geek95dg/Alfa156-headunit/mockups/renders/init_heritage.png

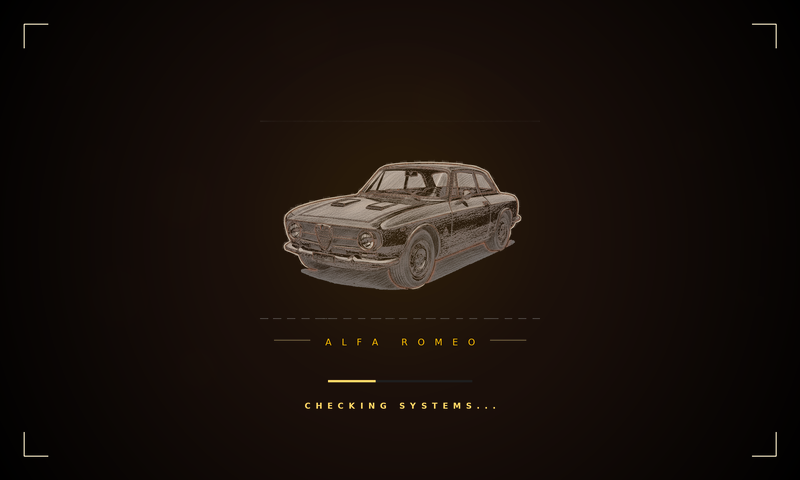
mockups/renders/init_heritage.png
