geek95dg/Alfa156-headunit/mockups/screen.png

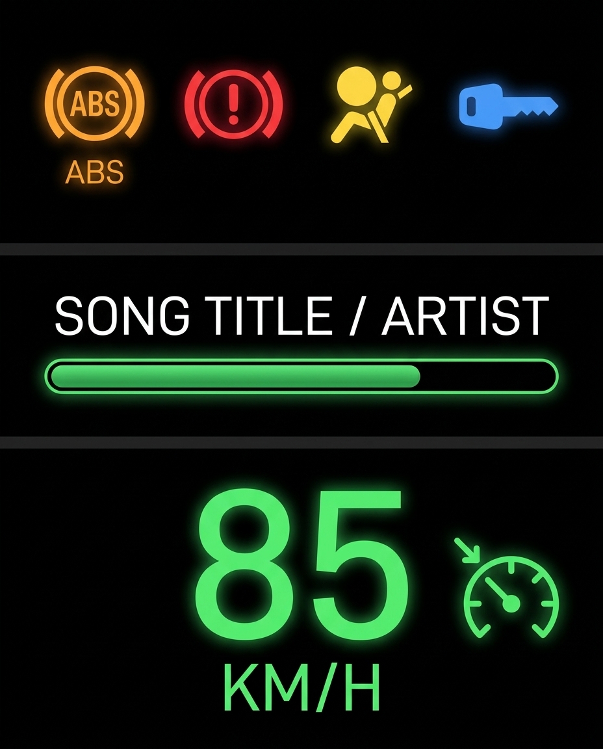
mockups/screen.png
