geek95dg/Alfa156-headunit/docs/WDROZENIE_M910Q.md

# Wdrożenie BCM v8.5 na Lenovo ThinkCentre M910q

Skonsolidowana instrukcja wdrożeniowa head unitu do Alfa Romeo 156 1.9 JTD 8V
na **platformie produkcyjnej x86 — Lenovo ThinkCentre M910q Tiny**.

Dokument opisuje **faktyczny stan repozytorium** — każda komenda, ścieżka
i nazwa pliku odnosi się do tego, co jest w drzewie. Miejsca, w których
dokumentacja źródłowa jest niespójna albo kod odbiega od opisu, są
oznaczone jako ⚠.

**Zasilanie buforowane** (bufor CSB HR1221W, ładowanie, blokada przeładowania,
step-up 19 V) ma osobny dokument: **[`ZASILANIE_BUFOROWANE.md`](ZASILANIE_BUFOROWANE.md)**.

---

## Spis treści

1. [Zakres i warunki wstępne](#1-zakres-i-warunki-wstępne)
2. [Sprzęt](#2-sprzęt)
3. [Zasilanie — streszczenie](#3-zasilanie--streszczenie)
4. [BIOS](#4-bios)
5. [System operacyjny](#5-system-operacyjny)
6. [Instalacja BCM](#6-instalacja-bcm)
7. [Usługi systemd](#7-usługi-systemd)
8. [Boot, splash, kiosk](#8-boot-splash-kiosk)
9. [Suspend i wybudzanie](#9-suspend-i-wybudzanie)
10. [Wyświetlacze i dotyk](#10-wyświetlacze-i-dotyk)
11. [Arduino — trzy płytki](#11-arduino--trzy-płytki)
12. [K-Line / OBD](#12-k-line--obd)
13. [WiFi i Android Auto](#13-wifi-i-android-auto)
14. [Audio](#14-audio)
15. [Konfiguracja modułów](#15-konfiguracja-modułów)
16. [Odbiór techniczny](#16-odbiór-techniczny)
17. [Diagnostyka](#17-diagnostyka)
18. [Reset i ponowna instalacja](#18-reset-i-ponowna-instalacja)
19. [Znane rozbieżności](#19-znane-rozbieżności)
20. [Wyświetlacz pomocniczy 1,8" na ESP32](#20-wyświetlacz-pomocniczy-18-na-esp32)

---

## 1. Zakres i warunki wstępne

### Co ten dokument obejmuje

Pełną ścieżkę od pustego M910q do działającego head unitu w aucie:
sprzęt → zasilanie → BIOS → OS → BCM → usługi → kiosk → peryferia → odbiór.

### Czego nie obejmuje

| Temat | Gdzie szukać |
|---|---|
| Symulacja na laptopie (bez sprzętu) | [`URUCHOMIENIE.md`](URUCHOMIENIE.md) § 1 |
| **Wariant testowo-rozwojowy** (AA + dźwięk + SWC, reszta wyłączona) | [`WDROZENIE_TESTOWE.md`](WDROZENIE_TESTOWE.md) |
| Szczegóły zasilania buforowanego | [`ZASILANIE_BUFOROWANE.md`](ZASILANIE_BUFOROWANE.md) |
| Tabele połączeń, przekroje, kolejność montażu | [`SCHEMATY_POLACZEN.md`](SCHEMATY_POLACZEN.md) |
| Rozmieszczenie podzespołów w aucie | [`../schematics/vehicle_layout_m910q.svg`](../schematics/vehicle_layout_m910q.svg) |
| Pierwsze wgranie firmware na Arduino (od zera) | [`ARDUINO_OD_ZERA.md`](ARDUINO_OD_ZERA.md) |
| Okablowanie Arduino pin-po-pinie | [`ARDUINO_SETUP_GUIDE.md`](ARDUINO_SETUP_GUIDE.md) |
| Podsłuch K-Line, poznawanie PID-ów | [`KLINE_SNIFFING.md`](KLINE_SNIFFING.md) |
| Wersja ilustrowana (12 rozdziałów HTML) | [`x86-production/index.html`](x86-production/index.html) |
| Referencja krok-po-kroku (EN) | [`X86_PLATFORM_SETUP.md`](X86_PLATFORM_SETUP.md) |
| Platformy Orange Pi / VM | [`../Archive/README.md`](../Archive/README.md) |

### Warunki wstępne

- M910q sprawny, z dyskiem NVMe i pamięcią
- Pendrive ≥ 2 GB na obraz instalacyjny Debiana
- Klawiatura i monitor na czas instalacji (potem niepotrzebne)
- Dostęp do sieci (pobieranie pakietów)
- Podstawowe narzędzia elektryczne: multimetr, zaciskarka, lutownica

### Kolejność prac

Zalecana kolejność to **najpierw komplet software'u na biurku**, dopiero
potem zabudowa w aucie. Diagnostyka układu, który leży na stole, jest
nieporównanie łatwiejsza niż tego samego układu wciśniętego za deskę
rozdzielczą.

```
1. Sprzęt + BIOS + OS + BCM na biurku              (§2, §4–§7)
2. Wyświetlacze, dotyk, kiosk, splash              (§8, §10)
3. Arduino + K-Line + audio na stole               (§11, §12, §14)
4. Testy zasilania buforowanego na stole           (ZASILANIE_BUFOROWANE.md §11)
5. Zabudowa w aucie                                (ZASILANIE_BUFOROWANE.md §11 etap 3+)
6. Odbiór techniczny                               (§16)
```

---

## 2. Sprzęt

### 2.1 Lenovo ThinkCentre M910q Tiny

| Element | Specyfikacja |
|---|---|
| CPU | Intel i5-6400T (4C/4T, 2,2–2,8 GHz, Skylake) |
| GPU | Intel HD 530 — sprzętowe dekodowanie VAAPI |
| RAM | 8 GB DDR4 2400 |
| Dysk | 256 GB NVMe SSD |
| WiFi/BT | **MediaTek MT7921** (M.2 Key E) — wymiana za fabryczny Intel 8265 |
| Wyjścia obrazu | **2× DisplayPort** |
| USB | 6× USB 3.0 + 1× USB-C |
| Zasilanie | 65 W, 20 V, gniazdo firmowe Lenovo |
| Obudowa | 1 litr — mieści się za deską rozdzielczą |

**Wymiana karty WiFi jest obowiązkowa.** Fabryczny Intel 8265 nie daje
stabilnego P2P-GO na 5 GHz i cierpi na resety tx-timeout przy Bluetooth.
MT7921 (PCIe `[14c3:7961]` + BT po USB `[0489:e0cd]`) obsługuje P2P-GO na
kanale 149, 80 MHz VHT, 30 dBm oraz A2DP i HFP bez problemów. Wymaga pakietu
`firmware-mediatek` z sekcji non-free-firmware.

**Orientacja montażu:** poziomo, logo do góry. Pionowo działa, ale nieco
gorzej chłodzi. M910q ma otwory VESA 100 na spodzie — najprościej zrobić
wspornik. Wszystkie kable spinaj opaskami, bo na dziurach będzie grzechotać.

### 2.2 Lista sprzętu — etap 1 (rdzeń)

| # | Element | Model / spec | Szt. | Cena (PLN) |
|---|---|---|---|---|
| 1 | Mini-PC | Lenovo M910q Tiny (i5-6400T, 8 GB, 256 GB) — używany | 1 | 200–400 |
| 2 | Karta WiFi + BT | Fenvi FU-AX1800 (MT7921, WiFi 6 + BT 5.2) | 1 | 120–180 |
| 3 | Przetwornica step-up | **XL6019** 12 V → 19,5 V — posiadana, ok. 45 W, patrz `ZASILANIE_BUFOROWANE.md` §3 | 1 | 15–30 |
| 4 | Wyświetlacz główny | **10,1" IPS 1280×800** + dotyk USB | 1 | 300–500 |
| 5 | Wyświetlacz drugi *(opcjonalny)* | **6,86" widescreen 1280×480**, bez dotyku | 0–1 | 150–300 |
| 6 | Przejściówki DP → HDMI | pasywne, kablowe | 2 | 20–30 |
| 7 | DAC USB | ES9038Q2M, wyjście RCA | 1 | 45–75 |
| 8 | Wzmacniacz | **gotowy 4-kanałowy samochodowy**, wejścia RCA, klasa D, 4 × 50–75 W RMS | 1 | 250–600 |
| 9 | Kabel zasilający wzmacniacza | 6 mm² + oprawka bezpiecznika przy klemie | kpl. | 40–80 |
| 10 | Interfejs K-Line | CP2102 (USB-UART) + L9637D + rezystor 510 Ω | 1 | 25–40 |
| 11 | Hub USB | 7-portowy USB 3.0 **z własnym zasilaniem** | 1 | 40–60 |
| 12 | Kable | 2× DP-HDMI, USB-A, zasilanie, RCA | — | 50–80 |

Etapy 2–4 (kamery, czujniki, wejścia, subwoofer, czujnik deszczu) są
w [`x86-production/01-bom.html`](x86-production/01-bom.html).

**Zasilanie buforowane ma osobną listę zakupową** —
[`ZASILANIE_BUFOROWANE.md`](ZASILANIE_BUFOROWANE.md) §10.

### 2.3 Rozmieszczenie USB

Dwa urządzenia idą **bezpośrednio w port M910q**, reszta przez hub:

```
Porty USB M910q
  ├── Hub USB (zasilany, 7 portów)
  │     ├── Arduino Pro Micro   (wejścia: SWC, przyciski, enkoder)
  │     ├── Arduino Nano #1     (wyjścia: przekaźniki, PWM podświetlenia)
  │     ├── Arduino Nano #2     (sensor hub: drzwi, zapłon, deszcz, DS18B20)
  │     ├── CP2102              (K-Line / OBD)
  │     ├── GPS NEO-M8N
  │     ├── Modem LTE Huawei E3372
  │     └── Mikrofon USB
  ├── DAC USB (ES9038Q2M)       ← bezpośrednio, nie przez hub
  └── Graber AHD 4-kanałowy     ← bezpośrednio, nie przez hub
```

**Dlaczego bezpośrednio:** DAC to urządzenie USB Audio Class 2 — hub dokłada
opóźnienie i rywalizację o pasmo. Graber przesyła cztery strumienie 720p
jednocześnie; na hubie zaczyna gubić klatki.

---

## 3. Zasilanie — streszczenie

Pełny opis: **[`ZASILANIE_BUFOROWANE.md`](ZASILANIE_BUFOROWANE.md)**.
Tutaj tylko to, co trzeba wiedzieć, żeby zrozumieć resztę wdrożenia.

Tor zasilania

**Wszystko wisi na jednej szynie buforowanej.** Zapłon nie odcina żadnego
odbiornika — jest sygnałem, który Arduino zamienia na impuls na styki
**przycisku zasilania M910q**:

| Stan | Pobór z banku | Postój (7 pakietów, 35,7 Ah) |
|---|---|---|
| Praca | 10–55 W (3,5 A z banku) | ~5,1 h przy zgaszonym silniku |
| **S3** (kluczyk OFF) | 200–460 mA | ~1,6–3,7 dnia |
| **Wyłączony** (impuls 5 s po 2 h) | 50–150 mA | ~5,0–14,9 dnia |

Jedyny przekaźnik w torze mocy siedzi w **ładowaniu**, nie w odbiornikach.
Uzasadnienie i porównanie z porzuconym modelem „domena B":
[`ZASILANIE_BUFOROWANE.md`](ZASILANIE_BUFOROWANE.md) §2.2.

Między akumulatorem auta a head unitem stoi **bank 7 × CSB HR1221W F2**
(12 V / 5,1 Ah AGM, łączone równolegle — razem **35,7 Ah** przy niezmienionym
napięciu 12 V, masa 12,6 kg), ładowany przez ładowarkę CC-CV z profilem
**AGM** (14,40 V absorpcji / 13,65 V float, **nastawa CC 8,0 A** przy suficie
katalogowym 14,7 A — ogranicza tor ładowania, nie akumulator),
chroniony rozłącznikiem nadnapięciowym (15,3 V) i modułem **XH-M609** jako
LVD (11,0 / 12,60 V). M910q zasila **przetwornica step-up XL6019**
(12 → 19,5 V) za przekaźnikiem zapłonu.

**Konsekwencje dla software'u:**

- BCM **nie startuje z bootu** — startuje go `bcm-ignition-watcher`
  w reakcji na sygnał zapłonu z Arduino (§7),
- BIOS musi mieć **After Power Loss = Power On** (§4), inaczej maszyna nie
  wstanie po zaniku zasilania,
- przycisk zasilania jest przechwycony przez `acpid` i wykonuje czysty
  suspend do S3 (§9), a nie shutdown,
- ⚠ **XL6019 daje ok. 45 W, nie 65 W** (limit prądu klucza 5 A), więc na
  M910q trzeba ustawić limit poboru pakietu CPU — patrz
  [`ZASILANIE_BUFOROWANE.md`](ZASILANIE_BUFOROWANE.md) §3.5a. Bez tego pełne
  obciążenie czterech wątków wyjdzie poza możliwości przetwornicy.

---

## 4. BIOS

Wejście: **F1** przy starcie.

| Ustawienie | Ścieżka | Wartość | Po co |
|---|---|---|---|
| **After Power Loss** | Power | **Power On** | maszyna wstaje sama po zaniku zasilania (zapad przy rozruchu, powrót po LVD) |
| **Fast Boot** | Startup | Enabled | skraca POST |
| **Secure Boot** | Security | Disabled | wymagane przez kernel i sterowniki |
| **USB Legacy** | USB Setup | Disabled | skraca POST |
| **Wake on USB** | Power | Enabled *(opcjonalne)* | wygodne, ale niekonieczne — wybudza impuls Arduina na przycisk zasilania |

> ⚠ **After Power Loss = Power On to ustawienie krytyczne.** Przy „Last
> State" albo „Power Off" M910q nie wstanie po chwilowym zaniku napięcia
> na przetwornicy — a to zdarzy się przy pierwszym mocniejszym zapadzie.

Sprawdź też, czy BIOS ma włączone **S3 (nie Modern Standby / S0ix)** —
weryfikacja w §9.

---

## 5. System operacyjny

### 5.1 Instalacja Debiana 13 (Trixie)

Obraz **netinst amd64**, wgrany na pendrive.

Podczas instalacji:

- instalacja **minimalna** — tylko `SSH server` i `standard system utilities`,
- **bez** środowiska graficznego (X i kiosk instalujemy sami),
- włączone repozytorium **non-free-firmware** (potrzebne dla MT7921).

### 5.2 Po instalacji

```bash
# sudo dla użytkownika
su -
apt install -y sudo
usermod -aG sudo abner
exit
# wyloguj się i zaloguj ponownie

# non-free-firmware (Trixie może mieć już włączone)
sudo sed -i 's/main$/main non-free-firmware/' /etc/apt/sources.list
sudo apt update
```

### 5.3 Pakiety systemowe

```bash
sudo apt update && sudo apt upgrade -y

# rdzeń
sudo apt install -y \
    python3 python3-venv python3-full python3-dev python3-serial \
    git curl wget

# X + kiosk (w Debianie 13 pakiet nazywa się "chromium")
sudo apt install -y \
    xserver-xorg xinit x11-xserver-utils \
    unclutter chromium

# GPU Intel — sprzętowe dekodowanie wideo
sudo apt install -y intel-media-va-driver vainfo libva-drm2

# audio
sudo apt install -y pipewire pipewire-pulse wireplumber alsa-utils mpv

# WiFi + Bluetooth MediaTek MT7921
sudo apt install -y \
    firmware-mediatek bluez bluez-tools network-manager hostapd dnsmasq

# wideo / kamery
sudo apt install -y ffmpeg v4l-utils

# zarządzanie zasilaniem
sudo apt install -y acpid

# zram zamiast swapa na NVMe
sudo apt install -y zram-tools
echo -e 'ALGO=lz4\nPERCENT=50' | sudo tee /etc/default/zramswap
sudo systemctl enable zramswap

sudo reboot
```

Po restarcie weryfikacja sprzętowego dekodowania:

```bash
vainfo    # musi wypisać wpisy VAProfileH264
```

---

## 6. Instalacja BCM

### 6.1 Klon i środowisko

```bash
cd /opt
sudo git clone https://github.com/geek95dg/Alfa156-headunit.git bcm
sudo chown -R $USER:$USER /opt/bcm
cd /opt/bcm

# Debian 13 egzekwuje PEP 668 — venv jest obowiązkowy
python3 -m venv .venv
source .venv/bin/activate
pip install -r requirements.txt
pip install -r requirements-x86.txt
```

### 6.2 Uprawnienia

```bash
sudo usermod -aG dialout $USER    # porty szeregowe Arduino
# wyloguj się i zaloguj ponownie
```

### 6.3 Rozdzielczość wyświetlacza

W `config/bcm_config.yaml`:

```yaml
display:
  dashboard:
    width: 1024       # 7"; dla 10" → 1280
    height: 600       # 7"; dla 10" → 800
```

### 6.4 Test ręczny

```bash
source /opt/bcm/.venv/bin/activate
cd /opt/bcm
python3 main.py --platform x86 --config config/bcm_config.yaml --frontend
```

Otwórz `http://localhost:5002` — musi pojawić się dashboard. To jest brama:
jeśli tu nie działa, nie ma sensu iść dalej.

### 6.5 Skrót — skrypt all-in-one

Zamiast §7–§13 można uruchomić skrypt, który robi to wszystko naraz:

```bash
cd /opt/bcm
sudo bash config/scripts/setup-x86.sh
```

Skrypt jest **idempotentny** — można go puszczać wielokrotnie.

> ⚠ **Najpierw zedytuj sekcję USER CONFIG na górze skryptu**
> (`config/scripts/setup-x86.sh`, linie 15–45). Domyślne wartości to
> `MAIN_OUTPUT="HDMI-1"` i `SMALL_OUTPUT="HDMI-2"`, a **M910q ma dwa
> wyjścia DisplayPort** — u Ciebie złącza najprawdopodobniej nazywają się
> `DP-1` i `DP-2`. Sprawdź faktyczne nazwy:
>
> ```bash
> for f in /sys/class/drm/card*-*/status; do echo "$f: $(cat $f)"; done
> ```
>
> Do sprawdzenia i ewentualnej zmiany są też: `BCM_USER`, `TOUCH_DEVICE`,
> `MAIN_W`/`MAIN_H`, `WIFI_IFACE`, `WIFI_SSID`, `WIFI_PASS`.

Jeżeli używasz skryptu, przejdź od razu do §16 (odbiór techniczny).
Poniższe sekcje opisują to, co skrypt robi — przydają się przy diagnostyce.

---

## 7. Usługi systemd

### 7.1 Instalacja

```bash
cd /opt/bcm

sudo cp config/systemd/bcm-headunit-x86.service /etc/systemd/system/bcm-headunit.service
sudo cp config/systemd/bcm-ignition-watcher.service /etc/systemd/system/
sudo cp config/systemd/bcm-splash-main.service      /etc/systemd/system/
sudo cp config/systemd/bcm-splash-small.service     /etc/systemd/system/
sudo cp config/systemd/bcm-resume.service           /etc/systemd/system/

sudo systemctl mask bcm-kiosk.service    # kiosk startuje z xinitrc, nie z systemd
sudo systemctl daemon-reload
sudo systemctl enable bcm-ignition-watcher bcm-splash-main bcm-splash-small bcm-resume
```

> **Zwróć uwagę na pierwszą linię.** Plik źródłowy nazywa się
> `bcm-headunit-x86.service`, a instaluje się go **pod nazwą**
> `bcm-headunit.service`. Reszta jednostek odwołuje się do tej drugiej nazwy.

### 7.2 Cykl życia — to jest nieoczywiste

| Jednostka | `enable`? | Kto ją uruchamia |
|---|---|---|
| `bcm-ignition-watcher` | **tak** | systemd przy boocie |
| `bcm-splash-main` | tak | systemd przy boocie |
| `bcm-splash-small` | tak | systemd przy boocie |
| `bcm-resume` | tak | systemd po wyjściu z S3 |
| `bcm-headunit` | **NIE** | `bcm-ignition-watcher` w reakcji na zapłon |
| `bcm-kiosk` | **zamaskowana** | `~/.xinitrc` |

`bcm-headunit.service` ma `PartOf=bcm-ignition-watcher.service` — zatrzymuje
się razem z watcherem. Ma też `Restart=on-failure` (RestartSec=3, limit
4 restartów / 120 s), więc po crashu wstaje sam, ale czyste `systemctl stop`
od watchera go nie wskrzesza. Watcher ma dodatkowo cykliczny **liveness
check** — druga warstwa zabezpieczenia.

**Konsekwencja praktyczna:** jeśli BCM nie wstaje po boocie, sprawdzaj
**watcher**, nie `bcm-headunit`:

```bash
systemctl status bcm-ignition-watcher
journalctl -u bcm-ignition-watcher -n 50
```

### 7.3 Przycisk zasilania → suspend

```bash
sudo mkdir -p /etc/acpi/events
sudo tee /etc/acpi/events/power-button >/dev/null <<'EOF'
event=button/power
action=/usr/local/bin/bcm-power-toggle.sh
EOF
sudo cp /opt/bcm/config/scripts/bcm-power-toggle.sh /usr/local/bin/
sudo chmod +x /usr/local/bin/bcm-power-toggle.sh
sudo systemctl enable acpid
```

Dodatkowo `logind` musi przestać obsługiwać przycisk sam:

```bash
# /etc/systemd/logind.conf
[Login]
HandlePowerKey=ignore
```

### 7.4 Test bez restartu

```bash
sudo systemctl start bcm-ignition-watcher
sudo journalctl -fu bcm-ignition-watcher -u bcm-headunit
# oczekiwane: AUTOSTART → BCM started

curl http://localhost:5002    # musi zwrócić HTML
```

---

## 8. Boot, splash, kiosk

Cel: od wciśnięcia przycisku do dashboardu **bez ani jednej linijki
komunikatów kernela**. Czarny ekran → splash → dashboard.

### 8.1 GRUB — cichy i ukryty

```bash
sudo cp /etc/default/grub /etc/default/grub.bak
sudo tee /etc/default/grub >/dev/null <<'EOF'
GRUB_DEFAULT=0
GRUB_TIMEOUT=0
GRUB_HIDDEN_TIMEOUT=0
GRUB_HIDDEN_TIMEOUT_QUIET=true
GRUB_DISTRIBUTOR=""
GRUB_CMDLINE_LINUX_DEFAULT="quiet loglevel=0 vt.global_cursor_default=0 rd.systemd.show_status=false rd.udev.log_level=3 fsck.repair=yes console=tty2"
GRUB_CMDLINE_LINUX=""
GRUB_DISABLE_OS_PROBER=true
EOF
sudo update-grub
```

> **`fsck.repair=yes`, nigdy `fsck.mode=skip`:** bez zasilania buforowanego
> każde zgaszenie silnika to twarde odcięcie prądu. Pominięty fsck pozwala
> uszkodzeniom ext4 narastać, aż system przestanie wstawać; czysty dysk
> sprawdza się w ułamku sekundy (to samo ustawia `setup-x86.sh` i
> `bcm-harden.sh`).

> **Nie dodawaj `splash`** do linii kernela — to włącza Plymouth, który
> gryzie się z odtwarzaniem wideo przez DRM.

```bash
sudo apt remove -y plymouth plymouth-themes 2>/dev/null
sudo update-initramfs -u
```

### 8.2 Pliki splash

```bash
mkdir -p /opt/bcm/assets/splash

# główny — dopasuj do rozdzielczości wyświetlacza
#  7":  ffmpeg -i source.mp4 -vf scale=1024:600 -c:v libx264 -crf 23 -c:a aac -y main.mp4
# 10":  ffmpeg -i source.mp4 -vf scale=1280:800 -c:v libx264 -crf 23 -c:a aac -y main.mp4
cp twoj_splash.mp4 /opt/bcm/assets/splash/main.mp4

# drugi ekran — bez dźwięku, 1280×480
# ffmpeg -i source.mp4 -vf scale=800:480 -an -c:v libx264 -crf 23 -y small.mp4
cp twoj_splash_maly.mp4 /opt/bcm/assets/splash/small.mp4
```

Materiały brandingowe **nie są w repozytorium** — patrz
[`../assets/splash/README.md`](../assets/splash/README.md).

### 8.3 Test splash

```bash
sudo chvt 2
sudo pkill Xorg 2>/dev/null

for f in /sys/class/drm/card*-*/status; do echo "$f: $(cat $f)"; done

sudo mpv --fs --vo=drm --hwdec=auto /opt/bcm/assets/splash/main.mp4
sudo mpv --fs --vo=drm --drm-connector=DP-2 --no-audio --hwdec=auto \
    /opt/bcm/assets/splash/small.mp4
```

Jeśli mały wyświetlacz siedzi na innym złączu, nadpisz to w jednostce:

```bash
sudo systemctl edit bcm-splash-small.service
# [Service]
# Environment=BCM_SPLASH_DRM_SMALL=NazwaTwojegoZlacza
```

> `bcm-splash-play.sh` **wykrywa aktywne złącze automatycznie** — starsze
> wersje miały wpisane na sztywno `HDMI-A-1`, które na M910q jest
> rozłączone (panel siedzi na `HDMI-A-2`/DP). Nie wracaj do sztywnych nazw.

### 8.4 Autologin i start X

```bash
# start X bez roota
sudo dpkg-reconfigure xserver-xorg-legacy    # → Anybody

# autologin na tty1
sudo systemctl edit getty@tty1.service
# [Service]
# ExecStart=
# ExecStart=-/sbin/agetty --autologin abner --noclear %I $TERM

# start X tylko na tty1 — w ~/.bash_profile:
# if [ -z "$DISPLAY" ] && [ "$(tty)" = "/dev/tty1" ]; then exec startx; fi

cp /opt/bcm/config/scripts/xinitrc-x86-dual ~/.xinitrc
```

W `~/.xinitrc` na górze są zmienne `MAIN_OUTPUT` / `SMALL_OUTPUT` — ustaw
faktyczne nazwy złączy. Wariant jednoekranowy:
`config/scripts/xinitrc-x86-single`.

---

## 9. Suspend i wybudzanie

### 9.1 Weryfikacja S3

```bash
cat /sys/power/mem_sleep
# oczekiwane:  s2idle [deep]
```

Jeśli wynik to `[s2idle] deep` albo samo `[s2idle]`, wymuś deep sleep:

```bash
sudo nano /etc/default/grub
# do GRUB_CMDLINE_LINUX_DEFAULT dopisz:  mem_sleep_default=deep
sudo update-grub && sudo reboot
```

Jeśli po tym dalej nie ma `deep` — w BIOS-ie włączony jest Modern Standby
(S0ix). Przełącz na S3.

### 9.2 Co robi `bcm-power-toggle.sh`

1. `systemctl stop bcm-headunit` — czyste zamknięcie Flaska, kamer, audio
2. wyłączenie wszystkich źródeł wybudzania po USB
3. **odpięcie modemu Huawei E3372 od sterownika** — modem HiLink blokuje
   wejście w S3 na wielu systemach
4. wyłączenie wybudzania z XHCI i PS2K
5. `systemctl suspend`

### 9.3 Co robi `bcm-resume.service`

1. `sleep 2` — czas na re-enumerację USB
2. przepięcie root hubów USB (modem LTE wraca do życia)
3. `systemctl start bcm-headunit`

### 9.4 Test

```bash
# przycisk zasilania → maszyna wchodzi w S3
# przycisk ponownie → wybudzenie w ~3 s, nie 40 s zimnego startu
journalctl -b -u bcm-resume
```

---

## 10. Wyświetlacze i dotyk

**Sprawdź, jakie wyjścia ma Twoja sztuka** — M910q występuje w wersjach
z DisplayPort i z HDMI, a na maszynie referencyjnej złącza enumerują się
jako `HDMI-A-1` / `HDMI-A-2` (§19.1). Jeżeli wyjścia są DisplayPort,
a wyświetlacz ma HDMI, potrzebne są **pasywne przejściówki DP → HDMI**
(~10–15 PLN/szt.).

| Wyjście | Wyświetlacz | Rozdzielczość | Zawartość | Port |
|---|---|---|---|---|
| główne | **10,1" IPS dotykowy** | **1280×800** | dashboard BCM (A1–A8 + Settings) | 5002 |
| drugie | **6,86" widescreen** *(opcjonalne)* | **1280×480** | karuzela statystyk + kamera cofania | 5003 |

Wartości pochodzą z `display.dashboard` i `display.small` w
`config/bcm_config.yaml` — to one są źródłem prawdy, a nie ten opis.

> **Drugi ekran jest opcjonalny i obsługuje hotplug.** `small-display-watch.sh`
> (uruchamiany z wygenerowanego `~/.xinitrc`) podnosi i zdejmuje okno
> Chromium, gdy panel zostanie wpięty lub wypięty po starcie systemu.
> Nie musi być podłączony przy boocie.

Wykrycie nazw złączy:

```bash
for f in /sys/class/drm/card*-*/status; do echo "$f: $(cat $f)"; done
```

Dotyk musi być przypisany **tylko do ekranu głównego**, inaczej kursor
będzie chodził po obu. W `~/.xinitrc`:

```bash
xinput map-to-output "QDtech MPI5001" DP-1
```

Nazwę urządzenia dotykowego sprawdzisz przez `xinput list`.

---

## 11. Arduino — trzy płytki

Na M910q **nie ma GPIO** — całe I/O pojazdu idzie przez Arduino po USB.
Komunikat o braku `gpiod` przy starcie jest normalny i można go zignorować.

| Sketch | Płytka | Domena | Rola |
|---|---|---|---|
| `arduino/rotary_encoder` | **Pro Micro** (ATmega32U4, USB HID) | B | Enkoder, przyciski, SWC, panel muzyczny, jasność |
| `arduino/output_controller` | **Nano #1** | **A** | Pilot szyb 433 MHz, bagażnik bramkowany BLE (HM-10), PWM podświetlenia |
| `arduino/sensor_hub` | **Nano #2** | A | Drzwi, maska, klapa, ręczny, zapłon, deszcz, DS18B20 |

### 11.1 Kompilacja i wgrywanie

```bash
# jednorazowo
curl -fsSL https://raw.githubusercontent.com/arduino/arduino-cli/master/install.sh | sh
arduino-cli core update-index && arduino-cli core install arduino:avr

# kompilacja wszystkich trzech
make -C arduino

# wgrywanie — podaj właściwy port
make -C arduino rotary_encoder-upload    PORT=/dev/ttyACM0   # Pro Micro
make -C arduino output_controller-upload PORT=/dev/ttyUSB0   # Nano #1
make -C arduino sensor_hub-upload        PORT=/dev/ttyUSB1   # Nano #2
```

Profile w `sketch.yaml` przypinają wersje core'a i bibliotek, więc
`arduino-cli` pobiera dokładnie to, czego potrzeba.

### 11.2 Przełączniki funkcji w `sensor_hub`

Na górze `sensor_hub.ino` każda grupa wejść ma `#define FEATURE_*`:

- domyślnie włączone: `FEATURE_DOORS`, `FEATURE_HBRAKE`, `FEATURE_IGN`,
  `FEATURE_RAIN`, `FEATURE_TEMP`
- domyślnie wyłączone: `FEATURE_PARK`, `FEATURE_CRUISE`, `FEATURE_IMMO`,
  `FEATURE_AIRBAG`

Zakomentowanie `#define` usuwa funkcję z firmware i zwalnia pin. Po zmianie
wgraj sketch ponownie.

### 11.3 Uwaga do wersji 8.5.2

Przycisk enkodera przeniesiony z **D4 na D1** — na Pro Micro D4 i A6 to ten
sam fizyczny pin i kolidowało z SWC Pod 2. Przy starszym okablowaniu przepnij
jeden przewód. Wszystkie trzy sketche mają teraz 2-sekundowy watchdog
sprzętowy.

### 11.4 Szybki test

```bash
picocom -b 115200 /dev/ttyUSB1
# oczekiwane linie: DOOR:..., IGN:0, TEMP:21.4
```

Okablowanie pin-po-pinie: [`ARDUINO_SETUP_GUIDE.md`](ARDUINO_SETUP_GUIDE.md)
§7 (Nano always-on) i §7b (sensor hub).

> **Czwarta płytka — opcjonalna.** Wyświetlacz pomocniczy 1,8" ma własny
> ESP32-S3 (`arduino/esp32_display`), też wgrywany przez `make -C arduino`,
> ale z rdzeniem `esp32:esp32` i po natywnym USB. Cała procedura: §20.

---

## 12. K-Line / OBD

Tor na M910q: **USB → CP2102 (USB-UART) → L9637D (transceiver) → pin 7
złącza OBD-II**. Rezystor podciągający 510 Ω z linii K do 12 V.

Domyślnie x86 pracuje na **symulatorze ECU** — wygodne przy testach na stole.
Żeby czytać z prawdziwego auta, w `config/bcm_config.yaml`:

```yaml
obd:
  use_real_hardware: true
  fast_init: false
serial:
  kline:
    port_x86: /dev/ttyUSB_kline    # CP2102 + reguła udev
```

Reguła udev jest konieczna — bez niej numeracja `/dev/ttyUSBn` przeskakuje
między restartami i K-Line trafia na port Arduino.

Poznawanie PID-ów (obroty, temperatury) i pełna procedura podsłuchu:
[`KLINE_SNIFFING.md`](KLINE_SNIFFING.md) + `tools/kline_sniffer.py`.

ECU w Alfa 156 1.9 JTD 8V: **Bosch EDC15C7**, protokół KWP2000
(`src/obd/edc15c7.py`, `src/obd/kwp2000.py`).

---

## 13. WiFi i Android Auto

### 13.1 Dwie niezależne funkcje WiFi

| Moduł | Do czego | Domyślnie |
|---|---|---|
| `wifi_ap` | **tylko** Android Auto wireless (Wi-Fi Direct / P2P-GO na karcie wewnętrznej) | włączony |
| `wifi_hotspot` | dodatkowy AP **ALFA-NET** do współdzielenia internetu z LTE | wyłączony |

Karta wewnętrzna **nie zrobi P2P-GO i AP jednocześnie** — MT7921 zgłasza
`#{AP, P2P-GO} <= 1`. `wifi_hotspot` wymaga więc **osobnego dongla USB WiFi**
(RTL8812BU). Włączaj go dopiero po podpięciu dongla.

### 13.2 Test P2P-GO

```bash
# sprawdź, że załadował się właściwy sterownik
lspci -k | grep -A3 -i network      # oczekiwane: mt7921e
iw list | grep -A10 "valid interface combinations"
```

Domyślny tryb to `wpa_supplicant` P2P-GO sterowany z `src/multimedia/wifi_ap.py`
— systemowy `hostapd` zostaje wyłączony, żeby proces Pythona miał radio na
wyłączność. Fallback na `hostapd` jest utrzymany dla starszych wdrożeń
(`wifi.mode: hostapd` w YAML).

### 13.3 Android Auto

`openauto` kompiluje się ze źródeł — procedura (aasdk, h264bitstream,
openauto, łatki na OpenSSL 3.0 i librtaudio 6.x) jest w
[`X86_PLATFORM_SETUP.md`](X86_PLATFORM_SETUP.md) §11 oraz
[`x86-production/11-android-auto.html`](x86-production/11-android-auto.html).

Weryfikacja po kompilacji:

```bash
ls -la /usr/local/bin/autoapp     # ~5 MB
sudo systemctl restart bcm-headunit
journalctl -u bcm-headunit | grep -i openauto
# oczekiwane: "OpenAuto found: /usr/local/bin/autoapp"
```

---

## 14. Audio

Tor: **ES9038Q2M (DAC USB) → RCA → gotowy wzmacniacz samochodowy →
głośniki 4 Ω**. Schemat: [`../schematics/audio_system.svg`](../schematics/audio_system.svg).

> **DAC USB nie jest warunkiem uruchomienia.** `src/audio/pipewire_ctrl.py`
> na x86 używa **domyślnego sinka PipeWire**, więc wbudowane wyjście analogowe
> M910q (mini-jack) działa bez zmian w kodzie — `wpctl set-default <ID>`
> i tyle. DAC to podniesienie jakości, nie wymóg. Wariant na samym mini-jacku:
> [`WDROZENIE_TESTOWE.md`](WDROZENIE_TESTOWE.md).

Wzmacniacz to **kupiony moduł samochodowy**, nie układ DIY: 4 kanały,
wejścia RCA, klasa D, 4 × 50–75 W RMS na 4 Ω. Podłączany jak radio —
zasilanie wprost z akumulatora rozruchowego, własna masa, wyzwalanie REM.

Software: PipeWire + WirePlumber, 10-pasmowy EQ, analizator widma, ducking
(`src/audio/`). Profil EQ: `config/pipewire/eq-profile.json`.

Bluetooth: profil HFP przez oFono (`config/systemd/ofono.service.d/`,
`config/wireplumber/wireplumber.conf.d/51-bcm-hfp-ofono.conf`), z wymuszeniem
BR/EDR (`config/scripts/bt-prefer-bredr.sh`) — BLE-only powodowało problemy
z parowaniem telefonów.

> **Zasilanie wzmacniacza idzie osobną gałęzią** prosto z akumulatora
> rozruchowego (bezpiecznik wg karty modułu, zwykle 20–30 A), **nie z banku
> buforowego** — patrz [`ZASILANIE_BUFOROWANE.md`](ZASILANIE_BUFOROWANE.md) §2.
> Szczyty 20–30 A przekroczyłyby przekaźnik LVD (20 A) — i to jest argument
> rozstrzygający, bo nie zależy od pojemności banku.

Z systemem buforowanym łączy wzmacniacz wyłącznie **sygnał REM z zacisku 87
i ekran kabla RCA**. Masę prowadź lokalnie, przy wzmacniaczu — wspólna masa
z komputerem daje pętlę i przydźwięk alternatora.

Kabel RCA prowadź **po przeciwnej stronie auta niż kabel zasilania**.
Kolejność diagnozy przy buczeniu i procedura ustawiania wzmocnienia:
[`SCHEMATY_POLACZEN.md`](SCHEMATY_POLACZEN.md) §5.4.

---

## 15. Konfiguracja modułów

Jedno źródło prawdy: `src/core/modules_catalog.py`. Każdy moduł włącza się
na dwa sposoby:

- **UI:** Settings → Moduły (endpoint `/api/modules`)
- **YAML:** `modules.<nazwa>` w `config/bcm_config.yaml`

**Zmiany wymagają restartu BCM.** Pełna tabela 28 przełączników jest
w [`URUCHOMIENIE.md`](URUCHOMIENIE.md) §5.

Honorowane są też starsze klucze (`bluetooth.enabled`, `wifi.enabled`,
`fuel_sender.enabled`, blok `modules_v85.*`), ale `modules.<nazwa>` ma
zawsze pierwszeństwo.

### Moduły wymagające dodatkowej konfiguracji

| Moduł | Co trzeba |
|---|---|
| `obd` | `use_real_hardware: true` + reguła udev (§12) |
| `esp32_display` | płytka ESP32-S3 na USB + reguła udev (§20) |
| `wifi_hotspot` | osobny dongiel USB WiFi (§13.1) |
| `weather` | klucz API OpenWeatherMap |
| `route_planner` | klucze OpenRouteService / TomTom |
| `network` | na x86 **tylko raportuje** stan łącza — połączenie robi NetworkManager; `config/lte.conf` dotyczy wariantu ARM |
| `battery` | sensor hub z `SENSOR_HUB_FEATURES=BATT_ADC` albo `BATT_INA226` (dzielnik na A6 / INA226) — §19.3 |

---

## 16. Odbiór techniczny

Checklista końcowa. Wszystko musi przejść przed uznaniem wdrożenia
za zakończone.

### 16.1 Software

```
[ ] curl http://localhost:5002 zwraca HTML
[ ] Wyświetlacz główny (DP-1) pokazuje dashboard BCM
[ ] Wyświetlacz mały (DP-2) pokazuje ekran statystyk
[ ] Ekrany są niezależne, nie rozciągnięte jako jeden pulpit
[ ] Dotyk działa i tylko na ekranie głównym
[ ] Splash odtwarza się na obu ekranach przy zimnym starcie
[ ] Splash znika w momencie pojawienia się dashboardu
[ ] Podczas bootu nie ma ANI JEDNEJ linii komunikatów kernela
[ ] Przycisk zasilania → S3; ponowne wciśnięcie → wybudzenie w ~3 s
[ ] Audio wychodzi przez DAC USB na głośniki
[ ] Telefon widzi sieć ALFA_AA i dostaje adres IP
[ ] Android Auto łączy się (jeśli openauto skompilowany)
```

### 16.2 Peryferia

```
[ ] Wszystkie trzy Arduino widoczne jako osobne /dev/tty*
[ ] picocom na sensor hubie pokazuje DOOR / IGN / TEMP
[ ] SWC z kierownicy steruje głośnością i utworami
[ ] Enkoder i przyciski panelu działają
[ ] Kamera cofania włącza się na wstecznym biegu
[ ] Kierunkowskazy przełączają kamery boczne
[ ] Czujniki parkowania mierzą i buzzer reaguje
[ ] K-Line czyta obroty i temperatury z ECU (jeśli use_real_hardware)
```

### 16.3 Zasilanie i integracja z autem

```
[ ] Rozruch silnika przy działającym BCM — komputer NIE resetuje się
[ ] Wyłączenie zapłonu → impuls z Arduino, M910q schodzi do S3 (200–460 mA)
[ ] Domena A dalej działa — pilot 433 MHz i BLE bagażnika odpowiadają
[ ] Prąd spoczynkowy logiki ~60 mA
[ ] Prąd na wyjściu ładowarki ≤ 8 A, do szyny banku ~4,5 A (silnik pracuje)
[ ] Napięcie banku nie przekracza 14,40 V (wg kompensacji temperaturowej)
[ ] Po 48 h postoju auto normalnie odpala
[ ] BCM wstaje automatycznie po włączeniu zapłonu
```

Pełna procedura pomiarowa dla zasilania:
[`ZASILANIE_BUFOROWANE.md`](ZASILANIE_BUFOROWANE.md) §11.

---

## 17. Diagnostyka

### Logi

```bash
tail -f /opt/bcm/logs/bcm.log              # log aplikacji (system.log_file w YAML)
journalctl -u bcm-headunit -n 50           # usługa BCM
journalctl -u bcm-ignition-watcher -n 50   # watcher zapłonu
journalctl -b -u bcm-resume                # wyjście z S3
```

### Najczęstsze problemy

| Objaw | Przyczyna | Co zrobić |
|---|---|---|
| BCM nie wstaje po boocie | `bcm-headunit` nie jest i **nie ma być** enable'owany | sprawdź `bcm-ignition-watcher` — to on startuje BCM |
| `Address already in use` na 5002 | działa druga instancja | `ss -tlnp \| grep 5002`, potem `pkill -f main.py` lub `systemctl stop bcm-headunit` |
| Splash nie startuje | zła nazwa złącza DRM albo X trzyma framebuffer | `systemctl edit bcm-splash-small.service` → `BCM_SPLASH_DRM_SMALL=`; przy teście ręcznym najpierw ubij X |
| Widoczny tylko jeden ekran | przejściówka DP-HDMI albo kabel | sprawdź `/sys/class/drm/card*-*/status` — muszą być dwa `connected` |
| Ekrany połączone w jeden pulpit | brak `xrandr --pos` | popraw `~/.xinitrc` |
| Dotyk chodzi po obu ekranach | brak `map-to-output` | `xinput map-to-output "<nazwa>" DP-1` |
| Brak `gpiod` przy starcie | **normalne na x86** | zignoruj — I/O idzie przez Arduino |
| Błędy BlueZ na maszynie deweloperskiej | brak sprzętu BT | `modules.bluetooth: false` + `modules.phonebook: false` |
| WiFi „hardware init failed" | brak `firmware-mediatek` | `sudo apt install firmware-mediatek` i restart |
| Nie wchodzi w S3 | modem LTE HiLink blokuje suspend | `bcm-power-toggle.sh` odpina go — sprawdź, czy skrypt jest w `/usr/local/bin` i wykonywalny |
| `mem_sleep` bez `deep` | Modern Standby w BIOS | włącz S3 w BIOS, ewentualnie `mem_sleep_default=deep` |
| Zepsuty venv (`pip: command not found`) | — | `rm -rf .venv && python3 -m venv .venv` + reinstalacja requirements |
| Nowe klasy Tailwind bez stylów | CSS jest prekompilowany | `./config/scripts/build-frontend.sh` |

### Frontend — prekompilowany Tailwind

Frontend **nie** używa runtime'owego `tailwind.js`. Statyczny, zminifikowany
arkusz `src/dashboard/web/assets/vendor/tailwind.css` (~37 KB) jest generowany
z góry i commitowany. Po dodaniu nowych klas w `index.html` albo w `js/**`
trzeba przebudować:

```bash
./config/scripts/build-frontend.sh    # wymaga node/npm
```

---

## 18. Reset i ponowna instalacja

Przy nawarstwionych konfiguracjach z wielu prób najprościej wyczyścić
wszystko i zainstalować od nowa:

```bash
cd /opt/bcm && git pull
sudo bash config/scripts/setup-x86.sh      # czyści i instaluje
```

Samo czyszczenie, bez instalacji:

```bash
sudo bash config/scripts/cleanup-x86.sh
```

Usuwane są: wszystkie usługi BCM, `~/.xinitrc`, `~/.bash_profile`, override
autologinu, konfiguracje hostapd / dnsmasq / NetworkManager, override acpid
dla przycisku zasilania, polityka Chromium, konfiguracja X11 wrapper oraz
venv.

Jest jeszcze `config/scripts/apply-fixes.sh` — nakłada poprawki na istniejącą
instalację bez pełnego resetu.

---

## 19. Znane rozbieżności

Rzeczy wykryte przy porządkowaniu dokumentacji. Żadna nie blokuje wdrożenia,
ale wszystkie potrafią kosztować godzinę szukania.

### 19.1 Nazwy złączy — sprawdź na maszynie, nie w specyfikacji

Wcześniejsze wydanie tej dokumentacji twierdziło, że skrypty błędnie używają
nazw `HDMI-*`, bo M910q ma dwa wyjścia DisplayPort. **To było ustalenie
z tabeli specyfikacji, nie z maszyny — i jest sprzeczne z tym, co widać
w kodzie.**

`config/scripts/bcm-splash-play.sh` oraz `config/systemd/bcm-splash-main.service`
zawierają notatki z realnej diagnostyki na tej sztuce M910q: złącza
enumerują się jako **`HDMI-A-1` / `HDMI-A-2`**, a główny panel wyszedł na
**złączu 2** (stara konfiguracja przypięta na sztywno do `HDMI-A-1` powodowała
znikanie splasha, bo tam nic nie było podłączone).

Wnioski:

- **nie zakładaj nazw** — odczytaj je z maszyny:
  `for f in /sys/class/drm/card*-*/status; do echo "$f: $(cat $f)"; done`
- `setup-x86.sh` ma teraz `MAIN_OUTPUT="HDMI-2"` / `SMALL_OUTPUT="HDMI-1"`,
  zgodnie z powyższym; jeżeli na Twojej sztuce jest odwrotnie, zamień je
  miejscami (główny panel ciemny, a drugi pokazuje dashboard = zamienione),
- splash **nie wymaga** już żadnej konfiguracji złącza — wykrywa wszystkie
  podłączone automatycznie,
- jeżeli Twój egzemplarz faktycznie ma wyjścia DisplayPort, potrzebne będą
  pasywne przejściówki DP → HDMI; nazwy złączy i tak odczytaj z systemu.

### 19.2 Limit prądu ładowania jest za wysoki dla CSB HR1221W

`X86_PLATFORM_SETUP.md` § 2.2 i `x86-production/10-power-suspend.html` podają
14,4 V absorpcji / 13,8 V float i limit prądu **15–20 A**.

**Napięcia są prawidłowe** — HR1221W to AGM, a karta katalogowa CSB dopuszcza
14,4–15,0 V cyklicznie i 13,5–13,8 V buforowo. **Limit prądu nie jest**:
katalog podaje 2,1 A na pakiet. Przy dzisiejszym banku **siedmiu** pakietów
sufit wynosi 14,7 A, więc dolna wartość z tamtych notatek mieści się w karcie
— ale obowiązująca nastawa to **CC 8,0 A** i ogranicza ją tor ładowania
(płytka XH-M603), a nie akumulator. Brakuje też kompensacji temperaturowej
(−18 mV/°C float, −30 mV/°C cykl).

Obowiązujące nastawy: [`ZASILANIE_BUFOROWANE.md`](ZASILANIE_BUFOROWANE.md) §4.4–§4.5 i §5.

Tam też jest wyjaśnione, dlaczego proponowany moduł **buck** XL4016 nie może
pełnić roli ładowarki (nie podniesie napięcia do absorpcji) — §5.1.

### 19.3 Moduł `battery` — monitor banku buforowego (przygotowany, domyślnie wyłączony)

Dawniej `src/power/battery.py` miał progi **ogniwa Li-ion 18650** (4,2 / 3,7
/ 3,3 / 3,0 V) i czekał na `arduino.battery_voltage`, którego żaden sketch
nie wysyłał. Dziś:

- `arduino/sensor_hub` ma pomiar banku w dwóch wariantach, domyślnie
  wyłączonych: `FEATURE_BATT_ADC` (dzielnik 100k/27k na A6, samo napięcie)
  i `FEATURE_BATT_INA226` (I2C + bocznik, napięcie i prąd). Wysyła
  `BATT:<mV>[,<mA>]` co 2 s; `arduino_serial.py` publikuje
  `arduino.battery_voltage` [V] i `arduino.battery_current` [A];
- `battery.py` ma progi AGM 12 V (12,85 / 12,40 / 11,80 / 11,20 V,
  blok `battery:` w configu) i publikuje `battery.state`. Niczego nie
  wyłącza — to robi sprzętowe LVD.

Włączenie: wgranie sensor huba z flagą (bez edycji sketcha), port
w `arduino.sensor_hub_port`, `modules.battery: true`:

```bash
make -C arduino sensor_hub-upload PORT=/dev/ttyUSB1 SENSOR_HUB_FEATURES=BATT_ADC
```

Szczegóły, w tym kalibracja (`BATT_ADC_CAL` względem multimetru, znak
prądu INA226): [`ZASILANIE_BUFOROWANE.md`](ZASILANIE_BUFOROWANE.md) §13.4.

### 19.4 Czas postoju „17 dni"

Liczba w `X86_PLATFORM_SETUP.md` § 2.3 pochodzi z pełnego rozładowania banku,
mimo adnotacji o ograniczeniu do 50 % DoD. Poprawione wartości:
[`ZASILANIE_BUFOROWANE.md`](ZASILANIE_BUFOROWANE.md) §9.2.

### 19.5 Tor audio: gotowy wzmacniacz zamiast układów TDA

Projekt rezygnuje z budowania wzmacniacza na TDA7388 + TDA2050 na rzecz
**gotowego 4-kanałowego wzmacniacza samochodowego** z wejściami RCA,
zasilanego wprost z akumulatora rozruchowego i odseparowanego od systemu
buforowanego (§14, [`../schematics/audio_system.svg`](../schematics/audio_system.svg)).

Dokumenty źródłowe wciąż pokazują starą ścieżkę DIY:
`x86-production/01-bom.html`, `02-assembly.html`, `10-power-suspend.html`,
`index.html` oraz `bcm_v85_docs.html`. Zostają jako referencja historyczna;
**obowiązuje opis z §14 i schemat toru audio**.

Po stronie software'u nic się nie zmienia — PipeWire widzi wyłącznie DAC USB,
a co jest za gniazdem RCA, jest dla niego niewidoczne.

### 19.6 Limit poboru CPU jest wymagany, nie opcjonalny

Zasilanie M910q idzie przez posiadany moduł **XL6019**, którego realna
obciążalność to ok. **45 W** (limit prądu klucza 5 A), a nie 65 W ze znamionowej
mocy zasilacza. Usługa `bcm-power-cap` ograniczająca pakiet CPU do 28 W jest
częścią wdrożenia, nie optymalizacją — instrukcja w
[`ZASILANIE_BUFOROWANE.md`](ZASILANIE_BUFOROWANE.md) §3.5a.

### 19.7 Nazewnictwo jednostki `bcm-headunit.service`

Plik `config/systemd/bcm-headunit.service` był **wariantem Orange Pi PC**,
mimo neutralnej nazwy. Został zarchiwizowany jako
`Archive/orange-pi-pc/bcm-headunit-opi-pc.service`. Na M910q instaluje się
`bcm-headunit-x86.service` **pod nazwą** `bcm-headunit.service` (§7.1).

---

## 20. Wyświetlacz pomocniczy 1,8" na ESP32

Panel **ST7735 128 × 160 px, pionowo**, w miejscu fabrycznego wyświetlacza:
ekran 1 to metadane muzyki z kontrolkami, ekran 2 — ostrzeżenie o otwartym
nadwoziu. Sterownikiem jest **ESP32-S3** wpięty w USB, ale kontrolki i czujniki
otwarcia idą **wprost z auta na GPIO**, więc ekran 2 działa niezależnie od
komputera.

Projekt ekranów, protokół i budżet poboru:
[`WYSWIETLACZ_ESP32_1V8.md`](WYSWIETLACZ_ESP32_1V8.md). Okablowanie
zacisk po zacisku: [`SCHEMATY_POLACZEN.md`](SCHEMATY_POLACZEN.md) §11
+ [`../schematics/esp32_display_wiring.svg`](../schematics/esp32_display_wiring.svg).

**Moduł jest opcjonalny** — domyślnie wyłączony (`modules.esp32_display: false`).
Brak płytki na USB niczego nie psuje: most loguje to raz i czeka.

### 20.1 Firmware

Rdzeń Espressifa dla `arduino-cli` instaluje się osobno (~1 GB) — komplet
poleceń jest w nagłówku [`../arduino/Makefile`](../arduino/Makefile).

```bash
make -C arduino esp32_display-test                        # testy hosta, bez płytki
make -C arduino esp32_display                             # kompilacja
make -C arduino esp32_display-upload PORT=/dev/ttyACM_display
```

> **W Arduino IDE zaznacz „USB CDC On Boot: Enabled”.** Bez tego `Serial`
> nie jest natywnym USB i protokół nie ma czym jechać. `Makefile` podaje
> komplet ustawień panelu (`TFT_ESPI_FLAGS`) flagami kompilatora, żeby
> konfiguracja `TFT_eSPI` została w repo, a nie w katalogu biblioteki.

Testy hosta (`arduino/esp32_display/test/test_host.cpp`) sprawdzają parser
protokołu, debounce wejść, wybór ekranu, font i składanie napisów — czystym
`g++`, bez płytki.
Warto je puścić przed każdym wgraniem.

### 20.2 Port USB i reguła udev

Wpięcie: **natywne** gniazdo USB-C ESP32-S3 → hub USB → M910q
([`SCHEMATY_POLACZEN.md`](SCHEMATY_POLACZEN.md) §5.3). Drugie gniazdo na
płytkach deweloperskich idzie do mostka UART i **nie** nadaje się do tego
zastosowania.

Reguła udev jest konieczna z tego samego powodu co przy K-Line (§12):
numeracja `/dev/ttyACM*` przeskakuje między restartami, a na tych węzłach
siedzi już Pro Micro (§11 — oba Nano są na `/dev/ttyUSB*`).

```bash
cd /opt/bcm
sudo cp config/udev/99-bcm-esp32-display.rules /etc/udev/rules.d/
sudo udevadm control --reload-rules && sudo udevadm trigger
ls -l /dev/ttyACM_display      # oczekiwane: dowiązanie -> ttyACMn
```

Gdy dowiązanie nie powstaje:

```bash
lsusb | grep -i espressif                 # oczekiwane: ID 303a:1001
udevadm info -a -n /dev/ttyACM0 | grep -m3 'idVendor\|idProduct\|{serial}'
groups | grep dialout                     # bez tego port jest tylko do odczytu roota
```

> **Dwa ESP32 w aucie = ten sam VID:PID.** `303a:1001` mają wszystkie płytki
> z tej rodziny. Wtedy dopisz do reguły `ATTRS{serial}=="..."` — numer seryjny
> odczytasz poleceniem wyżej. Plik reguły ma to opisane w komentarzu.

### 20.3 Włączenie modułu

```yaml
# config/bcm_config.yaml
modules:
  esp32_display: true
esp32_display:
  port: /dev/ttyACM_display   # ścieżce z udev most ufa bez pytania
  baudrate: 115200
  scan: true                  # brak ścieżki -> skan ttyACM0..3 z PING/PONG
  ping_interval: 2.0          # ESP32 uznaje BCM za offline po 5 s ciszy
  time_unit: ms               # jednostka bt.media_position na magistrali
```

Most po stronie BCM to [`../src/dashboard/esp32_link.py`](../src/dashboard/esp32_link.py),
startowany generycznie z rejestru `src/core/modules_catalog.py`.
**Zmiana wymaga restartu BCM** (§15).

### 20.4 Weryfikacja — czy linie lecą

Najpierw „na sucho”, z zatrzymanym BCM (dwa procesy nie mogą trzymać jednego
portu):

```bash
sudo systemctl stop bcm-headunit
stty -F /dev/ttyACM_display 115200 raw -echo
cat /dev/ttyACM_display &                      # po resecie płytki: READY
printf 'PING\n' > /dev/ttyACM_display          # oczekiwane: PONG
printf 'SRC:BT\nTITLE:Nightcall\nARTIST:Kavinsky\nPLAY:1\nDUR:258\nPOS:87\n' \
    > /dev/ttyACM_display                      # na ekranie: tytuł, wykonawca, pasek
kill %1
```

Potem z uruchomionym BCM:

```bash
sudo systemctl start bcm-headunit
journalctl -u bcm-headunit -f | grep -i esp32
# oczekiwane:  ESP32 display: most uruchomiony (port docelowy /dev/ttyACM_display)
#              ESP32 display podłączony: /dev/ttyACM_display
```

| Objaw | Przyczyna |
|---|---|
| Brak `/dev/ttyACM_display` | reguła nie wgrana albo kabel w gnieździe mostka UART, a nie w natywnym USB |
| `ESP32 display: brak portu (...) — tryb bezczynny` | portu nie ma; most czeka i próbuje dalej, to nie jest błąd |
| `... nie jest wyświetlaczem (3 próby) — przestaję go zaczepiać` | skan trafił na Pro Micro (`/dev/ttyACM0`) i nie dostał `PONG`; wgraj regułę udev, żeby skan w ogóle nie ruszał — czytanie z tego portu podkrada bajty `arduino_serial.py` |
| `ESP32 display: utrata portu ...` | kabel wypięty albo płytka zresetowana w trakcie pracy; most zamyka port, szuka od nowa i po znalezieniu wysyła pełny stan — nic nie trzeba robić |
| Metadane gasną do `---`, kontrolki działają | BCM milczy > 5 s — moduł wyłączony, BCM zatrzymany albo kabel wypięty |
| Kontrolki i ekran 2 działają przy wyłączonym komputerze | tak ma być — te sygnały idą wprost na GPIO |
| Płytka resetuje się przy otwieraniu portu | ktoś otworzył port przy **1200 bps**; rdzeń S3 traktuje to jako wejście w bootloader |

Wgranego firmware nie trzeba ruszać przy aktualizacjach BCM — protokół jest
jednokierunkowy i wstecznie zgodny: **nieznany klucz ESP32 ignoruje bez błędu**.

---

## Powiązane dokumenty

| Dokument | Zakres |
|---|---|
| [`WDROZENIE_TESTOWE.md`](WDROZENIE_TESTOWE.md) | wariant minimalny do bieżącej weryfikacji + lista zakupowa na już |
| [`ZASILANIE_BUFOROWANE.md`](ZASILANIE_BUFOROWANE.md) | zasilanie buforowane: schematy, dobór, lista zakupowa, procedura rozruchu |
| [`SCHEMATY_POLACZEN.md`](SCHEMATY_POLACZEN.md) | schematy połączeniowe: tabele „skąd → dokąd”, przekroje, bezpieczniki, masy |
| [`URUCHOMIENIE.md`](URUCHOMIENIE.md) | symulacja na laptopie, przełączniki modułów, Arduino w skrócie |
| [`X86_PLATFORM_SETUP.md`](X86_PLATFORM_SETUP.md) | referencja krok-po-kroku (EN) — pamiętaj o §19 |
| [`x86-production/index.html`](x86-production/index.html) | 12 rozdziałów z ilustracjami |
| [`QA_ODBIOR.md`](QA_ODBIOR.md) | ankieta odbiorowa v8.5.3 — SWC, dźwięk, Android Auto, zestaw modułów |
| [`ARDUINO_OD_ZERA.md`](ARDUINO_OD_ZERA.md) | pierwsze wgranie firmware — dla zupełnie początkujących |
| [`ARDUINO_SETUP_GUIDE.md`](ARDUINO_SETUP_GUIDE.md) | okablowanie trzech płytek Arduino |
| [`KLINE_SNIFFING.md`](KLINE_SNIFFING.md) | podsłuch K-Line, poznawanie PID-ów ECU |
| [`../schematics/README.md`](../schematics/README.md) | indeks schematów elektrycznych |
| [`PODSUMOWANIE_KONSOLIDACJI.md`](PODSUMOWANIE_KONSOLIDACJI.md) | raport z konsolidacji: co przeniesiono, jakie rozbieżności wykryto |
| [`../AUDYT_I_PLAN.md`](../AUDYT_I_PLAN.md) | audyt repozytorium i roadmapa |
| [`../Archive/README.md`](../Archive/README.md) | platformy zarchiwizowane |
