geek95dg/Alfa156-headunit/docs/SCHEMATY_POLACZEN.md

# Schematy połączeniowe — jak to pospiąć w całość

Praktyczny przewodnik montażowy: co z czym połączyć, jakim przewodem, przez
jaki bezpiecznik i w jakiej kolejności. Uzupełnia schematy blokowe
(architektura) o poziom **zacisk po zacisku**.

| Rysunek | Co pokazuje |
|---|---|
| [`wiring_power_modules.svg`](../schematics/wiring_power_modules.svg) | Moduły zasilania — każdy zacisk podpisany, przekroje, bezpieczniki, masy |
| [`wiring_vehicle_arduino.svg`](../schematics/wiring_vehicle_arduino.svg) | Sygnały pojazdu → układy dopasowujące (PC817, dzielniki) → Arduino |
| [`wiring_usb_av.svg`](../schematics/wiring_usb_av.svg) | USB, wyświetlacze, audio, kamery |
| [`vehicle_layout_m910q.svg`](../schematics/vehicle_layout_m910q.svg) | Rozmieszczenie w aucie — strefy montażu, trasy kablowe, bilans masy |
| [`esp32_display_wiring.svg`](../schematics/esp32_display_wiring.svg) | Wyświetlacz pomocniczy 1,8" — dziesięć wejść przez PC817, panel ST7735 po SPI, zasilanie z +15 |

Schematy blokowe (co i dlaczego): [`../schematics/README.md`](../schematics/README.md).
Dobór podzespołów i nastawy: [`ZASILANIE_BUFOROWANE.md`](ZASILANIE_BUFOROWANE.md).

---

## Spis treści

1. [Konwencje](#1-konwencje)
2. [Tabela połączeń — zasilanie](#2-tabela-połączeń--zasilanie)
3. [Tabela połączeń — sygnały pojazdu](#3-tabela-połączeń--sygnały-pojazdu)
4. [Tabela połączeń — Arduino](#4-tabela-połączeń--arduino)
5. [Tabela połączeń — USB, obraz, audio](#5-tabela-połączeń--usb-obraz-audio)
6. [Bezpieczniki — zestawienie](#6-bezpieczniki--zestawienie)
7. [Masy](#7-masy)
8. [Kolejność montażu](#8-kolejność-montażu)
9. [Lista kontrolna przed pierwszym załączeniem](#9-lista-kontrolna-przed-pierwszym-załączeniem)
10. [Tabela połączeń — wariant testowo-rozwojowy](#10-tabela-połączeń--wariant-testowo-rozwojowy)
11. [Wyświetlacz pomocniczy 1,8" na ESP32](#11-wyświetlacz-pomocniczy-18-na-esp32)

---

## 1. Konwencje

### Kolory na schematach

| Kolor | Znaczenie |
|---|---|
| Czerwony gruby | zasilanie 12 V (moc) |
| Pomarańczowy | zasilanie 5 V |
| Czarny | masa |
| Niebieski | sygnał logiczny |
| Niebieski przerywany | sygnał sterujący (ACC, NTC, REM) |
| Zielony | USB |
| Fioletowy | obraz (DisplayPort / HDMI / AHD) |
| Bordowy | audio analogowe |

### Kolory przewodów w aucie — propozycja

Repozytorium nie narzuca kolorystyki, ale warto się jednej trzymać — przy
diagnostyce po roku od montażu to oszczędza godziny:

| Obwód | Kolor |
|---|---|
| +12 V stałe (przed LVD) | czerwony |
| +12 V buforowane (za LVD) | czerwono-biały |
| +12 V odbiorników (za wyłącznikiem głównym) | pomarańczowy |
| +5 V | żółty |
| +19 V do M910q | brązowy |
| Masa | czarny |
| Sygnały do Arduino | szary / niebieski |
| ACC (sterowanie) | zielony |

### Zaciski na rysunkach

Zaciski są narysowane **na krawędziach obudów** i ponumerowane. Numery
w tabelach poniżej odpowiadają numerom na
[`wiring_power_modules.svg`](../schematics/wiring_power_modules.svg).

---

## 2. Tabela połączeń — zasilanie

### 2.1 Tor główny (od auta do banku)

| # | Skąd | Dokąd | Przewód | Zabezpieczenie |
|---|---|---|---|---|
| 1 | Akumulator „+” | Bezpiecznik główny (wejście) | 6 mm² | — |
| 2 | Bezpiecznik główny (wyjście) | Przekaźnik ładowania **30** | 6 mm² | 30 A, ≤ 30 cm od klemy |
| 3 | Przekaźnik ładowania **87** | Dioda MBR2545CT — anody (1 + 3) | 6 mm² | — |
| 4 | Dioda MBR2545CT — katoda (2 / blaszka) | Ładowarka **IN +** (zacisk 1) | 6 mm² | blaszka pod potencjałem katody — izoluj od masy |
| 5 | Ładowarka **IN −** (2) | punkt gwiazdowy masy | 6 mm² | — |
| 6 | Ładowarka **OUT +** (3) | Blokada przeładowania **COM** (7) | 4 mm² | — |
| 7 | Ładowarka **OUT −** (4) | punkt gwiazdowy masy | 4 mm² | powrót tej samej pętli CV co przewód 6 — ten sam przekrój |
| 8 | Blokada **NC** (8) | szyna „+” banku (odczep nr 1) | 4 mm² | — |
| 9 | Blokada **VCC** (5) | szyna „+” banku (pomiar) | 0,75 mm² | 2 A |
| 10 | Blokada **GND** (6) | punkt gwiazdowy masy | 0,75 mm² | — |

**Ochrona wejścia ładowarki** — montowana bezpośrednio na zaciskach IN+/IN−:
dioda TVS 1.5KE33CA równolegle oraz kondensator 470 µF / 35 V równolegle.

### 2.2 Bank akumulatorów

Bank ma **siedem pakietów** łączonych **równolegle** (12 V / 35,7 Ah).
Wpinają się do dwóch szyn zbiorczych z płaskownika miedzianego, po jednym
odczepie M6 na pakiet, rozstaw 70 mm.

| # | Skąd | Dokąd | Przewód | Zabezpieczenie |
|---|---|---|---|---|
| 11 | HR1221W #1 **„+” F2** | szyna „+” banku, odczep 1 | 1,5 mm² | **FB1** 10 A inline |
| 12 | HR1221W #2 **„+” F2** | szyna „+” banku, odczep 2 | 1,5 mm² | **FB2** 10 A inline |
| 13 | HR1221W #3 **„+” F2** | szyna „+” banku, odczep 3 | 1,5 mm² | **FB3** 10 A inline |
| 14 | HR1221W #4 **„+” F2** | szyna „+” banku, odczep 4 | 1,5 mm² | **FB4** 10 A inline |
| 15 | HR1221W #5 **„+” F2** | szyna „+” banku, odczep 5 | 1,5 mm² | **FB5** 10 A inline |
| 15a | HR1221W #6 **„+” F2** | szyna „+” banku, odczep 6 | 1,5 mm² | **FB6** 10 A inline |
| 15b | HR1221W #7 **„+” F2** | szyna „+” banku, odczep 7 | 1,5 mm² | **FB7** 10 A inline |
| 16 | HR1221W #1–#7 **„−” F2** | szyna „−” banku, odczepy 1–7 | 1,5 mm² | — |
| 17 | szyna „−” banku, **odczep 7** | punkt gwiazdowy masy | 6 mm² | rozłącznik masy 100 A |
| 18 | NTC 10 kΩ | wejście czujnika ładowarki | 0,5 mm² | — |

> **Odbiór po przekątnej.** „+" bierzesz z **odczepu 1** szyny dodatniej
> (przewód 8 z §2.1), „−" z **odczepu 7** szyny ujemnej (przewód 17).
> Kolejność odczepów na obu szynach musi być ta sama: odczep „−" pakietu *k*
> naprzeciw odczepu „+" pakietu *k*. **Nigdy oba bieguny z tego samego końca
> szyny** — to jedyny układ, który przy siedmiu pakietach naprawdę psuje
> rozdział prądów (4,6 × gorzej niż przekątna).

> **Szyny, nie linka.** Dwa płaskowniki miedziane: minimum **15 × 2 mm**
> (30 mm²), zalecane **20 × 3 mm** (60 mm²). Prądowo starczyłoby 1,5 mm²
> (najbardziej obciążony segment wiezie 6,4 A) — przekrój wynika wyłącznie
> z rezystancji. Mostek z linki 4 mm² dałby 7,3 % rozrzutu prądów, płaskownik
> 15 × 2 mm — 0,99 %. Obie szyny **pod pokrywą izolacyjną**: prąd zwarciowy
> prospektywny banku to ~2,4 kA.

> **Jednakowe ogonki.** Przewód od każdego pakietu do szyny musi mieć ten sam
> przekrój i **tę samą rezystancję**, nawet jeśli pakiety leżą w różnych
> miejscach. Tolerancja: różnica długości pętli („+" i „−" razem)
> **≤ ±30 mm**. Nadmiar w drugim rzędzie **zwiń w pętlę serwisową, nie
> skracaj**. Nierówność rezystancji = nierówny rozdział prądu = jeden pakiet
> umiera pierwszy.

Pełne uzasadnienie liczbowe i rysunek szyn: §4.3
[`ZASILANIE_BUFOROWANE.md`](ZASILANIE_BUFOROWANE.md).

> **Zaciski F2.** Nasuwki 6,35 mm w pełni izolowane, zaciskane zaciskarką
> zapadkową, koszulka termokurczliwa z klejem, wiązka przypięta opaską do
> skrzynki (odciążenie mechaniczne).

### 2.3 LVD i dystrybucja

| # | Skąd | Dokąd | Przewód | Zabezpieczenie |
|---|---|---|---|---|
| 19 | szyna „+” banku (odczep 1) | XH-M609 **VIN +** (9) | 2,5 mm² | **F7** 15 A, klasa **MIDI/AMI lub ANL** |
| 20 | XH-M609 **VIN −** (10) | punkt gwiazdowy masy | 2,5 mm² | — |
| 21 | XH-M609 **VOUT +** (11) | listwa dystrybucyjna, wejście | 2,5 mm² | — |
| 22 | XH-M609 **VOUT −** (12) | punkt gwiazdowy masy | 2,5 mm² | — |
| 23 | listwa, szyna masowa | punkt gwiazdowy masy | 6 mm² | — |

> **XH-M609 — sprawdź przed montażem.** Przekaźnik ma przerywać **plus**.
> Omomierz między VIN− a VOUT− musi pokazywać zwarcie niezależnie od stanu
> przekaźnika; jeżeli pokazuje przerwę, moduł przełącza masę i rozspójnia
> topologię jednego punktu gwiazdowego. Szczegóły i pozostałe dwa sprawdzenia:
> [`ZASILANIE_BUFOROWANE.md`](ZASILANIE_BUFOROWANE.md) §7.3.
>
> Bezpiecznik **F7** 15 A przed VIN+ wynika z zalecenia producenta modułu:
> 1,5 × prąd szczytowy obciążenia = 1,5 × 7,5 = 11,25 A, czyli najbliższa
> większa wkładka typoszeregu. Wartość nie zależy od liczby pakietów — przez
> F7 płynie wyłącznie prąd odbiorników. **Klasa jednak zależy**: przy banku
> siedmiu pakietów prąd zwarciowy prospektywny na szynie to ~2,4 kA, a ATO/ATC
> ma zdolność wyłączania ok. 1 kA. Użyj wkładki MIDI/AMI albo ANL
> (≥ 2 kA) — §7.4 [`ZASILANIE_BUFOROWANE.md`](ZASILANIE_BUFOROWANE.md).

### 2.4 Domena A (zawsze zasilana)

| # | Skąd | Dokąd | Przewód | Zabezpieczenie |
|---|---|---|---|---|
| 24 | listwa, obwód 1 | Buck LM2596 **IN +** | 0,75 mm² | 3 A |
| 25 | Buck LM2596 **IN −** | masa | 0,75 mm² | — |
| 26 | Buck **OUT +** (5,0 V) | Nano #1 pin **5V** | 0,75 mm² | — |
| 27 | Buck **OUT +** (5,0 V) | Nano #2 pin **5V** | 0,75 mm² | — |
| 28 | Buck **OUT +** (5,0 V) | HM-10 **VCC**, RXB6 **VCC** | 0,5 mm² | — |
| 29 | Buck **OUT −** | Nano #1/#2 **GND**, HM-10, RXB6 | 0,75 mm² | — |
| 30 | listwa, obwód 1 | Moduł 9 przekaźników **VCC** (12 V) | 0,75 mm² | wspólny z poz. 24 |
| 31 | Moduł przekaźników **GND** | masa | 0,75 mm² | — |

> **Nie podawaj napięcia na pin Vin Nano.** Buck jest ustawiony na 5,0 V
> i idzie wprost na pin **5V**, z pominięciem wewnętrznego stabilizatora.

### 2.5 Domena B (za zapłonem)

| # | Skąd | Dokąd | Przewód | Zabezpieczenie |
|---|---|---|---|---|
| 32 | listwa, obwód 2 | Przekaźnik **30** | 2,5 mm² | 30 A |
| 33 | Przekaźnik **87** | XL6019 **IN +** (13) | 2,5 mm² | — |
| 34 | Przekaźnik **87** | Buck MP1584 **IN +** | 1,0 mm² | 3 A |
| 35 | Przekaźnik **87** | Hub USB, zasilanie | 1,0 mm² | 3 A |
| 36 | Przekaźnik **86** | linia ACC z zamka kluczyka | 0,75 mm² | 5 A |
| 37 | Przekaźnik **85** | masa | 0,75 mm² | — |
| 38 | XL6019 **IN −** (14) | masa | 2,5 mm² | — |
| 39 | XL6019 **OUT +** (15) | wtyk M910q, **środek** | 1,5 mm² | 5 A |
| 40 | XL6019 **OUT −** (16) | wtyk M910q, **ekran** | 1,5 mm² | — |
| 39a | XL6019 **OUT +** ↔ **OUT −** | kondensator 470 µF / 35 V low-ESR | — | — |
| 41 | Buck MP1584 **OUT +** | panel główny 10,1", 5 V | 1,0 mm² | — |
| 42 | Buck MP1584 **OUT +** | panel drugi 6,86", 5 V *(opcjonalny)* | 1,0 mm² | — |
| 43 | Buck MP1584 **OUT −** | masa paneli (wspólna z Nano #1) | 1,0 mm² | — |

> **Dioda gaszeniowa 1N4007** równolegle do cewki przekaźnika: **katoda do
> zacisku 86**, anoda do 85. Bez niej przepięcie przy rozwarciu cewki wraca
> do instalacji.

> **XL6019 daje ok. 45 W, nie 65 W** (limit prądu klucza 5 A). Przed
> uruchomieniem w aucie ustaw limit poboru pakietu CPU na M910q —
> [`ZASILANIE_BUFOROWANE.md`](ZASILANIE_BUFOROWANE.md) §3.5a. Wyjścia
> przetwornicy **nie da się użyć jako wyłącznika** komputera: boost przepuszcza
> napięcie wejściowe. Komputera nie odcina nic — usypia go impuls z Arduino
> na przycisk zasilania (§10.5).

### 2.6 Gałąź wzmacniacza (niezależna)

Wzmacniacz to **gotowy moduł samochodowy** z wejściami RCA, nie układ DIY.
Podłącza się go jak radio samochodowe: zasilanie wprost z akumulatora, własna
masa, wyzwalanie sygnałem REM.

| # | Skąd | Dokąd | Przewód | Zabezpieczenie |
|---|---|---|---|---|
| 44 | Akumulator „+” | Wzmacniacz **+12V** | 6 mm² | wg karty modułu, przy klemie |
| 45 | Wzmacniacz **GND** | masa lokalna, przy wzmacniaczu | 6 mm² | — |
| 46 | Przekaźnik **87** | Wzmacniacz **REM** | 0,75 mm² | 2 A |

> **Bezpiecznik dobierz wg karty wzmacniacza**, nie „na oko". Typowy moduł
> 4 × 50 W RMS ma na płytce bezpiecznik 20–30 A i tyle samo powinien mieć
> przy klemie. Przewód 6 mm² wynika ze spadku napięcia na trasie do bagażnika
> (~4 m), nie z samego prądu.

> **Masa wzmacniacza osobno.** To jedyny obwód mocy, który **nie** idzie do
> punktu gwiazdowego — wspólna masa z komputerem daje pętlę i przydźwięk
> alternatora. Masa krótka (do 1 m), do gołego metalu, tym samym przekrojem
> co „+”.

> **REM bez rezystora szeregowego.** Wejście REM gotowego wzmacniacza jest
> wysokoomowe (10–20 kΩ) i ma własne wyciszanie startu — rezystor 1 kΩ był
> potrzebny tylko przy płytce DIY.

---

## 3. Tabela połączeń — sygnały pojazdu

Wszystkie sygnały 12 V idą przez **PC817**. Stan aktywny to **LOW**.

### 3.1 Stopień PC817 (powtarzany dla każdego sygnału 12 V)

| Element | Połączenie |
|---|---|
| Sygnał 12 V z auta | → rezystor 4,7 kΩ → PC817 **pin 1** (anoda) |
| PC817 **pin 2** (katoda) | → masa pojazdu |
| PC817 **pin 4** (kolektor) | → pin Arduino (tryb `INPUT_PULLUP`) |
| PC817 **pin 3** (emiter) | → masa Arduino |

Rezystor podciągający jest wewnątrz mikrokontrolera — zewnętrznego 10 kΩ
nie trzeba. **Masa pojazdu i masa Arduino są tu rozdzielone** — na tym
polega izolacja.

### 3.2 Sygnały 12 V

| Sygnał | Skąd w aucie | Przez | Dokąd |
|---|---|---|---|
| Zapłon / ACC | zamek kluczyka, poz. I/II | PC817 | Nano #2 **D9** |
| Kierunkowskaz lewy | wiązka tylnej lampy | PC817 | Nano #2 (wolny pin) |
| Kierunkowskaz prawy | wiązka tylnej lampy | PC817 | Nano #2 (wolny pin) |
| Bieg wsteczny | wyłącznik na skrzyni | PC817 | Nano #2 (wolny pin) |
| Podświetlenie | włącznik świateł | PC817 | Nano #2 (wolny pin) |

### 3.3 Styki zwierane do masy (bez PC817)

| Sygnał | Skąd | Dokąd |
|---|---|---|
| Drzwi przód lewe | wyłącznik oświetlenia wnętrza | Nano #2 **D2** |
| Drzwi przód prawe | j.w. | Nano #2 **D3** |
| Drzwi tył lewe | j.w. | Nano #2 **D4** |
| Drzwi tył prawe | j.w. | Nano #2 **D5** |
| Maska | wyłącznik maski | Nano #2 **D6** |
| Klapa bagażnika | wyłącznik klapy | Nano #2 **D7** |
| Hamulec ręczny | wyłącznik dźwigni | Nano #2 **D8** |

Wyłączniki OEM zwierają do masy — wpinaj je **wprost na pin**, bez
optoizolatora. Tryb `INPUT_PULLUP`, stan aktywny LOW.

### 3.4 Czujniki

| Czujnik | Dopasowanie | Dokąd |
|---|---|---|
| DS18B20 (temperatura) | 4,7 kΩ z DATA do 5 V | Nano #2 **D11** |
| Czujnik deszczu | wyjście cyfrowe DO modułu | Nano #2 **D10** |
| HC-SR04 TRIG (wspólny ×4) | wprost | Nano #2 **D12** |
| HC-SR04 ECHO ×4 | dzielnik 1 kΩ / 2 kΩ | Nano #2 **A0–A3** |
| LDR (jasność) | 5 V → LDR → węzeł → A1; węzeł → 10 kΩ → masa | Pro Micro **A1** |
| SWC Pod 1 | biały przewód dekodera | Pro Micro **A0** |
| SWC Pod 2 | biały przewód dekodera | Pro Micro **A6** = pad opisany **`4`** |

Dekoder SWC: **czerwony → ACC**, **czarny → masa**, **biały → wejście
analogowe**.

> **Na Pro Micro nie ma pola opisanego „A6" — szukasz pada `4`.** Na
> ATmega32U4 kanały ADC **A6–A11 są zmultipleksowane z pinami cyfrowymi**
> i na płytce drukowane są tylko numery cyfrowe. Opisane analogowo są
> wyłącznie A0–A3.
>
> | W kodzie | Pad na płytce | Port AVR |
> |----------|---------------|----------|
> | **A6** | **`4`** | PD4 / ADC8 |
> | A7 | `6` | PD7 / ADC10 |
> | A8 | `8` | PB4 / ADC11 |
> | A9 | `9` | PB5 / ADC12 |
> | A10 | `10` | PB6 / ADC13 |
>
> W sketchu zostaje `#define SWC_PIN2 A6` — nazwa `A6` służy tylko temu,
> żeby `analogRead()` wybrał właściwy kanał ADC. **A4 i A5 nie są
> wyprowadzone** na klasycznym Pro Micro.

### 3.5 K-Line (osobny tor, bez Arduino)

| Skąd | Dokąd | Uwagi |
|---|---|---|
| M910q, port USB | CP2102 | reguła udev → `/dev/ttyUSB_kline` |
| CP2102 **TX** | L9637D **pin 1** (TXD) | |
| CP2102 **RX** | L9637D **pin 2** (RXD) | |
| L9637D **pin 3** | masa | |
| L9637D **pin 4** | +5 V | kondensator 100 nF do masy, przy kostce |
| L9637D **pin 6** (EN) | +5 V | |
| L9637D **pin 8** (K-Line) | OBD-II **pin 7** | rezystor 510 Ω z linii K do +12 V |
| OBD-II **pin 4/5** | masa | |

---

## 4. Tabela połączeń — Arduino

Pełne tabele pinów: [`ARDUINO_SETUP_GUIDE.md`](ARDUINO_SETUP_GUIDE.md) § 7
i § 7b. Poniżej to, co dotyczy okablowania międzymodułowego.

### 4.1 Nano #1 (wyjścia — przekaźniki, PWM)

| Pin | Dokąd |
|-----|---|
| D2 | RXB6 433 MHz **DATA** |
| D3 | HM-10 **RXD** |
| D4 | HM-10 **TXD** |
| D5 | Moduł przekaźników **IN1** (bagażnik) |
| D6 | przycisk bagażnika → masa |
| D7, D8 | **IN2, IN3** — szyba przód lewa góra/dół |
| D9 | panel główny 10,1" — **M_PWM** |
| D10 | panel drugi 6,86" — **M_PWM** |
| D11, D12 | **IN4, IN5** — szyba przód prawa |
| A0, A1 | **IN6, IN7** — szyba tył lewa |
| A2, A3 | **IN8, IN9** — szyba tył prawa |
| 5V, GND | buck LM2596 **OUT+/OUT−** |

> **HM-10 wygląda na odwrotnie opisany, ale jest poprawnie:** Nano **D3**
> idzie do HM-10 **RXD**, a HM-10 **TXD** wraca do Nano **D4**.

> **Wspólna masa z panelami wyświetlaczy jest obowiązkowa** — bez niej
> bramka MOSFET-a na `M_PWM` nie ma odniesienia i podświetlenie nie
> reaguje.

### 4.2 Pro Micro (wejścia — enkoder, SWC, zapłon)

| Pin | Dokąd |
|-----|---|
| D2, D3 | enkoder **CLK**, **DT** (+10 kΩ do VCC) |
| D1 | przycisk enkodera → masa |
| D5–D9 | HOME, BACK, MEDIA, VOL+, VOL− → masa |
| D10, D14, D15, D16, A3 | panel muzyczny (PREV, NEXT, VOL+, VOL−, MUTE) |
| A0, A6 | SWC Pod 1, Pod 2 — **A6 to pad opisany `4`**, patrz §3.4 |
| A1 | LDR |
| A2 | przycisk na manetce |

> **v8.5.2:** przycisk enkodera przeniesiony z **D4 na D1** — na Pro Micro
> D4 i A6 to ten sam fizyczny pin (PD4 / ADC8) i kolidowało z SWC Pod 2.
> Przy starszym okablowaniu przepnij jeden przewód.

### 4.3 Nano #2 (sensor hub)

Patrz §3.3 i §3.4. Funkcje włącza się `#define FEATURE_*` na górze
`sensor_hub.ino` — wyłączony `FEATURE` zwalnia pin.

---

## 5. Tabela połączeń — USB, obraz, audio

### 5.1 Obraz

| Skąd | Dokąd | Uwagi |
|---|---|---|
| M910q, wyjście główne | wyświetlacz **10,1" 1280×800** + dotyk USB | dashboard, port 5002 |
| M910q, wyjście drugie | wyświetlacz **6,86" 1280×480** *(opcjonalny)* | statystyki, port 5003 |

> **Nazwy złączy sprawdź na swojej maszynie**, nie zakładaj z góry. Na
> referencyjnym M910q złącza enumerują się jako `HDMI-A-1` / `HDMI-A-2`
> (xrandr: `HDMI-1` / `HDMI-2`), a **główny panel wyszedł na złączu 2** —
> patrz komentarz w `config/scripts/bcm-splash-play.sh`. Jeżeli Twoja sztuka
> ma wyjścia DisplayPort, potrzebne będą pasywne przejściówki DP → HDMI.

Nazwy złączy sprawdź: `for f in /sys/class/drm/card*-*/status; do echo "$f: $(cat $f)"; done`

**Aktywne przejściówki nie są potrzebne** i bywają źródłem problemów
z wykryciem ekranu.

### 5.2 USB — bezpośrednio w port M910q

| Urządzenie | Dlaczego bezpośrednio |
|---|---|
| DAC ES9038Q2M | USB Audio Class 2 — hub dokłada opóźnienie i rywalizację o pasmo |
| Graber AHD 4-kanałowy | cztery strumienie 720p naraz potrzebują stałego pasma |

### 5.3 USB — przez hub (zasilany, 7 portów)

| Urządzenie | Port |
|---|---|
| Arduino Pro Micro | `/dev/ttyACM0` |
| Arduino Nano #1 | `/dev/ttyUSB0` |
| Arduino Nano #2 | `/dev/ttyUSB1` |
| CP2102 (K-Line) | `/dev/ttyUSB_kline` |
| ESP32-S3 (wyświetlacz 1,8", § 11) | `/dev/ttyACM_display` |
| GPS u-blox NEO-M8N | — |
| Modem LTE Huawei E3372 | — |
| Mikrofon USB | — |
| Dotyk wyświetlacza głównego | — |

> **Hub musi mieć własne zasilanie** (z szyny buforowanej). Osiem urządzeń nie
> wyrobi się na prądzie z portu M910q.

> **Reguły udev są konieczne.** Bez nich numeracja `/dev/ttyUSBn` zmienia
> się między restartami i K-Line trafia na port Arduino.

### 5.4 Audio

| Skąd | Dokąd | Kabel |
|---|---|---|
| DAC **RCA L/R** | Wzmacniacz, wejścia RCA przód | RCA ekranowany |
| DAC **RCA L/R** | Wzmacniacz, wejścia RCA tył (rozgałęźnik Y) | RCA ekranowany |
| Wzmacniacz **CH1** | głośnik przód lewy (4 Ω) | 1,5 mm² |
| Wzmacniacz **CH2** | głośnik przód prawy | 1,5 mm² |
| Wzmacniacz **CH3** | głośnik tył lewy | 1,5 mm² |
| Wzmacniacz **CH4** | głośnik tył prawy | 1,5 mm² |

Zasilanie i REM — §2.6.

> **Kabel RCA prowadź po przeciwnej stronie auta niż kabel zasilania
> wzmacniacza.** Równoległy przebieg to najprostszy sposób na przydźwięk.

> **Pętla masy.** DAC ma masę przez USB (punkt gwiazdowy pod deską),
> wzmacniacz ma masę lokalną w bagażniku, a ekran RCA łączy oba punkty.
> Jeżeli słychać buczenie zmieniające się z obrotami silnika: najpierw popraw
> masę wzmacniacza, potem przetrasuj RCA, i dopiero na końcu sięgaj po
> izolator pętli masy — pogarsza pasmo.

**Ustawienie wzmocnienia:** głośność systemu ~75 %, EQ płasko, gain
wzmacniacza na minimum; podnoś do pierwszych zniekształceń i cofnij o krok.
Bez subwoofera włącz filtr górnoprzepustowy ok. 80 Hz na wszystkich kanałach.

### 5.5 Kamery

| Kanał | Miejsce | Wyzwalanie |
|---|---|---|
| CH0 | przód, za lusterkiem wstecznym | ręcznie / DVR |
| CH1 | tył, ramka tablicy rejestracyjnej | bieg wsteczny |
| CH2 | lewe lusterko / błotnik | lewy kierunkowskaz |
| CH3 | prawe lusterko / błotnik | prawy kierunkowskaz |

Priorytet: **bieg wsteczny > lewy kierunkowskaz > prawy kierunkowskaz >
brak**. Sygnały wyzwalające wchodzą przez PC817 na Nano #2.

---

## 6. Bezpieczniki — zestawienie

| Wartość | Gdzie | Chroni |
|---|---|---|
| 30 A | przy klemie „+”, ≤ 30 cm | cały tor główny |
| wg karty modułu (20–30 A) | przy klemie „+”, osobno | gałąź wzmacniacza |
| 10 A × 7 (**FB1…FB7**) | na „+” każdego z siedmiu pakietów banku | zwarcie pojedynczego pakietu |
| 30 A | listwa, obwód 2 | odbiorniki 12 V |
| 5 A | wyjście step-up, przed wtykiem | M910q |
| 5 A | linia ACC do cewki przekaźnika | obwód sterowania |
| 3 A | listwa, obwód 1 | logika 5 V |
| 3 A | odgałęzienie buck MP1584 | panele wyświetlaczy |
| 3 A | odgałęzienie hub USB | hub i peryferia |
| 2 A | odgałęzienie +15 → buck 5 V wyświetlacza ESP32 | moduł wyświetlacza 1,8" (§ 11.3) |
| 15 A **MIDI/AMI lub ANL** (**F7**) | między szyną banku a XH-M609 **VIN +** | moduł LVD i cała szyna za nim; klasa z powodu 2,4 kA prądu zwarciowego |
| 2 A | zasilanie/pomiar modułu nadnapięciowego | obwód pomiarowy |

Wszystkie w listwie dystrybucyjnej ATO/ATC z pokrywą, w miejscu dostępnym
bez demontażu deski rozdzielczej. Wyjątek: bezpiecznik główny 30 A i 20 A
gałęzi wzmacniacza — w oprawkach przy klemie akumulatora.

---

## 7. Masy

**Jeden punkt gwiazdowy** dla całego head unitu:

- śruba do gołego metalu nadwozia, powierzchnia oczyszczona ze szpachli
  i lakieru, po dokręceniu zabezpieczona wazeliną techniczną,
- schodzą się w nim: masa banku (przez rozłącznik 100 A), masa listwy
  dystrybucyjnej, masa M910q, masa Arduino, masa audio od DAC-a,
- przekrój do nadwozia: **6 mm²**.

**Dwa wyjątki:**

1. **Masa wzmacniacza** — osobno, blisko wzmacniacza. Wspólna z komputerem
   daje pętlę masy i przydźwięk alternatora.
2. **Masa pojazdu po stronie PC817** — celowo odizolowana od masy Arduino.
   To sens optoizolacji.

---

## 8. Kolejność montażu

```
0. Rozplanuj strefy montażu wg vehicle_layout_m910q.svg — zanim cokolwiek wywiercisz
1. Punkt gwiazdowy masy — przygotuj i sprawdź omomierzem (< 0,5 Ω do klemy „−”)
2. Trasy przewodów — peszel, przelotki gumowe w każdej blasze
3. Listwa dystrybucyjna — zamontowana, dostępna, BEZ bezpieczników
4. Moduły zasilania — wszystkie zaciski dokręcone, BEZ zasilania
5. Bank — siedem pakietów zmierzonych osobno, wyrównanych, szyny zbiorcze
   z odczepami, bezpieczniki FB1…FB7 10 A założone
6. Rozłącznik masy banku w pozycji ROZWARTY
7. Nastawy modułów na stole (patrz ZASILANIE_BUFOROWANE.md § 11 etap 1)
8. Bezpiecznik główny 30 A — wkładany JAKO OSTATNI
```

**Zasada:** każdy etap kończy się pomiarem. Podłączenie wszystkiego naraz
i szukanie potem, co nie działa, kosztuje wielokrotnie więcej czasu niż
sprawdzanie po jednym obwodzie.

To samo dotyczy Arduino: wgraj firmware i sprawdź każdą płytkę przez
`picocom` **na stole**, zanim podłączysz cokolwiek z auta.

---

## 9. Lista kontrolna przed pierwszym załączeniem

```
[ ] Bezpiecznik główny 30 A WYJĘTY
[ ] Rozłącznik masy banku ROZWARTY
[ ] Polaryzacja na wtyku M910q sprawdzona multimetrem (środek „+”)
[ ] XL6019 ustawiony na 19,5 V i przetestowany pod obciążeniem
[ ] Limit poboru pakietu CPU ustawiony na M910q (wymóg przy XL6019)
[ ] Ładowarka: CV 14,40 V, CC **8,0 A** (§4.4 ZASILANIE_BUFOROWANE)
[ ] Rozłącznik nadnapięciowy: 15,30 V / 14,00 V, sprawdzony zasilaczem lab.
[ ] XH-M609: 11,00 V / 12,60 V, sprawdzony zasilaczem laboratoryjnym
[ ] XH-M609: potwierdzone, że przełącza plus, i zmierzony pobór własny
[ ] Buck logiki: 5,0 V na wyjściu (zmierzone, nie „powinno być”)
[ ] Buck paneli: 5,0 V na wyjściu
[ ] Dioda 1N4007 na cewce przekaźnika — katoda do 86
[ ] TVS i kondensator na wejściu ładowarki zamontowane
[ ] Wszystkie siedem pakietów banku zmierzone osobno, rozrzut < 0,2 V
[ ] Bezpieczniki FB1…FB7 10 A na każdym pakiecie
[ ] Odbiór z szyn po przekątnej: „+" z odczepu 1, „−" z odczepu 7
[ ] Ogonki pakietów równej długości (±30 mm), szyny pod pokrywą izolacyjną
[ ] Wszystkie zaciski dokręcone i pociągnięte ręką
[ ] Masa: < 0,5 Ω między punktem gwiazdowym a klemą „−” akumulatora
[ ] Żaden przewód nie ociera o krawędź blachy
[ ] Nic z instalacji 12 V nie idzie bezpośrednio na pin Arduino
```

Po odhaczeniu całości przejdź do procedury pomiarowej:
[`ZASILANIE_BUFOROWANE.md`](ZASILANIE_BUFOROWANE.md) § 11, etap 4.

---

## 10. Tabela połączeń — wariant testowo-rozwojowy

Ten rozdział dotyczy **wyłącznie** wariantu z
[`WDROZENIE_TESTOWE.md`](WDROZENIE_TESTOWE.md): mniej modułów, mniej okablowania,
M910q zasilany stale. Tabele §2–§5 opisują wersję docelową i tutaj **nie
obowiązują**.

**Rysunki — zacznij od tych dwóch.** Każdy element jest na nich narysowany
osobno: TVS i C1 to nie jeden bloczek, tylko dwa symbole z własnymi
połączeniami; cewki i styki przekaźników są rozdzielone (K1 i K2 to po
jednym przekaźniku, narysowanym w dwóch miejscach).

| Arkusz | Zakres |
|---|---|
| [`../schematics/schematic_test_power.svg`](../schematics/schematic_test_power.svg) | **1/2 — zasilanie.** Tor ładowania, bank z bezpiecznikami pakietów, LVD, wyłącznik, trzy przetwornice. Numery przewodów jak w tabelach niżej. |
| [`../schematics/schematic_test_signals.svg`](../schematics/schematic_test_signals.svg) | **2/2 — sygnały.** Oba transoptory, Arduino Nano, moduł przekaźnika, przycisk M910q, rozdział mas. |

Generator obu: [`../schematics/gen_test_schematics.py`](../schematics/gen_test_schematics.py)
— po zmianie tabel popraw generator i wygeneruj SVG ponownie, nie edytuj ich ręcznie.

Uzupełniająco: [`schematic_test_build.svg`](../schematics/schematic_test_build.svg)
(skrót ideowy) · [`wiring_test_build.svg`](../schematics/wiring_test_build.svg)
(rozmieszczenie i przekroje) ·
[`ignition_sense.svg`](../schematics/ignition_sense.svg)
(przebiegi czasowe uśpienia i wybudzania)

### 10.1 Tor ładowania

> **Wariant PCB.** Przewody 3, 5, B(część), 7c–7e istnieją też jako ścieżki
> na trawionej płytce A — wtedy łączysz tylko zaciski X1–X6 wg
> [`PCB_ZASILANIE.md`](PCB_ZASILANIE.md) §1, a XH-M603 pracuje w torze
> ładowania (bez K2 — uzasadnienie tamże, §3).

| # | Skąd | Dokąd | Przewód | Zabezpieczenie |
|---|---|---|---|---|
| 1 | Akumulator rozruchowy **„+”** | Bezpiecznik **F1** (wejście) | 4 mm² | — |
| 2 | **F1** (wyjście) | Płytka **TVS + C1**, biegun „+” | 4 mm² | 15 A, ≤ 30 cm od klemy |
| 3 | **TVS + C1** „+” | Przekaźnik **K1**, zacisk **30** | 4 mm² | — |
| 4 | Zapłon / ACC (albo **D+** alternatora) | **K1** zacisk **86** | 0,75 mm² | — |
| 5 | **K1** zacisk **87** | **D1 MBR2545CT**, anody **1 + 3** zwarte | 4 mm² | — |
| 6 | **D1** katoda **2** (blaszka) | Moduł CC-CV boost **IN+** | 4 mm² | — |
| **B** | Boost **OUT+** | **K2** (przekaźnik mocy) zacisk **30** | 4 mm² | powrót **OUT−** tym samym przekrojem |
| 7 | **K2** zacisk **87** | Szyna **„+”** banku (odczep nr 1) | 4 mm² | — |
| 7a | **K1** zacisk **87** | **XH-M603** zasilanie „+" | 0,75 mm² | — |
| 7b | **XH-M603** zasilanie „−" | Punkt gwiazdowy masy | 0,75 mm² | — |
| 7c | **K1** zacisk **87** | **XH-M603** styk **COM** | 0,75 mm² | — |
| 7d | **XH-M603** styk **NO** | **K2** zacisk **86** (cewka) | 0,75 mm² | — |
| 7e | **K2** zacisk **85** | Punkt gwiazdowy masy | 0,75 mm² | — |

> **XH-M603 i cewka K2 wiszą na zacisku 87 przekaźnika ładowania, nie na
> banku.** Na banku dokładałyby ~160 mA przez całą dobę — tyle, ile
> w stanie wyłączonym pobiera cała reszta instalacji. Uzasadnienie
> i zachowanie po zadziałaniu: §6.3 [`ZASILANIE_BUFOROWANE.md`](ZASILANIE_BUFOROWANE.md).

> **Dioda 1N4007** równolegle do cewki K2 (zaciski 85–86), katodą do „+”.
> Przy **CC ≤ 8,0 A** można pominąć K2 i puścić prąd wprost przez styki
> modułu — wtedy przewody 7c–7e odpadają, a 7 idzie z **NO** modułu. Uwaga:
> 8,0 A to 80 % realnej obciążalności płytki XH-M603, czyli praca bez zapasu
> (§6.3 [`ZASILANIE_BUFOROWANE.md`](ZASILANIE_BUFOROWANE.md)).

> **Przekroje przy CC 8,0 A.** Wejście toru (przewody 1, 2, 3, 5, 6) niesie
> ~9,2 A: na 3 m przewodu 2,5 mm² to 0,39 V (2,8 %) — formalnie mieści się
> w kryterium 3 %, ale bez zapasu, dlatego w tabeli stoi **4 mm²** (0,24 V).
> Odcinek **ładowarka → szyna banku** (B i 7) bierz 4 mm² **zawsze**: jego
> spadek siedzi w pętli CV i opóźnia wejście w absorpcję. Uzasadnienie: §8.2
> [`ZASILANIE_BUFOROWANE.md`](ZASILANIE_BUFOROWANE.md), rachunek na przewody
> §3.1 [`WDROZENIE_TESTOWE.md`](WDROZENIE_TESTOWE.md).

Masy tego toru (K1 zacisk 85, „−” TVS/C1, boost **IN−** i **OUT−**, „−”
zasilania rozłącznika) idą do punktu gwiazdowego — §10.4. **Powrót boost
OUT− bierze ten sam przekrój co przewód B**, bo spadek pętli CV liczy się
na obu żyłach.

> **Dioda 1N4007** równolegle do cewki K1 (zaciski 85–86), katodą do „+”.
> Bez niej impuls samoindukcji cewki wraca w instalację przy każdym
> przekręceniu kluczyka.

#### Kierunki diod — sprawdź przed lutowaniem

| Element | Kierunek |
|---|---|
| **D5** — TVS 1.5KE33**CA** / SMCJ26**CA** | **bez znaczenia.** Sufiks „CA" = dwukierunkowa: nie ma anody ani katody, pasek na obudowie (jeśli w ogóle jest) nic nie znaczy |
| **D1** — MBR2545CT | **blaszka = katoda (pin 2)** → na **IN+** ładowarki. Anody (piny 1 i 3, zwarte) od strony **K1 zacisk 87** |
| **D6, D7** — 1N4007 | **pasek = katoda** → na zacisk **86** cewki, czyli po stronie plusa |

> **Pułapka przy zakupie TVS.** **1.5KE33A** (bez „C") to inna dioda —
> jednokierunkowa — i tam pasek musi iść na plus. Odwrotnie wlutowana jest
> zwarciem ~1 V na zasilaniu i **F1 idzie natychmiast**. Rozpoznasz miernikiem
> w trybie testu diody: **dwukierunkowa daje OL w obie strony**,
> jednokierunkowa ~0,7 V w jedną. Uzasadnienie: §5.4
> [`ZASILANIE_BUFOROWANE.md`](ZASILANIE_BUFOROWANE.md).

### 10.2 Bank, LVD, wyłącznik

| # | Skąd | Dokąd | Przewód | Zabezpieczenie |
|---|---|---|---|---|
| — | „+” każdego z **siedmiu** pakietów HR1221W | Szyna **„+”** banku, odczepy 1–7 | 1,5 mm² | **FB1…FB7** 10 A, osobno na pakiet |
| — | „−” każdego z siedmiu pakietów | Szyna **„−”** banku, odczepy 1–7 | 1,5 mm² | — |
| 8 | Szyna **„+”** banku, **odczep 1** | **XH-M609 VIN+** | 2,5 mm² | **F7** 15 A (MIDI/AMI lub ANL) |
| 9 | Szyna **„−”** banku, **odczep 7** | **XH-M609 VIN−** | 2,5 mm² | — |
| 10 | **XH-M609 VOUT+** | **S1** wyłącznik główny, zacisk 1 | 2,5 mm² | — |

Nasuwki **F2 6,35 mm** izolowane, zaciskane zaciskarką zapadkową.
Łączenie równoległe pakietów: [`ZASILANIE_BUFOROWANE.md`](ZASILANIE_BUFOROWANE.md) §4.3.

### 10.3 Odbiorniki — zasilane stale

| # | Skąd | Dokąd | Przewód | Zabezpieczenie |
|---|---|---|---|---|
| 11 | **S1** zacisk 2 (szyna odbiorników) | **XL6019 IN+** | 1,5 mm² | **F8** 7,5 A |
| 12 | **XL6019 OUT+** / **OUT−** | Wtyk M910q: środek „+”, ekran „−” | 1,5 mm² | — |
| 13 | **S1** zacisk 2 (szyna odbiorników) | **LM2596 IN+** | 1,5 mm² | **F9** 2 A |
| 14 | **LM2596 OUT+** / **OUT−** | Panel 7", złącze **PWM+** / **GND** | 1,5 mm² | — |

> **F8 to 7,5 A, nie 5 A.** Przy 45 W na wyjściu XL6019 i sprawności 85 %
> prąd wejściowy sięga 4,2 A przy 12,6 V i **4,6 A** przy napięciu banku
> bliskim progu LVD. Wkładka 5 A pracowałaby na krawędzi.

**Logika panelu i dotyk zostają na USB M910q** — osobno idzie wyłącznie
podświetlenie. Panel ma jeden kabel USB do komputera i jedno złącze
zasilania podświetlenia.

### 10.4 Wejścia optoizolowane — zapłon i bieg wsteczny

Rysunek: [`../schematics/schematic_test_signals.svg`](../schematics/schematic_test_signals.svg).
Przebiegi czasowe: [`../schematics/ignition_sense.svg`](../schematics/ignition_sense.svg).

**Płytką jest Arduino Nano** z `arduino/sensor_hub/sensor_hub.ino` — nie Pro
Micro. Pro Micro obsługuje SWC, enkoder i przyciski i do tej części nie jest
potrzebne. Piny poniżej odpowiadają `PIN_IGN 9` i `PIN_PWR_RELAY A0`
z firmware'u.

| # | Skąd | Dokąd | Przewód |
|---|---|---|---|
| 15 | Zapłon / ACC **12 V** | **R1** 2,2 kΩ / 0,25 W → **U1 (PC817)** pin **1** | 0,5 mm² |
| 16 | **U1** pin **2** | **Masa instalacji auta** — NIE punkt gwiazdowy | 0,5 mm² |
| 17 | **U1** pin **4** | Nano **D9** | 0,5 mm² |
| 18 | **U1** pin **3** | Nano **GND** | 0,5 mm² |
| 20 | Nano **D9** | **C3** 100 nF → Nano **GND** | 0,5 mm² |
| 15a | Światło cofania **12 V** | **R3** 2,2 kΩ / 0,25 W → **U2 (PC817)** pin **1** | 0,5 mm² |
| 16a | **U2** pin **2** | **Masa instalacji auta** — wspólnie z przewodem 16 | 0,5 mm² |
| 17a | **U2** pin **4** | Nano **D10** | 0,5 mm² |
| 18a | **U2** pin **3** | Nano **GND** | 0,5 mm² |
| 20a | Nano **D10** | **C4** 100 nF → Nano **GND** | 0,5 mm² |

Rezystory podciągające są zbędne — oba wejścia pracują jako `INPUT_PULLUP`.

> **Wejście biegu wstecznego wymaga jeszcze zmiany w firmwarze.** Sketch ma
> dziś `FEATURE_IGN` i `FEATURE_PWRBTN`, nie ma `FEATURE_REV`. Sam układ
> wejściowy jest kopią zapłonu, więc okablowanie możesz zrobić od razu.
> Sygnał bierz z obwodu świateł cofania — czujnik na skrzyni podaje 12 V,
> a lampa jest w tej samej kloszy, obok której i tak biegnie kabel kamery.

> **Przewody 16/16a i 18/18a celowo idą do różnych mas.** Na tym polega
> optoizolacja: po jednej stronie PC817 jest masa auta, po drugiej masa
> Arduino. Zwarcie ich niweczy cały sens układu i wpuszcza do komputera
> wszystko, co jeździ po linii ACC.

### 10.5 Sterowanie przyciskiem zasilania M910q

Arduino nie wysyła żadnego protokołu — po prostu **zwiera przycisk
zasilania**, a resztę robi acpid, który jest już skonfigurowany
(§7.3 [`WDROZENIE_M910Q.md`](WDROZENIE_M910Q.md)).

| # | Skąd | Dokąd | Przewód |
|---|---|---|---|
| 21 | Nano **A0** | Moduł przekaźnika **IN** | 0,5 mm² |
| 22 | Nano **5 V** / **GND** | Moduł przekaźnika **VCC** / **GND** | 0,5 mm² |
| 23 | Przekaźnik **COM** | Przycisk zasilania M910q, zacisk 1 | 0,5 mm² |
| 24 | Przekaźnik **NO** | Przycisk zasilania M910q, zacisk 2 | 0,5 mm² |
| 25 | **MP1584 OUT+** / **OUT−** | Nano **5 V** / **GND** | 0,75 mm² |

Styki przekaźnika idą **równolegle** do przycisku — przycisk dalej działa
normalnie i zostaje ratunkiem awaryjnym.

| Impuls na A0 | Efekt |
|---|---|
| **250 ms** przy pracy | uśpienie do S3 |
| **250 ms** w S3 | wybudzenie w ~3 s |
| **250 ms** po wyłączeniu | start (zimny, ~40 s) |
| **5 s** | twarde wyłączenie — pobór spada do ~80–120 mA |

> **Przetnij żyłę VBUS (czerwoną) w kablu USB do Nano.** Płytka jest
> zasilana z MP1584 (przewód 25) i musi żyć, gdy M910q śpi — a wtedy port USB
> jest martwy. Dwa źródła 5 V zwarte razem to niepotrzebne ryzyko; dane po USB
> działają bez VBUS.

> **Zaciski przycisku znajdź miernikiem** w trybie ciągłości, przy maszynie
> odłączonej od zasilania: rozwarte, zwarte przy wciśnięciu.

### 10.6 Punkt gwiazdowy masy

Lądują na nim: „−” akumulatora rozruchowego, „−” TVS/C1, zacisk **85** K1,
**IN−** i **OUT−** boostu, „−” zasilania rozłącznika nadnapięciowego, szyna
**„−”** banku, **VIN−** i **VOUT−** modułu XH-M609, **IN−** przetwornic
XL6019, LM2596 i MP1584.

**Jedyny wyjątek:** masa wejść optoizolowanych (**U1 pin 2** i **U2 pin 2**,
przewody 16 i 16a) idzie do masy instalacji auta.

### 10.7 Kolejność podłączania

```
1. S1 rozwarty, bank odłączony, F1 wyjęty z oprawki.
2. Nastawy na zasilaczu laboratoryjnym — wszystkie pięć:
   XL6019 19,5 V · LM2596 wg panelu · boost 14,40 V / 8 A
   rozłącznik 15,30 V · XH-M609 11,00 / 12,60 V
3. Punkt gwiazdowy masy — komplet z §10.5.
4. Bank (7 pakietów) na szynach zbiorczych, bezpieczniki FB1…FB7, pomiar
   napięcia na szynie. Odbiór po przekątnej — §4.3 ZASILANIE_BUFOROWANE.
5. Przewody 8, 9, 10 — bank przez F7 do LVD i S1.
6. Przewody 11 i 12 — XL6019. POMIAR 19,5 V BEZ podłączonego M910q.
7. Dopiero teraz M910q, potem 13–14 (podświetlenie).
8. Na końcu przewody 1–7 i B — tor ładowania, przy zgaszonym silniku.
9. Rozruch silnika, pomiar prądu ładowania cęgami lub bocznikiem.
```

Punkt 6 pomijany „bo przecież ustawiałem" to najczęstszy sposób na zabicie
płyty głównej. Punkt 8 pomijany — na zabicie banku.

---

## 11. Wyświetlacz pomocniczy 1,8" na ESP32

Rysunek: [`esp32_display_wiring.svg`](../schematics/esp32_display_wiring.svg)
(generator `schematics/gen_esp32_display.py` — po zmianie tabel poniżej popraw
generator i wygeneruj SVG ponownie, nie edytuj SVG ręcznie). Projekt ekranów,
protokół i budżet poboru: [`WYSWIETLACZ_ESP32_1V8.md`](WYSWIETLACZ_ESP32_1V8.md).

> **Oznaczenia elementów (U1–U10, D1, F12, M8, A5, DS3) należą do tego
> podukładu.** Arkusze wariantu testowego (§ 10) mają własną numerację —
> tamtejsze `U1`/`U2` to transoptory zapłonu i biegu wstecznego, a `D1` to
> dioda MBR2545CT w torze ładowania.

Panel **ST7735 128 × 160 px zamontowany pionowo**, sterowany z **ESP32-S3**.
Dwa niezależne źródła danych: dziesięć sygnałów 12 V wprost z auta (przez
PC817) oraz metadane muzyki i tempomatu z M910q po USB. Dzięki temu ekran
otwartego nadwozia działa także wtedy, gdy komputer jeszcze wstaje albo już śpi.

### 11.1 Dziesięć wejść 12 V przez PC817

Stopień wejściowy jest **identyczny dla wszystkich dziesięciu sygnałów** i jest
już opisany w § 3.1 (sygnał → 4,7 kΩ → PC817 pin 1, pin 2 → masa pojazdu,
pin 4 → GPIO w `INPUT_PULLUP`, pin 3 → masa ESP32). Zmienia się wyłącznie pin
docelowy:

| Oznaczenie | Sygnał | Skąd w aucie | Pin ESP32-S3 | Ekran |
|---|---|---|---|---|
| U1 | ABS | złącze fabrycznego wyświetlacza | **GPIO4** | 1 |
| U2 | Hamulec ręczny | wyłącznik dźwigni | **GPIO5** | 1 |
| U3 | Poduszka (SRS) | złącze fabrycznego wyświetlacza | **GPIO6** | 1 |
| U4 | Immobilizer | złącze fabrycznego wyświetlacza | **GPIO7** | 1 |
| U5 | Maska | wyłącznik maski | **GPIO1** | 2 |
| U6 | Drzwi przód lewe | krańcówka oświetlenia wnętrza | **GPIO15** | 2 |
| U7 | Drzwi przód prawe | j.w. | **GPIO16** | 2 |
| U8 | Drzwi tył lewe | j.w. | **GPIO17** | 2 |
| U9 | Drzwi tył prawe | j.w. | **GPIO18** | 2 |
| U10 | Klapa bagażnika | wyłącznik klapy | **GPIO2** | 2 |

Kolejność U1–U10 jest **kontraktem firmware'u** — odpowiada wyliczeniu
`InputId` w `arduino/esp32_display/state.h` oraz tablicom `TELLTALES[]`
i `PANELS[]` w `arduino/esp32_display/assets.h`. Stan aktywny to **LOW**,
debounce **30 ms**.

> **GPIO ESP32-S3 są 3,3 V i nie tolerują nawet 5 V**, o 12 V nie wspominając,
> a instalacja samochodowa potrafi wypuścić impulsy grubo powyżej 40 V.
> Optoizolacja z § 3.1 jest obowiązkowa, a każde wejście zasługuje dodatkowo
> na **TVS (SMBJ24A) po stronie pojazdu**, przed rezystorem 4,7 kΩ.

> **Polaryzacji nie zakładaj — zmierz.** Krańcówki drzwi w autach tej epoki
> zwykle **zwierają do masy** (12 V przy zamkniętych, 0 V przy otwartych),
> czyli działają odwrotnie niż sterowana plusem lampka. Linia zwierana do masy
> nie potrzebuje PC817 — wchodzi wprost na pin, tak jak w § 3.3. Dla każdego
> z dziesięciu sygnałów sprawdź miernikiem: napięcie w spoczynku, w stanie
> aktywnym i czy linia źródłuje prąd, czy go zwiera.

> **ABS i poduszka to dwie najmniej pewne pozycje** — w wielu wersjach rysują
> je zegary z własnej magistrali i nie podają dalej na złącze. Jeśli ich tam
> nie ma, zostaje wzięcie ich z BCM albo rezygnacja z tych dwóch lampek.

### 11.2 Panel ST7735 po SPI

| ESP32-S3 | Panel ST7735 | Uwagi |
|---|---|---|
| **GPIO12** | SCL / SCK | zegar SPI |
| **GPIO11** | SDA / MOSI | dane |
| **GPIO10** | CS | wybór układu |
| **GPIO13** | DC / A0 | dane ↔ komenda |
| **GPIO14** | RST / RES | reset panelu |
| **GPIO21** | BLK / LED | podświetlenie, PWM przez LEDC |
| **3V3** | VCC | moduł ze stabilizatorem AMS1117 zasilaj 5 V |
| **GND** | GND | masa ESP32 — nie masa pojazdu |

Kolejność pinów **na module bywa różna** (najczęściej LED, SCK, SDA, A0, RESET,
CS, GND, VCC) — czytaj opisy na płytce, nie kolejność z tabeli. Część modułów
ma BLK zwarty do VCC; wtedy ściemnianie wymaga przecięcia ścieżki albo małego
tranzystora. Sygnały sterujące zawsze 3,3 V, także na module 5-woltowym.

W `TFT_eSPI` panel opisuje `User_Setup` z `ST7735_DRIVER`, `TFT_WIDTH 128`,
`TFT_HEIGHT 160` i powyższymi pinami; obrót do pionu robi firmware.

### 11.3 Zasilanie i USB

| Skąd | Dokąd | Uwagi |
|---|---|---|
| **+15** (po zapłonie), listwa ATO — *albo* szyna buforowana za LVD i S1 | bezpiecznik **2 A** | § 6; wybór źródła jest otwarty — patrz ramka niżej |
| bezpiecznik 2 A | buck 12 V → 5 V, **IN+** | MP1584, jak M6 w § 10 |
| buck **IN−** | punkt gwiazdowy masy | § 7 |
| buck **OUT+** | ESP32-S3 **5V** | ~60 mA z 12 V przy pracy |
| buck **OUT−** | ESP32-S3 **GND** + punkt gwiazdowy | |
| ESP32-S3, **natywne** gniazdo USB-C | port USB M910q (przez hub, § 5.3) | `/dev/ttyACM_display` |

> **Żyła VBUS w kablu USB musi być przecięta**, jeśli moduł ma własne
> zasilanie. Dwa źródła 5 V — buck i port M910q — nie mogą pracować na jedną
> szynę. Masa (GND) w kablu **zostaje połączona**: bez wspólnego punktu
> odniesienia transmisja nie ma sensu.

> **Skąd wziąć te 12 V — decyzja otwarta.** W wariancie testowym **+15**
> zeruje pobór na postoju i tak jest tu narysowane. W wersji **docelowej**
> zapłon nie jest już źródłem zasilania, tylko sygnałem
> ([`ZASILANIE_BUFOROWANE.md`](ZASILANIE_BUFOROWANE.md) §2), więc panel
> powinien wisieć na **szynie buforowanej za LVD i S1**. Przy banku siedmiu
> pakietów (35,7 Ah) kosztuje to 24–43 % czasu postoju: 5,3–3,0 dnia zamiast
> 9,3–4,0. Rachunek i warunki:
> [`WYSWIETLACZ_ESP32_1V8.md`](WYSWIETLACZ_ESP32_1V8.md), sekcja „Czy można
> wpiąć na stałe do akumulatora", wariant 4. Elektrycznie zmienia się tylko
> to, do którego zacisku podpinasz wejście bucka.

> **Na płytkach z dwoma gniazdami USB-C** jedno idzie do natywnego USB
> ESP32-S3, a drugie do mostka UART (CH343/CP2102). Protokół chodzi po
> **natywnym** — to ono zgłasza się jako `303a:1001` i to jego łapie reguła
> udev `config/udev/99-bcm-esp32-display.rules`.

Wariant alternatywny — zasilanie **wprost z USB**, bez bucka i bezpiecznika:
jeden kabel, zero poboru na postoju, ale ekran wstaje dopiero razem z M910q,
więc kontrolki bezpieczeństwa pojawiają się z opóźnieniem całego bootu.
Porównanie obu: [`WYSWIETLACZ_ESP32_1V8.md`](WYSWIETLACZ_ESP32_1V8.md)
§ Zasilanie i pobór.

### 11.4 Piny, których nie wolno użyć

| Piny | Dlaczego |
|---|---|
| 0, 3, 45, 46 | strapping — stan przy resecie decyduje o trybie startu |
| 19, 20 | natywne USB (D−/D+), czyli cały protokół z BCM |
| 26–37 | flash i PSRAM modułu (N16R8) |

Pozostałe wolne piny są do dyspozycji, ale zestaw z § 11.1 i § 11.2 jest
kontraktem — te same numery siedzą w firmwarze i w generatorze schematu.

---

## Powiązane dokumenty

| Dokument | Zakres |
|---|---|
| [`ZASILANIE_BUFOROWANE.md`](ZASILANIE_BUFOROWANE.md) | dobór podzespołów, nastawy, lista zakupowa, procedura rozruchu |
| [`WDROZENIE_M910Q.md`](WDROZENIE_M910Q.md) | pełne wdrożenie: sprzęt, BIOS, OS, usługi, odbiór |
| [`ARDUINO_SETUP_GUIDE.md`](ARDUINO_SETUP_GUIDE.md) | wgrywanie firmware, kalibracja SWC, pełne tabele pinów |
| [`KLINE_SNIFFING.md`](KLINE_SNIFFING.md) | podsłuch K-Line, poznawanie PID-ów ECU |
| [`WYSWIETLACZ_ESP32_1V8.md`](WYSWIETLACZ_ESP32_1V8.md) | wyświetlacz pomocniczy 1,8": ekrany, protokół, firmware, pobór |
| [`../schematics/README.md`](../schematics/README.md) | indeks wszystkich schematów |
