geek95dg/Alfa156-headunit/mockups/156_mockups.pdf

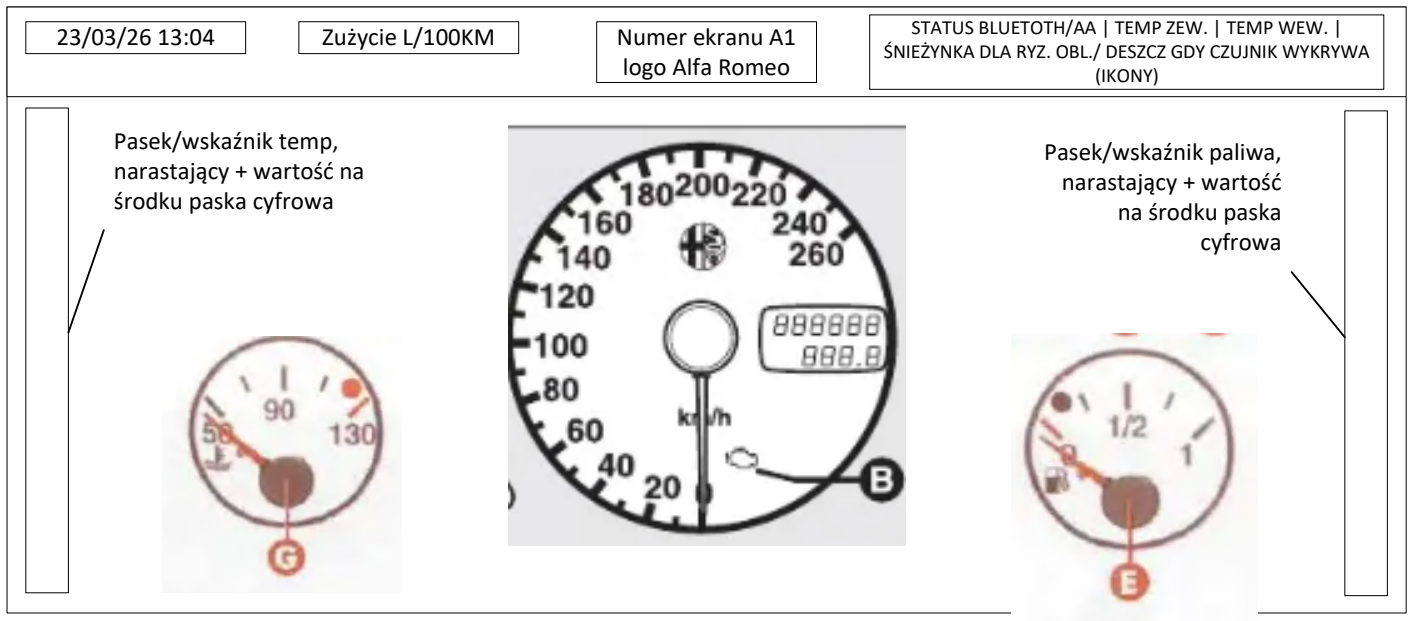
[picture p3: figure]
Numer ekranu A1; logo Alfa Romeo; Zużycie L/100KM; (IKONY); Pasek/wskaźnik temp, narastający + wartość na środku paska cyfrowa; Pasek/wskaźnik paliwa, narastający + wartość na środku paska cyfrowa
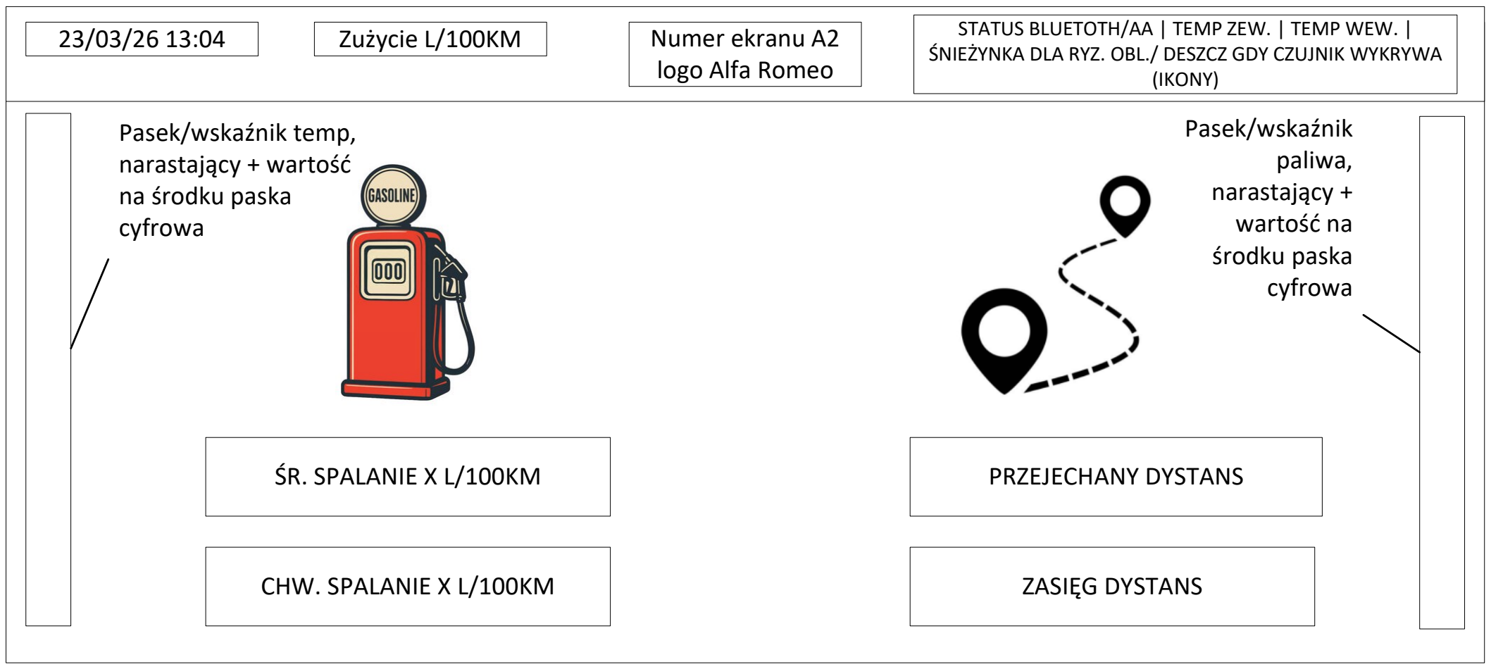
[picture p4: figure]
Numer ekranu A2; logo Alfa Romeo; Zużycie L/100KM; ŚR. SPALANIE X L/100KM; CHW. SPALANIE X L/100KM; PRZEJECHANY DYSTANS; ZASIĘG DYSTANS; (IKONY); Pasek/wskaźnik temp, narastający + wartość na środku paska cyfrowa; Pasek/wskaźnik paliwa, narastający + wartość na środku paska cyfrowa
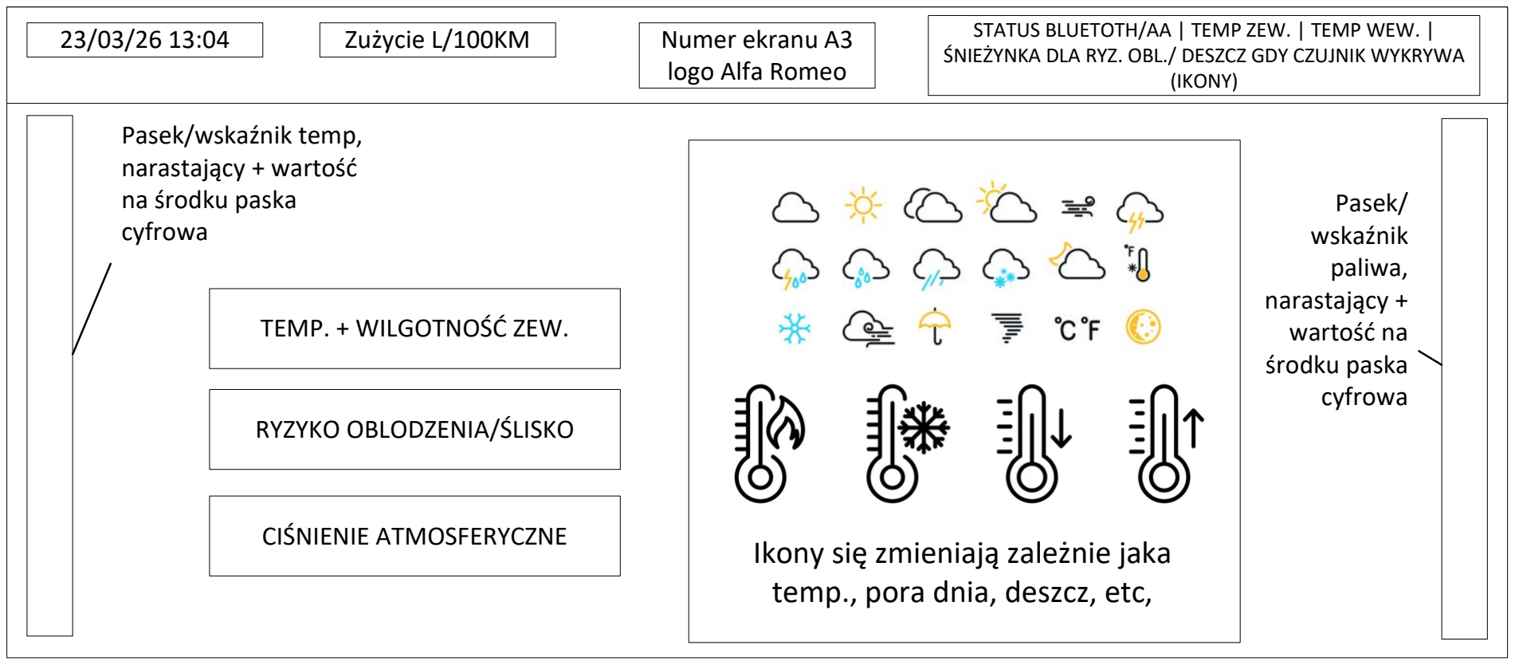
[picture p5: figure]
Numer ekranu A3; logo Alfa Romeo; (IKONY); Zużycie L/100KM; TEMP. + WILGOTNOŚĆ ZEW.; RYZYKO OBLODZENIA/ŚLISKO; CIŚNIENIE ATMOSFERYCZNE; Ikony się zmieniają zależnie jaka temp., pora dnia, deszcz, etc,; Pasek/wskaźnik temp, narastający + wartość na środku paska cyfrowa; Pasek/ wskaźnik paliwa, narastający + wartość na środku paska cyfrowa

STATUS BLUETOTH/AA | TEMP ZEW. | TEMP WEW. |
ŚNIEŻYNKA DLA RYZ. OBL./ DESZCZ GDY CZUJNIK WYKRYWA
STATUS BLUETOTH/AA | TEMP ZEW. | TEMP WEW. |
ŚNIEŻYNKA DLA RYZ. OBL./ DESZCZ GDY CZUJNIK WYKRYWA
STATUS BLUETOTH/AA | TEMP ZEW. | TEMP WEW. |
ŚNIEŻYNKA DLA RYZ. OBL./ DESZCZ GDY CZUJNIK WYKRYWA

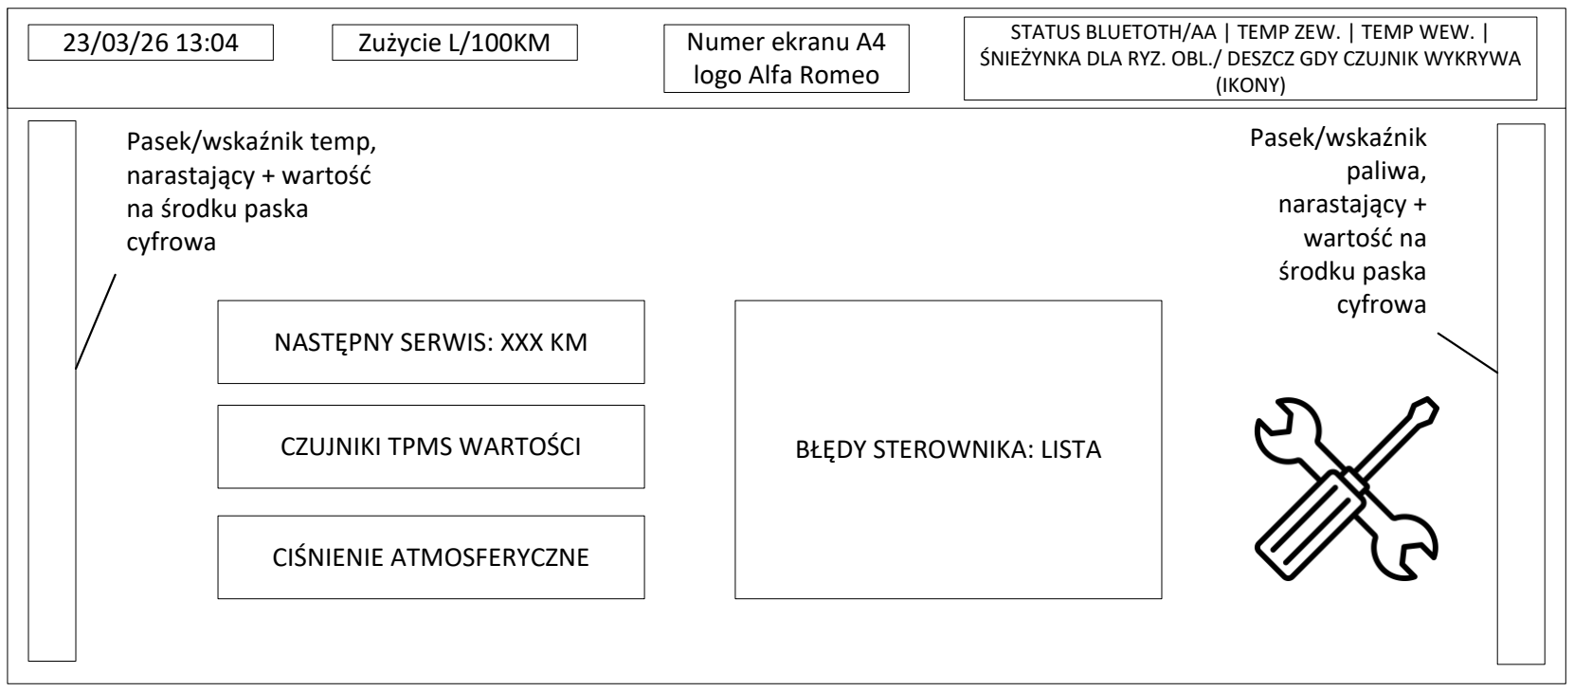
[picture p6: figure]
Numer ekranu A4; logo Alfa Romeo; (IKONY); Zużycie L/100KM; NASTĘPNY SERWIS: XXX KM; CZUJNIKI TPMS WARTOŚCI; CIŚNIENIE ATMOSFERYCZNE; BŁĘDY STEROWNIKA: LISTA; Pasek/wskaźnik temp, narastający + wartość na środku paska cyfrowa; Pasek/wskaźnik paliwa, narastający + wartość na środku paska cyfrowa

STATUS BLUETOTH/AA | TEMP ZEW. | TEMP WEW. |
ŚNIEŻYNKA DLA RYZ. OBL./ DESZCZ GDY CZUJNIK WYKRYWA
