geek95dg/Alfa156-headunit/mockups/detailed_technical_pencil_and_graphite_sketch_of_an_alfa_romeo_156_berlina_from.png

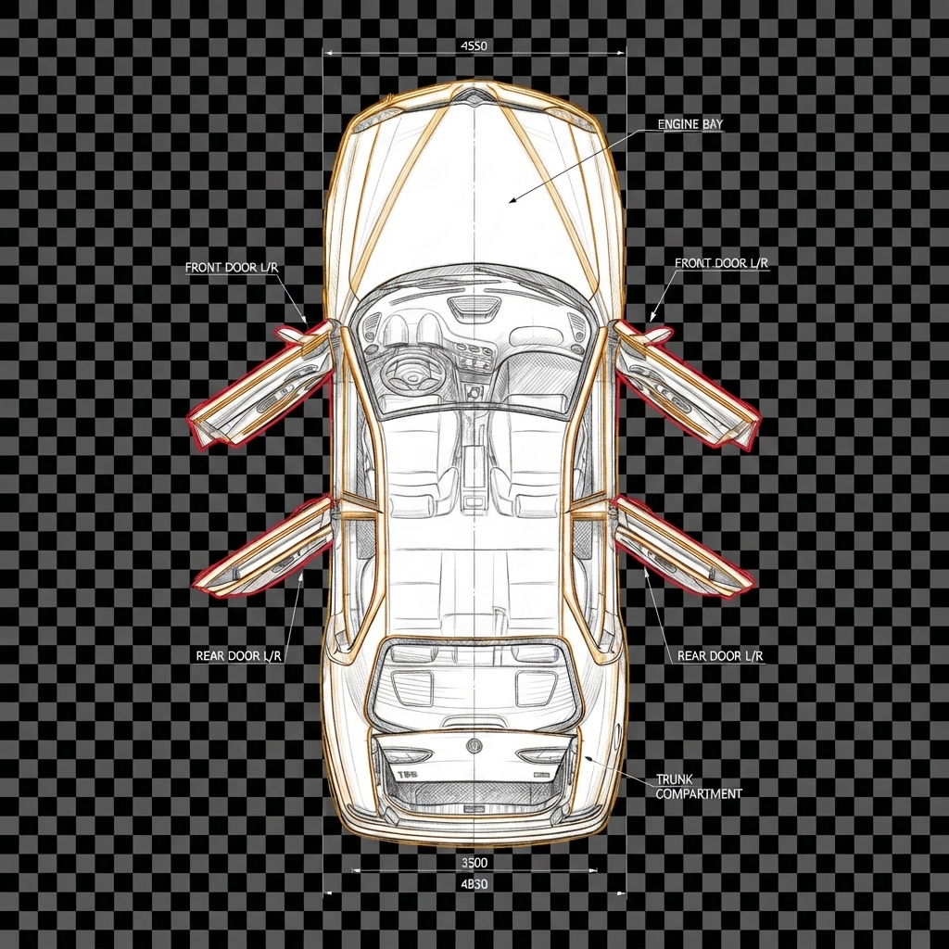
mockups/detailed_technical_pencil_and_graphite_sketch_of_an_alfa_romeo_156_berlina_from.png
