geek95dg/Alfa156-headunit/mockups/esp32_1v8/assets_preview.png

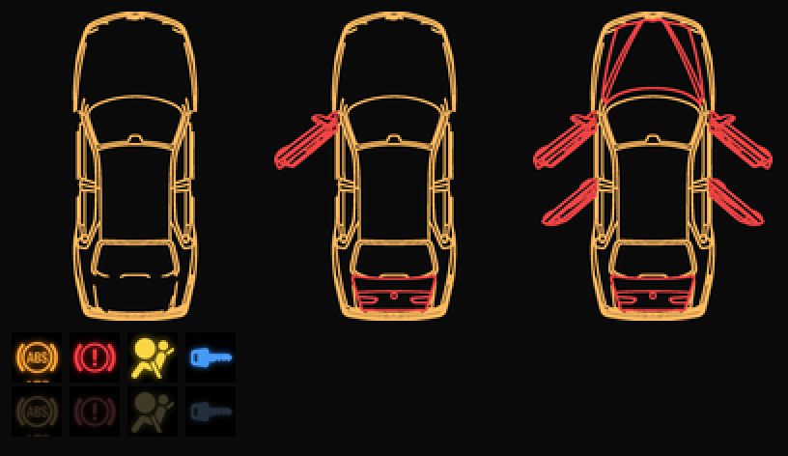
mockups/esp32_1v8/assets_preview.png
