geek95dg/Alfa156-headunit/mockups/renders/a1_main_heritage.png

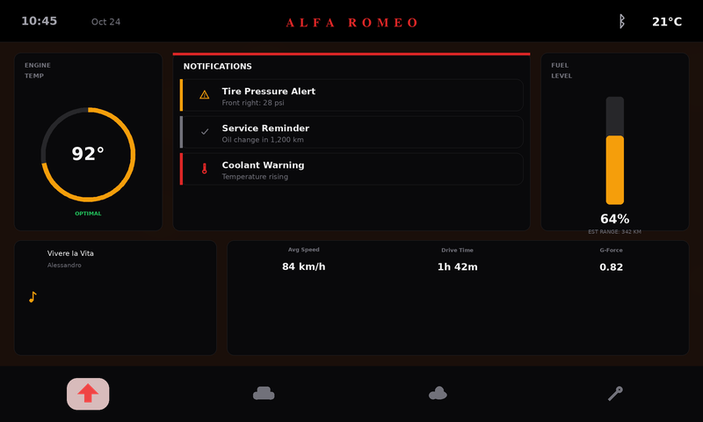
mockups/renders/a1_main_heritage.png
