geek95dg/Alfa156-headunit/mockups/renders/a1_main_modern.png

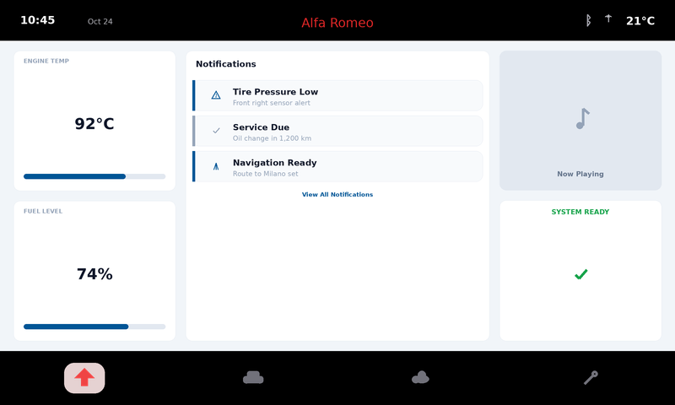
mockups/renders/a1_main_modern.png
