geek95dg/Alfa156-headunit/mockups/renders/a2_trip_autodelta.png

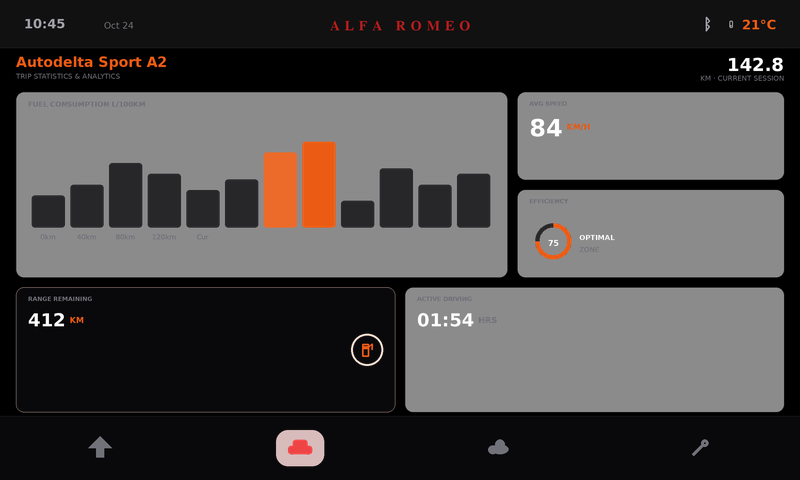
mockups/renders/a2_trip_autodelta.png
