geek95dg/Alfa156-headunit/mockups/renders/a2_trip_modern.png

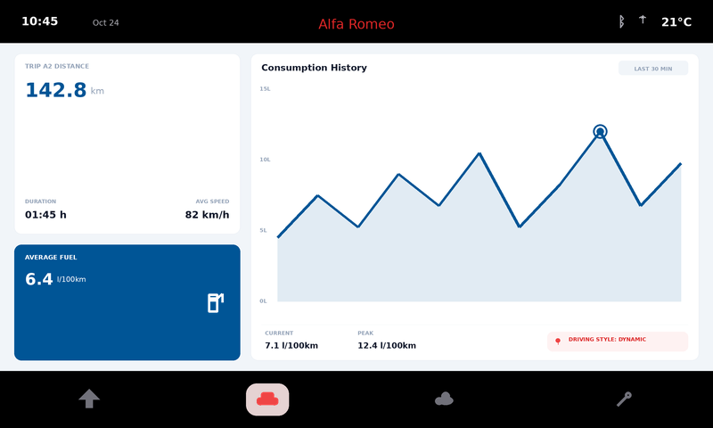
mockups/renders/a2_trip_modern.png
