geek95dg/Alfa156-headunit/mockups/renders/a3_weather_autodelta.png

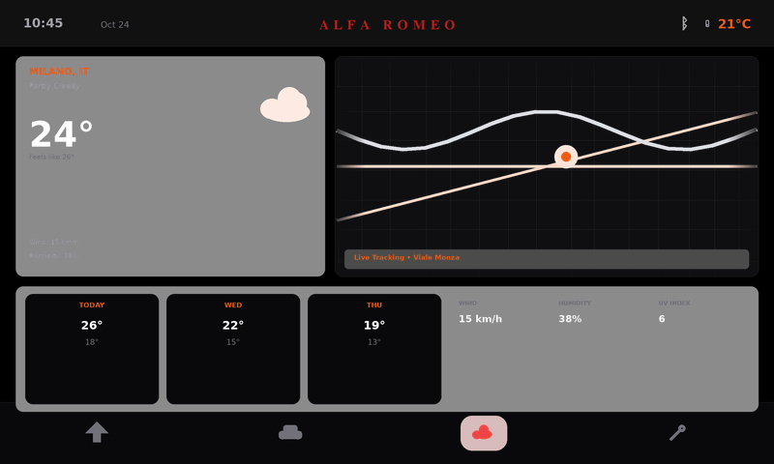
mockups/renders/a3_weather_autodelta.png
