geek95dg/Alfa156-headunit/mockups/renders/a4_service_autodelta.png

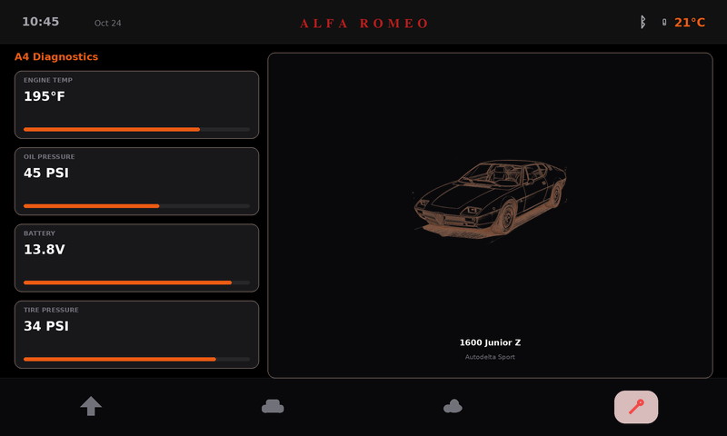
mockups/renders/a4_service_autodelta.png
