geek95dg/Alfa156-headunit/mockups/renders/a4_service_heritage.png

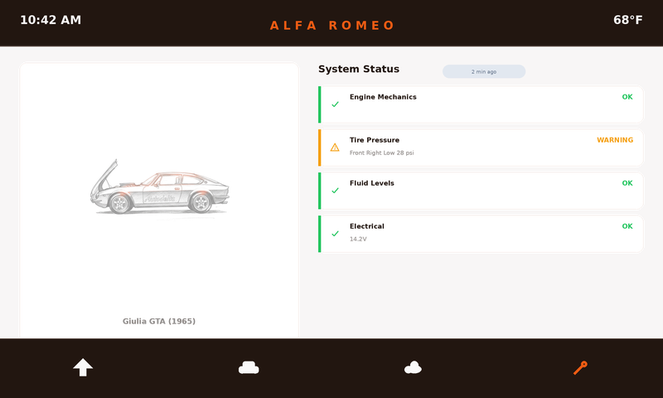
mockups/renders/a4_service_heritage.png
