geek95dg/Alfa156-headunit/mockups/renders/init_autodelta.png

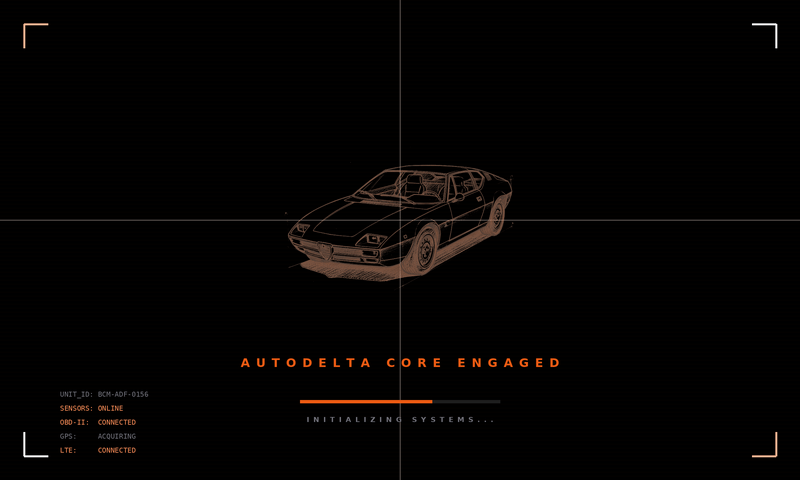
mockups/renders/init_autodelta.png
