geek95dg/Alfa156-headunit/mockups/renders/init_modern.png

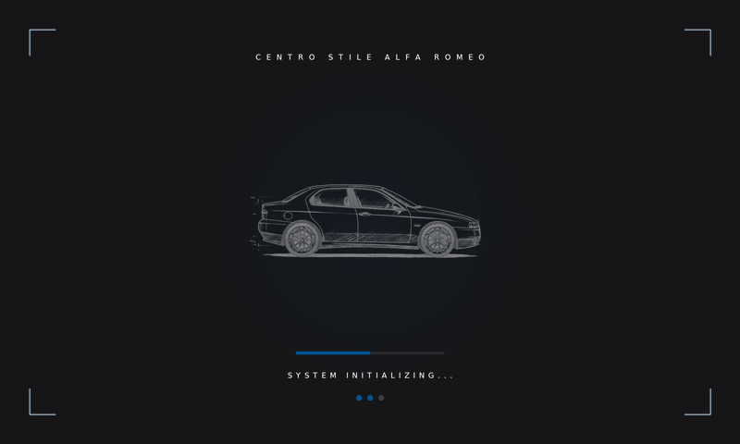
mockups/renders/init_modern.png
