geek95dg/Alfa156-headunit/mockups/renders/mockup_a1_dashboard_classic_alfa.png

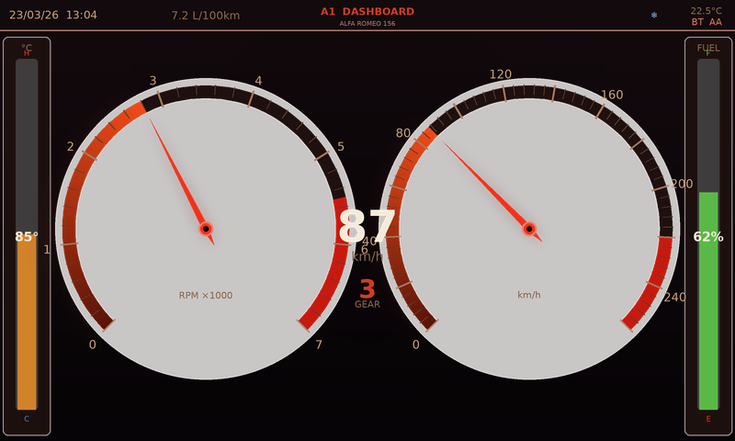
mockups/renders/mockup_a1_dashboard_classic_alfa.png
