geek95dg/Alfa156-headunit/mockups/renders/mockup_a2_consumption_classic_alfa.png

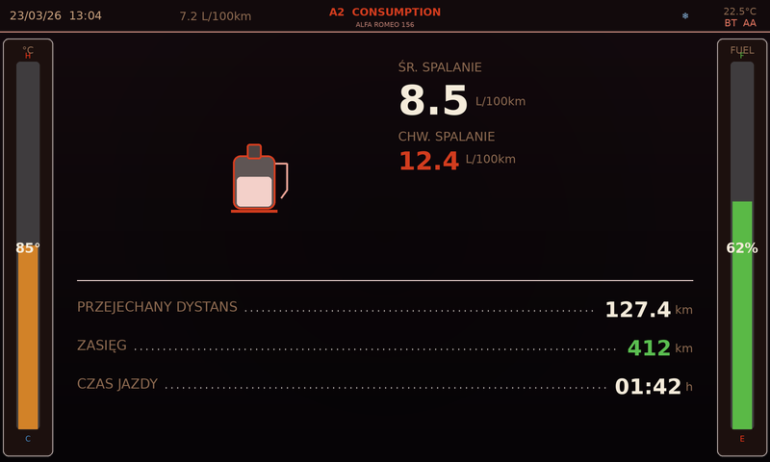
mockups/renders/mockup_a2_consumption_classic_alfa.png
