geek95dg/Alfa156-headunit/mockups/renders/mockup_a2_consumption_modern_dark.png

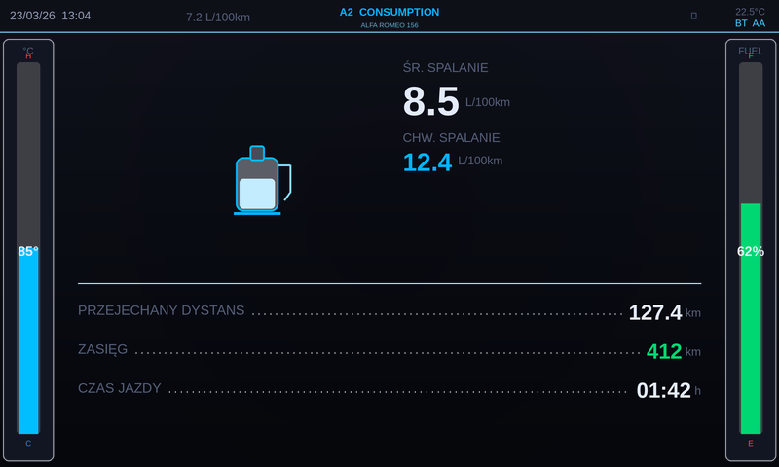
mockups/renders/mockup_a2_consumption_modern_dark.png
