geek95dg/Alfa156-headunit/mockups/renders/mockup_a2_consumption_oem_digital.png

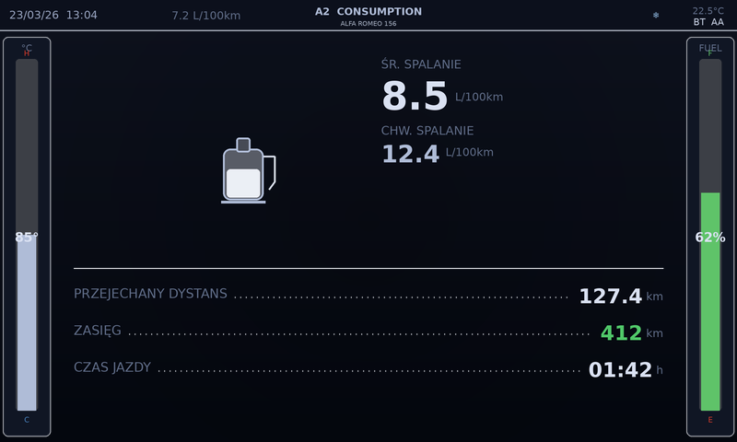
mockups/renders/mockup_a2_consumption_oem_digital.png
