geek95dg/Alfa156-headunit/mockups/renders/mockup_a3_environment_classic_alfa.png

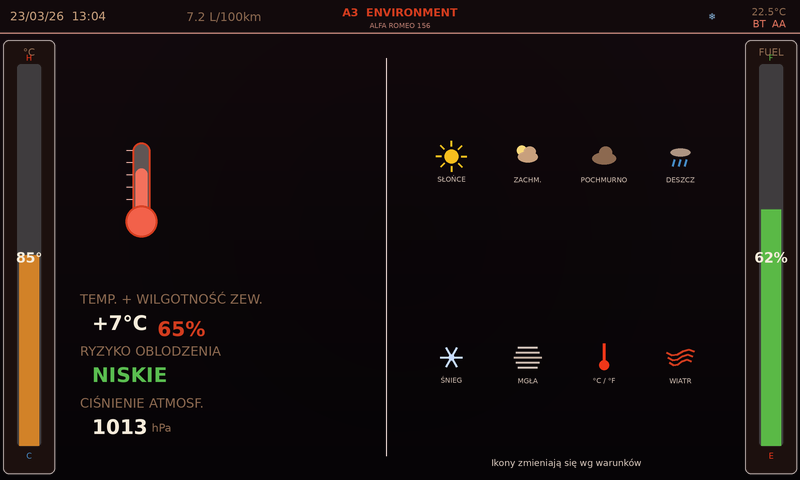
mockups/renders/mockup_a3_environment_classic_alfa.png
