geek95dg/Alfa156-headunit/mockups/renders/mockup_a3_environment_modern_dark.png

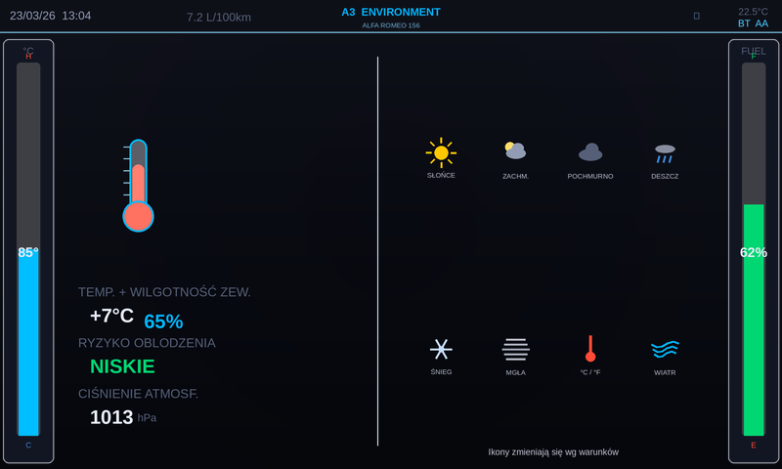
mockups/renders/mockup_a3_environment_modern_dark.png
