geek95dg/Alfa156-headunit/mockups/renders/mockup_a3_environment_oem_digital.png

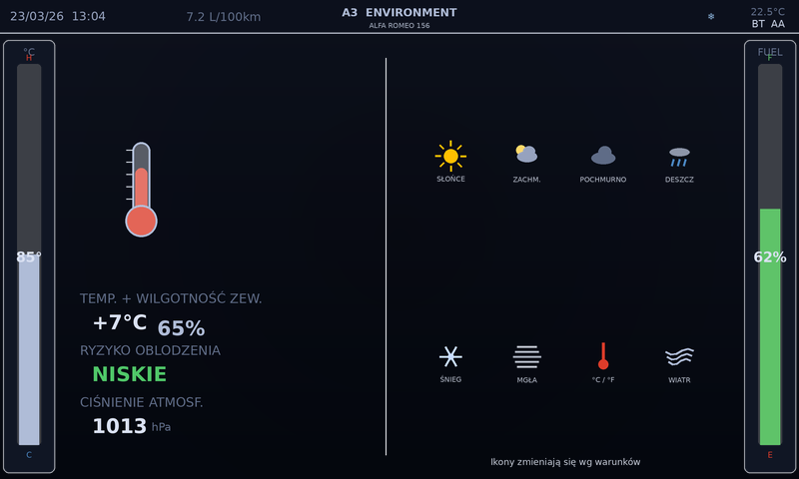
mockups/renders/mockup_a3_environment_oem_digital.png
