geek95dg/Alfa156-headunit/mockups/renders/mockup_a4_service_classic_alfa.png

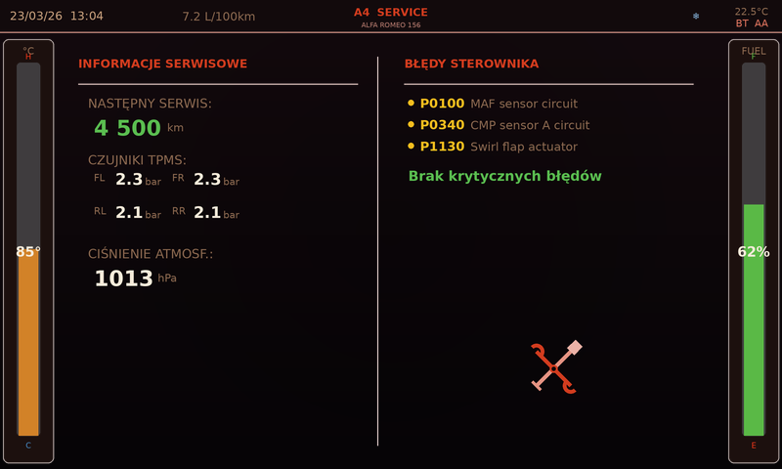
mockups/renders/mockup_a4_service_classic_alfa.png
