geek95dg/Alfa156-headunit/mockups/renders/mockup_a4_service_modern_dark.png

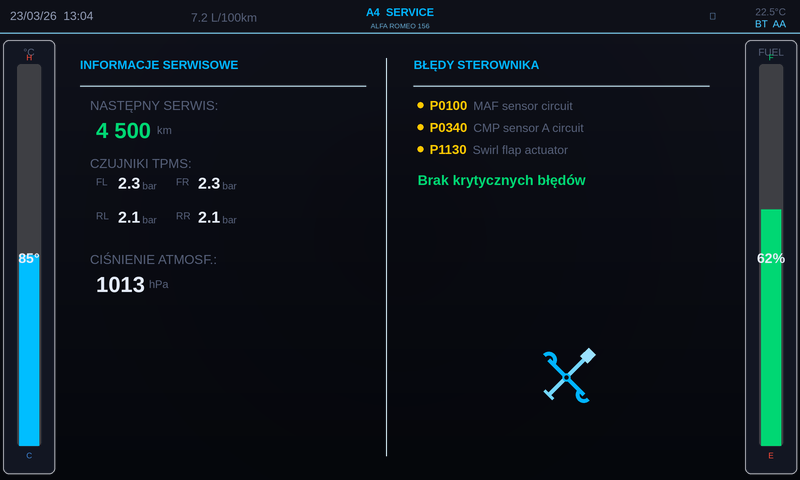
mockups/renders/mockup_a4_service_modern_dark.png
