geek95dg/Alfa156-headunit/mockups/screen (1).png

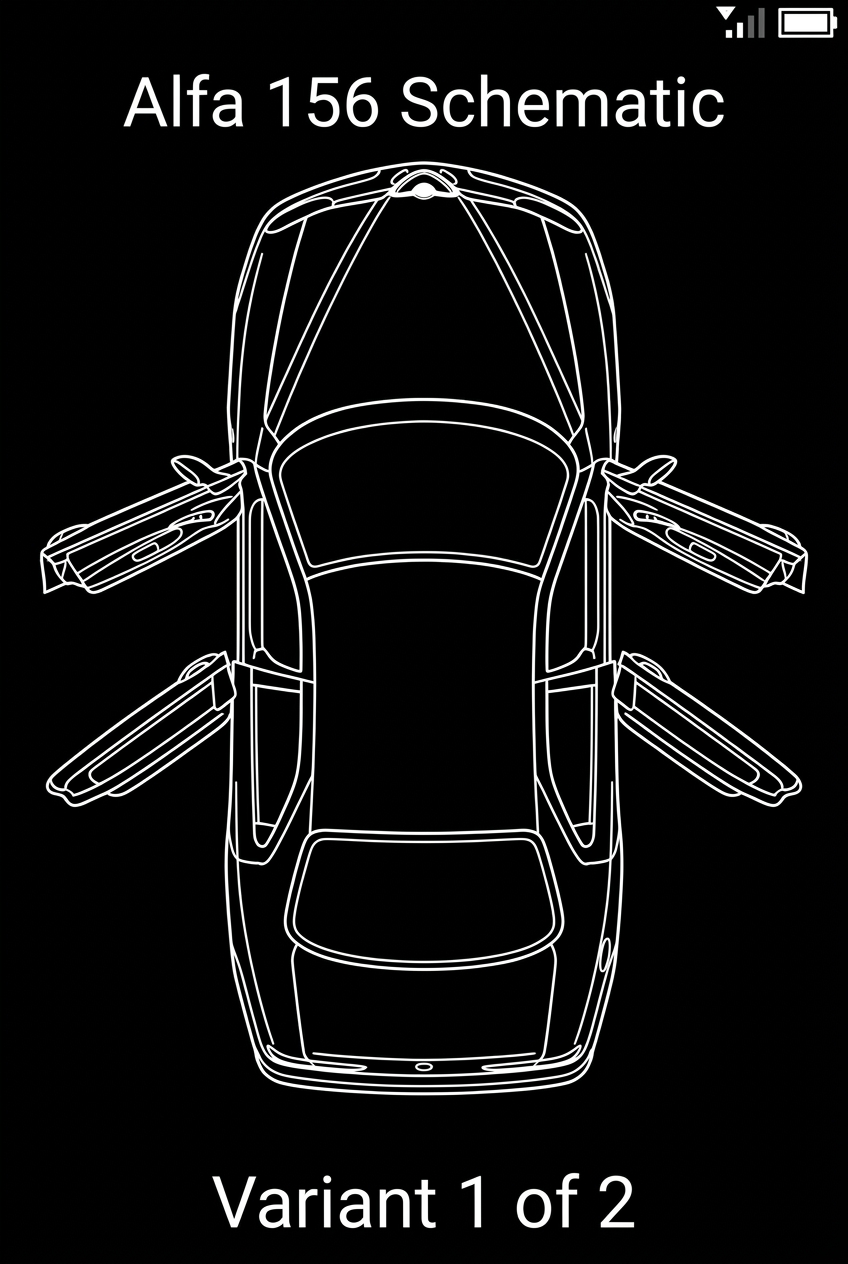
mockups/screen (1).png
