geek95dg/Alfa156-headunit/mockups/screen (2).png

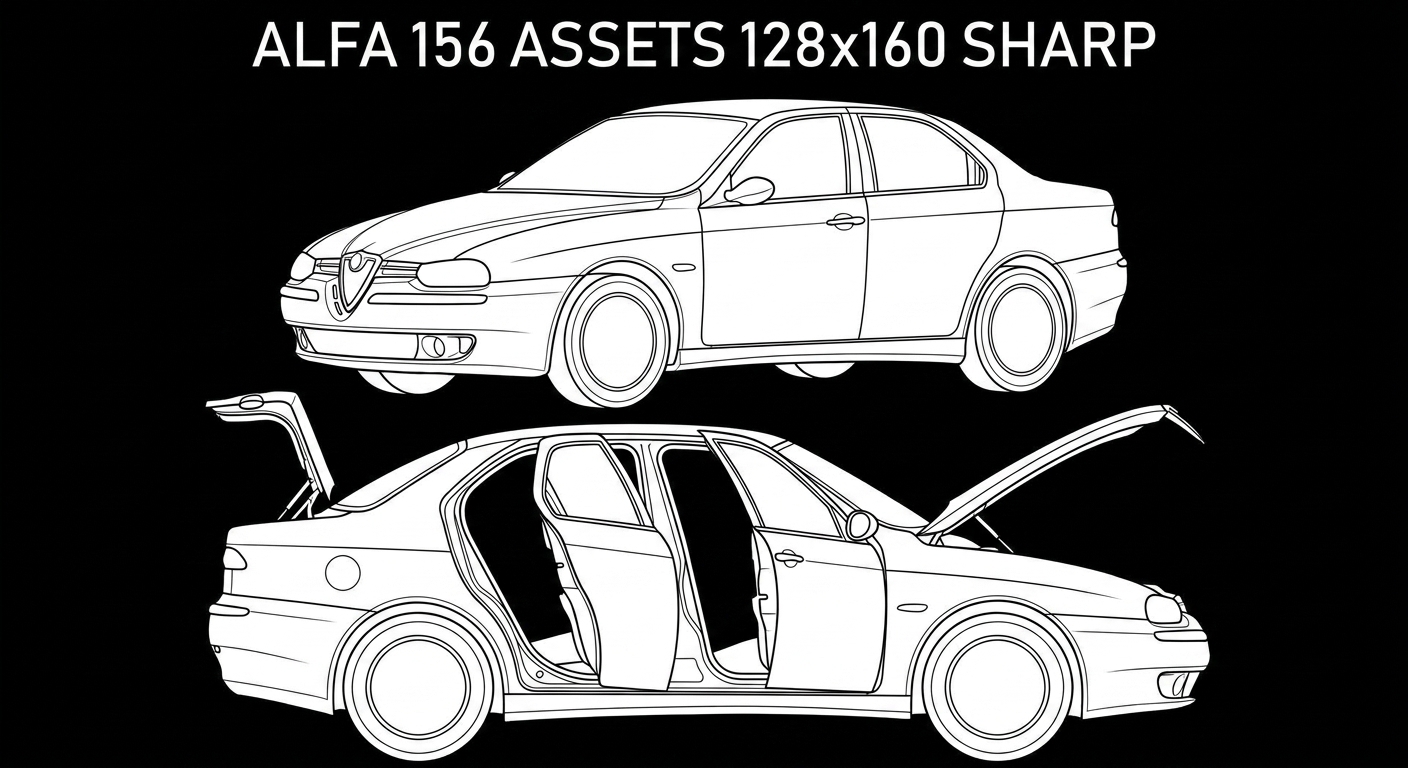
mockups/screen (2).png
