geek95dg/Alfa156-headunit/mockups/screen (3).png

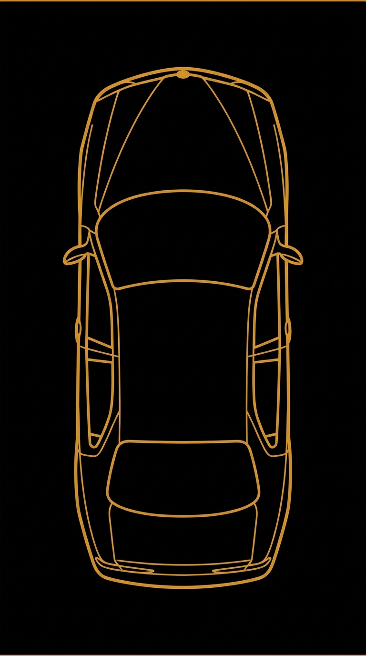
mockups/screen (3).png
