geek95dg/Alfa156-headunit/mockups/screen (4).png

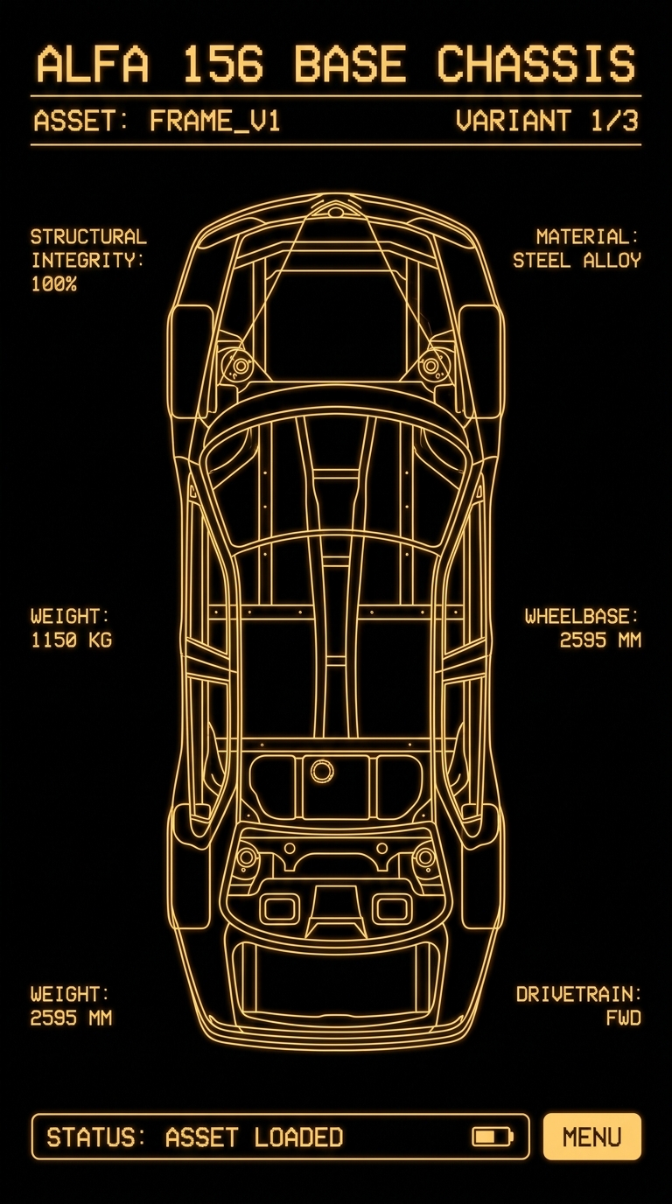
mockups/screen (4).png
