geek95dg/Alfa156-headunit/mockups/screen (5).png

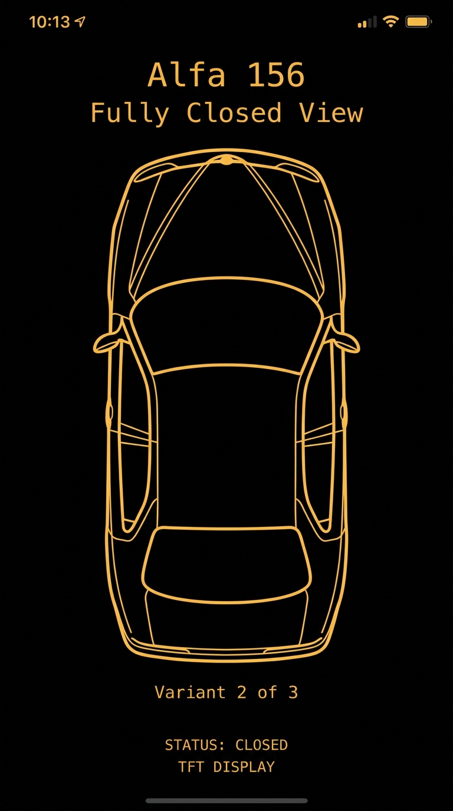
mockups/screen (5).png
