geek95dg/Alfa156-headunit/mockups/screen (6).png

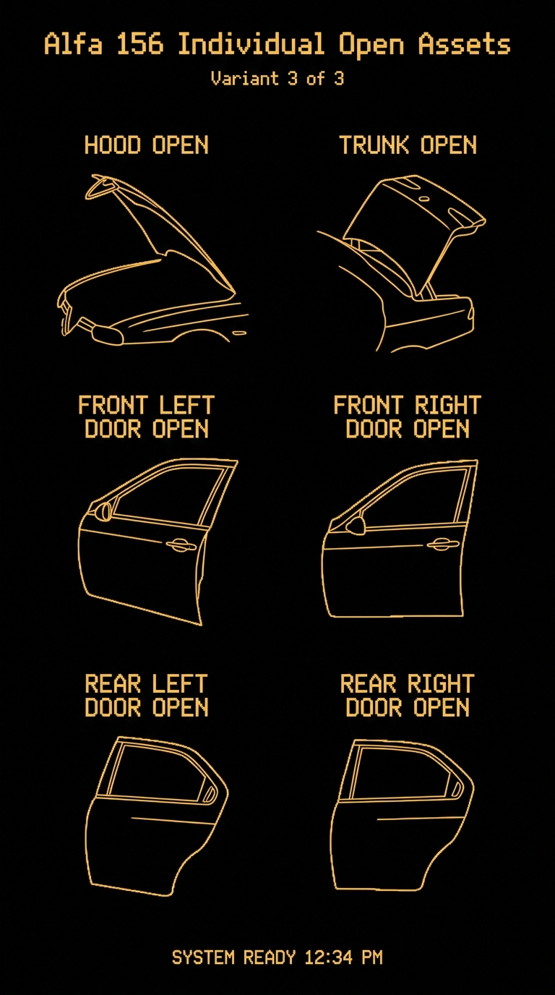
mockups/screen (6).png
