geek95dg/Alfa156-headunit/mockups/screen (7).png

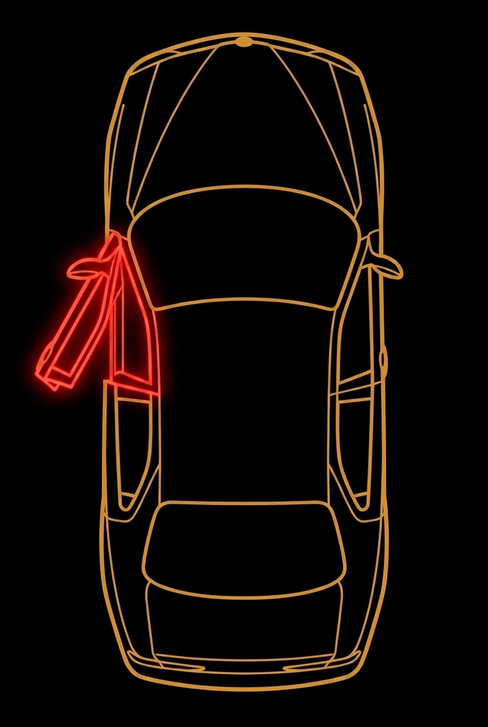
mockups/screen (7).png
