geek95dg/Alfa156-headunit/mockups/screen (8).png

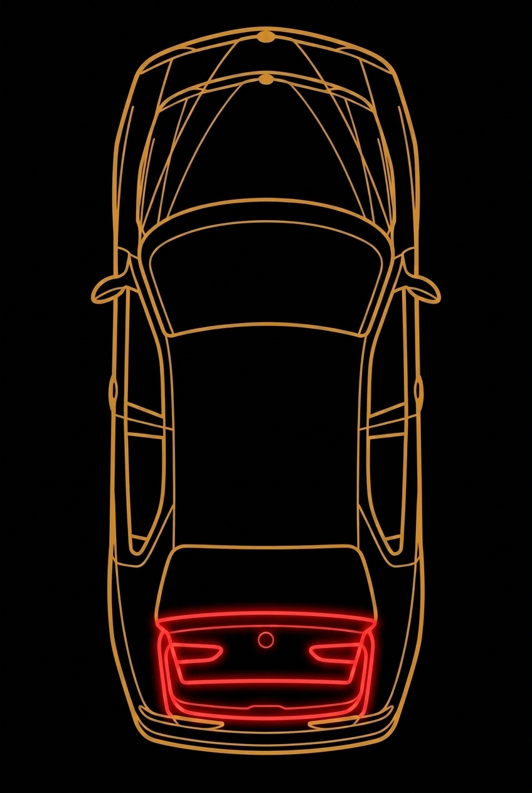
mockups/screen (8).png
