geek95dg/Alfa156-headunit/mockups/screen (9).png

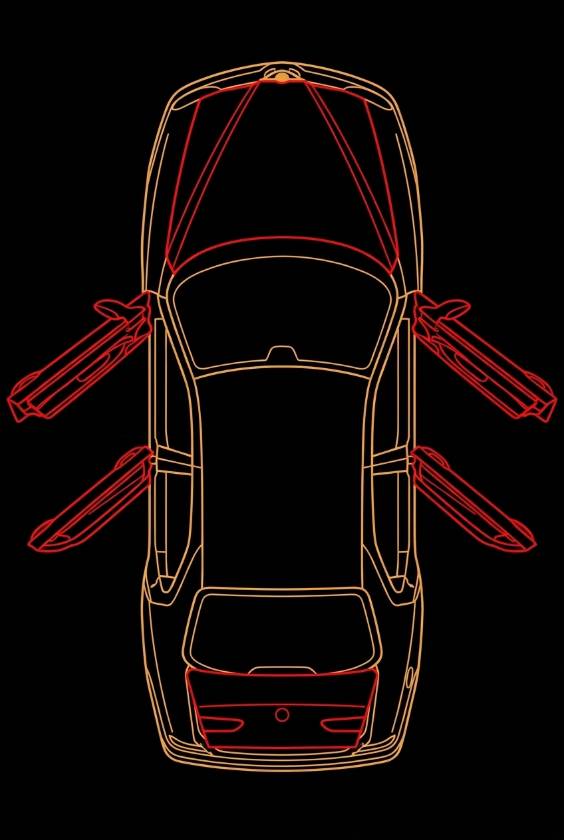
mockups/screen (9).png
