geek95dg/Alfa156-headunit/mockups/screen (10).png

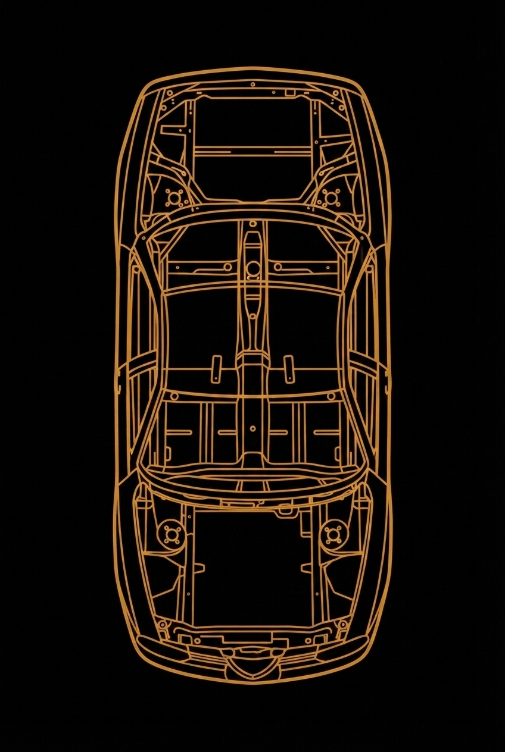
mockups/screen (10).png
