geek95dg/Alfa156-headunit/mockups/screen (12).png

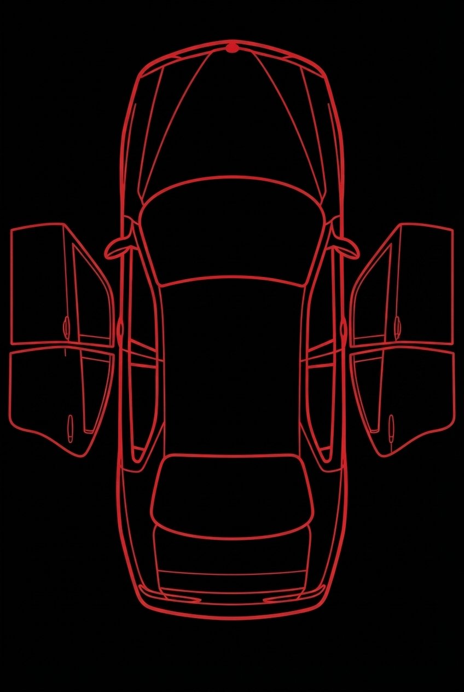
mockups/screen (12).png
