geek95dg/Alfa156-headunit/mockups/screen (13).png

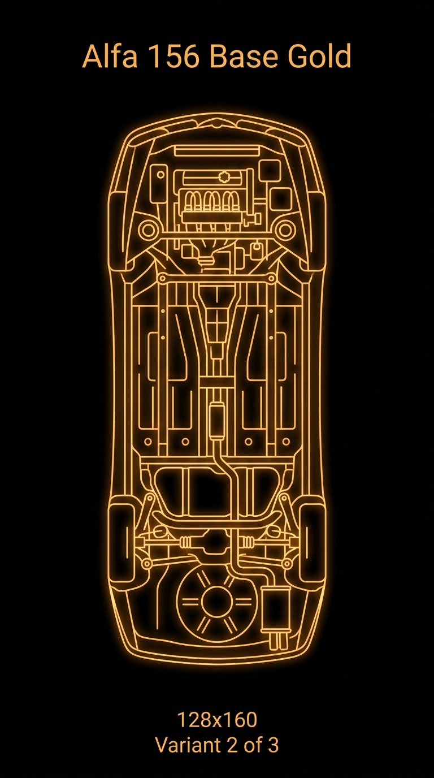
mockups/screen (13).png
