geek95dg/Alfa156-headunit/mockups/screen (14).png

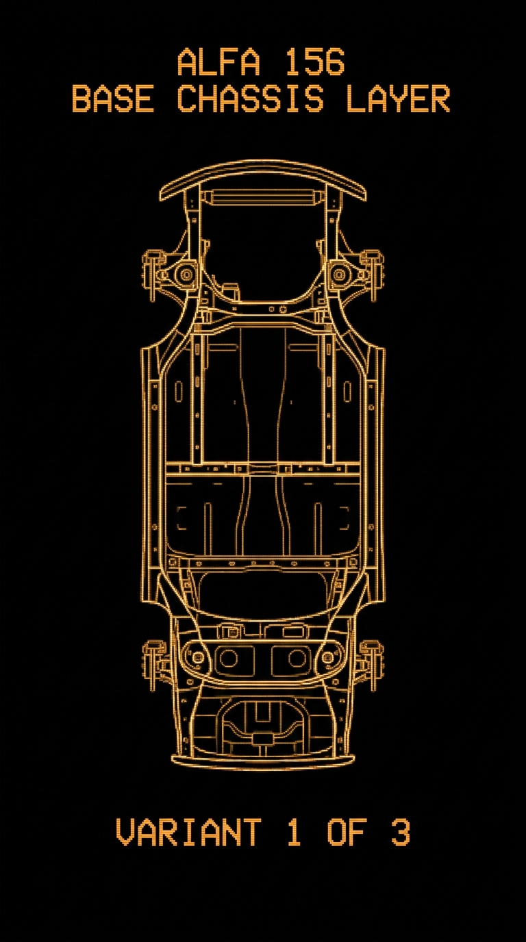
mockups/screen (14).png
