geek95dg/Alfa156-headunit/mockups/screen (15).png

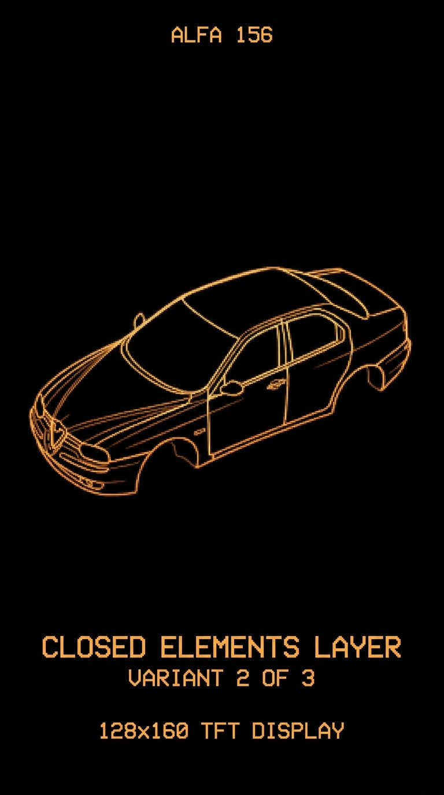
mockups/screen (15).png
