geek95dg/Alfa156-headunit/mockups/screen (16).png

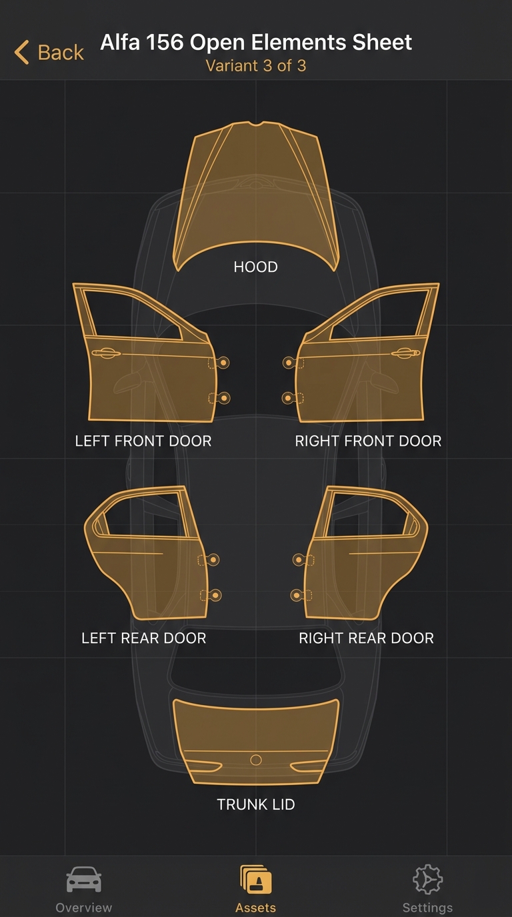
mockups/screen (16).png
