geek95dg/Alfa156-headunit/mockups/screen (17).png

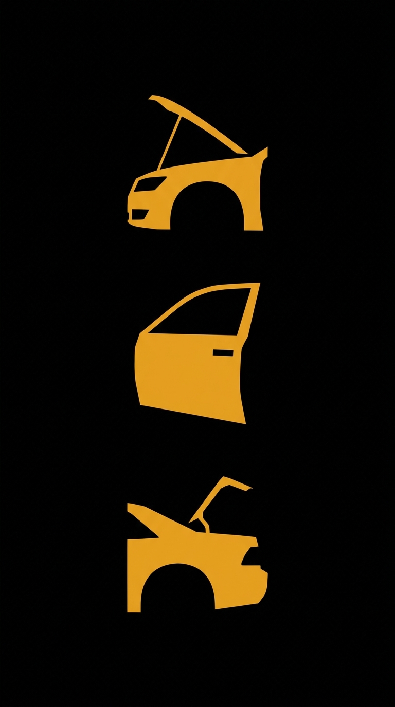
mockups/screen (17).png
