geek95dg/Alfa156-headunit/mockups/vehicle_control_center_dashboard.png

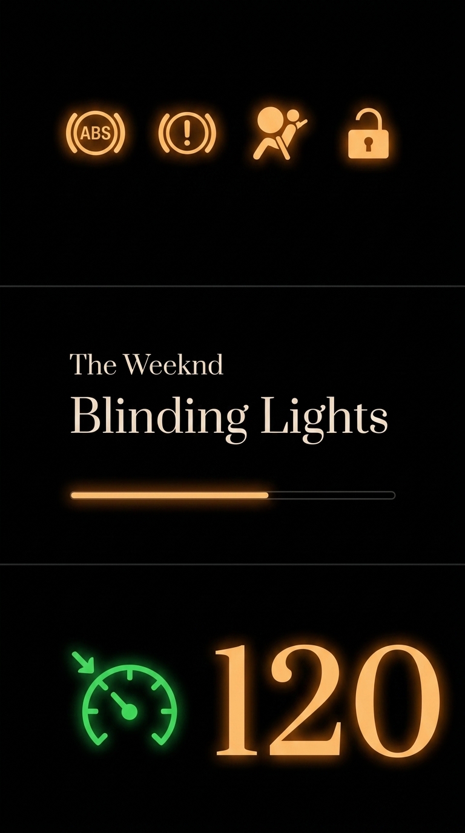
mockups/vehicle_control_center_dashboard.png
