geek95dg/Alfa156-headunit/schematics/png/charging_lvd.png

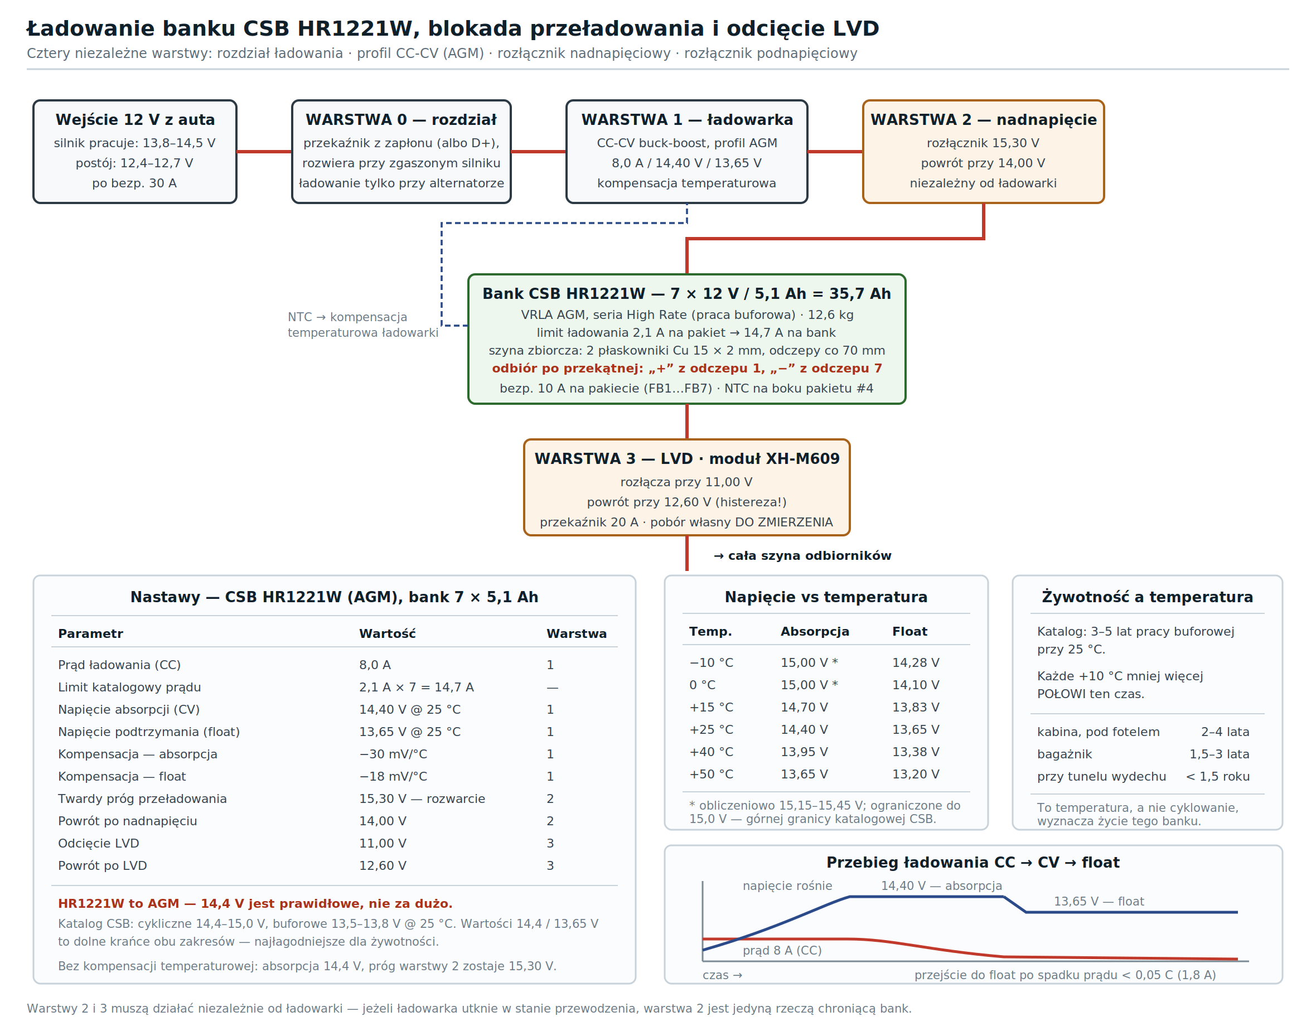
schematics/png/charging_lvd.png
