geek95dg/Alfa156-headunit/schematics/png/pcb_power_layout.png

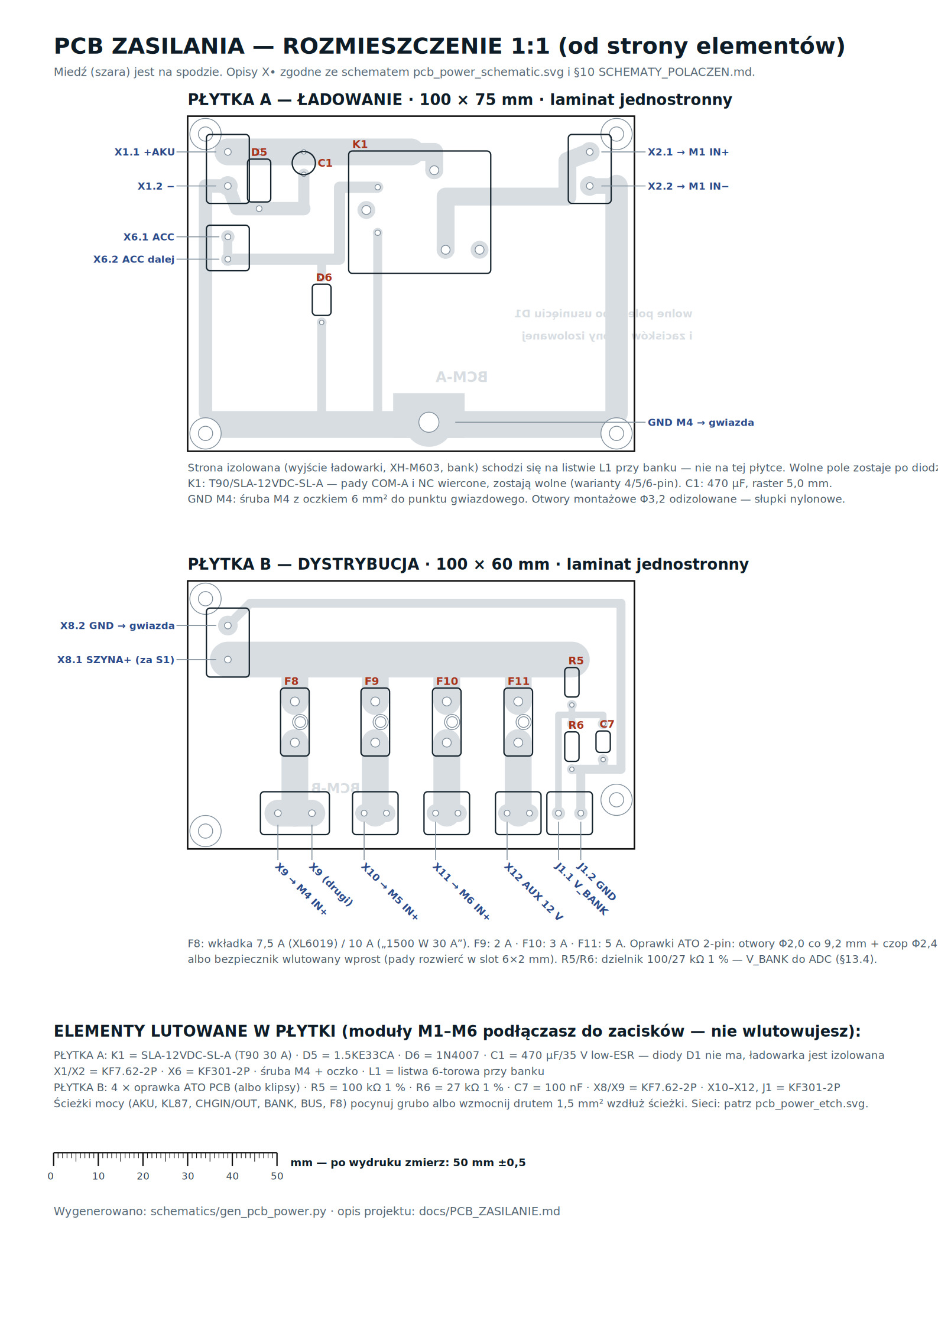
schematics/png/pcb_power_layout.png
