geek95dg/Alfa156-headunit/schematics/png/pcb_power_schematic.png

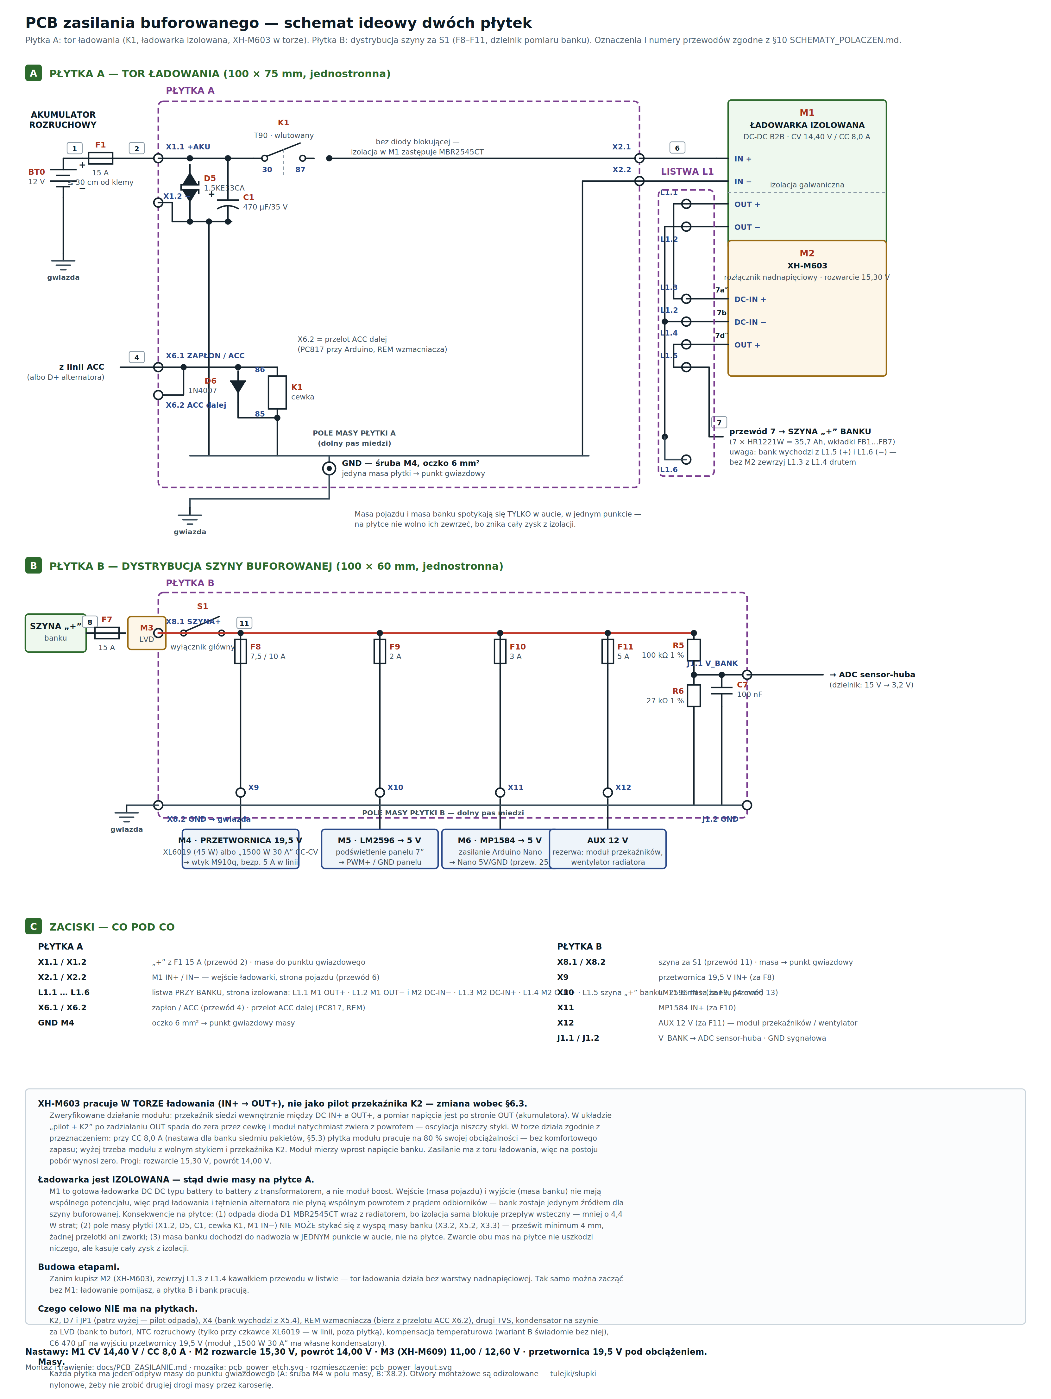
schematics/png/pcb_power_schematic.png
