geek95dg/Alfa156-headunit/schematics/png/power_buffered_m910q.png

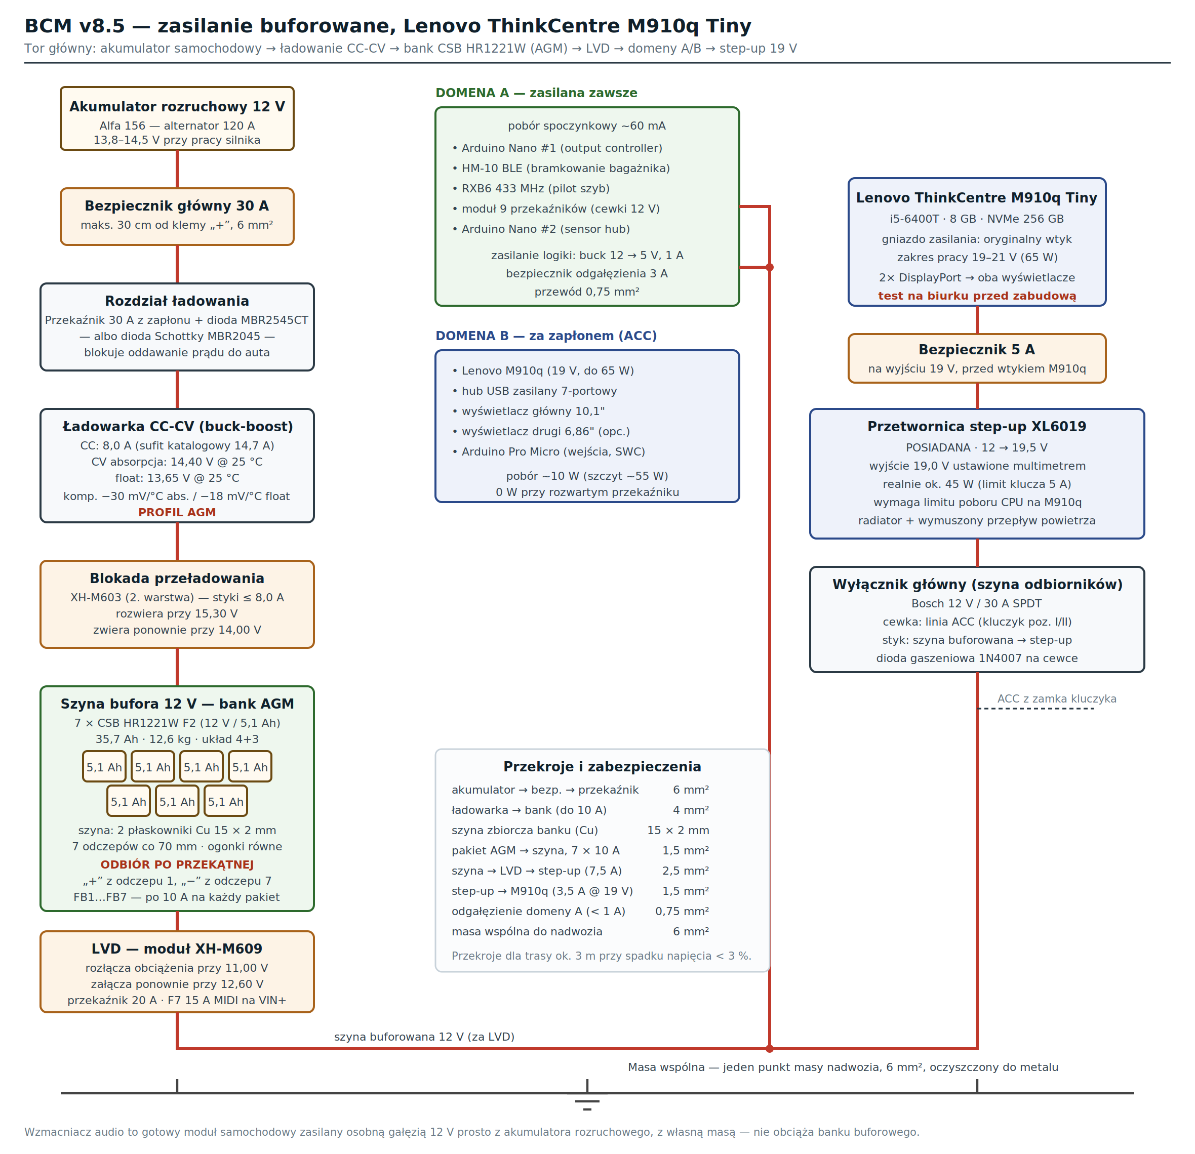
schematics/png/power_buffered_m910q.png
