geek95dg/Alfa156-headunit/schematics/png/power_domains_m910q.png

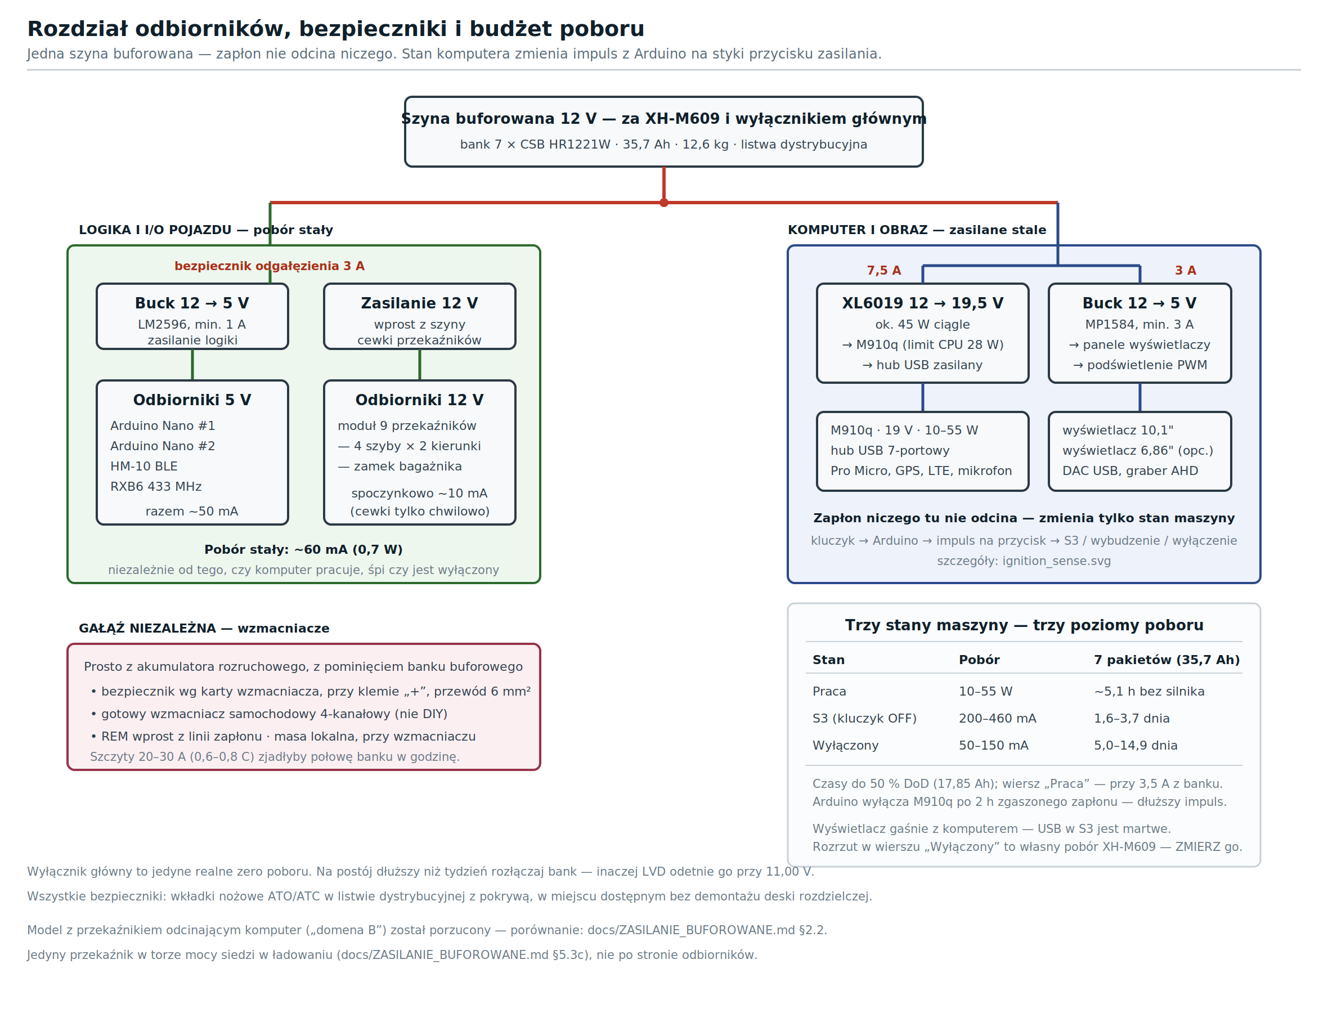
schematics/png/power_domains_m910q.png
