geek95dg/Alfa156-headunit/src/dashboard/web/assets/autodelta/junior_z_sketch.png

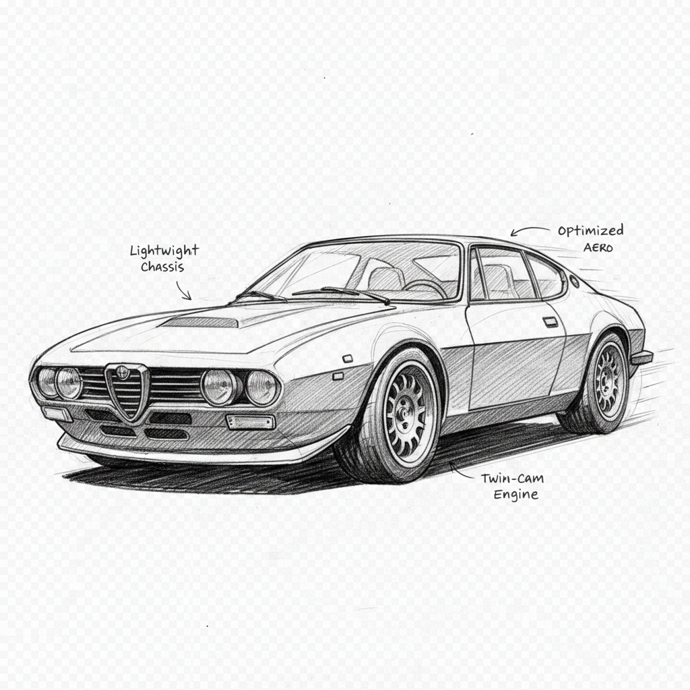
src/dashboard/web/assets/autodelta/junior_z_sketch.png
