geek95dg/Alfa156-headunit/src/dashboard/web/assets/heritage/giulia_gta_sketch.png

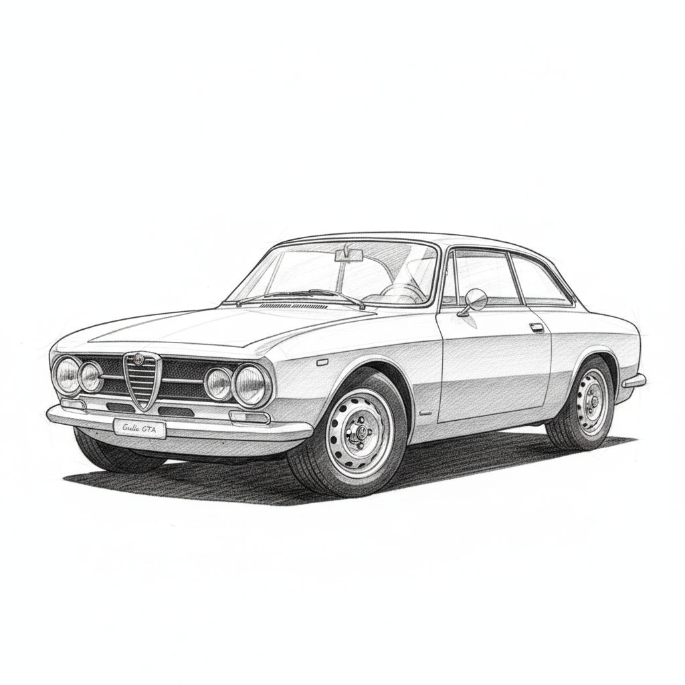
src/dashboard/web/assets/heritage/giulia_gta_sketch.png
