geek95dg/Alfa156-headunit/src/dashboard/web/assets/modern/berlina_156_sketch.png

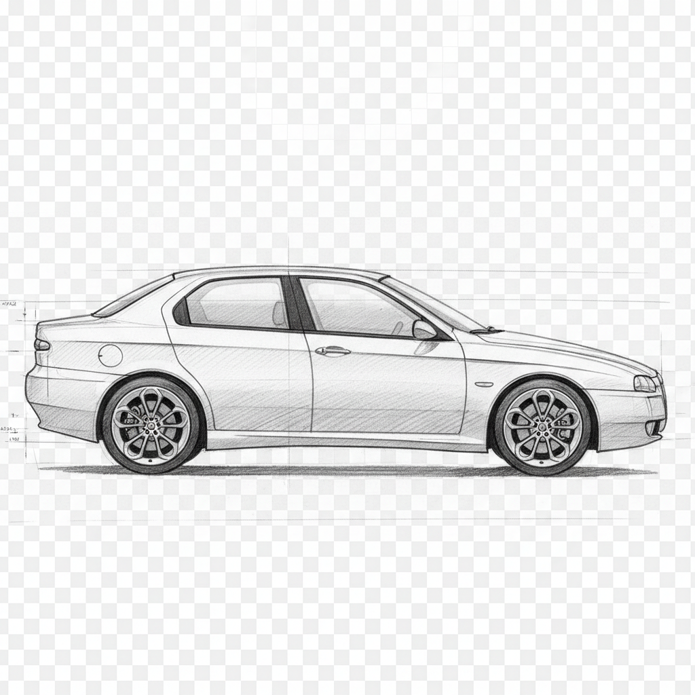
src/dashboard/web/assets/modern/berlina_156_sketch.png
