geek95dg/Alfa156-headunit/docs/OPI_PC_BOM.md

# Orange Pi PC 1.2 — Shopping List & Prices

> **Primary production build moved to OPi 5 Pro 4GB.**
> See [`OPI5PRO_BOM.md`](OPI5PRO_BOM.md) for the full production parts
> list. This document now describes only the **Orange Pi PC 1.2 bench
> test rig** used to validate BCM before committing to the 5 Pro.

Complete parts list for the OPi PC test rig. Prices in PLN, Q1 2026 estimates.

---

## STAGE 1: Core — Dashboard + Audio + OBD

| # | Component | Model / Spec | Qty | PLN |
|---|---|---|-----|-----|
| 1 | Orange Pi PC 1.2 | H3, 1GB RAM | 1 | 80-120 |
| 2 | microSD card | 16GB Class 10 | 1 | 20-30 |
| 3 | PSU | 5V/3A micro-USB | 1 | 25-40 |
| 4 | 7" HDMI display | 1024x600 touchscreen | 1 | 200-350 |
| 5 | DC-DC converter | LM2596 12V→5.1V | 1 | 30-50 |
| 6 | Fuses | 5A + 25A blade | 2 | 10 |
| 7 | USB DAC | ES9038Q2M | 1 | 45-75 |
| 8 | Amplifier (4ch) | TDA7388 | 1 | 45-70 |
| 9 | Heatsink | Aluminum (TDA7388) | 1 | 10-15 |
| 10 | K-Line adapter | CP2102 + L9637D + 510R | 1 | 25-40 |
| 11 | Ethernet cable | 1m CAT5e | 1 | 5 |
| 12 | Cables | HDMI, USB, power | — | 30-50 |

**Stage 1: ~525 — 855 PLN**

---

## STAGE 2: Sensors + Camera

| # | Component | Model / Spec | Qty | PLN |
|---|---|---|-----|-----|
| 13 | Parking sensors | HC-SR04 | 4 | 40-60 |
| 14 | Buzzer | Piezo 5V | 1 | 5-10 |
| 15 | Temp sensor | DS18B20 waterproof | 1 | 20-30 |
| 16 | Optoisolators | PC817 | 5 | 10-15 |
| 17 | Transistors | BC547 | 3 | 3-5 |
| 18 | Resistor kit | 1k, 2k, 4.7k, 10k | 1 | 10-15 |
| 19 | Diodes | 1N4148 | 5 | 3 |
| 20 | USB webcam | 640x480 min | 1 | 40-80 |
| 21 | USB SD card reader | DVR storage | 1 | 15-25 |
| 22 | SD card (DVR) | 64GB | 1 | 30-50 |
| 23 | Perfboard + headers | Sensor wiring | 1 | 10-15 |

**Stage 2: ~186 — 310 PLN**

---

## STAGE 3: Connectivity

| # | Component | Model / Spec | Qty | PLN |
|---|---|---|-----|-----|
| 24 | USB WiFi dongle | RTL8188 | 1 | 20-40 |
| 25 | USB BT dongle | BT 5.0 | 1 | 15-30 |
| 26 | LTE modem | Huawei E3372 | 1 | 60-120 |
| 27 | USB GPS | u-blox 7/8 | 1 | 40-80 |
| 28 | USB hub | 4-port powered | 1 | 30-50 |

**Stage 3: ~165 — 320 PLN**

---

## STAGE 4: Subwoofer + Extras

| # | Component | Model / Spec | Qty | PLN |
|---|---|---|-----|-----|
| 29 | Sub amp | TDA2050 | 1 | 20-30 |
| 30 | Heatsink (sub) | Aluminum | 1 | 5-10 |
| 31 | Rain sensor | Digital module | 1 | 30-50 |
| 32 | Wiper relay | 5V relay | 1 | 8-12 |
| 33 | Bench button | Momentary push | 1 | 3-5 |

**Stage 4: ~66 — 107 PLN**

---

## Summary

| Stage | What | Min | Max |
|---|---|-----|-----|
| 1 | Dashboard + Audio + OBD | 525 | 855 |
| 2 | Sensors + Camera | 186 | 310 |
| 3 | Connectivity (WiFi/BT/LTE/GPS) | 165 | 320 |
| 4 | Subwoofer + Extras | 66 | 107 |
| **Total** | | **942** | **1,592** |

---

## Where to Buy (Poland)

| Shop | Best For |
|---|---|
| Botland | Sensors, Arduinos, SBCs |
| Kamami | Electronic components |
| Allegro | Everything, used OPi PC |
| AliExpress | Bulk sensors, cheap modules |
| Nettigo | Boards, breakouts |

---

## Not Included

- Car speakers (reuse existing or ~200-400 PLN)
- Subwoofer driver (~100-200 PLN)
- Automotive wiring + connectors (~50-100 PLN)
- Mounting bracket (~20-50 PLN)
- SIM card for LTE modem
