geek95dg/Alfa156-headunit/mockups/renders/_test_step1_1.png

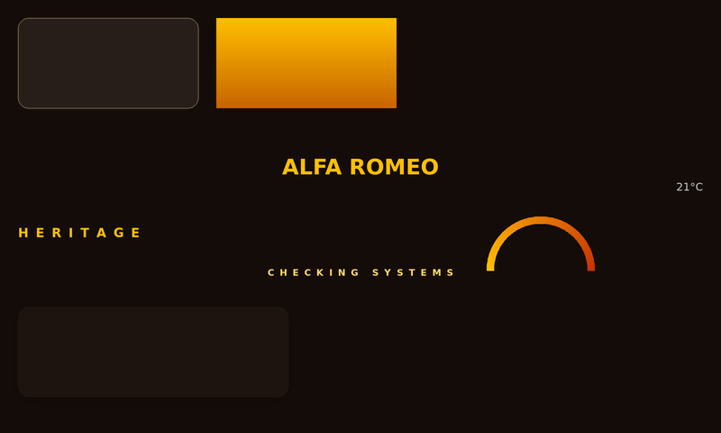
mockups/renders/_test_step1_1.png
