geek95dg/Alfa156-headunit/mockups/renders/_test_step1_3_autodelta.png

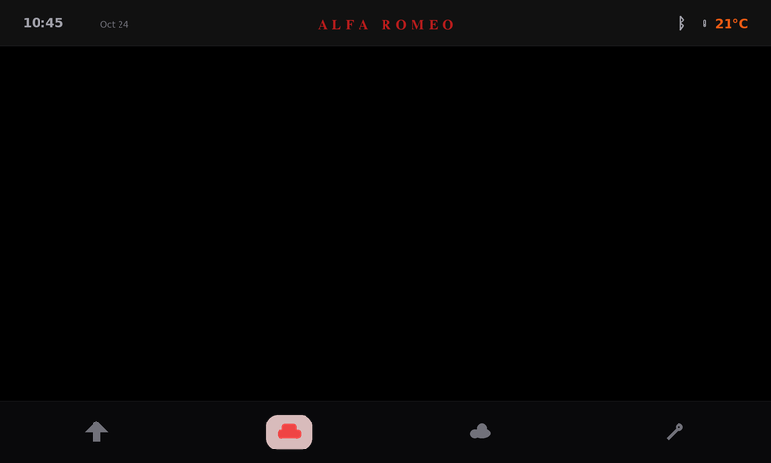
mockups/renders/_test_step1_3_autodelta.png
