geek95dg/Alfa156-headunit/mockups/renders/_test_step1_5_map.png

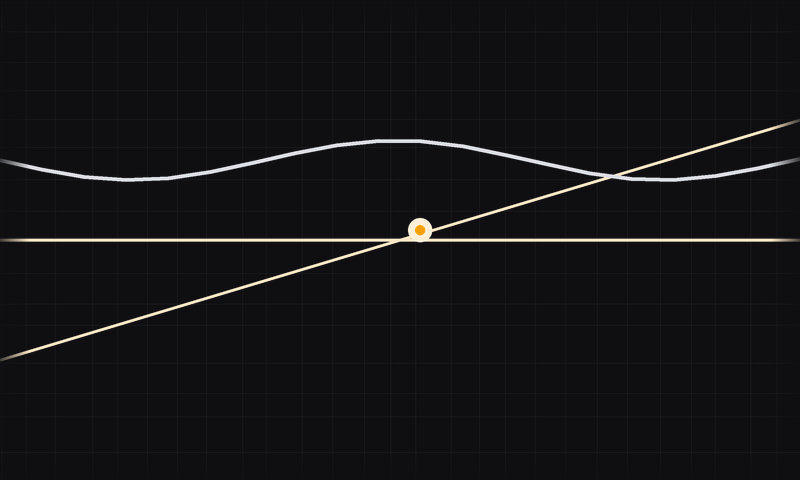
mockups/renders/_test_step1_5_map.png
