geek95dg/Alfa156-headunit/schematics/png/power_test_build.png

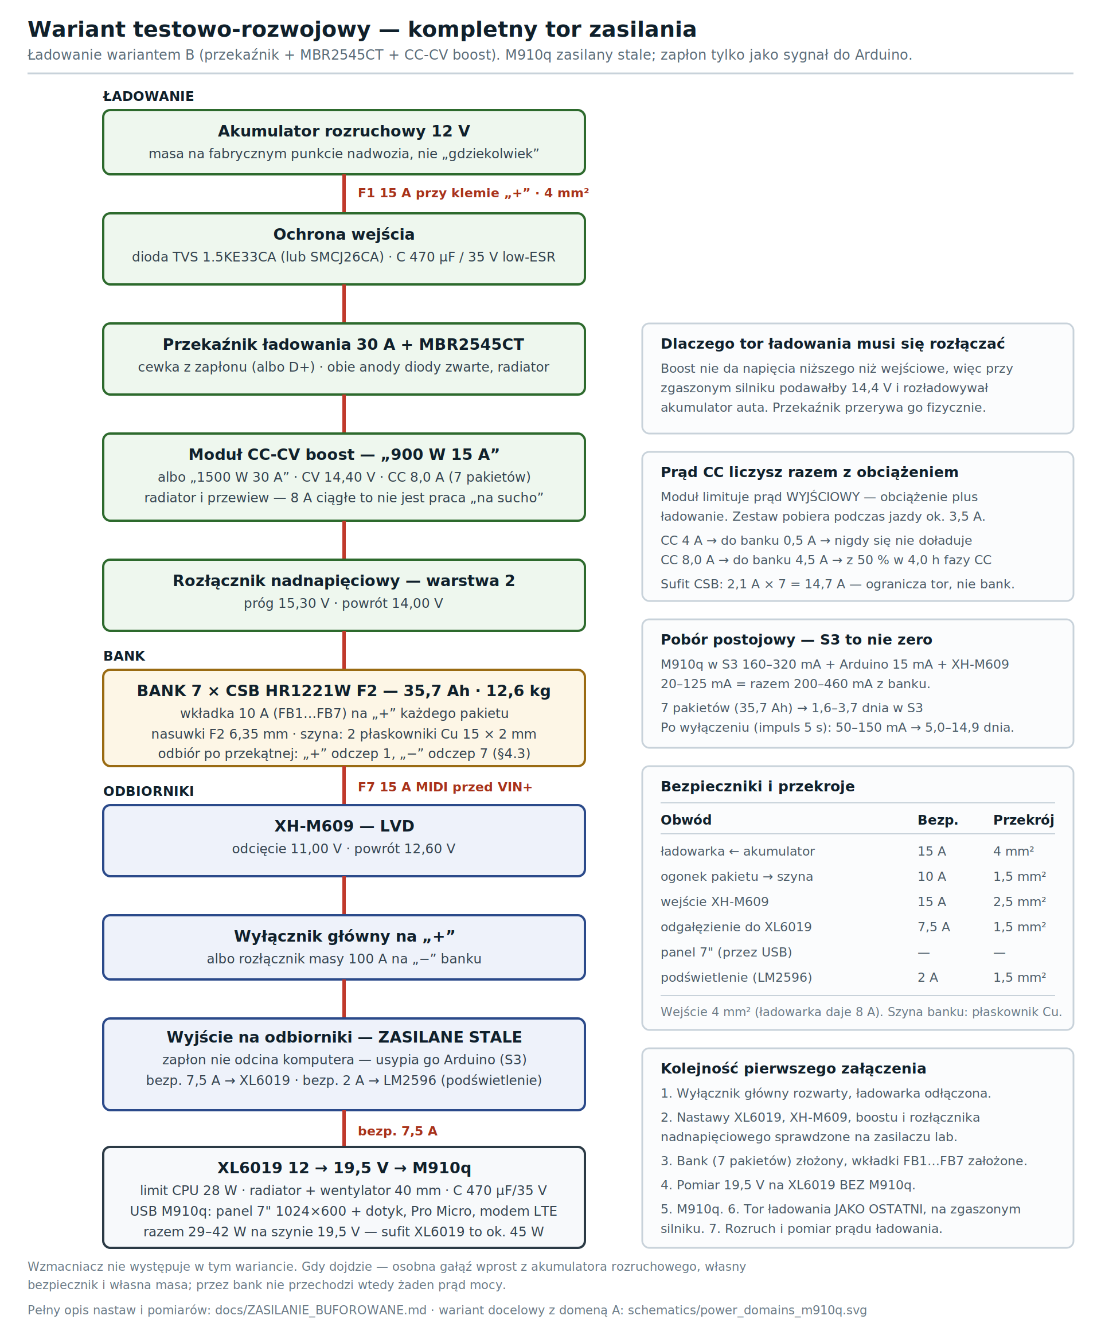
schematics/png/power_test_build.png
