geek95dg/Alfa156-headunit/schematics/png/schematic_test_build.png

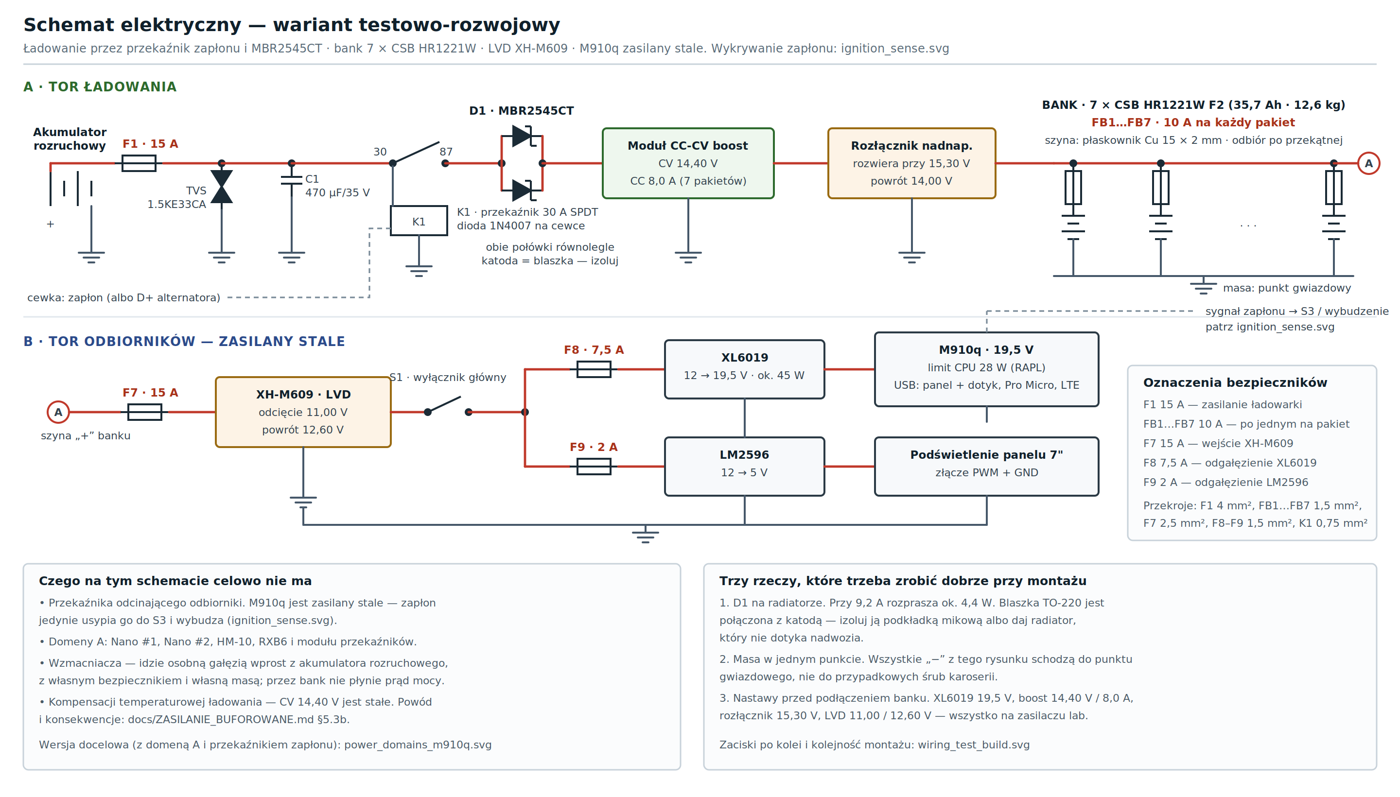
schematics/png/schematic_test_build.png
