geek95dg/Alfa156-headunit/schematics/png/wiring_power_modules.png

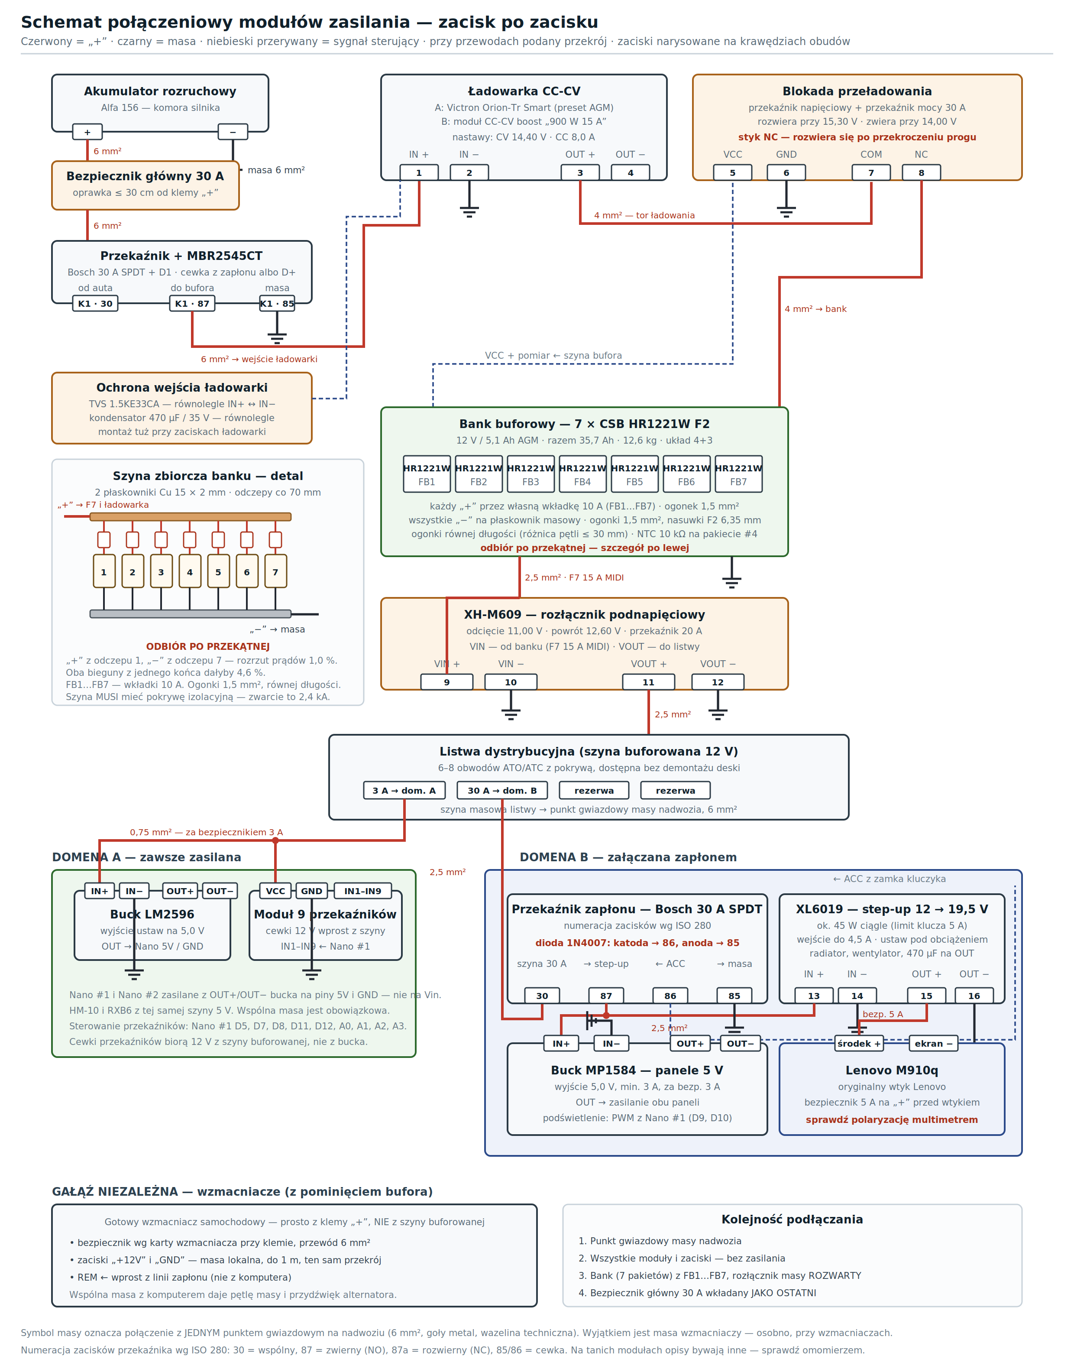
schematics/png/wiring_power_modules.png
