geek95dg/Alfa156-headunit/schematics/png/wiring_test_build.png

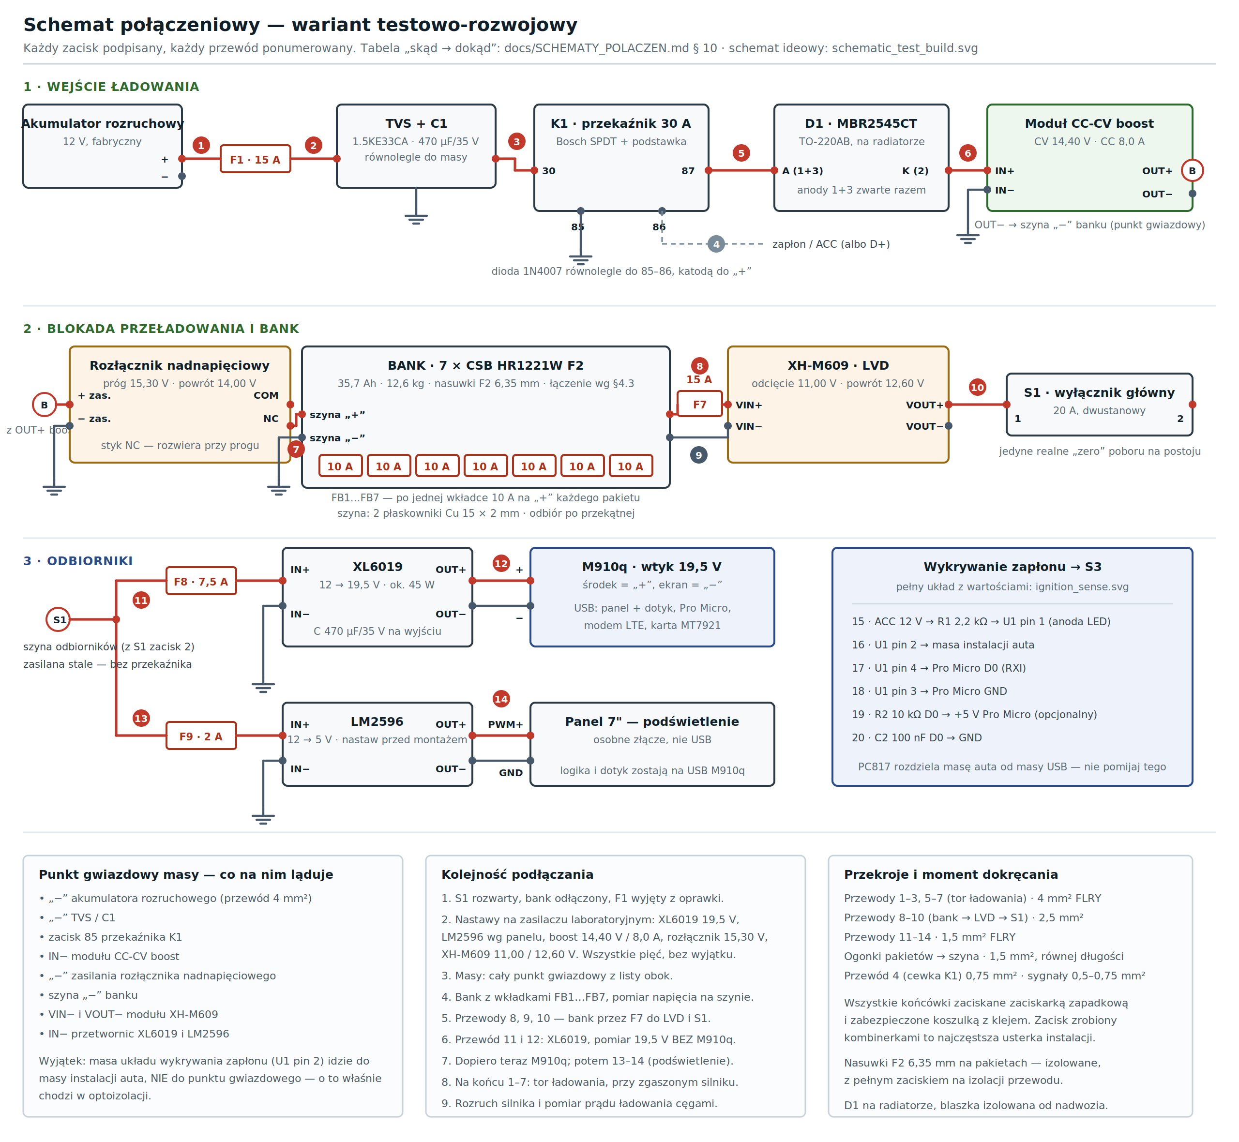
schematics/png/wiring_test_build.png
