geek95dg/Alfa156-headunit/schematics/png/schematic_test_power.png

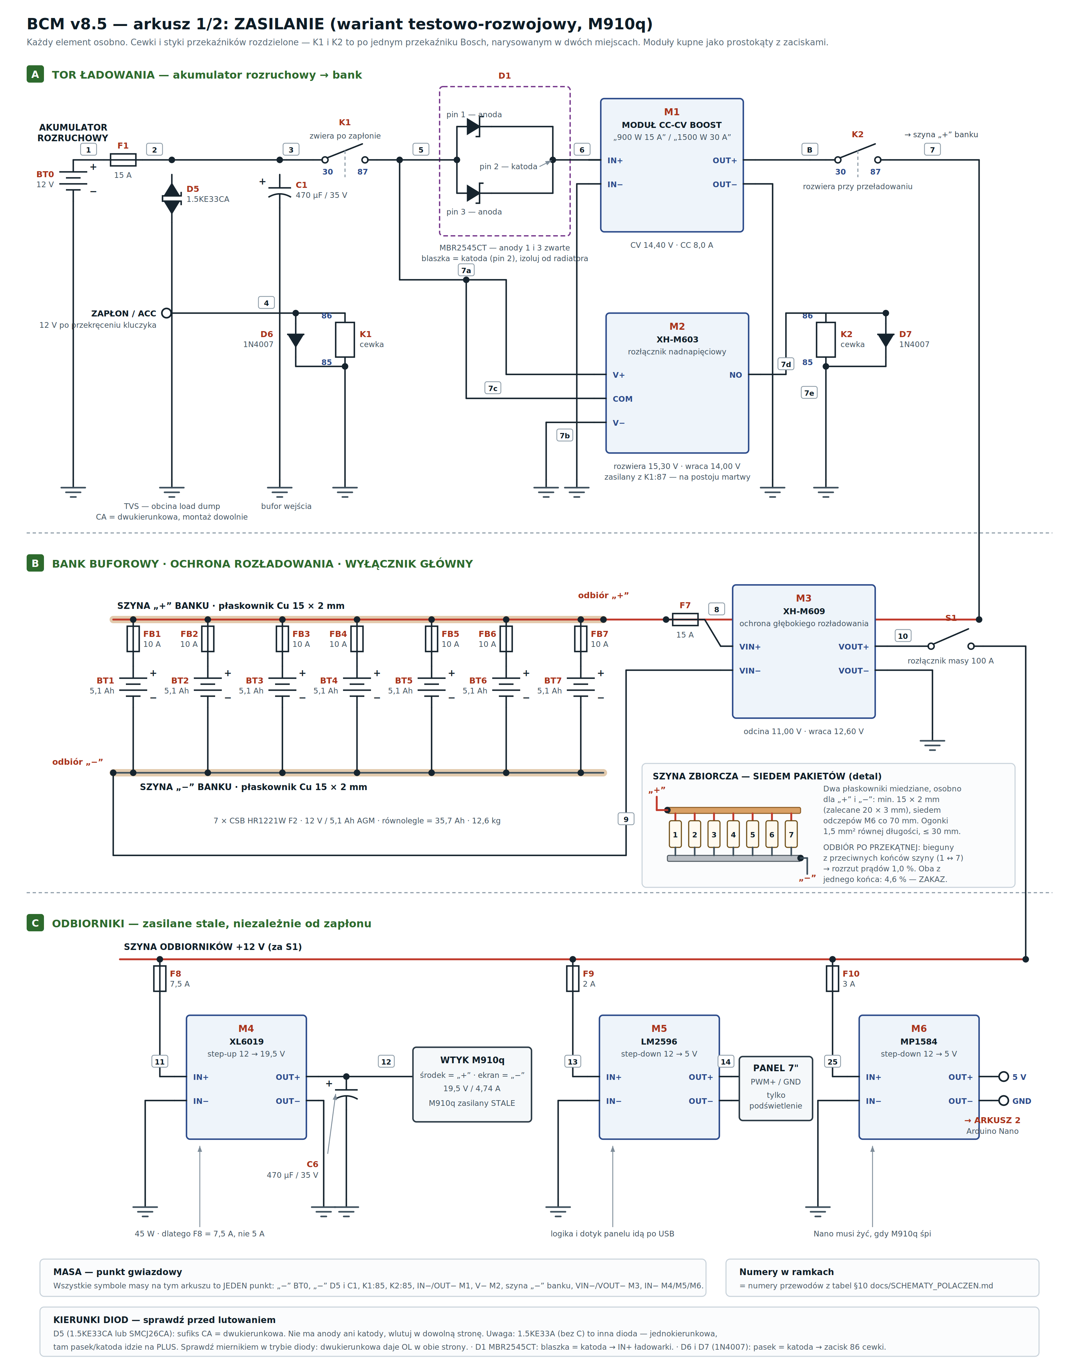
schematics/png/schematic_test_power.png
