geek95dg/Alfa156-headunit/src/dashboard/web_viewer.py

"""Flask web server for HTML5/Tailwind dashboard frontend.

Serves the SPA frontend and provides:
- REST API endpoints for config, data, and i18n
- WebSocket for real-time event bus streaming
- WebSocket for browser keyboard input

Replaces the old Pygame frame-streaming viewer.
"""

import glob
import html
import ipaddress
import json
import logging
import math
import os
import re
import select
import shutil
import subprocess
import time
import threading
from pathlib import Path
from typing import Optional, Any, Hashable
from urllib.parse import urlsplit

from src.core.logger import get_logger
from src.core.notifications import active_notifications
from src.multimedia.phone_status import sanitize_status as _phone_status_summary
from src.network.car_phone import ADB_STATES as _CAR_PHONE_ADB_STATES
from src.network.car_phone import HINTS as _CAR_PHONE_HINTS
from src.network.car_phone import RETRY_TOPIC as _CAR_PHONE_RETRY_TOPIC
from src.network.car_phone import STATES as _CAR_PHONE_STATES
from src.network import car_phone_agent as _car_phone_agent
from src.network.car_phone_agent import PAIR_CODE_RE as _AGENT_PAIR_CODE_RE
from src.network.car_phone_agent import REASONS as _AGENT_REASONS
from src.network.car_phone_agent import STATES as _AGENT_STATES
from src.network.car_phone_agent import TOPIC as _AGENT_TOPIC
from src.network.phone_tether import HINTS as _TETHER_HINTS
from src.network.phone_tether import RETRY_TOPIC as _TETHER_RETRY_TOPIC
from src.network.phone_tether import STATES as _TETHER_STATES
from src.safety import crash_sms as _crash_sms
from src.weather.weather import valid_coords

log = get_logger("web_viewer")

# Optional imports — Flask/gevent not required on OPi if using Pygame only
try:
    from flask import Flask, send_from_directory, jsonify, request, Response
    from flask_sock import Sock
    HAS_FLASK = True
except ImportError:
    HAS_FLASK = False
    log.debug("Flask not available — web viewer disabled")


# Key name mapping: browser KeyboardEvent.key -> action_dispatch key names
#
# The media entries are what makes the steering-wheel pod's NEXT/PREV/VOL/MUTE
# buttons do anything. The Arduino sends those as HID consumer-page keys, which
# Chromium reports as "MediaTrackNext", "AudioVolumeUp" and friends — names
# that were in neither this table nor KEYBOARD_MAP, so they fell through to the
# lowercased-key fallback ("mediatracknext"), matched nothing and were dropped.
# The wheel buttons that use ordinary keys (Home, F5-F9) worked all along,
# which is why the pod looked half-wired: phone and nav responded, tracks did
# not.
_BROWSER_KEY_MAP = {
    "ArrowUp": "up",
    "ArrowDown": "down",
    "ArrowLeft": "left",
    "ArrowRight": "right",
    "Enter": "enter",
    "Home": "home",
    "Backspace": "backspace",
    "Escape": "escape",
    " ": "space",
    "MediaTrackNext": "n",
    "MediaTrackPrevious": "p",
    "MediaPlayPause": "space",
    "AudioVolumeUp": "+",
    "AudioVolumeDown": "-",
    "AudioVolumeMute": "0",
}


# ── /ws/input + /aa/touch ────────────────────────────────────────────────
#: Larger input messages are dropped unparsed. A real one is ~80 bytes.
_MAX_INPUT_MESSAGE = 4096
#: KeyboardEvent.key values are short ("MediaTrackPrevious" is the longest
#: one we map); anything longer is not a key.
_MAX_KEY_NAME = 32
#: Actions accepted by the HTTP fallback POST /aa/touch (no "move": see there).
_AA_HTTP_TOUCH_ACTIONS = ("tap", "down", "up", "cancel")


def _ws_origin_allowed(origin: Optional[str], host: Optional[str]) -> bool:
    """Is a WebSocket handshake with this ``Origin`` from our own page?

    Browsers do no CORS check on WebSockets: any page the browser opens —
    e.g. the phone browsing while joined to the head unit's AP — could open
    /ws/input and inject keys and, since AA drags go over it too, touches
    into the phone's AA session. Browsers always send ``Origin`` on a
    WebSocket handshake, so a present Origin must name this server (scheme
    http/https, host:port equal to the ``Host`` header; the kiosk uses
    http://localhost:5002 and connects to ``location.host``). A missing
    Origin is a non-browser client and stays allowed. Not a defence against
    DNS rebinding (there Origin and Host agree): the network access policy
    (_access_decision) covers that in readonly/tracking by requiring an IP
    address or a dashboard.allowed_hosts name in Host. In ``full`` mode
    (the legacy default) nothing does — that mode trusts the whole network.
    """
    if origin is None:
        return True
    try:
        parts = urlsplit(origin.strip())
    except ValueError:
        return False
    if parts.scheme not in ("http", "https") or not parts.netloc or not host:
        return False
    default_port = ":443" if parts.scheme == "https" else ":80"

    def _norm(netloc: str) -> str:
        netloc = netloc.strip().lower()
        return netloc[:-len(default_port)] if netloc.endswith(default_port) else netloc

    return _norm(parts.netloc) == _norm(host)

# ── /aa/stream (MJPEG from Xvfb) ─────────────────────────────────────────
# Each stream is one ffmpeg x11grab process. The old generator did a blocking
# read(): if Xvfb wedged or vanished during an AA restart, the request thread
# and its ffmpeg hung forever, and every kiosk reload added another pair.
#: poll() timeout on ffmpeg's stdout (poll, not select: select() raises
#: ValueError for any fd >= FD_SETSIZE (1024), so a 24/7 process that ever
#: held ~1000 descriptors would end every stream at once).
_AA_STREAM_READ_TIMEOUT_S = 5.0
#: End the stream after this long without a complete JPEG frame; the kiosk
#: reconnects with backoff.
_AA_STREAM_STALL_S = 10.0
#: Concurrent streams kept alive; the newest win (a reloaded kiosk must not be
#: refused because its previous incarnation is still draining). A retired
#: stream's ffmpeg is terminated directly, because its request thread may be
#: stuck inside a write to a client that stopped reading.
_AA_STREAM_MAX_CLIENTS = 2
#: A partial frame bigger than this is garbage — drop it instead of growing.
_AA_STREAM_MAX_BUFFER = 8 * 1024 * 1024


# ── /api/config POST validation ──────────────────────────────────────────
# The endpoint used to store whatever JSON it received; since the values now
# persist to config/local.yaml, a bogus theme or a string brightness would
# survive restarts. Allowed values mirror the Settings screen
# (web/js/screens/settings.js) and settings_screen.py.
_CONFIG_THEMES = ("heritage", "modern", "autodelta")
_CONFIG_SPEED_UNITS = ("km/h", "mph")
_CONFIG_TEMP_UNITS = ("C", "F")

# request key → config dot-path, in the order they are applied
_CONFIG_FIELDS = (
    ("theme", "display.dashboard.theme"),
    ("language", "language"),
    ("speed_unit", "units.speed"),
    ("temp_unit", "units.temperature"),
    ("brightness", "display.dashboard.brightness"),
    ("aa_auto_restart", "multimedia.aa_auto_restart"),
)


def _available_languages() -> tuple:
    from src.dashboard.i18n import STRINGS
    return tuple(STRINGS)


def _validate_config_update(data: Any) -> tuple[list[tuple[str, str, Any]], Optional[tuple[str, str]]]:
    """Validate a POST /api/config body.

    Returns ``(updates, error)``: ``updates`` is a list of
    ``(request_key, config_path, value)`` to apply; ``error`` is
    ``(request_key, message)`` for the first invalid field, in which case
    nothing may be applied (all-or-nothing). Unknown keys are ignored, as
    before.
    """
    if not isinstance(data, dict):
        return [], ("", "body must be a JSON object")
    updates: list[tuple[str, str, Any]] = []
    for key, config_key in _CONFIG_FIELDS:
        if key not in data:
            continue
        value = data[key]
        if key == "theme":
            if value not in _CONFIG_THEMES:
                return [], (key, f"theme must be one of {list(_CONFIG_THEMES)}")
        elif key == "language":
            languages = _available_languages()
            if value not in languages:
                return [], (key, f"language must be one of {list(languages)}")
        elif key == "speed_unit":
            if value not in _CONFIG_SPEED_UNITS:
                return [], (key, f"speed_unit must be one of {list(_CONFIG_SPEED_UNITS)}")
        elif key == "temp_unit":
            if value not in _CONFIG_TEMP_UNITS:
                return [], (key, f"temp_unit must be one of {list(_CONFIG_TEMP_UNITS)}")
        elif key == "brightness":
            # bool is an int subclass — True must not become brightness 1.
            if isinstance(value, float) and value.is_integer():
                value = int(value)
            if isinstance(value, bool) or not isinstance(value, int) or not 0 <= value <= 100:
                return [], (key, "brightness must be an integer 0-100")
        elif key == "aa_auto_restart":
            if not isinstance(value, bool):
                return [], (key, "aa_auto_restart must be true or false")
        updates.append((key, config_key, value))
    return updates, None


#: Wi-Fi secrets that may be provided by /etc/bcm/bcm.env (SECRET_ENV_MAP).
_WIFI_SECRET_PATHS = ("wifi.password", "wifi.alfa_net.password")


def _unpersisted_wifi_secrets(cfg: Any) -> list[str]:
    """Wi-Fi secret paths changed at runtime that bcm.env overrides on restart.

    Never raises; a config object without the helper (tests, older code)
    simply reports none.
    """
    changed = getattr(cfg, "unpersisted_secret_changes", None)
    if not callable(changed):
        return []
    try:
        return [p for p in changed() if p in _WIFI_SECRET_PATHS]
    except Exception:
        log.debug("unpersisted_secret_changes failed", exc_info=True)
        return []


def _save_config(cfg: Any, what: str) -> bool:
    """Persist ``cfg`` to the local overlay; never raises.

    Returns True if the change is on disk. A save failure must not turn a
    successful in-memory change into an HTTP 500 or kill an event-bus
    callback — it is logged and reported as ``persisted: false``.
    """
    try:
        return bool(cfg.save())
    except Exception:
        log.exception("Saving config (%s) failed", what)
        return False


def _modules_restart_required(modules: list, changed: bool) -> bool:
    """True if any module's saved toggles differ from what is running now
    (``restart_pending`` from catalog_state). Without a boot snapshot
    (``restart_pending`` absent) a change just saved (``changed``) is
    assumed to need one, and a plain read says nothing is pending."""
    if any("restart_pending" not in m for m in modules):
        return changed
    return any(m["restart_pending"] for m in modules)


#: Minimum spacing of POST /api/phone_tether/retry (one nmcli attempt each).
_TETHER_RETRY_MIN_INTERVAL_S = 10.0
#: Minimum spacing of POST /api/phone/dial, per bucket: the kiosk on this
#: machine and "everyone else" are counted separately, so a client on the
#: network cannot keep the driver's own dialer (also for 112) at 429.
_DIAL_MIN_INTERVAL_S = 5.0
#: What a client that is not the kiosk may dial: a plain number, nothing
#: with ``*``/``#``. Those make the phone run MMI/supplementary-service codes
#: — ``*31*#112`` still calls 112 (Android dials what follows the caller-ID
#: code), ``**21*<number>#`` forwards every call permanently (also to a
#: premium-rate number), USSD codes reach the operator account.
_NETWORK_DIAL_RE = re.compile(r"^\+?[0-9]{3,20}$")


def _phone_tether_summary(value: Any) -> Optional[dict]:
    """``net.phone_tether`` → ``{state, ip, iface, hint}`` for the payload.

    Only what the Settings row shows, and only known states / hints and
    plausible lengths: the values come from nmcli output (the frontend
    escapes them too). Never published = the module is not running (the
    production config) = None, and Settings shows no row at all.
    """
    if not isinstance(value, dict):
        return None
    state = value.get("state")
    ip = value.get("ip")
    iface = value.get("iface")
    hint = value.get("hint")
    return {
        "state": state if isinstance(state, str) and state in _TETHER_STATES else "unknown",
        "ip": ip if isinstance(ip, str) and len(ip) <= 45 else "",
        "iface": iface if isinstance(iface, str) and len(iface) <= 15 else "",
        "hint": hint if isinstance(hint, str) and hint in _TETHER_HINTS else "",
    }


#: Minimum spacing of POST /api/car_phone/retry (each can cost adb calls and
#: a `connection up` of up to 30 s).
_CAR_PHONE_RETRY_MIN_INTERVAL_S = 10.0
_CAR_PHONE_PLUGGED = ("", "ac", "usb", "wireless", "dock")
_CAR_PHONE_HEALTH = ("unknown", "good", "overheat", "dead", "over_voltage", "failure", "cold")
_SERIAL_MASK_RE = re.compile(r"^(?:…|[A-Za-z0-9._:-]{2}…[A-Za-z0-9._:-]{2})$")


def _car_phone_summary(value: Any) -> Optional[dict]:
    """``net.car_phone`` → what the Settings row "Telefon w aucie" shows.

    Whitelists for state / hint / adb / plugged / health, numbers checked
    for type and range, strings for length and shape: the values come from
    adb and nmcli output (the frontend escapes them too). The serial is
    passed on only in its masked form (``1a…4d``) — the payload is visible
    from the network in ``readonly`` mode. Never published = the module is
    not running (production) = None, and Settings shows no row.
    """
    if not isinstance(value, dict):
        return None

    def num(key, lo, hi, integer=False):
        v = value.get(key)
        if isinstance(v, bool) or not isinstance(v, (int, float)):
            return None
        if integer and not isinstance(v, int):
            return None
        if v != v or not lo <= v <= hi:        # NaN, out of range
            return None
        return v

    def flag(key):
        v = value.get(key)
        return v if isinstance(v, bool) else None

    def pick(key, allowed, default=""):
        v = value.get(key)
        return v if isinstance(v, str) and v in allowed else default

    state = value.get("state")
    ip = value.get("ip")
    iface = value.get("iface")
    gateway = value.get("gateway")
    serial = value.get("serial")
    error = value.get("error")
    temp = num("temp_c", -40, 100)
    return {
        "state": state if isinstance(state, str) and state in _CAR_PHONE_STATES else "unknown",
        "hint": pick("hint", _CAR_PHONE_HINTS),
        "adb": pick("adb", _CAR_PHONE_ADB_STATES),
        "serial": serial if isinstance(serial, str) and _SERIAL_MASK_RE.fullmatch(serial) else "",
        "ip": ip if isinstance(ip, str) and len(ip) <= 45 else "",
        "prefix": num("prefix", 0, 32, integer=True),
        "gateway": gateway if isinstance(gateway, str) and len(gateway) <= 45 else "",
        "iface": iface if isinstance(iface, str) and len(iface) <= 15 else "",
        "gps_forward": value.get("gps_forward") is True,
        "battery_pct": num("battery_pct", 0, 100, integer=True),
        "temp_c": round(temp, 1) if temp is not None else None,
        "charging": flag("charging"),
        "full": flag("full"),
        "plugged": pick("plugged", _CAR_PHONE_PLUGGED, None),
        "health": pick("health", _CAR_PHONE_HEALTH, None),
        "overridden": value.get("overridden") is True,
        "hotspot_active": flag("hotspot_active"),
        "hotspot_clients": num("hotspot_clients", 0, 255, integer=True),
        "heat": pick("heat", ("warning", "danger"), None),
        "error": error[:200] if isinstance(error, str) else "",
    }


#: Minimum spacing of POST /api/car_phone_agent/pair (each one sends the
#: secret to whatever answers on the agent forward — a click, not a loop;
#: only attempts handed to the module count, a malformed body or a refusal
#: such as "confirmation needed" costs nothing).
_AGENT_PAIR_MIN_INTERVAL_S = 10.0
#: The pair body is {"code": "<10 digits>", "confirm": bool} — tiny.
_AGENT_PAIR_MAX_BODY = 256
_AGENT_VERSION_RE = re.compile(r"^[0-9A-Za-z.+-]{1,16}$")


def _car_phone_agent_summary(value: Any) -> Optional[dict]:
    """``net.car_phone_agent`` → the Settings row "Agent w telefonie".

    The module validated the agent's answers already; this is the second
    line (whitelisted state/reason, flags only as booleans, timestamps only
    as finite epoch numbers, version by pattern) because the payload also
    reaches network clients in ``readonly`` mode. Never published = the
    module is not running = None (no row).
    """
    if not isinstance(value, dict):
        return None

    def flag(key):
        v = value.get(key)
        return v if isinstance(v, bool) else None

    def ts(key):
        v = value.get(key)
        if isinstance(v, bool) or not isinstance(v, (int, float)):
            return None
        return v if math.isfinite(v) and 0 < v < 4e9 else None

    state = value.get("state")
    version = value.get("version")
    reason = value.get("reason")
    error = value.get("error")
    return {
        "state": state if isinstance(state, str) and state in _AGENT_STATES else "unknown",
        "paired": flag("paired"),
        "pairing": flag("pairing"),
        "version": version if isinstance(version, str) and _AGENT_VERSION_RE.fullmatch(version)
        else None,
        "sim_ready": flag("sim_ready"),
        "last_ok_ts": ts("last_ok_ts"),
        "last_sent_ts": ts("last_sent_ts"),
        "reason": reason if isinstance(reason, str) and reason in _AGENT_REASONS else "",
        "error": error[:200] if isinstance(error, str) else "",
        "needs_confirm": value.get("needs_confirm") is True,
    }


#: Crash SMS routes (src/safety/crash_sms.py): minimum spacing of accepted
#: commands, per route (a double tap is swallowed by the UI already; the
#: limit stops a loop — the first command is queued anyway).
_CRASH_CMD_MIN_INTERVAL_S = 1.0
#: One REAL test SMS request per minute (the phone allows one per 10 min).
_CRASH_TEST_MIN_INTERVAL_S = 60.0
_CRASH_RECIPIENTS_MIN_INTERVAL_S = 2.0
#: Bodies: {"event_id": "<32 hex>"}, {"confirm": true},
#: {"recipients": [3 numbers]} — all tiny.
_CRASH_MAX_BODY = 512
#: A recipient as typed: digits, '+', spaces and dashes (removed), bounded.
_CRASH_RCPT_TYPED_RE = re.compile(r"^[0-9+ -]{1,32}$")


def _crash_sms_summary(value: Any) -> Optional[dict]:
    """``crash.sms_state`` → the crash window and the Settings section.

    A whitelist with types and ranges (the module built it from validated
    agent answers; this is the second line, because the payload also
    reaches network clients in ``readonly`` mode). Recipient numbers are
    never in it — only how many there are. None = the module does not run
    (no window, no Settings section).
    """
    if not isinstance(value, dict):
        return None

    def flag(key):
        return value.get(key) is True

    def epoch(v):
        if isinstance(v, bool) or not isinstance(v, (int, float)):
            return None
        return float(v) if math.isfinite(v) and 0 < v < 4e9 else None

    def small_int(v, hi):
        if isinstance(v, bool) or not isinstance(v, int) or not 0 <= v <= hi:
            return None
        return v

    state = value.get("state")
    eid = value.get("event_id")
    results = []
    raw = value.get("results")
    if isinstance(raw, list):
        for r in raw[:_car_phone_agent.MAX_RECIPIENTS]:
            if isinstance(r, dict) and r.get("state") in _crash_sms.RCPT_STATES:
                results.append({"state": r["state"], "verified": r.get("verified") is True})
    cancel = value.get("cancel_sms")
    test = value.get("test") if isinstance(value.get("test"), dict) else {}
    reason = value.get("forced_dry_run_reason")
    error = value.get("error")
    return {
        "state": state if isinstance(state, str) and state in _crash_sms.STATES else "idle",
        "event_id": eid if isinstance(eid, str) and _crash_sms.EVENT_ID_RE.fullmatch(eid)
        else None,
        "ts": epoch(value.get("ts")),
        "countdown_s": small_int(value.get("countdown_s"), _car_phone_agent.COUNTDOWN_MAX_S),
        "countdown_left_s": small_int(value.get("countdown_left_s"),
                                      _car_phone_agent.COUNTDOWN_MAX_S),
        "deadline_ts": epoch(value.get("deadline_ts")),
        "recipients_n": small_int(value.get("recipients_n"),
                                  _car_phone_agent.MAX_RECIPIENTS) or 0,
        "phone_ok": flag("phone_ok"),
        # Anything but an explicit false is shown as test mode.
        "dry_run": value.get("dry_run") is not False,
        "forced_dry_run_reason": reason if isinstance(reason, str)
        and reason in _crash_sms.FORCED_REASONS else "",
        "results": results,
        "cancel_sms": {"state": cancel["state"]} if isinstance(cancel, dict)
        and cancel.get("state") in ("sending", "sent", "partial", "failed") else None,
        "error": error if isinstance(error, str) and error in _crash_sms.ERRORS else "",
        "modal": flag("modal"),
        "cancel_pending": flag("cancel_pending"),
        "send_now_pending": flag("send_now_pending"),
        "can_follow_up": flag("can_follow_up"),
        "may_send": flag("may_send"),
        "unconfirmed": flag("unconfirmed"),
        "test": {
            "request": test.get("request") if test.get("request") in _crash_sms.TEST_REQUESTS
            else "",
            "error": test.get("error") if test.get("error") in _crash_sms.TEST_ERRORS else "",
            "state": test.get("state") if test.get("state") in _car_phone_agent.TEST_STATES
            else None,
            "ts": epoch(test.get("ts")),
            "dry_run": test.get("dry_run") if isinstance(test.get("dry_run"), bool) else None,
            "verified": test.get("verified") is True,
            "last_verified_ts": epoch(test.get("last_verified_ts")),
        },
    }


#: gps.source_state values the Settings row may show (src/location/gps.py).
_GPS_SOURCES = ("demo", "serial", "udp", "tcp")
_GPS_STATES = ("fix", "no_fix")
_GPS_INPUT_STATES = ("starting", "running", "connected", "receiving", "listening",
                     "waiting", "connecting", "disconnected", "error", "demo_fallback")
#: Code defaults of hardware.gps.{udp,tcp}.port (gps.DEFAULTS) for the hint.
_GPS_DEFAULT_PORTS = {"udp": 10110, "tcp": 50000}


def _gps_peer_ip(peer: Any) -> str:
    """``"192.168.44.1:43210"`` → ``"192.168.44.1"``, only for a private address.

    The payload is visible from the network in ``readonly`` mode; a public
    address (or a serial device path) is not what the Settings row needs.
    """
    if not isinstance(peer, str) or not peer or len(peer) > 64:
        return ""
    host = peer.strip()
    if host.startswith("["):                              # [v6]:port
        host = host[1:host.find("]")] if "]" in host else ""
    elif host.count(":") == 1:                            # v4:port
        host = host.split(":", 1)[0]
    try:
        ip = ipaddress.ip_address(host)
    except ValueError:
        return ""
    if ip.version == 6 and ip.ipv4_mapped is not None:
        ip = ip.ipv4_mapped
    return str(ip) if ip.is_private else ""


def _gps_port(cfg: Any, name: str) -> int:
    default = _GPS_DEFAULT_PORTS[name]
    try:
        value = cfg.get(f"hardware.gps.{name}.port", default) if cfg is not None else default
    except Exception:
        value = default
    if isinstance(value, bool) or not isinstance(value, int) or not 1 <= value <= 65535:
        return default
    return value


def _gps_state_summary(value: Any, cfg: Any = None) -> Optional[dict]:
    """``gps.source_state`` → what the Settings "GPS" row shows, or None.

    ``{source, state, peer, last_ts, inputs: [{source, state}], udp_port,
    tcp_port}`` — known names only, the sender only as a private IP (see
    _gps_peer_ip), ports only for inputs that run (they make the "send NMEA
    to <bnep0 IP>:10110" hint right). None while the location module never
    published one (module off): no row.
    """
    if not isinstance(value, dict):
        return None
    raw_source = value.get("source")
    names = [n for n in (raw_source.split(",") if isinstance(raw_source, str) else [])
             if n in _GPS_SOURCES]
    state = value.get("state")
    last_ts = _num_or_none(value.get("last_ts"))
    inputs = []
    # gps.source_state is IPC-relayable: a malformed "inputs" (5, a string)
    # must cost the GPS row, never the whole /api/data payload.
    raw_inputs = value.get("inputs")
    for item in raw_inputs if isinstance(raw_inputs, list) else []:
        if len(inputs) >= len(_GPS_SOURCES):
            break
        if not isinstance(item, dict) or item.get("source") not in _GPS_SOURCES:
            continue
        istate = item.get("state")
        inputs.append({"source": item["source"],
                       "state": istate if istate in _GPS_INPUT_STATES else "unknown"})
    running = {i["source"] for i in inputs} | set(names)
    return {
        "source": ",".join(dict.fromkeys(names)),
        "state": state if state in _GPS_STATES else "no_fix",
        "peer": _gps_peer_ip(value.get("peer")),
        "last_ts": last_ts if last_ts is not None and last_ts > 0 else None,
        "inputs": inputs,
        "udp_port": _gps_port(cfg, "udp") if "udp" in running else None,
        "tcp_port": _gps_port(cfg, "tcp") if "tcp" in running else None,
    }


def _dial_result_summary(value: Any) -> Optional[dict]:
    """``bt.dial_result`` → ``{ok, error, ts}`` with a known error code only.

    ``ok`` is None only for error "unknown" (oFono did not answer Dial() in
    time — the call may be going out; A8 keeps its overlay).
    """
    if not isinstance(value, dict):
        return None
    from src.multimedia.bluetooth import DIAL_ERRORS
    error = value.get("error")
    error = error if error in DIAL_ERRORS else None
    ok = value.get("ok")
    return {
        "ok": True if ok is True else (None if ok is None and error == "unknown" else False),
        "error": error,
        "ts": _num_or_none(value.get("ts")),
    }


# ── Network access policy (Flask before_request) ─────────────────────────
# The dashboard listens on 0.0.0.0:5002 without authentication: anyone who
# can reach it could reboot the car PC, read the Wi-Fi passwords or type
# into Android Auto. dashboard.remote_access limits what NON-loopback
# clients may do; the kiosk itself (Chromium on this machine, 127.0.0.1/::1)
# always has full access, whatever the mode.
#
#   full      every client, every route, from anywhere — the legacy
#             behaviour and the code default (production unchanged).
#             allowed_networks is NOT applied in this mode. Recommended
#             for production instead: "tracking" (a phone can still fetch
#             GPX; nothing can reboot the PC, read passwords or dial).
#             POST /api/phone/dial refuses emergency numbers from the
#             network and is rate-limited even here.
#   readonly  GET/HEAD views on the allow-list _READONLY_ENDPOINTS and the
#             data WebSocket (/ws) from allowed_networks; never POST/DELETE
#             or /ws/input. An ALLOW-list on purpose: a GET with side
#             effects (/api/dtc/read talks to the ECU, the geocoding
#             searches spend the API key quota) or one that hands out
#             secrets must not become reachable just because it is a GET,
#             and a route added later stays kiosk-only until someone
#             decides otherwise (tests/test_web_routes.py makes every GET
#             view be classified). Everything the dashboard shows (phone,
#             media, position) is still visible — it is a view.
#   tracking  only the trip list and GPX download (/trips, /api/tracking/*)
#             from allowed_networks — the test car's setting: the phone
#             browser fetches GPX, nothing else is reachable from Wi-Fi/PAN.
#   none      loopback only.
#
# Outside dashboard.allowed_networks every request is refused unless the
# mode is full. In readonly/tracking the Host header must also be an IP
# address or a name listed in dashboard.allowed_hosts: that defeats DNS
# rebinding, where a page from a hostile site in the phone's browser has
# its name re-pointed at 10.0.0.1 — the request then comes from the phone
# (an allowed network) with Host "evil.example:5002", and Origin agrees
# with Host, so the /ws Origin check cannot see it.
# The decision is made on the matched endpoint (the view
# that would run), not on the raw path, so ".." / "//" / encoding tricks
# cannot reach a view the mode does not list; unknown URLs are refused
# too. flask-sock WebSocket routes are ordinary Flask routes, so the
# before_request hook runs before their handshake as well.
# X-Forwarded-For is ignored on purpose: there is no proxy in front of
# the dashboard, and the header is whatever the client wants it to be.
_REMOTE_ACCESS_MODES = ("full", "readonly", "tracking", "none")
_DEFAULT_ALLOWED_NETWORKS = ("10.0.0.0/8", "172.16.0.0/12", "192.168.0.0/16")
_SAFE_METHODS = ("GET", "HEAD")
#: Views reachable from the network in "tracking" mode (GET/HEAD only).
_TRACKING_ENDPOINTS = frozenset({"trips_page", "api_tracking_trips", "api_tracking_trip_gpx"})
#: GET views reachable from the network in "readonly" mode — read-only
#: views of what the dashboard shows (static files, state, lists).
_READONLY_ENDPOINTS = frozenset({
    "index", "static", "css", "js", "assets", "splash_asset", "api_i18n",
    "api_data", "api_config_get", "api_modules_get", "api_swc_get",
    "api_swc_learn_status", "api_audio_eq_get", "api_ready_get", "api_boot_mode",
    "api_dvr_list", "api_dvr_play", "api_dvr_usb_status", "api_dvr_usb_browse",
    "aa_status", "aa_config_get", "bt_status", "bt_devices", "bt_connected",
    "bt_pairing_status", "api_radio_status", "api_phone_contacts",
    "api_phone_history", "api_phone_status", "api_trip_route", "api_debug_weather",
    "api_tracking_trips", "api_tracking_trip_gpx", "trips_page", "ws_data_handler",
})
#: GET views deliberately kept OFF the readonly allow-list (documentation,
#: and the test that every GET view is classified): /ws/input injects keys
#: and AA touches; /api/wifi/config returns the Wi-Fi passwords; the
#: AA/camera streams and the camera probe open exclusive devices (and
#: would retire the kiosk's own AA stream — only two may run);
#: /api/dtc/read makes K-Line traffic with the ECU and holds a server
#: thread for up to 3 s; the two searches call OpenWeatherMap with our key.
_READONLY_DENIED_ENDPOINTS = frozenset({
    "ws_input_handler", "api_wifi_config_get", "aa_stream",
    "camera_stream", "camera_available", "api_dtc_read",
    "api_weather_search", "api_trip_search",
    # the crash SMS recipients are personal data (phone numbers): kiosk only
    # in every mode (the view also refuses non-loopback clients itself)
    "api_crash_recipients_get",
})
_HOSTNAME_RE = re.compile(r"[a-z0-9](?:[a-z0-9.-]{0,251}[a-z0-9])?")
#: One "refused" log line per client address per this many seconds.
_ACCESS_LOG_EVERY_S = 60.0


def _client_ip(remote_addr: Any) -> Optional[Any]:
    """``REMOTE_ADDR`` → ipaddress object (IPv4-mapped IPv6 unwrapped)."""
    if not isinstance(remote_addr, str) or not remote_addr:
        return None
    try:
        ip = ipaddress.ip_address(remote_addr.split("%", 1)[0])
    except ValueError:
        return None
    if ip.version == 6 and ip.ipv4_mapped is not None:
        ip = ip.ipv4_mapped
    return ip


def _host_name(host: Any) -> str:
    """``Host`` header → lower-case name/address without port ("" if none).

    ``10.0.0.1:5002`` → ``10.0.0.1``; ``[fe80::1]:5002`` → ``fe80::1``;
    a trailing dot (``bcm.local.``) is dropped so it matches the list.
    """
    if not isinstance(host, str):
        return ""
    host = host.strip().lower()
    if host.startswith("["):
        end = host.find("]")
        return host[1:end] if end > 0 else ""
    if host.count(":") == 1:
        host = host.split(":", 1)[0]
    return host.rstrip(".")


def _host_allowed(host: Any, allowed_hosts: tuple) -> bool:
    """IP literal, or a name from ``dashboard.allowed_hosts`` (rebinding guard)."""
    name = _host_name(host)
    if not name:
        return False
    try:
        ipaddress.ip_address(name)
        return True
    except ValueError:
        return name in allowed_hosts


def _load_access_policy(cfg: Any) -> tuple[str, tuple, tuple]:
    """``dashboard.{remote_access, allowed_networks, allowed_hosts}`` →
    (mode, networks, host names).

    A value that is not a known mode fails CLOSED ("none": the kiosk keeps
    working, the network gets nothing) — a typo must not open everything.
    ``allowed_hosts`` defaults to none: only IP addresses in ``Host``.
    """
    raw_mode = cfg.get("dashboard.remote_access", "full") if cfg is not None else "full"
    if raw_mode is None:
        raw_mode = "full"
    mode = raw_mode.strip().lower() if isinstance(raw_mode, str) else None
    if mode not in _REMOTE_ACCESS_MODES:
        log.error("dashboard.remote_access=%r is not one of %s — using 'none' "
                  "(only the kiosk on this machine)", raw_mode, "/".join(_REMOTE_ACCESS_MODES))
        mode = "none"
    raw_nets = cfg.get("dashboard.allowed_networks", None) if cfg is not None else None
    if raw_nets is None:
        raw_nets = list(_DEFAULT_ALLOWED_NETWORKS)
    elif isinstance(raw_nets, str):
        raw_nets = [raw_nets]
    if not isinstance(raw_nets, (list, tuple)):
        log.error("dashboard.allowed_networks=%r is not a list — no remote network allowed",
                  raw_nets)
        raw_nets = []
    networks = []
    for entry in raw_nets:
        try:
            networks.append(ipaddress.ip_network(str(entry), strict=False))
        except ValueError:
            log.warning("dashboard.allowed_networks: %r is not a CIDR — ignored", entry)
    raw_hosts = cfg.get("dashboard.allowed_hosts", None) if cfg is not None else None
    if raw_hosts is None:
        raw_hosts = []
    elif isinstance(raw_hosts, str):
        raw_hosts = [raw_hosts]
    if not isinstance(raw_hosts, (list, tuple)):
        log.error("dashboard.allowed_hosts=%r is not a list — only IP addresses allowed",
                  raw_hosts)
        raw_hosts = []
    hosts = []
    for entry in raw_hosts:
        name = entry.strip().lower().rstrip(".") if isinstance(entry, str) else ""
        if _HOSTNAME_RE.fullmatch(name):
            hosts.append(name)
        else:
            log.warning("dashboard.allowed_hosts: %r is not a host name — ignored", entry)
    return mode, tuple(networks), tuple(hosts)


def _access_decision(remote_addr: Any, method: str, endpoint: Optional[str],
                     mode: str, networks: tuple, host: Any = None,
                     allowed_hosts: tuple = ()) -> Optional[tuple[str, str]]:
    """None = allowed; else ``(config_key, reason)`` for the 403.

    ``host`` is the request's ``Host`` header (checked for remote clients
    in readonly/tracking; a missing one is refused, browsers always send it).
    """
    ip = _client_ip(remote_addr)
    if ip is not None and ip.is_loopback:
        return None                         # the kiosk: always full access
    if mode == "full":
        return None
    if mode == "none":
        return ("dashboard.remote_access",
                "remote access is 'none': only the kiosk on this machine")
    if ip is None or not any(ip in net for net in networks):
        return ("dashboard.allowed_networks",
                f"{remote_addr} is outside dashboard.allowed_networks")
    if not _host_allowed(host, allowed_hosts):
        # repr + truncation: the header is the client's text and ends up
        # in the log line.
        return ("dashboard.allowed_hosts",
                f"Host {_host_name(host)[:64]!r} is neither an IP address nor "
                f"listed in dashboard.allowed_hosts (DNS rebinding guard)")
    if mode == "readonly":
        if method not in _SAFE_METHODS:
            return ("dashboard.remote_access", "remote access is 'readonly': GET only")
        if endpoint not in _READONLY_ENDPOINTS:
            return ("dashboard.remote_access",
                    "remote access is 'readonly': not available from the network")
        return None
    # tracking
    if method in _SAFE_METHODS and endpoint in _TRACKING_ENDPOINTS:
        return None
    return ("dashboard.remote_access",
            "remote access is 'tracking': only /trips and /api/tracking/* from the network")


# ── Trips (src/location/tracker.py) ──────────────────────────────────────
_TRIPS_DEFAULT_LIMIT = 50
_LIMIT_RE = re.compile(r"-?[0-9]{1,9}")
_TRIPS_MAX_LIMIT = 500
#: Trips listed on the /trips page.
_TRIPS_PAGE_LIMIT = 100
#: SQLite INTEGER range; a larger id from the URL is simply "not found".
_MAX_TRIP_ID = 2**63 - 1
_TRIPS_CSP = ("default-src 'none'; style-src 'unsafe-inline'; base-uri 'none'; "
              "form-action 'none'; frame-ancestors 'none'")


def _clamp_limit(raw: Any) -> int:
    """``?limit=`` → int in 1..500 (default 50 when missing or not a number).

    One strict pattern instead of str methods: ``"--5".lstrip("-")`` passes
    isdigit() and int() then raised (HTTP 500 + traceback on demand), and
    isdigit() also accepts non-ASCII digits.
    """
    if raw is None:
        return _TRIPS_DEFAULT_LIMIT
    text = str(raw).strip()
    if not _LIMIT_RE.fullmatch(text):
        return _TRIPS_DEFAULT_LIMIT
    return min(max(int(text), 1), _TRIPS_MAX_LIMIT)


def _num_or_none(value: Any) -> Optional[float]:
    if isinstance(value, bool) or not isinstance(value, (int, float)):
        return None
    value = float(value)
    return value if math.isfinite(value) else None


def _trip_json(trip: Any) -> Optional[dict]:
    """One tracker trip → the JSON the API returns (numbers only)."""
    if not isinstance(trip, dict):
        return None
    trip_id = trip.get("trip_id")
    if isinstance(trip_id, bool) or not isinstance(trip_id, int):
        return None
    points = trip.get("points")
    points = points if isinstance(points, int) and not isinstance(points, bool) else 0
    return {
        "trip_id": trip_id,
        "start_ts": _num_or_none(trip.get("start_ts")),
        "end_ts": _num_or_none(trip.get("end_ts")),
        "distance_km": _num_or_none(trip.get("distance_km")),
        "avg_speed": _num_or_none(trip.get("avg_speed")),
        "max_speed": _num_or_none(trip.get("max_speed")),
        "points": points,
        "gpx_url": f"/api/tracking/trips/{trip_id}.gpx" if points else None,
    }


def _local_time(ts: Any, fmt: str) -> str:
    ts = _num_or_none(ts)
    if ts is None:
        return ""
    try:
        return time.strftime(fmt, time.localtime(ts))
    except (OverflowError, OSError, ValueError):
        return ""


def _render_trips_html(trips: Optional[list], gps_line: str) -> str:
    """The phone-browser trip list. Every dynamic value is HTML-escaped.

    Inline styles only (the dashboard's Tailwind is precompiled, and this
    page loads nothing else — its CSP forbids it).
    """
    esc = html.escape
    cards = []
    if trips is None:
        cards.append('<p style="color:#f59e0b">Rejestrator tras jest wyłączony '
                     '(modules.tracking) albo baza tras jest niedostępna.</p>')
    elif not trips:
        cards.append('<p style="color:#a1a1aa">Brak zapisanych tras.</p>')
    for raw in trips or []:
        trip = _trip_json(raw)
        if trip is None:
            continue
        start = _local_time(trip["start_ts"], "%Y-%m-%d %H:%M")
        end = _local_time(trip["end_ts"], "%H:%M") if trip["end_ts"] is not None else "w trakcie"
        dist = trip["distance_km"]
        avg = trip["avg_speed"]
        vmax = trip["max_speed"]
        stats = [f"{dist:.1f} km" if dist is not None else "— km",
                 f"śr. {avg:.0f} km/h" if avg is not None else "",
                 f"maks. {vmax:.0f} km/h" if vmax is not None else "",
                 f"{trip['points']} pkt"]
        link = (f'<a href="{esc(trip["gpx_url"])}" style="display:inline-block;margin-top:8px;'
                f'padding:8px 14px;border-radius:8px;background:#b91c1c;color:#fff;'
                f'text-decoration:none;font-weight:600">Pobierz GPX</a>'
                if trip["gpx_url"] else
                '<span style="display:inline-block;margin-top:8px;color:#71717a">brak punktów</span>')
        cards.append(
            '<div style="background:#18181b;border:1px solid #3f3f46;border-radius:12px;'
            'padding:12px 14px;margin:0 0 10px 0">'
            f'<div style="font-weight:700;font-size:16px">Trasa {esc(str(trip["trip_id"]))}</div>'
            f'<div style="color:#d4d4d8;margin-top:2px">{esc(start)} → {esc(end)}</div>'
            f'<div style="color:#a1a1aa;margin-top:2px">{esc(" · ".join(s for s in stats if s))}</div>'
            f'{link}</div>')
    return (
        '<!doctype html>\n<html lang="pl"><head><meta charset="utf-8">'
        '<meta name="viewport" content="width=device-width,initial-scale=1">'
        '<title>Trasy — BCM</title></head>'
        '<body style="margin:0;padding:16px;background:#09090b;color:#f4f4f5;'
        'font-family:system-ui,-apple-system,Segoe UI,Roboto,sans-serif;font-size:15px;'
        'line-height:1.4">'
        '<h1 style="font-size:20px;margin:0 0 4px 0">Zapisane trasy</h1>'
        f'<p style="color:#a1a1aa;margin:0 0 14px 0">{esc(gps_line)}</p>'
        + "".join(cards) +
        '<p style="color:#71717a;font-size:12px;margin-top:16px">GPX 1.1 — otworzysz go '
        'w aplikacji z mapami (np. OsmAnd, Google Earth).</p>'
        "</body></html>\n")


class WebViewer:
    """HTML5/Tailwind dashboard served via Flask + WebSocket.

    Provides real-time event bus data to the browser via WebSocket
    and accepts keyboard input from the browser.
    """

    def __init__(self, host: str = "0.0.0.0", port: int = 5002,
                 event_bus=None, config=None, bt_manager=None,
                 trip_computer=None, route_planner=None,
                 wifi_ap=None, boot_module_runs=None) -> None:
        self.host = host
        self.port = port
        self._event_bus = event_bus
        self._config = config
        self._bt_manager = bt_manager
        self._wifi_ap = wifi_ap
        self._trip_computer = trip_computer
        self._route_planner = route_planner
        self._thread: Optional[threading.Thread] = None
        self._running = False
        self._ws_clients: list = []
        self._ws_lock = threading.Lock()
        self._broadcast_thread: Optional[threading.Thread] = None
        # Kiosk readiness gate for the boot/wake splash. Starts False so the
        # splash always waits for a fresh paint; flipped True by App.init()
        # POSTing /api/ready, and reset to False (e.g. from the resume hook
        # via /api/ready-reset) so the splash replays on every wake instead
        # of self-dismissing against a stale flag from the previous boot.
        self._kiosk_ready = False

        # Path to the web frontend files
        self._web_dir = os.path.join(os.path.dirname(__file__), "web")

        # AA touch injection (src/multimedia/aa_input.py), built on first use
        # so a dashboard without AA never starts the worker thread.
        self._aa_injector = None
        self._aa_injector_lock = threading.Lock()

        # Network access policy: last "refused" log time per client address
        # (monotonic; bounded — see _log_refusal).
        self._access_log_lock = threading.Lock()
        self._access_log_last: dict[str, float] = {}

        # POST /api/phone_tether/retry rate limit (monotonic: bcm-timesync
        # may move the wall clock right after the link comes up).
        self._tether_retry_lock = threading.Lock()
        self._tether_retry_last: Optional[float] = None
        # POST /api/car_phone/retry rate limit (monotonic, as above).
        self._car_phone_retry_lock = threading.Lock()
        self._car_phone_retry_last: Optional[float] = None
        # POST /api/car_phone_agent/pair rate limit (monotonic, as above).
        self._agent_pair_lock = threading.Lock()
        self._agent_pair_last: Optional[float] = None
        # /api/crash/* rate limits: last accepted request per route (monotonic).
        self._crash_lock = threading.Lock()
        self._crash_last: dict[str, float] = {}

        # POST /api/phone/dial rate limit: last accepted dial per bucket
        # ("kiosk" = loopback, "network" = everyone else), monotonic.
        self._dial_lock = threading.Lock()
        self._dial_last: dict[str, float] = {}

        # /aa/stream bookkeeping: generation ids of the live MJPEG streams
        # (oldest first) and each one's ffmpeg, so a newer stream can stop an
        # older one's capture even while that request thread is blocked.
        self._aa_stream_lock = threading.Lock()
        self._aa_stream_seq = 0
        self._aa_stream_active: list[int] = []
        self._aa_stream_procs: dict[int, Any] = {}

        # Which modules run in THIS process. /api/modules compares the saved
        # toggles with it, so "wymaga restartu BCM" appears only where a
        # restart would actually change something. main.py hands over what
        # it really started (``boot_module_runs`` — also right for a run
        # with --modules, which the config alone does not know about); only
        # without it (tests, the Pygame renderer) is it recomputed from the
        # config, which at this point still matches the start-up decision.
        if isinstance(boot_module_runs, dict):
            self._modules_boot_runs = {str(k): bool(v) for k, v in boot_module_runs.items()}
        else:
            self._modules_boot_runs = self._modules_runs(config)

        # Forward voice-AA trigger to autoapp (M key or tap on the mic icon)
        if event_bus:
            event_bus.subscribe("aa.voice_trigger", self._on_aa_voice_trigger)
            # Xvfb is torn down on stop/restart — drop queued touches and the
            # pressed-button state that belonged to the old X server.
            event_bus.subscribe("multimedia.openauto_status",
                                self._on_openauto_status)

    @staticmethod
    def _modules_runs(config) -> Optional[dict]:
        """``{name: runs}`` for this config; None if it cannot be resolved
        (no config, a plain dict in tests)."""
        if config is None or not hasattr(config, "is_module_enabled"):
            return None
        try:
            from src.core import modules_catalog
            return {name: st.runs for name, st in modules_catalog.module_states(config).items()}
        except Exception:
            log.exception("Module state snapshot failed")
            return None

    def _modules_payload(self, config) -> list:
        """/api/modules list: the catalog with requires/hardware/available/
        blocked_by/needs and, with a boot snapshot, restart_pending."""
        from src.core.modules_catalog import catalog_state
        return catalog_state(config, self._modules_boot_runs)

    def attach_trip(self, trip_computer, route_planner=None) -> None:
        """Attach trip computer + planner after construction.

        Used by the dashboard renderer which owns the TripComputer
        instance — it wires it up before calling ``start()``.
        """
        self._trip_computer = trip_computer
        if route_planner is not None:
            self._route_planner = route_planner

    def start(self) -> None:
        """Start the Flask web server in a background thread."""
        if not HAS_FLASK:
            log.warning("Flask not installed — web viewer disabled.")
            return

        self._running = True
        self._thread = threading.Thread(target=self._run_server, daemon=True)
        self._thread.start()

        # Start broadcast thread for pushing event bus data to WebSocket clients
        self._broadcast_thread = threading.Thread(
            target=self._broadcast_loop, daemon=True
        )
        self._broadcast_thread.start()

        log.info("Web viewer started at http://%s:%d", self.host, self.port)

    def stop(self) -> None:
        self._running = False
        injector = self._aa_injector
        if injector is not None:
            injector.stop()

    def _get_dashboard_data(self) -> dict:
        """Collect all current event bus values into a JSON-serializable dict."""
        bus = self._event_bus
        if bus is None:
            return {}

        def _val(topic: str, default: Any = None) -> Any:
            result = bus.get_last(topic)
            return result[0] if result is not None else default

        # Weather: weather.py publishes weather.current as a single dict
        _wc = _val("weather.current", {})
        if not isinstance(_wc, dict):
            _wc = {}

        data = {
            # Engine
            "rpm": _val("obd.rpm", 0),
            "speed": _val("obd.speed", 0),
            "coolant_temp": _val("obd.coolant_temp", 0),
            "fuel_level": _val("obd.fuel_level", 50),
            "fuel_rate": _val("obd.fuel_rate", 0),
            "battery_voltage": _val("obd.battery_voltage", 12.6),
            "boost": _val("obd.boost", 0),
            "oil_pressure": _val("obd.oil_pressure", 0),
            # Trip
            "trip_distance": _val("trip.distance", 0),
            "trip_time": _val("trip.time_str", "00:00:00"),
            "trip_fuel_used": _val("trip.fuel_used", 0),
            "avg_speed": _val("trip.avg_speed", 0),
            "avg_consumption": _val("trip.avg_consumption", 0),
            "instant_consumption": _val("trip.instant_consumption", 0),
            "estimated_range": _val("trip.estimated_range", 0),
            # Service
            "service_km": _val("service.km_remaining", 4500),
            "oil_level_pct": _val("service.oil_level", -1),
            "tpms_pressures": _val("service.tpms_pressures", [0, 0, 0, 0]),
            # State
            "gear": _val("vehicle.gear", "N"),
            # Reverse / camera routing. The reverse view now lives on the MAIN
            # display (rear large + L/R side-cam insets + sensor bar + beep);
            # camera_active is the CameraController's resolved feed
            # ("rear"/"left"/"right"/None), reverse_gear the raw signal.
            "reverse_gear": _val("power.reverse_gear", False),
            "camera_active": _val("camera.active_feed", None),
            "defrost_active": _val("vehicle.defrost", False),
            # External
            "ext_temp": _val("env.temperature", None),
            # GPS
            "gps_lat": _val("gps.lat", 0),
            "gps_lon": _val("gps.lon", 0),
            "gps_speed": _val("gps.speed", 0),
            "gps_heading": _val("gps.heading", 0),
            "gps_fix": _val("gps.fix", False),
            "gps_satellites": _val("gps.satellites", 0),
            # Which input feeds the GPS and whether it has a fix — Settings
            # shows it with a hint where to send NMEA (None = module off).
            "gps_state": _gps_state_summary(_val("gps.source_state"), self._config),
            # Weather
            "weather_condition": _wc.get("condition", ""),
            "weather_temp": _wc.get("temp", None),
            "weather_feels_like": _wc.get("feels_like", None),
            "weather_humidity": _wc.get("humidity", 0),
            "weather_wind_speed": _wc.get("wind_speed", 0),
            "weather_city": _val("weather.city", ""),
            "weather_forecast": _val("weather.forecast", []),
            "weather_lat": _val("weather.lat", None),
            "weather_lon": _val("weather.lon", None),
            # Increments each time the WeatherManager finishes an immediate
            # fetch after a location change — used by A4 Weather to drop
            # the "Loading..." spinner reactively (no hardcoded setTimeout).
            "weather_search_done": _val("weather.search_done", 0),
            # Travel plan (A3 Trip — only populated when destination is set)
            "trip_plan": (self._trip_computer.get_plan_dict()
                          if self._trip_computer else None),
            "trip_planning": _val("trip.planning", False),
            # BT Media
            "bt_media_title": _val("bt.media_title", ""),
            "bt_media_artist": _val("bt.media_artist", ""),
            "bt_media_album": _val("bt.media_album", ""),
            "bt_media_playing": _val("bt.media_playing", False),
            "bt_media_position": _val("bt.media_position", 0),
            "bt_media_duration": _val("bt.media_duration", 0),
            # Connectivity
            "bt_connected": _val("bt.connected", False),
            "bt_available": self._bt_manager.available if self._bt_manager else False,
            "bt_call_state": _val("bt.call_state", "idle"),
            "bt_call_info": _val("bt.call_info", {}),
            # Outcome of the last dial (src/multimedia/bluetooth.py): A8 drops
            # its instant "ringing" overlay when it failed. None = no dial yet.
            "bt_dial_result": _dial_result_summary(_val("bt.dial_result")),
            "aa_status": _val("multimedia.openauto_status", "unavailable"),
            "aa_available": _val("multimedia.openauto_status", "unavailable") in (
                "running", "connected", "restarting"),
            "aa_auto_restart": _val("multimedia.aa_auto_restart",
                                   self._config.get("multimedia.aa_auto_restart", True) if self._config else True),
            # Bumped by OpenAutoController each time Xvfb (re)starts; A2
            # reconnects its MJPEG <img> when it changes.
            "aa_stream_epoch": _val("multimedia.aa_stream_epoch", 0),
            "lte_connected": _val("lte.connected", False),
            # src/network/lte.py publishes lte.signal (0-5 bars); the old
            # lte.signal_strength key was never published, so this was 0.
            "lte_signal": _val("lte.signal", 0),
            # Internet from the phone (src/network/phone_tether.py).
            "phone_tether": _phone_tether_summary(_val("net.phone_tether")),
            # The phone mounted in the car (src/network/car_phone.py): USB
            # tethering, GPS forward, battery. None = module not running.
            "car_phone": _car_phone_summary(_val("net.car_phone")),
            # The Termux agent on that phone (src/network/car_phone_agent.py):
            # pairing / health for the Settings row. None = module not running.
            "car_phone_agent": _car_phone_agent_summary(_val(_AGENT_TOPIC)),
            # The crash SMS window (src/safety/crash_sms.py, crash.sms_state):
            # app.js shows #crash-modal on every screen from it. Whitelisted,
            # no phone numbers; None = module not running.
            "crash_sms": _crash_sms_summary(_val(_crash_sms.TOPIC_STATE)),
            # Phone battery / signal / operator for the top bar
            # (src/multimedia/phone_status.py). Re-sanitised here: values come
            # from the phone; None = module not running (no cluster drawn).
            "phone_status": _phone_status_summary(_val("bt.phone_status")),
            # Audio
            "audio_volume": _val("audio.volume", 70),
            "audio_muted": _val("audio.mute_changed", False),
            "audio_eq_preset": _val("audio.eq_preset", "jazz"),
            "audio_eq_gains": _val("audio.eq_gains", [0] * 10),
            "audio_spectrum": _val("audio.spectrum", [0] * 16),
            "audio_bass": _val("audio.bass", 0),
            "audio_treble": _val("audio.treble", 0),
            "audio_fader": _val("audio.fader", 0),
            "audio_balance": _val("audio.balance", 0),
            # Notifications (src/core/notifications.py) — expired entries are
            # dropped here, the topic itself is only republished on news.
            "notifications": active_notifications(_val("system.notifications", [])),
            # Vehicle status (from Arduino serial)
            "vehicle_doors": _val("vehicle.doors", {}),
            "vehicle_handbrake": _val("vehicle.handbrake", False),
            "vehicle_cruise": _val("vehicle.cruise", False),
            "vehicle_immo_ok": _val("vehicle.immo_ok", True),
            "vehicle_airbag_ok": _val("vehicle.airbag_ok", True),
            "vehicle_rain": _val("vehicle.rain", False),
            # Parking
            "parking_distances": _val("parking.distances", []),
            "parking_active": _val("parking.active", False),
            # SWC navigation (edge-triggered — see reset below)
            "navigate_aa": _val("input.navigate_aa", False),
            "home": _val("input.home", False),
        }
        # The browser's DataStore only fires subscribers on value *change*, so
        # a latched True would navigate once and never again (and would nav
        # spuriously on reload). Emit True for exactly one broadcast frame then
        # reset to False, so every HOME/NAV press re-fires.
        for _nav in ("input.navigate_aa", "input.home"):
            if _val(_nav, False):
                bus.publish(_nav, False)
        return data

    def _handle_browser_key(self, key: str) -> None:
        """Map browser key to event bus input."""
        if self._event_bus is None:
            return
        mapped = _BROWSER_KEY_MAP.get(key, key.lower())
        self._event_bus.publish("input.raw_keyname", mapped)
        log.debug("Browser key: %s -> %s", key, mapped)

    def _on_aa_voice_trigger(self, topic: str, value, timestamp: float) -> None:
        """Press AA's voice control when the voice button is pressed.

        ``multimedia.aa_voice_method``: ``key`` sends the M key (autoapp:
        Qt::Key_M -> MICROPHONE_1), ``tap`` (default) taps the AA mic icon.
        The key only works when the running autoapp was started with
        VoiceCommandButton=true (there was a mic at the time); otherwise
        this falls back to the tap. Whether a press may reach AA at all
        (no mic -> notification) is decided upstream in VoiceAAHandler.

        Goes through the touch injector: same canvas size as Xvfb and the
        touch path (this used to read display.multimedia.* with a 504 px
        fallback), serialised with touches, and no 2 s subprocess call on
        the event-bus thread.
        """
        if not value:
            return
        from src.input.voice_aa import voice_method
        method = voice_method(self._config)
        injector = self._get_aa_injector()
        if method == "key":
            openauto = self._openauto()
            if openauto is not None and getattr(openauto, "voice_button_enabled", True) is False:
                log.info("Voice-AA: VoiceCommandButton is off in the running "
                         "autoapp (no mic when AA started) — tapping instead")
            elif injector is None or not injector.submit_key("m", client="voice"):
                log.warning("Voice-AA: key could not be queued (xdotool missing?)")
                return
            else:
                log.info("Voice-AA: sending the voice key (M) to autoapp")
                return
        rel_x, rel_y = 0.05, 0.08
        if injector is None or not injector.submit("tap", rel_x, rel_y, client="voice"):
            log.warning("Voice-AA: tap could not be queued (xdotool missing?)")
            return
        px, py = injector.to_pixels(rel_x, rel_y) or (0, 0)
        log.info("Voice-AA: tapping AA mic icon at (%d, %d)", px, py)

    # ── Trips / GPS helpers ──────────────────────────────────────────────

    def _tracker(self) -> Any:
        """The running GPSTracker (``tracking._internals``), or None."""
        if self._event_bus:
            result = self._event_bus.get_last("tracking._internals")
            if result and isinstance(result[0], dict):
                return result[0].get("tracker")
        return None

    def _gps_status_line(self) -> str:
        """One line about the GPS for the /trips page (shown escaped)."""
        bus = self._event_bus
        if bus is None:
            return "GPS: brak danych"
        fix = bus.get_last("gps.fix")
        state = bus.get_last("gps.source_state")
        info = state[0] if state and isinstance(state[0], dict) else {}
        if fix is None and not info:
            return "GPS: brak danych (moduł location wyłączony albo brak sygnału)"
        if fix is not None and fix[0] is True:
            source = str(info.get("source") or "")[:16]
            peer = str(info.get("peer") or "")[:64]
            detail = ", ".join(x for x in (source, peer) if x)
            return f"GPS: jest pozycja ({detail})" if detail else "GPS: jest pozycja"
        return "GPS: brak pozycji — sprawdź aplikację GPS w telefonie"

    def _emergency_numbers(self) -> frozenset:
        """oFono's EmergencyNumbers via the BluetoothManager (empty if unknown)."""
        getter = getattr(self._bt_manager, "emergency_numbers", None)
        if not callable(getter):
            return frozenset()
        try:
            return frozenset(getter())
        except Exception:
            log.debug("emergency_numbers() failed", exc_info=True)
            return frozenset()

    def _log_refusal(self, addr: str, method: str, path: str, key: str, reason: str,
                     level: int = logging.INFO) -> None:
        """A log line for a refused request, at most once a minute per address."""
        now = time.monotonic()
        with self._access_log_lock:
            last = self._access_log_last.get(addr)
            if last is not None and 0 <= now - last < _ACCESS_LOG_EVERY_S:
                return
            if len(self._access_log_last) >= 256:
                self._access_log_last.clear()
            self._access_log_last[addr] = now
        emit = log.warning if level >= logging.WARNING else log.info
        emit("Refused %s %r from %s: %s (%s; further refusals from this "
             "address are not logged for %.0f s)", method, path[:100], addr,
             reason, key, _ACCESS_LOG_EVERY_S)

    # ── Android Auto helpers ─────────────────────────────────────────────

    def _openauto(self) -> Any:
        """The running OpenAutoController, if the multimedia module is up."""
        if self._event_bus:
            result = self._event_bus.get_last("multimedia._internals")
            if result and result[0]:
                return result[0].get("openauto")
        return None

    def _aa_canvas_size(self) -> tuple[int, int]:
        """AA canvas size — the one Xvfb, the MJPEG capture and touch use.

        Imported lazily so the web viewer doesn't hard-fail if the
        multimedia module is missing (e.g. when AA is disabled).
        """
        cfg = self._config
        try:
            from src.multimedia.openauto import _aa_canvas_size
            return _aa_canvas_size(cfg) if cfg else (1024, 504)
        except Exception:
            w = cfg.get("display.multimedia.width", 1024) if cfg else 1024
            h = cfg.get("display.multimedia.height", 504) if cfg else 504
            try:
                return int(w), int(h)
            except (TypeError, ValueError):
                return 1024, 504

    def _get_aa_injector(self) -> Any:
        """The touch injector, created on first use; None if it can't be."""
        if self._aa_injector is None:
            with self._aa_injector_lock:
                if self._aa_injector is None:
                    try:
                        from src.multimedia.aa_input import AATouchInjector
                        self._aa_injector = AATouchInjector(size_fn=self._aa_canvas_size)
                    except Exception:
                        log.exception("AA touch injector unavailable")
                        return None
        return self._aa_injector

    def _release_aa_touch(self, client_key: Hashable) -> None:
        """Release the AA button if ``client_key`` holds it. Never raises."""
        injector = self._aa_injector
        if injector is None:
            return
        try:
            injector.release(client_key)
        except Exception:
            log.debug("AA touch release failed", exc_info=True)

    def _on_openauto_status(self, topic: str, value: Any, timestamp: float) -> None:
        if value in ("stopped", "restarting"):
            injector = self._aa_injector
            if injector is not None:
                injector.reset()

    def _handle_input_message(self, msg: Any, client_key: Hashable = None) -> bool:
        """Dispatch one /ws/input message. Never raises; True if acted on.

        Accepts the raw WebSocket payload (str/bytes) or an already decoded
        dict. Messages:
          ``{"type": "keydown", "key": "<KeyboardEvent.key>"}``
          ``{"type": "aa_touch", "action": "down|move|up|cancel|tap",
             "x": 0..1, "y": 0..1}``
        Anything else — oversized, not JSON, wrong types — is dropped.
        """
        try:
            if isinstance(msg, (bytes, bytearray)):
                if len(msg) > _MAX_INPUT_MESSAGE:
                    return False
                msg = bytes(msg).decode("utf-8")
            if isinstance(msg, str):
                if len(msg) > _MAX_INPUT_MESSAGE:
                    return False
                data = json.loads(msg)
            else:
                data = msg
            if not isinstance(data, dict):
                return False
            kind = data.get("type")
            if kind == "keydown":
                key = data.get("key")
                if not isinstance(key, str) or not key or len(key) > _MAX_KEY_NAME:
                    return False
                self._handle_browser_key(key)
                return True
            if kind == "aa_touch":
                injector = self._get_aa_injector()
                if injector is None:
                    return False
                return injector.submit(data.get("action"), data.get("x"),
                                       data.get("y"), client=client_key)
            return False
        except Exception:
            log.debug("Dropped malformed /ws/input message", exc_info=True)
            return False

    def _serve_input_ws(self, ws: Any) -> None:
        """Read loop of one /ws/input connection.

        Keyboard (SWC pod, OSK) and AA touch share this socket. Message
        handling lives in _handle_input_message(), which never raises: this
        loop used to break on ANY exception, so one malformed message
        silently killed keyboard input until the page was reloaded.
        """
        client_key = id(ws)
        log.info("WebSocket client connected (input)")
        try:
            while self._running:
                try:
                    msg = ws.receive(timeout=1)
                except Exception:
                    break  # connection closed
                if msg is None:
                    continue
                self._handle_input_message(msg, client_key)
        finally:
            # A finger still down when the socket drops would leave the AA
            # button pressed — release whatever this client holds.
            self._release_aa_touch(client_key)
            log.info("WebSocket client disconnected (input)")

    def _aa_stream_alive(self, generation: int) -> bool:
        with self._aa_stream_lock:
            return generation in self._aa_stream_active

    @staticmethod
    def _terminate_stream_proc(proc: Any) -> None:
        """SIGTERM a retired stream's ffmpeg without waiting. Never raises.

        Reaping (wait/kill) stays with the generator that owns ``proc``: the
        newer request must not block on it.
        """
        try:
            proc.terminate()
        except Exception:
            log.debug("AA stream: terminating a retired ffmpeg failed", exc_info=True)

    def _aa_mjpeg_frames(self, popen: Any = None):
        """Yield multipart MJPEG parts captured from Xvfb (:99) by ffmpeg.

        * reads with poll() (``_AA_STREAM_READ_TIMEOUT_S``) and ends the
          stream after ``_AA_STREAM_STALL_S`` without a complete frame, so a
          dead X server frees the thread and ffmpeg;
        * at most ``_AA_STREAM_MAX_CLIENTS`` streams live at once — a new one
          retires the oldest and terminates its ffmpeg right away (that
          generator may be blocked in ``yield`` behind a stalled client and
          would otherwise keep x11grab + JPEG encoding running); the old
          loop then ends on EOF / the liveness check once its write returns.

        ``popen`` is a test seam (``subprocess.Popen`` by default).
        """
        w, h = self._aa_canvas_size()
        retired_procs = []
        with self._aa_stream_lock:
            self._aa_stream_seq += 1
            generation = self._aa_stream_seq
            self._aa_stream_active.append(generation)
            while len(self._aa_stream_active) > _AA_STREAM_MAX_CLIENTS:
                retired = self._aa_stream_active.pop(0)
                retired_proc = self._aa_stream_procs.pop(retired, None)
                if retired_proc is not None:
                    retired_procs.append(retired_proc)
                log.info("AA stream %d retired by newer stream %d", retired, generation)
        for retired_proc in retired_procs:
            self._terminate_stream_proc(retired_proc)
        proc = None
        try:
            try:
                # bufsize=0: a raw pipe, so poll() readiness and os.read()
                # agree (a buffered reader can hide data from poll()).
                proc = (popen or subprocess.Popen)(
                    ["ffmpeg", "-f", "x11grab", "-framerate", "25",
                     "-video_size", f"{w}x{h}",
                     "-draw_mouse", "0",
                     "-i", ":99",
                     "-f", "mjpeg", "-q:v", "3",
                     "-an", "pipe:1"],
                    stdout=subprocess.PIPE, stderr=subprocess.DEVNULL,
                    bufsize=0,
                )
            except Exception as e:
                log.warning("AA stream: ffmpeg could not start: %s", e)
                return
            with self._aa_stream_lock:
                # Retired while ffmpeg was starting? Then the loop below ends
                # at once and the finally block stops this proc.
                if generation in self._aa_stream_active:
                    self._aa_stream_procs[generation] = proc
            fd = proc.stdout.fileno()
            poller = select.poll()
            poller.register(fd, select.POLLIN | select.POLLHUP)
            timeout_ms = int(_AA_STREAM_READ_TIMEOUT_S * 1000)
            buf = b""
            SOI = b"\xff\xd8"
            EOI = b"\xff\xd9"
            last_frame = time.monotonic()
            while self._aa_stream_alive(generation):
                if time.monotonic() - last_frame > _AA_STREAM_STALL_S:
                    log.info("AA stream %d: no frame for %.0fs — closing",
                             generation, _AA_STREAM_STALL_S)
                    break
                try:
                    if not poller.poll(timeout_ms):
                        continue
                    # Readable, hung up or invalid: os.read() returns data,
                    # b"" (EOF) or raises — each handled below.
                    chunk = os.read(fd, 65536)
                except (OSError, ValueError) as e:
                    log.debug("AA stream %d: read failed: %s", generation, e)
                    break
                if not chunk:
                    break  # ffmpeg exited (no X server, killed, …)
                buf += chunk
                while True:
                    start = buf.find(SOI)
                    if start == -1:
                        buf = b""
                        break
                    end = buf.find(EOI, start + 2)
                    if end == -1:
                        buf = buf[start:]
                        break
                    frame = buf[start:end + 2]
                    buf = buf[end + 2:]
                    last_frame = time.monotonic()
                    yield (b"--frame\r\n"
                           b"Content-Type: image/jpeg\r\n\r\n"
                           + frame + b"\r\n")
                if len(buf) > _AA_STREAM_MAX_BUFFER:
                    buf = b""
        finally:
            with self._aa_stream_lock:
                if generation in self._aa_stream_active:
                    self._aa_stream_active.remove(generation)
                self._aa_stream_procs.pop(generation, None)
            if proc is not None:
                try:
                    proc.terminate()
                    try:
                        proc.wait(timeout=3)
                    except subprocess.TimeoutExpired:
                        proc.kill()  # ffmpeg ignored SIGTERM — don't leak it
                        proc.wait(timeout=3)
                except Exception:
                    log.debug("AA stream: ffmpeg cleanup failed", exc_info=True)
                try:
                    proc.stdout.close()
                except Exception:
                    pass

    def _broadcast_loop(self) -> None:
        """Periodically broadcast event bus data to all WebSocket clients."""
        while self._running:
            try:
                # No clients — skip the ~60 event-bus reads + JSON dump
                # instead of burning CPU at 15 FPS into the void.
                with self._ws_lock:
                    has_clients = bool(self._ws_clients)
                if not has_clients:
                    time.sleep(0.2)
                    continue

                data = self._get_dashboard_data()
                payload = json.dumps(data, default=str)

                # Send OUTSIDE the lock — a half-open/slow client used to
                # block connect/disconnect handlers (same lock) and every
                # other client for the duration of its send().
                with self._ws_lock:
                    clients = list(self._ws_clients)
                dead = []
                for ws in clients:
                    try:
                        ws.send(payload)
                    except Exception:
                        dead.append(ws)
                if dead:
                    with self._ws_lock:
                        for ws in dead:
                            if ws in self._ws_clients:
                                self._ws_clients.remove(ws)
            except Exception:
                log.exception("Broadcast error")

            time.sleep(0.066)  # ~15 FPS

    def _run_server(self) -> None:
        app = self._build_app()
        # threaded=True: the dashboard renders fire many concurrent
        # GETs (radio status, wifi config, BT lists, music, weather…)
        # plus the touch input WS. A single-threaded werkzeug serializes
        # everything, so a slow handler (e.g. bluetoothctl scan, nmcli)
        # stalls every other endpoint and the UI feels frozen on touch.
        app.run(host=self.host, port=self.port, debug=False,
                use_reloader=False, threaded=True)

    def _build_app(self) -> "Flask":
        """Create the Flask app with every route, without serving it.

        Split from _run_server() so tests can drive the real routes through
        ``_build_app().test_client()`` instead of copying them.
        """
        app = Flask(__name__, static_folder=self._web_dir)
        # Bound what a browser may send over a WebSocket: the client never
        # sends anything on /ws, and /ws/input messages are ~100 bytes
        # (_handle_input_message drops anything over _MAX_INPUT_MESSAGE).
        # simple-websocket's default is unlimited; a larger frame now closes
        # that one socket and the page reconnects.
        app.config.setdefault("SOCK_SERVER_OPTIONS", {"max_message_size": 64 * 1024})
        sock = Sock(app)
        viewer = self

        # --- Network access policy (see _access_decision) ---
        access_mode, access_networks, access_hosts = _load_access_policy(viewer._config)
        log.info("Remote access: %s%s (the kiosk on this machine always has full access)",
                 access_mode,
                 "" if access_mode in ("full", "none") else
                 " from " + ", ".join(str(n) for n in access_networks)
                 + "; Host: IP addresses" + "".join(", " + h for h in access_hosts))

        @app.before_request
        def enforce_access_policy():
            decision = _access_decision(request.remote_addr, request.method,
                                        request.endpoint, access_mode, access_networks,
                                        request.host, access_hosts)
            if decision is None:
                return None
            key, reason = decision
            viewer._log_refusal(str(request.remote_addr), request.method,
                                request.path, key, reason)
            body = {"error": "forbidden", "reason": reason, "config_key": key}
            if key == "dashboard.allowed_hosts":
                body["hint"] = "Otwórz adres IP, np. http://10.0.0.1:5002/trips"
            elif access_mode == "tracking":
                body["hint"] = "Z sieci dostępna jest tylko lista tras: /trips"
            return jsonify(body), 403

        # --- Static file serving ---

        @app.route("/")
        def index():
            return send_from_directory(viewer._web_dir, "index.html")

        @app.route("/css/<path:filename>")
        def css(filename):
            return send_from_directory(
                os.path.join(viewer._web_dir, "css"), filename
            )

        @app.route("/js/<path:filename>")
        def js(filename):
            return send_from_directory(
                os.path.join(viewer._web_dir, "js"), filename
            )

        @app.route("/assets/<path:filename>")
        def assets(filename):
            return send_from_directory(
                os.path.join(viewer._web_dir, "assets"), filename
            )

        @app.route("/splash/<path:filename>")
        def splash_asset(filename):
            # The boot/wake splash videos live outside the web dir, in the
            # repo's assets/splash/. The in-browser splash overlay
            # (components/splash.js) plays small.mp4 from here on page load
            # and on every WebSocket reconnect-after-sleep.
            splash_dir = os.path.join(
                os.path.dirname(__file__), "..", "..", "assets", "splash"
            )
            return send_from_directory(os.path.abspath(splash_dir), filename)

        # --- REST API ---

        @app.route("/api/data")
        def api_data():
            return jsonify(viewer._get_dashboard_data())

        @app.route("/api/config", methods=["GET"])
        def api_config_get():
            cfg = viewer._config
            if cfg is None:
                return jsonify({})
            return jsonify({
                "theme": cfg.get("display.dashboard.theme", "heritage"),
                "language": cfg.get("language", "pl"),
                "speed_unit": cfg.get("units.speed", "km/h"),
                "temp_unit": cfg.get("units.temperature", "C"),
                "brightness": cfg.get("display.dashboard.brightness", 70),
                "aa_auto_restart": cfg.get("multimedia.aa_auto_restart", True),
            })

        @app.route("/api/config", methods=["POST"])
        def api_config_set():
            cfg = viewer._config
            if cfg is None:
                return jsonify({"error": "no config"}), 500

            data = request.get_json(silent=True)
            if data is None:
                data = {}
            updates, error = _validate_config_update(data)
            if error is not None:
                key, message = error
                return jsonify({"ok": False, "error": message, "key": key}), 400

            for _key, config_key, value in updates:
                cfg.set(config_key, value)
            applied = {key: value for key, _ck, value in updates}

            if "aa_auto_restart" in applied:
                openauto = _get_openauto()
                if openauto:
                    openauto.auto_restart_enabled = applied["aa_auto_restart"]
                elif viewer._event_bus:
                    viewer._event_bus.publish("multimedia.aa_auto_restart",
                                              applied["aa_auto_restart"])

            # Persist (until now this endpoint never saved, so theme /
            # language / units reverted on every restart).
            persisted = _save_config(cfg, "settings") if applied else False

            # Notify event bus of config change (validated values only)
            if viewer._event_bus:
                viewer._event_bus.publish("config.changed", applied)

            return jsonify({"ok": True, "persisted": persisted})

        # --- Module toggles (Settings -> Moduły) ---

        @app.route("/api/modules", methods=["GET"])
        def api_modules_get():
            cfg = viewer._config
            if cfg is None:
                return jsonify({"modules": [], "restart_required": False})
            modules = viewer._modules_payload(cfg)
            return jsonify({"modules": modules,
                            "restart_required": _modules_restart_required(modules, False)})

        @app.route("/api/modules", methods=["POST"])
        def api_modules_set():
            """Persist a module toggle (``modules.<name>`` in local.yaml).

            Body: ``{"name": str, "enabled": bool, "with_deps": bool?}``.
            Strict types — a string "false" must not switch anything on.
            A planned module (no code in this version) cannot be switched on
            (409). ``with_deps: true`` also switches on what the catalog
            says it needs (``enable_plan``) — only ever on the driver's
            explicit confirmation in Settings; without it the toggle is
            saved alone and the module logs one warning at start-up.
            The response says whether a BCM restart is needed for the saved
            state to take effect (``restart_required``) and carries the
            fresh module list, so the screen does not have to ask again.
            """
            cfg = viewer._config
            if cfg is None:
                return jsonify({"error": "no config"}), 500
            data = request.get_json(silent=True)
            if not isinstance(data, dict):
                return jsonify({"error": "expected a JSON object"}), 400
            from src.core import modules_catalog as mc
            name = data.get("name")
            if not isinstance(name, str) or name not in mc.MODULES:
                return jsonify({"error": "unknown module"}), 400
            enabled = data.get("enabled")
            if not isinstance(enabled, bool):
                return jsonify({"error": "enabled must be true or false"}), 400
            with_deps = data.get("with_deps", False)
            if not isinstance(with_deps, bool):
                return jsonify({"error": "with_deps must be true or false"}), 400
            if enabled and not mc.is_available(mc.MODULES[name]):
                return jsonify({"error": "module not available in this version",
                                "available": False}), 409
            also: list[str] = []
            if enabled and with_deps:
                plan = mc.enable_plan(mc.MODULES, mc.enabled_map(cfg), name)
                if plan is None:
                    return jsonify({"error": "dependencies cannot be enabled in this version",
                                    "available": False}), 409
                also = plan
            for module in also + [name]:
                cfg.set(f"modules.{module}", enabled)
                # Keep the legacy ad-hoc key in sync so code that still reads
                # it directly (e.g. openauto's wifi.enabled warning) agrees.
                legacy = mc.MODULES[module].get("legacy_key")
                if legacy:
                    cfg.set(legacy, enabled)
            persisted = _save_config(cfg, f"module {name}")
            if viewer._event_bus:
                viewer._event_bus.publish("config.changed",
                                          {"module": name, "enabled": enabled,
                                           "also": list(also)})
            modules = viewer._modules_payload(cfg)
            this = next((m for m in modules if m["name"] == name), {})
            return jsonify({"ok": True, "persisted": persisted,
                            "enabled_also": also,
                            "runs": this.get("runs", False),
                            "blocked_by": this.get("blocked_by", []),
                            "restart_required": _modules_restart_required(modules, True),
                            "modules": modules})

        # --- SWC mapping API ---

        @app.route("/api/config/swc", methods=["GET"])
        def api_swc_get():
            cfg = viewer._config
            if cfg is None:
                return jsonify({})
            mapping = cfg.get("swc.mapping")
            if not isinstance(mapping, dict):
                from src.input.swc_remote import DEFAULT_MAPPING
                mapping = DEFAULT_MAPPING
            from src.input.swc_remote import (ALL_BUTTONS, ACTIONS, OPTIONAL_ACTIONS,
                                              action_available)
            # Actions added later (crash_cancel) appear with empty slots, so
            # they can be learned even with a mapping saved before them —
            # but only while their module is on (production: crash_sms off,
            # no "Anuluj SMS po stłuczce" row that would do nothing).
            mapping = dict(mapping)
            for action in OPTIONAL_ACTIONS:
                if action_available(action, cfg):
                    mapping.setdefault(action, ["", ""])
                else:
                    mapping.pop(action, None)
            return jsonify({
                "mapping": mapping,
                "all_buttons": ALL_BUTTONS,
                "actions": [a for a in ACTIONS
                            if a != "disabled" and action_available(a, cfg)],
            })

        def _swc_kiosk_only_refusal(what: str):
            """Binding ``crash_cancel`` to a wheel button decides what may
            cancel a crash SMS — as much "controlling the crash SMS" as the
            /api/crash/* routes, so loopback only, whatever
            dashboard.remote_access says."""
            ip = _client_ip(request.remote_addr)
            if ip is not None and ip.is_loopback:
                return None
            viewer._log_refusal(str(request.remote_addr)[:64], request.method,
                                request.path, "loopback_only",
                                f"{what} is only possible from the head unit's own screen",
                                level=logging.WARNING)
            return jsonify({"ok": False, "error": "forbidden",
                            "reason": f"{what} is only possible from the head unit's "
                                      f"own screen"}), 403

        @app.route("/api/config/swc", methods=["POST"])
        def api_swc_set():
            cfg = viewer._config
            if cfg is None:
                return jsonify({"error": "no config"}), 500
            data = request.get_json(silent=True) or {}
            mapping = data.get("mapping")
            if not isinstance(mapping, dict):
                return jsonify({"error": "mapping must be a dict"}), 400
            from src.input.swc_remote import OPTIONAL_ACTIONS
            saved = cfg.get("swc.mapping")
            saved = saved if isinstance(saved, dict) else {}
            mapping = dict(mapping)

            def _bound(v):
                # The buttons an entry really binds (["", ""] = none).
                return sorted(b for b in (v if isinstance(v, list) else [v])
                              if isinstance(b, str) and b)

            for action in OPTIONAL_ACTIONS:
                if action not in mapping and action in saved:
                    # A table that does not list it (module off, older
                    # page) keeps the saved binding instead of erasing it.
                    mapping[action] = saved[action]
                if _bound(mapping.get(action)) != _bound(saved.get(action)):
                    refused = _swc_kiosk_only_refusal(f"changing the SWC button for {action}")
                    if refused is not None:
                        return refused
            cfg.set("swc.mapping", mapping)
            persisted = _save_config(cfg, "swc mapping")
            if viewer._event_bus:
                viewer._event_bus.publish("input.swc_config_changed", mapping)
            return jsonify({"ok": True, "persisted": persisted})

        # --- SWC learn mode ---

        _swc_learn = {"active": False, "action": "", "pod": 0,
                      "result": None, "ts": 0}

        def _on_learn_keycode(topic, value, timestamp):
            if not _swc_learn["active"] or not isinstance(value, int):
                return
            from src.input.swc_remote import KEYCODE_TO_BUTTON
            btn_pair = KEYCODE_TO_BUTTON.get(value)
            if not btn_pair:
                return
            pod = _swc_learn["pod"]
            button_name = btn_pair[min(pod, 1)]
            action = _swc_learn["action"]
            _swc_learn["result"] = button_name
            _swc_learn["active"] = False
            cfg = viewer._config
            if cfg and action:
                from src.input.swc_remote import DEFAULT_MAPPING
                from src.input.swc_remote import OPTIONAL_ACTIONS
                mapping = cfg.get("swc.mapping")
                if not isinstance(mapping, dict):
                    mapping = dict(DEFAULT_MAPPING)
                if action in OPTIONAL_ACTIONS and not isinstance(mapping.get(action), list):
                    mapping[action] = ["", ""]      # saved before the action existed
                if action in mapping and isinstance(mapping[action], list):
                    mapping[action][min(pod, len(mapping[action]) - 1)] = button_name
                    cfg.set("swc.mapping", mapping)
                    # Runs on the event-bus thread: a save error must not
                    # propagate into the dispatcher.
                    _save_config(cfg, "swc learn")

        def _on_learn_keyname(topic, value, timestamp):
            if not _swc_learn["active"] or not isinstance(value, str):
                return
            from src.input.action_dispatch import KEYBOARD_MAP
            keycode = KEYBOARD_MAP.get(value.lower())
            if keycode is not None:
                _on_learn_keycode("", keycode, timestamp)

        if viewer._event_bus:
            viewer._event_bus.subscribe("input.raw_keycode", _on_learn_keycode)
            viewer._event_bus.subscribe("input.raw_keyname", _on_learn_keyname)

        @app.route("/api/config/swc/learn", methods=["POST"])
        def api_swc_learn_start():
            data = request.get_json(silent=True) or {}
            from src.input.swc_remote import OPTIONAL_ACTIONS
            if data.get("action") in OPTIONAL_ACTIONS:
                refused = _swc_kiosk_only_refusal(
                    f"learning the SWC button for {data.get('action')}")
                if refused is not None:
                    return refused
            _swc_learn.update(
                active=True, action=data.get("action", ""),
                pod=data.get("pod", 0), result=None, ts=time.time())
            return jsonify({"ok": True})

        @app.route("/api/config/swc/learn", methods=["GET"])
        def api_swc_learn_status():
            if _swc_learn["active"] and time.time() - _swc_learn["ts"] > 10:
                _swc_learn["active"] = False
            return jsonify({
                "active": _swc_learn["active"],
                "result": _swc_learn["result"],
                "action": _swc_learn["action"],
                "pod": _swc_learn["pod"],
            })

        # --- Audio EQ API ---

        def _get_audio_ctrl():
            if viewer._event_bus:
                result = viewer._event_bus.get_last("audio._internals")
                if result and result[0]:
                    return result[0].get("pipewire")
            return None

        @app.route("/api/audio/eq", methods=["GET"])
        def api_audio_eq_get():
            from src.audio.pipewire_ctrl import EQ_PRESETS, EQ_FREQUENCIES
            pw = _get_audio_ctrl()
            return jsonify({
                "preset": pw.current_eq_preset if pw else "flat",
                "gains": EQ_PRESETS.get(
                    pw.current_eq_preset if pw else "flat",
                    [0] * 10),
                "frequencies": EQ_FREQUENCIES,
                "presets": list(EQ_PRESETS.keys()),
                "bass": pw.bass if pw else 0,
                "treble": pw.treble if pw else 0,
                "fader": pw.fader if pw else 0,
                "balance": pw.balance if pw else 0,
            })

        @app.route("/api/audio/eq", methods=["POST"])
        def api_audio_eq_set():
            pw = _get_audio_ctrl()
            if not pw:
                return jsonify({"error": "audio not available"}), 503
            data = request.get_json(silent=True) or {}
            ok = True
            if "preset" in data:
                ok = pw.apply_eq_preset(data["preset"]) and ok
            if "gains" in data:
                ok = pw.set_custom_gains(data["gains"]) and ok
            if "bass" in data or "treble" in data:
                ok = pw.set_bass_treble(
                    data.get("bass", pw.bass),
                    data.get("treble", pw.treble),
                ) and ok
            if "fader" in data:
                ok = pw.set_fader(data["fader"]) and ok
            if "balance" in data:
                ok = pw.set_balance(data["balance"]) and ok
            return jsonify({"ok": ok})

        @app.route("/api/audio/volume", methods=["POST"])
        def api_audio_volume_set():
            data = request.get_json(silent=True) or {}
            if viewer._event_bus:
                internals = viewer._event_bus.get_last("audio._internals")
                if internals and internals[0]:
                    vol_ctrl = internals[0].get("volume")
                    if vol_ctrl:
                        if "volume" in data:
                            vol_ctrl.set_volume(int(data["volume"]))
                        if "mute" in data:
                            if data["mute"]:
                                vol_ctrl.mute()
                            else:
                                vol_ctrl.unmute()
                        return jsonify({"ok": True})
            return jsonify({"error": "audio not available"}), 503

        # --- Boot mode API ---

        # --- Kiosk readiness gate ---
        # Splash polls /api/ready and dismisses itself the moment the
        # browser-side App.init() has finished — that's the only way to
        # know Chromium has actually painted the dashboard, not just
        # that Flask is answering. POST flips the flag, GET returns
        # 200/204 depending on the state.
        @app.route("/api/ready", methods=["POST"])
        def api_ready_set():
            viewer._kiosk_ready = True
            return ("", 204)

        @app.route("/api/ready", methods=["GET"])
        def api_ready_get():
            if getattr(viewer, "_kiosk_ready", False):
                return jsonify({"ready": True})
            return jsonify({"ready": False}), 503

        @app.route("/api/ready-reset", methods=["POST"])
        def api_ready_reset():
            # Clears the readiness flag so the next splash run waits for a
            # fresh paint. The resume hook calls this before replaying the
            # splash on wake-from-sleep (the Flask process survives an
            # in-process wake, so the flag would otherwise still be True).
            viewer._kiosk_ready = False
            return ("", 204)

        @app.route("/api/boot_mode")
        def api_boot_mode():
            state_file = Path("/tmp/bcm_power_state")
            result = {"boot_mode": "warm"}
            if state_file.exists():
                try:
                    for line in state_file.read_text().strip().split("\n"):
                        if "=" in line:
                            k, v = line.split("=", 1)
                            result[k.strip()] = v.strip()
                except Exception:
                    pass
            return jsonify(result)

        # --- DVR API ---

        @app.route("/api/dvr/list")
        def api_dvr_list():
            """List DVR recordings."""
            rec_dir = "/media/dashcam"
            recordings = []
            for path in sorted(glob.glob(f"{rec_dir}/*.mp4"), reverse=True)[:50]:
                fname = os.path.basename(path)
                try:
                    size_mb = os.path.getsize(path) / (1024 * 1024)
                except OSError:
                    size_mb = 0
                cam = "front" if "front" in fname else "rear" if "rear" in fname else "front"
                recordings.append({
                    "filename": fname,
                    "camera": cam,
                    "size": f"{size_mb:.0f}MB",
                    "date": fname[:19].replace("_", " ") if len(fname) > 19 else fname,
                })
            return jsonify({"recordings": recordings})

        @app.route("/api/dvr/play/<filename>")
        def api_dvr_play(filename):
            rec_dir = "/media/dashcam"
            return send_from_directory(rec_dir, filename)

        @app.route("/api/dvr/delete/<filename>", methods=["DELETE"])
        def api_dvr_delete(filename):
            rec_dir = "/media/dashcam"
            path = os.path.join(rec_dir, filename)
            if os.path.exists(path):
                os.remove(path)
                return jsonify({"ok": True})
            return jsonify({"error": "not found"}), 404

        @app.route("/api/dvr/export", methods=["POST"])
        def api_dvr_export():
            """Export selected files to USB drive (with optional target folder)."""
            data = request.get_json(silent=True) or {}
            files = data.get("files", [])
            target_path = data.get("target_path", "/")
            # Find USB mount point
            usb_mounts = glob.glob("/media/usb*") + glob.glob("/mnt/usb*")
            if not usb_mounts:
                return jsonify({"error": "no USB drive"}), 400
            usb_root = usb_mounts[0]
            dest = os.path.normpath(os.path.join(usb_root, target_path.lstrip("/")))
            if not dest.startswith(usb_root):
                return jsonify({"error": "invalid target path"}), 400
            os.makedirs(dest, exist_ok=True)
            copied = 0
            for f in files:
                src = os.path.join("/media/dashcam", f)
                if os.path.exists(src):
                    shutil.copy2(src, os.path.join(dest, f))
                    copied += 1
            return jsonify({"ok": True, "count": copied, "target": dest})

        @app.route("/api/dvr/usb/status")
        def api_dvr_usb_status():
            usb_mounts = glob.glob("/media/usb*") + glob.glob("/mnt/usb*")
            if not usb_mounts:
                return jsonify({"available": False})
            usage = shutil.disk_usage(usb_mounts[0])
            return jsonify({
                "available": True,
                "free_gb": round(usage.free / (1024**3), 1),
                "total_gb": round(usage.total / (1024**3), 1),
            })

        @app.route("/api/dvr/usb/browse")
        def api_dvr_usb_browse():
            """List directories on USB drive for export target selection."""
            usb_mounts = glob.glob("/media/usb*") + glob.glob("/mnt/usb*")
            if not usb_mounts:
                return jsonify({"error": "no USB drive"}), 400
            usb_root = usb_mounts[0]
            rel_path = request.args.get("path", "/")
            abs_path = os.path.normpath(os.path.join(usb_root, rel_path.lstrip("/")))
            if not abs_path.startswith(usb_root):
                return jsonify({"error": "invalid path"}), 400
            if not os.path.isdir(abs_path):
                return jsonify({"error": "not a directory"}), 400
            entries = []
            for name in sorted(os.listdir(abs_path)):
                full = os.path.join(abs_path, name)
                if os.path.isdir(full):
                    entries.append({"name": name, "type": "dir"})
            rel = os.path.relpath(abs_path, usb_root)
            return jsonify({"path": "/" if rel == "." else "/" + rel, "dirs": entries})

        # --- Android Auto — direct Xvfb MJPEG stream (no port 5001) ---

        @app.route("/aa/stream")
        def aa_stream():
            """Direct MJPEG stream from Xvfb (:99) — no port 5001 proxy."""
            return Response(viewer._aa_mjpeg_frames(),
                            mimetype="multipart/x-mixed-replace; boundary=frame")

        @app.route("/aa/status")
        def aa_status():
            """Check if OpenAuto / Xvfb is running."""
            available = False
            if viewer._event_bus:
                st = viewer._event_bus.get_last("multimedia.openauto_status")
                if st and st[0] in ("running", "connected"):
                    available = True
            return jsonify({"available": available})

        @app.route("/aa/touch", methods=["POST"])
        def aa_touch():
            """Forward a touch to Xvfb (HTTP fallback of the /ws/input path).

            Body ``{"x": 0..1, "y": 0..1, "action"?: ...}``. Without
            ``action`` it is a tap, exactly as before. The kiosk only falls
            back here for tap/down/up/cancel while the input WebSocket is
            down; ``move`` is refused — a drag over HTTP would be one request
            (and one server thread) per frame.
            """
            data = request.get_json(silent=True)
            if data is None:
                data = {}
            if not isinstance(data, dict):
                return jsonify({"ok": False, "error": "body must be a JSON object"}), 400
            action = data.get("action", "tap")
            if action not in _AA_HTTP_TOUCH_ACTIONS:
                return jsonify({"ok": False,
                                "error": f"action must be one of {list(_AA_HTTP_TOUCH_ACTIONS)}"}), 400
            injector = viewer._get_aa_injector()
            if injector is None:
                return jsonify({"ok": False, "error": "touch injection unavailable"}), 503
            px = py = None
            if action != "cancel":
                # Missing coordinates keep the old default (canvas centre);
                # present-but-invalid ones (NaN, strings, bools) are a 400.
                pixels = injector.to_pixels(data.get("x", 0.5), data.get("y", 0.5))
                if pixels is None:
                    return jsonify({"ok": False, "error": "x and y must be finite numbers"}), 400
                px, py = pixels
            if not injector.submit(action, data.get("x", 0.5), data.get("y", 0.5),
                                   client="http"):
                return jsonify({"ok": False, "error": "touch injection unavailable"}), 503
            return jsonify({"ok": True, "action": action, "x": px, "y": py})

        def _get_openauto():
            return viewer._openauto()

        @app.route("/aa/restart", methods=["POST"])
        @app.route("/api/aa/restart", methods=["POST"])
        def aa_restart():
            """Manually restart OpenAuto process and Xvfb."""
            log.info("Manual AA restart requested via API")
            openauto = _get_openauto()
            if openauto:
                # A second tap while restart() runs must not start another
                # thread (the controller would refuse it anyway, but the UI
                # deserves to know it is already happening).
                if getattr(openauto, "restart_in_progress", False) is True:
                    return jsonify({"ok": True, "status": "already_restarting"})
                threading.Thread(target=openauto.restart, daemon=True, name="aa-http-restart").start()
                return jsonify({"ok": True, "status": "restarting"})
            elif viewer._event_bus:
                viewer._event_bus.publish("multimedia.restart_request", True)
                return jsonify({"ok": True, "status": "restarting"})
            return jsonify({"ok": False, "error": "openauto not available"}), 503

        @app.route("/api/aa/config", methods=["GET"])
        def aa_config_get():
            """Get Android Auto configuration and auto-restart setting."""
            openauto = _get_openauto()
            auto_restart = openauto.auto_restart_enabled if openauto else (
                viewer._config.get("multimedia.aa_auto_restart", True) if viewer._config else True
            )
            timeout = getattr(openauto, "_connection_timeout", 90) if openauto else (
                viewer._config.get("multimedia.aa_connection_timeout", 90) if viewer._config else 90
            )
            status = "unavailable"
            if viewer._event_bus:
                st = viewer._event_bus.get_last("multimedia.openauto_status")
                if st:
                    status = st[0]
            return jsonify({
                "auto_restart": auto_restart,
                "timeout": timeout,
                "status": status,
            })

        @app.route("/api/aa/config", methods=["POST"])
        def aa_config_set():
            """Update Android Auto settings (auto-restart toggle)."""
            data = request.get_json(silent=True) or {}
            if "auto_restart" in data:
                enabled = bool(data["auto_restart"])
                if viewer._config:
                    viewer._config.set("multimedia.aa_auto_restart", enabled)
                    _save_config(viewer._config, "aa auto_restart")
                openauto = _get_openauto()
                if openauto:
                    openauto.auto_restart_enabled = enabled
                elif viewer._event_bus:
                    viewer._event_bus.publish("multimedia.aa_auto_restart", enabled)
                return jsonify({"ok": True, "auto_restart": enabled})
            return jsonify({"error": "missing auto_restart"}), 400

        @app.route("/api/kiosk/restart", methods=["POST"])
        def api_kiosk_restart():
            """Restart the kiosk UI and display processes.

            On baremetal (systemd): restarts bcm-kiosk or kills chromium so xinitrc
            respawns it fresh, and notifies the UI.
            """
            log.info("Kiosk restart requested via API")
            data = request.get_json(silent=True) or {}
            scope = data.get("scope", "kiosk")

            def _perform_restart():
                time.sleep(0.5)
                # 1. Try systemd service restart for bcm-kiosk if active
                try:
                    rc = subprocess.run(
                        ["systemctl", "is-active", "--quiet", "bcm-kiosk.service"],
                        timeout=3
                    ).returncode
                    if rc == 0:
                        subprocess.run(["systemctl", "restart", "bcm-kiosk.service"], timeout=5)
                        log.info("Restarted bcm-kiosk.service via systemctl")
                        return
                except Exception as e:
                    log.debug("systemctl bcm-kiosk check failed: %s", e)

                # 2. On x86 setup where bcm-kiosk is masked and Chromium runs via xinitrc:
                # Killing chromium causes xinitrc to finish wait and relaunch clean Chromium.
                try:
                    subprocess.run(["pkill", "-f", "chromium"], timeout=3)
                    log.info("Sent pkill to chromium processes for kiosk relaunch")
                except Exception as e:
                    log.debug("pkill chromium failed: %s", e)

                # 3. If scope is 'system' or 'bcm', also restart bcm-headunit service
                if scope in ("system", "all", "bcm"):
                    try:
                        subprocess.run(["systemctl", "restart", "bcm-headunit.service"], timeout=5)
                    except Exception as e:
                        log.debug("systemctl bcm-headunit restart failed: %s", e)

            threading.Thread(target=_perform_restart, daemon=True, name="kiosk-restart-worker").start()
            return jsonify({"ok": True, "message": "kiosk restarting"})

        @app.route("/api/system/reboot", methods=["POST"])
        def api_system_reboot():
            """Reboot the entire baremetal computer (host OS).

            Gracefully notifies power.shutting_down (sync disk, flush configs),
            then issues a system reboot command.
            """
            log.warning("System reboot requested via API")
            if viewer._event_bus:
                try:
                    viewer._event_bus.publish("power.shutting_down", True)
                except Exception as e:
                    log.warning("Failed to publish power.shutting_down: %s", e)

            def _perform_reboot():
                time.sleep(1.2)
                commands = [
                    ["systemctl", "reboot"],
                    ["sudo", "systemctl", "reboot"],
                    ["reboot"],
                    ["sudo", "reboot"],
                ]
                for cmd in commands:
                    try:
                        log.info("Executing system reboot command: %s", " ".join(cmd))
                        res = subprocess.run(cmd, timeout=8)
                        if res.returncode == 0:
                            return
                    except Exception as e:
                        log.warning("Command %s failed: %s", cmd, e)

            threading.Thread(target=_perform_reboot, daemon=True, name="system-reboot-worker").start()
            return jsonify({"ok": True, "message": "system reboot initiated"})

        # --- Bluetooth management API (moved from aa_display.py) ---

        @app.route("/bt/status")
        def bt_status():
            bt = viewer._bt_manager
            if not bt:
                return jsonify({"error": "BT manager not available"}), 503
            ctrl = bt.get_controller_info()
            ctrl["connected"] = bt.connected
            ctrl["connected_device"] = bt.connected_device
            ctrl["scanning"] = bt.scanning
            ctrl["a2dp_active"] = bt.a2dp_active
            ctrl["hfp_active"] = bt.hfp_active
            return jsonify(ctrl)

        @app.route("/bt/devices")
        def bt_devices():
            bt = viewer._bt_manager
            if not bt:
                return jsonify({"paired": [], "discovered": []})
            paired = bt.get_paired_devices()
            for dev in paired:
                info = bt.get_device_info(dev["address"])
                dev["connected"] = info.get("connected", False)
            discovered = bt.discovered_devices
            return jsonify({"paired": paired, "discovered": discovered})

        @app.route("/bt/scan", methods=["POST"])
        def bt_scan():
            bt = viewer._bt_manager
            if not bt:
                return jsonify({"error": "BT not available"}), 503
            duration = 15
            if request.is_json:
                duration = request.json.get("duration", 15)
            ok = bt.start_scan(duration=duration)
            return jsonify({"started": ok, "scanning": bt.scanning})

        @app.route("/bt/scan/stop", methods=["POST"])
        def bt_scan_stop():
            bt = viewer._bt_manager
            if not bt:
                return jsonify({"error": "BT not available"}), 503
            bt.stop_scan()
            return jsonify({"scanning": False})

        @app.route("/bt/pair/<address>", methods=["POST"])
        def bt_pair(address):
            bt = viewer._bt_manager
            if not bt:
                return jsonify({"error": "BT not available"}), 503
            # pair() runs bluetoothctl pair + a post-pair connect, which can
            # block for tens of seconds. Never run it inline — the kiosk Flask
            # server is effectively single-threaded, so a blocking handler
            # freezes the whole UI. Fire-and-forget; the UI learns the result
            # from the bt.connected/bt.disconnected events + /bt/connected poll.
            threading.Thread(
                target=bt.pair, args=(address,),
                daemon=True, name=f"bt-http-pair-{address}",
            ).start()
            return jsonify({"started": True, "address": address}), 202

        @app.route("/bt/connect/<address>", methods=["POST"])
        def bt_connect(address):
            bt = viewer._bt_manager
            if not bt:
                return jsonify({"error": "BT not available"}), 503
            # connect() can block ~40s (connect + verify + back-off). Run it on
            # a daemon thread so the request returns immediately and the UI
            # stays responsive; the real outcome arrives via the event bus.
            threading.Thread(
                target=bt.connect, args=(address,),
                daemon=True, name=f"bt-http-connect-{address}",
            ).start()
            return jsonify({"started": True, "address": address}), 202

        @app.route("/bt/disconnect", methods=["POST"])
        def bt_disconnect():
            bt = viewer._bt_manager
            if not bt:
                return jsonify({"error": "BT not available"}), 503
            threading.Thread(
                target=bt.disconnect,
                daemon=True, name="bt-http-disconnect",
            ).start()
            return jsonify({"started": True}), 202

        @app.route("/bt/remove/<address>", methods=["POST"])
        def bt_remove(address):
            bt = viewer._bt_manager
            if not bt:
                return jsonify({"error": "BT not available"}), 503
            ok = bt.remove(address)
            return jsonify({"success": ok, "address": address})

        @app.route("/bt/discoverable", methods=["POST"])
        def bt_discoverable():
            bt = viewer._bt_manager
            if not bt:
                return jsonify({"error": "BT not available"}), 503
            timeout = 120
            if request.is_json:
                timeout = request.json.get("timeout", 120)
            ok = bt.enable_discoverable(timeout=timeout)
            return jsonify({"success": ok})

        @app.route("/bt/connected")
        def bt_connected():
            bt = viewer._bt_manager
            if not bt:
                return jsonify({"connected": []})
            connected = bt.get_connected_devices()
            return jsonify({"connected": connected})

        @app.route("/bt/pairing")
        def bt_pairing_status():
            try:
                from src.multimedia.bluetooth import get_pending_pairing
                req = get_pending_pairing()
                return jsonify({"pending": req is not None, "request": req})
            except Exception:
                return jsonify({"pending": False, "request": None})

        @app.route("/bt/pairing/confirm", methods=["POST"])
        def bt_pairing_confirm():
            try:
                from src.multimedia.bluetooth import confirm_pairing
                accept = True
                if request.is_json:
                    accept = request.json.get("accept", True)
                ok = confirm_pairing(accept)
                return jsonify({"success": ok})
            except Exception:
                return jsonify({"success": False})

        # --- Radio (BT + WiFi AP) toggles —--------------------------
        # Backs the two on/off switches in the settings page. The
        # cosmetic-only toggle that used to live in settings.js never
        # touched the radios (works in the simulator VM, didn't on
        # baremetal), which the user reported as "settings page for
        # WLAN, and BT are not influence on those modems".

        def _wifi_ap_status():
            wa = viewer._wifi_ap
            if wa is None:
                # WiFi AP module not loaded in this run, but the system
                # may still have hostapd running (setup-x86.sh installs
                # it as a system service) — surface that so the toggle
                # reflects reality.
                hostapd_active = False
                try:
                    rc = subprocess.run(
                        ["systemctl", "is-active", "hostapd"],
                        capture_output=True, text=True, timeout=3,
                    ).stdout.strip()
                    hostapd_active = (rc == "active")
                except Exception:
                    pass
                return {
                    "available": hostapd_active,
                    "running": hostapd_active,
                    "ssid": (viewer._config.get("wifi.ssid", "")
                             if viewer._config else ""),
                    "managed_by": "hostapd" if hostapd_active else None,
                }
            return {
                "available": True,
                "running": wa.running,
                "ssid": (viewer._config.get("wifi.ssid", "")
                         if viewer._config else ""),
                "interface": wa.interface,
                "managed_by": "bcm",
            }

        @app.route("/api/radio/status")
        def api_radio_status():
            bt = viewer._bt_manager
            bt_info = {"available": False, "powered": False,
                       "discoverable": False}
            if bt:
                ctrl = bt.get_controller_info()
                bt_info = {
                    "available": bool(ctrl.get("available")),
                    "powered": bool(ctrl.get("powered", False)),
                    "discoverable": bool(ctrl.get("discoverable", False)),
                    "name": ctrl.get("name", ""),
                    "address": ctrl.get("address", ""),
                }
            return jsonify({"bt": bt_info, "wifi": _wifi_ap_status()})

        @app.route("/api/radio/bt", methods=["POST"])
        def api_radio_bt():
            bt = viewer._bt_manager
            if not bt:
                return jsonify({"error": "BT not available"}), 503
            data = request.get_json(silent=True) or {}
            enabled = bool(data.get("enabled", True))
            ok = bt.set_powered(enabled)
            ctrl = bt.get_controller_info()
            return jsonify({
                "success": ok,
                "powered": bool(ctrl.get("powered", False)),
            })
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
