geek95dg/Alfa156-headunit/arduino/esp32_display/protocol.h

/*
 * BCM v8.5 — parser protokołu USB CDC dla wyświetlacza 1,8" (ESP32-S3)
 *
 * Ten sam kształt linii, którym mówi już sensor_hub — `KLUCZ:wartość`
 * zakończone '\n' — tylko w drugą stronę: tu BCM pisze, a ESP32 czyta.
 *
 *   TITLE:<tekst>      tytuł utworu (UTF-8, z ogonkami)
 *   ARTIST:<tekst>     wykonawca
 *   SRC:BT|AA|---      źródło dźwięku
 *   PLAY:0|1           1 = odtwarzanie, 0 = pauza
 *   POS:<sekundy>      pozycja w utworze
 *   DUR:<sekundy>      długość utworu
 *   CRUISE:0|1         tempomat aktywny
 *   SETSPD:<km/h>      zadana prędkość tempomatu
 *   PING               -> ESP32 odpowiada PONG
 *
 * CZYSTY C++ — zero Arduino, więc kompiluje się i testuje na hoście
 * (g++ -std=c++17 -Wall -Wextra -Werror, patrz test/test_host.cpp).
 * Cała warstwa I/O siedzi w esp32_display.ino.
 *
 * Odporność, bo po drugiej stronie kabla siedzi linuksowy proces, a w danych
 * metadane z internetu (a więc i emoji, i cyrylica, i tytuły na pół ekranu):
 *   * pusta wartość            -> pole czyszczone, renderer podmienia na "---";
 *   * nieznany klucz           -> ignorowany bez błędu;
 *   * brak dwukropka           -> ignorowany (poza gołym PING);
 *   * linia dłuższa niż bufor  -> obcinana, reszta idzie w kosz;
 *   * '\r' na końcu (CRLF)     -> zdejmowany;
 *   * UTF-8 ucięty w połowie   -> ogon urwanej sekwencji zdejmowany, żeby
 *                                 do fontu nigdy nie trafił kaleki znak.
 *
 * KAŻDA niepusta linia — nawet z nieznanym kluczem — jest dowodem, że BCM
 * żyje, i odświeża znacznik świeżości. Brak linii przez BCM_TIMEOUT_MS
 * (state.h) gasi metadane do "---"; kontrolki i ekran 2 idą wprost z GPIO
 * i działają dalej.
 */
#pragma once

#include <stdint.h>
#include <string.h>

enum {
    PROTO_LINE_MAX   = 192,   // najdłuższa linia, jaką bierzemy na poważnie
    PROTO_TITLE_MAX  = 96,    // tytuł: dwie linie po 112 px to grubo mniej
    PROTO_ARTIST_MAX = 64,
    PROTO_SOURCE_MAX = 8,     // "BT", "AA", "---"

    PROTO_SECONDS_MAX = 86400,  // sufit dla POS/DUR — doba, nie utwór
    PROTO_SPEED_MAX   = 999     // sufit dla SETSPD — trzy cyfry mieszczą się w polu
};

// Wszystko, co przychodzi z BCM i ląduje na ekranie 1.
struct DisplayData {
    char     title[PROTO_TITLE_MAX];
    char     artist[PROTO_ARTIST_MAX];
    char     source[PROTO_SOURCE_MAX];
    bool     playing;
    uint32_t position_s;
    uint32_t duration_s;
    uint32_t position_rx_ms;   // millis() przy ostatnim POS — do dosuwania paska
    bool     cruise;
    uint16_t set_speed;
    bool     seen;             // czy BCM w ogóle się kiedykolwiek odezwał
    uint32_t last_rx_ms;       // znacznik świeżości: millis() ostatniej linii
};

enum ProtoResult : uint8_t {
    PROTO_IGNORED = 0,   // nic się nie zmieniło (nieznany klucz, ta sama wartość)
    PROTO_UPDATED,       // pole zmieniło wartość — warto przerysować
    PROTO_PING           // trzeba odpowiedzieć PONG
};

// --- składanie linii z bajtów (ESP32 czyta Serial bajt po bajcie) ---
//
// Nadmiar ponad bufor jest ODRZUCANY, ale linia i tak zostaje oddana —
// lepiej pokazać obcięty tytuł niż zgubić całą aktualizację. Flaga
// `truncated` mówi, że tak się stało.
struct LineAssembler {
    char     buf[PROTO_LINE_MAX];
    uint16_t len;         // ile bajtów zebrano do tej pory
    bool     overflow;    // bieżąca linia przerosła bufor
    bool     truncated;   // ...tak było w linii ostatnio oddanej
};

inline void line_init(LineAssembler *a)
{
    if (a == nullptr) {
        return;
    }
    a->buf[0] = '\0';
    a->len = 0;
    a->overflow = false;
    a->truncated = false;
}

// Dokłada jeden bajt. Zwraca true, gdy w a->buf leży kompletna, zerowo
// zakończona linia (bez '\n' i bez '\r'). Licznik zeruje się od razu,
// więc wywołujący ma linię ważną do najbliższego kolejnego line_feed().
inline bool line_feed(LineAssembler *a, char c)
{
    if (a == nullptr) {
        return false;
    }
    if (c == '\r') {
        return false;                 // CRLF: '\r' nas nie interesuje nigdzie
    }
    if (c == '\n') {
        a->buf[a->len] = '\0';
        a->len = 0;
        a->truncated = a->overflow;
        a->overflow = false;
        return true;
    }
    if (a->len < PROTO_LINE_MAX - 1) {
        a->buf[a->len++] = c;
    } else {
        a->overflow = true;           // przepełnienie — reszta linii w kosz
    }
    return false;
}

// --- pomocnicze ---

// Ile z pierwszych `len` bajtów tworzy komplet znaków UTF-8. Ucina ogon
// urwany w połowie sekwencji — inaczej font_draw.h zobaczyłby kalekę
// i wypisał '?' na końcu każdego obciętego tytułu.
inline int proto_utf8_trim(const char *s, int len)
{
    if (s == nullptr || len <= 0) {
        return 0;
    }
    const unsigned char *u = reinterpret_cast<const unsigned char *>(s);
    int start = len - 1;
    int back = 0;
    while (start > 0 && (u[start] & 0xC0) == 0x80 && back < 3) {
        start--;
        back++;
    }
    const unsigned char lead = u[start];
    int need = 1;
    if ((lead & 0xE0) == 0xC0) {
        need = 2;
    } else if ((lead & 0xF0) == 0xE0) {
        need = 3;
    } else if ((lead & 0xF8) == 0xF0) {
        need = 4;
    }
    return (start + need <= len) ? len : start;
}

// Kopia tekstu z przycięciem do pojemności pola i do granicy znaku UTF-8.
inline void proto_copy_text(char *dst, int cap, const char *src, int src_len)
{
    if (dst == nullptr || cap <= 0) {
        return;
    }
    int n = (src == nullptr || src_len < 0) ? 0 : src_len;
    if (n > cap - 1) {
        n = cap - 1;
    }
    n = proto_utf8_trim(src, n);
    if (n > 0) {
        memcpy(dst, src, static_cast<size_t>(n));
    }
    dst[n] = '\0';
}
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
