geek95dg/Alfa156-headunit/(commit log)

2026-04-15 Phase 2/4: docs updated for audio on main.mp4 splash
    Bring all three pieces of splash-related documentation in line
    with the new "main.mp4 plays audio, small.mp4 stays silent"
    behaviour from commit 2673cac.
    assets/splash/README.md:
    - Spec table now lists main.mp4 as "Yes — plays through the car
    audio system during boot" and small.mp4 as "No (silent)".
    - New "Audio on main.mp4" subsection explains the boot-time
    ALSA-direct path (mpv --ao=alsa,pipewire,pulse, running as
    root before PipeWire is up, PartOf=bcm-headunit.service
    releases the card cleanly when BCM takes over).
    - Three tips for the audio track: loop length, boundary fade,
    ~-14 LUFS normalisation.
    - One-line ffmpeg trans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
2026-04-15 Phase 3/4: consistency cleanup — HTML doc chromium binary rename
    The bcm_v85_docs.html "Dual display — Chromium kiosk" code
    block still hardcoded `chromium-browser --kiosk` which is the
    Ubuntu / older Debian binary name. On Debian Trixie (current
    Armbian) the package ships /usr/bin/chromium only; the
    bcm-kiosk.service unit already resolves at runtime via
    `command -v chromium || command -v chromium-browser`, but the
    docs snippet was misleading.
    - Update the two `chromium-browser` invocations to `chromium`.
    - Add a one-line Polish comment noting that bcm-kiosk.service
    autodetects either binary name.
    - Bump the main-display --window-size from 1024,600 to 1024,504
    to match the AA-canvas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
2026-04-15 Fix: OPi PC GPIO pin map + document H3 video decode limits
    Two real OPi PC hardware issues the user hit on first boot.
    Issue 1 — bogus GPIO line numbers
    ---------------------------------
    The bench_button / buzzer / backlight pins in bcm_config_opi_pc.yaml
    were sourced from a hand-typed mapping table that mixed PB*
    (not exposed on the OPi PC 40-pin header), PD* (parallel LCD
    bus — used for HDMI data), and some I²C/UART pins the Armbian
    Trixie kernel claims for system drivers. Symptom: every
    `bcm-ignition-watcher` restart looped with "Failed to request
    line" because libgpiod couldn't acquire line 37 (PB5 doesn't
    physically exist on this board).
    Rewrite the GPIO section entirely using o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
    [bcm_config.yaml, bcm_config_opi_pc.yaml, ignition_watcher.py]
2026-04-16 Drop Vosk voice recognition, add dual-pod SWC remote with configurable button mapping
    Remove the entire src/voice/ module (Vosk offline speech, TTS, wake word)
    and all related config, tests, dependencies, and documentation references.
    Voice control is replaced by a SWC button that ducks audio and taps the
    Android Auto mic icon via xdotool.
    Add full dual-pod SWC support for the AliExpress universal button kit:
    - 24 physical buttons (12 per pod) on Arduino ADC pins A0 + A6
    - Action-centric config (swc.mapping: action → [btn1, btn2])
    - Three new actions: bcm_power_toggle, voice_aa_trigger, navigate_aa
    - VoiceAAHandler: duck audio to 40%, tap AA mic, auto-unduck after 8s
    - Web Settings UI wit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
    [action_dispatch.py, bcm_config.yaml, bcm_config_opi_pc.yaml, bt_remote.py, rotary_encoder.ino, settings_screen.py, swc_remote.py]
2026-04-16 Add power lifecycle: 12h standby, SWC wake/sleep, deep idle (no poweroff)
    Ignition watcher now manages the full BCM lifecycle:
    - 12h standby window with configurable timer (power.standby_max_hours)
    - SWC MODE button (KEY_F10 via Arduino evdev) toggles BCM on/off
    - Deep idle instead of OS poweroff — OS stays alive on backup battery
    - After 12h, next wake replays splash (configurable duration) and
    resets the window
    - user_standby flag prevents auto-restart when SWC puts BCM to sleep
    while ignition is ON; either SWC press or ignition cycle wakes BCM
    - Frontend /api/boot_mode endpoint: cold boot skips init screen,
    warm wake shows 4s init animation
    - ShutdownHandler no longer calls sudo p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
    [bcm_config.yaml, bcm_config_opi_pc.yaml, ignition_watcher.py, shutdown.py, web_viewer.py]
2026-04-26 Rename rotary_encoder → arduino_hid (no encoder, resistor-ladder buttons only)
    The Arduino reads two resistor-ladder button pods (SWC + music panel)
    and sends USB HID keycodes — no physical rotary encoder in the design.
    Renamed RotaryEncoderListener → ArduinoHidListener, updated all imports.
    https://claude.ai/code/session_01YWGHpcvFSF9MVA5zQNsKZf
2026-04-26 Fix bcm_v85_docs.html: platform refs, orphaned BOM, encoder removal
    - Block diagram: OPi 5 Plus 8GB → OPi 5 Pro 4GB (RK3588S)
    - BOM ETAP 1: OPi 5 Plus 600-750 PLN → OPi 5 Pro 350-450 PLN
    - Remove 30-line orphaned duplicate BOM (category-based) after </section>
    - ETAP 2 summary: "głos" (voice) → "SWC" (voice module was removed)
    - Category BOM: "OPi 8GB" → "OPi 5 Pro 4GB", fixed prices
    - Disclaimer: "OPi 5 Plus 8GB zamiast 16GB" → "OPi 5 Pro 4GB"
    - S13 Input: note resistor-ladder buttons replace encoder
    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
2026-04-26 Update DEVELOPMENT_PLAN.md: v8.5, OPi 5 Pro, no rotary encoder
    - Title/context: BCM v7 → v8.5, OPi 5 Plus → OPi 5 Pro 4GB
    - File tree: rotary_encoder.py → arduino_hid.py, add spectrum.py
    - Theme names: Classic/Modern/OEM → Heritage/Modern/Autodelta
    - Settings: "rotary encoder long-press" → "AppBar settings icon"
    - Part 7 Input: rewrite for resistor-ladder buttons, no encoder
    - Arduino wiring: encoder pins removed, two analog ladder inputs
    - Config: BCM v7 → v8.5, version 0.1.0 → 8.5.1
    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
2026-04-26 Clean VMWARE_SETUP.md: remove Pygame, voice section, encoder refs
    - Remove legacy Pygame renderer section (5.3) and checklist
    - Remove "Pygame window doesn't open" troubleshooting
    - Remove pygame from apt install dependencies
    - Merge Voice (Part 7) into Input section — voice_aa is SWC action
    - Remove --pygame from module-specific launch example
    - Update input checklist: encoder → Arduino HID
    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
2026-04-26 Clean OPI5PLUS_INSTALL.md: add Pro redirect, remove voice/encoder/pygame
    - Header: add note that production moved to OPi 5 Pro 4GB
    - Remove pygame from apt dependencies
    - Input controller: "rotary encoder" → "resistor-ladder buttons"
    - Section 12: replace Voice Control with Microphone & SWC Remote
    - Remove Vosk wake word and voice command table (module deleted)
    - EQ presets: "voice command" → "Audio/EQ screen"
    - Checklist: "Voice responds" → "SWC voice triggers AA"
    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
2026-04-26 Clean OPI_PC_SETUP.md: encoder → arduino_hid, remove pygame refs
    - Package table: rotary_encoder.py → arduino_hid.py
    - Requirements warning: remove pygame-specific SDL2 details
    - Troubleshooting: generalize "Failed to build pygame" message
    - Import error note: generalize away from pygame-specific text
    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
2026-04-26 Rewrite README.md — fix typos, add all v8.5 features
    Old README had typos (wheater, care stereo, reciver) and was missing
    most features. Updated with complete feature list matching v8.5 state.
    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
2026-04-27 Fix ignition watcher crash when /dev/gpiochip0 is missing
    gpiod library can be installed but the GPIO chip device file may not
    exist (kernel module not loaded, DT overlay missing). Catch
    FileNotFoundError/PermissionError from gpiod.Chip() and fall back to
    simulation mode with a helpful diagnostic message.
    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
    [ignition_watcher.py]
2026-04-27 Fix systemd services: remove missing groups, set User=abner
    - bcm-headunit: strip gpio/i2c/spi/render from SupplementaryGroups
    (root already has full access; those groups don't exist on stock Armbian)
    - bcm-kiosk: User=bcm → User=abner (actual user on the OPi PC)
    - bcm-splash-main/small: remove "render" group (may not exist)
    Fixes "Failed to determine supplementary groups: No such process"
    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
2026-05-05 Add x86 platform support: expanded Arduino serial protocol + docs
    Expanded arduino_serial.py to parse all vehicle signals from Arduino:
    - DOOR (per-door open/close), HBRAKE, IGN, RAIN, TEMP, PARK
    - CRUISE, IMMO, AIRBAG status indicators
    - All published to event bus for dashboard display
    Added vehicle status to WebSocket broadcast (doors, handbrake,
    cruise, immo, airbag, rain).
    New doc: X86_PLATFORM_SETUP.md covering:
    - DC-ATX power supply options and wiring (PicoPSU, M4-ATX)
    - USB device layout (no PCIe GPIO needed)
    - Arduino #1 (input) and #2 (output) pinout and protocol
    - Full serial message reference table
    - Software setup, startup sequence, sleep modes
    https://claude.ai/code/session_0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
2026-05-05 Rewrite x86 docs, add suspend/wake, power button toggle
    docs/X86_PLATFORM_SETUP.md — complete rewrite:
    - Single HDMI only (USB-HDMI adapters don't work on Linux)
    - WiFi/BT dongle recommendations with driver install steps
    - Full boot optimization: GRUB silent, Plymouth, splash video
    - Step-by-step kiosk setup (autologin, .bash_profile, .xinitrc)
    - Suspend/wake via power button (acpid) and ignition (S3 sleep)
    - Disable unnecessary services for faster boot
    - Complete troubleshooting section
    New files:
    - config/systemd/bcm-resume.service — auto-start BCM after S3 wake
    - config/scripts/bcm-power-toggle.sh — acpid handler for power button
    ignition_watcher.py — add optional S3 suspend on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
2026-05-05 Add --autostart, 24h standby, DisplayLink docs, fix splash vs Plymouth
    ignition_watcher.py:
    - New --autostart flag: start BCM immediately on boot, no ignition needed
    - New config key autostart: true (default for x86)
    - Standby timer: 12h → 24h, after which next wake replays splash
    - Autostart sets ignition_on=True so standby toggle works correctly
    bcm_config.yaml:
    - standby_max_hours: 24
    - autostart: true, suspend_on_stop: true (x86 defaults)
    bcm-ignition-watcher.service:
    - Uses --autostart --config config/bcm_config.yaml
    bcm-splash-main.service:
    - mpv --vo fallback chain: drm,gpu,fbdev (x86 Intel compatibility)
    X86_PLATFORM_SETUP.md — major updates:
    - DisplayLink USB-HDMI setup with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
    [bcm_config.yaml, ignition_watcher.py]
2026-05-05 Splash service: add sdl fallback in mpv output chain
    DRM output works at boot (no X), but fails when tested under X.
    Add sdl to the fallback chain: drm → gpu → sdl → fbdev.
    Removed --drm-connector pin (auto-detect works on single-HDMI boards).
    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
2026-05-05 Fix UnboundLocalError: move suspend_on_stop before log/autostart block
    suspend_on_stop and suspend_delay were defined after the log line and
    autostart block that referenced them. Moved all variable definitions
    and function definitions (start_bcm, stop_bcm) before the autostart
    logic that calls them.
    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
    [ignition_watcher.py]
2026-05-05 Fix autostart: ignore simulated ignition-OFF on initial poll
    When autostart is active, the first poll reads ignition as OFF
    (no /tmp file), detects a falling edge, and immediately stops BCM.
    Added autostart_active flag that suppresses ignition-OFF state changes
    until a real signal (button press or actual ignition ON) clears it.
    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
    [ignition_watcher.py]
2026-05-05 Fix splash timing (5s overlap) and touch mapping for dual display
    Splash: increase post-Flask overlap from 2s to 5s so the video plays
    longer before Chromium takes over (prevents jarring early cut).
    xinitrc-x86-dual: auto-detect touchscreen device via xinput and map
    it to HDMI-1 only. Fixes touch offset caused by coordinate space
    spanning both monitors.
    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
2026-05-06 Rewrite x86 docs for Lenovo M910q: complete 13-section setup guide
    docs/X86_PLATFORM_SETUP.md — 912-line complete rewrite:
    - M910q as primary platform (i5-6400T, dual DP, Intel 8265 WiFi/BT)
    - AGM 12V 7.2Ah battery buffer with Schottky diode and LVD cutoff
    - 12V→20V DC-DC converter (not ATX) for M910q barrel jack
    - Full Android Auto compile: aasdk (OpenSSL 3.0 FIPS fix), h264bitstream
    (manual gcc+ar build), openauto (Qt5Qml fix) — all issues documented
    - Dual DP display: DP-1 main (7" or 10"), DP-2 small (4.3")
    - Auto-adaptive UI: 7" gets 1.1x scale, 10" native resolution
    - Intel 8265 WiFi AP mode on 5GHz (ch36) with USB dongle fallback
    - hostapd + dnsmasq config for persistent AP
    -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
    [bcm_config.yaml]
2026-05-06 Reorganize x86 docs: BCM before AA, WiFi ch149 fix, Debian 13 notes
    Major restructure — sections now in logical install order:
    1-4: Hardware/Power/OS/Packages
    5: BCM install + manual test (BEFORE any compile steps)
    6: Systemd services
    7: Boot optimization + splash
    8: Kiosk display
    9: Suspend/wake
    10: WiFi AP (Intel 8265 ch149, tested config)
    11: Android Auto compile (LAST, optional — needs working BCM first)
    12-14: Arduino/Checklist/Troubleshooting
    Key fixes:
    - WiFi hostapd: channel=149, added country_code=PL, wpa_pairwise=CCMP
    - AA compile: added RtAudioError→std::exception fix for Debian 13
    - Debian 13: python3-full package, PEP 668 note, t64 transition note
    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
2026-05-06 Fix icon text leak on small display when font not loaded
    Clip material-symbols-outlined to 1.2em width so raw icon names
    (e.g., "thermostat") don't display as visible text when the Google
    Fonts CDN hasn't loaded yet (first boot without internet, or
    slow DNS after S3 resume). Once the font loads, icons render
    normally within the clipped box.
    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
2026-05-06 Remove all CDN dependencies — serve fonts/libs locally
    Both HTML files (main + small display) now load fonts and vendor
    libs from local /assets/ paths instead of Google Fonts CDN,
    unpkg CDN, and cdn.tailwindcss.com:
    - Fonts: Public Sans + Material Symbols Outlined TTFs bundled in
    assets/fonts/ with local-fonts.css @font-face declarations
    - Vendor: Tailwind.js + Leaflet.js/CSS downloaded by user via
    config/scripts/download-vendor-assets.sh (run once with internet)
    small_viewer.py: added /assets/ route pointing to main web assets
    so both :5002 and :5003 serve the same fonts.
    No CDN = works fully offline in the car with no internet.
    https://claude.ai/code/session_01YWGHpcvFSF9MVA5zQNs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
2026-05-06 Bigger touch targets, remove scale factor, fix splash XDG_RUNTIME_DIR
    navbar.js: buttons w-10 h-10 → w-12 h-12 (40px → 48px), icons 22px → 26px
    appbar.js: icons 18px → 24px with p-1 padding for easier touch
    xinitrc: removed --force-device-scale-factor (wrong approach — scaling
    the whole UI caused layout issues). Touch targets are now bigger in CSS.
    bcm-splash-main.service: added Environment=XDG_RUNTIME_DIR=/run/user/0
    to fix ALSA "XDG_RUNTIME_DIR is invalid" error at boot.
    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
2026-05-06 Add cleanup script, fix WiFi DHCP, suspend, touch, simplify xinitrc
    New: config/scripts/cleanup-x86.sh — removes all BCM services, user
    configs, WiFi/hostapd, acpid overrides. Run before fresh reinstall.
    xinitrc-x86-dual: simplified — 3 user-configurable variables at top
    (MAIN_OUTPUT, SMALL_OUTPUT, TOUCH_DEVICE) instead of fragile auto-detect.
    Defaults to HDMI-2/HDMI-1 for M910q with DP-to-HDMI adapters.
    WiFi AP fix (docs §10.3):
    - nmcli device unmanage + NM persistent config to prevent reclaim
    - dnsmasq bind-interfaces (was binding all interfaces, blocking DHCP)
    - Static IP assigned before hostapd starts (phone couldn't get IP)
    Suspend fix (docs §9.3):
    - Added HandlePowerKey=ignore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
2026-05-07 Add all-in-one setup-x86.sh script
    Single script that replaces the manual 10-section walkthrough:
    cleanup → apt install → venv (with versioned python fallback) →
    vendor assets → systemd services → kiosk → acpid suspend →
    WiFi AP → GRUB → permissions → quick test.
    Handles the Debian 13 python3 -m venv issue by finding the
    versioned binary (python3.13) directly instead of relying on
    the python3 symlink. Falls back to virtualenv if venv still fails.
    Idempotent — safe to re-run. User config at top of script.
    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
2026-05-07 Generate placeholder splash videos, fix touch calibration
    Splash: setup-x86.sh now generates placeholder splash videos with
    ffmpeg if none exist (dark bg + "ALFA ROMEO 156" text, 8s main +
    5s small). User can replace with branded videos later. No more
    "copy your_main.mp4" manual step.
    Touch: replaced bare xinput map-to-output with proper Coordinate
    Transformation Matrix calculation. On dual displays, X sees the
    combined desktop as one coordinate space (e.g. 1824x600). The CTM
    maps the touchscreen's raw coordinates to only the main display's
    fraction of that space. This fixes the misalignment on cheap 7"
    USB touchscreens like QDtech MPI5001.
    xinitrc-x86-dual template updated to match.
    http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
2026-05-07 Fix splash, touch, and WiFi in setup-x86.sh
    Splash fix:
    - Install fonts-dejavu-core (drawtext needs fonts, Debian 13 has none)
    - Explicit fontfile= path with fallback to plain color video if no fonts
    - Log ffmpeg errors to /tmp/bcm-ffmpeg-*.log instead of /dev/null
    - Override bcm-splash-small DRM connector via systemd drop-in using
    user's $SMALL_OUTPUT (was hardcoded DP-2, wrong for DP-to-HDMI adapters)
    Touch fix:
    - Remove manual Coordinate Transformation Matrix — it conflicted with
    xinput map-to-output (which sets its own CTM internally). Using both
    caused garbage coordinates. Now uses only map-to-output.
    - Add diagnostic logging to /tmp/bcm-xinput.log for debugging
    WiFi fix (thre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
2026-05-07 Fix splash DRM connector + add iw package for WiFi
    Splash: mpv was playing on wrong display because no --drm-connector
    was specified. Added BCM_SPLASH_DRM_MAIN env var to the service
    (same pattern as small splash). Setup script creates drop-in
    overrides for both main and small pointing to user's actual outputs.
    Also added After=sound.target so ALSA cards are ready at splash time.
    WiFi: iw package was missing — iw reg set PL silently failed,
    leaving kernel in default world regulatory domain which blocks
    5GHz channel 149 with NO-IR. Added iw + wireless-tools to apt.
    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
2026-05-07 Drop splash audio, add AA deps, keyboard hide, enable BT
    Splash: changed --ao=alsa,pipewire,pulse to --no-audio. ALSA errors
    at early boot were blocking video from rendering. User sees nothing
    on either display — just Lenovo logo → GRUB → X logs. With --no-audio,
    mpv plays video immediately without waiting for sound cards.
    AA touch: added xdotool + xvfb + matchbox-window-manager to apt
    packages. Android Auto uses Xvfb virtual framebuffer (:99) for
    rendering and xdotool for touch forwarding from browser to AA window.
    Without these packages, AA displays but touch events don't reach it.
    Keyboard: added hide button (keyboard_hide icon) in top-right of
    on-screen keyboard. Also dismiss key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
2026-05-08 Fix splash timing, WiFi channel, BT auto-power
    Splash: X was stealing DRM framebuffer from mpv before splash could
    render. Root cause: autologin → startx runs at multi-user.target,
    same time as splash. Fix: .bash_profile now polls
    systemctl is-active bcm-splash-main and waits for it to finish
    before calling startx. Also removed After=sound.target which was
    delaying splash startup (unnecessary since we use --no-audio now).
    WiFi: changed default channel from 149 to 36. Channel 149 (5745 MHz,
    UNII-3) is blocked by Intel 8265 firmware with NO-IR flag even with
    PL regulatory domain set. Channel 36 (5180 MHz, UNII-1) is
    universally allowed for AP mode in ETSI regions.
    Bluetooth: adapter wasn't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
2026-05-08 Fix BT discoverability, WiFi channel fallback, splash sound.target
    Bluetooth: discoverable/pairable don't persist across reboots in
    BlueZ. Created bcm-bluetooth.service (oneshot, After=bluetooth) that
    runs bluetoothctl to set power on, discoverable on, pairable on,
    and alias "Alfa156 Headunit" at every boot. Phone can now find BCM.
    WiFi: added channel fallback — if hostapd fails on configured
    channel, automatically retries with channel 36 (5180 MHz, UNII-1)
    which is universally allowed. Also prints channel verification
    during setup so failures are visible.
    Splash: removed After=sound.target (was delaying splash startup,
    unnecessary since we use --no-audio). Already done in previous
    commi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
2026-05-08 Fix WiFi (2.4GHz), simulation mode, splash debug, suspend wake
    WiFi: Intel 8265 firmware blocks ALL 5GHz channels with NO-IR flag
    regardless of regulatory domain. Switched to 2.4GHz (hw_mode=g,
    channel 6) which works universally. Removed ieee80211ac (not
    applicable to 2.4GHz). Fallback to channel 1 if 6 fails.
    Simulation: added system.simulation config key. When false, demo
    data generators (fake OBD, fake BT media, fake GPS) are skipped
    even on x86 platform. Setup script patches bcm_config.yaml to set
    simulation: false. MockGPIO remains (x86 has no real GPIO) but all
    fake sensor/vehicle data is disabled.
    Splash: changed --vo=drm,gpu,sdl to --vo=drm only. The gpu/sdl
    fallbacks silently swal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
2026-05-08 Fix splash DRM timing, add LTE setup, fix ch1 fallback label
    Splash: DRM device (/dev/dri/card0) didn't exist when service started
    — i915 driver not loaded yet. Added wait loop (up to 10s, 200ms
    intervals) for /dev/dri/card0 before launching mpv. Without DRM
    device, mpv fails with "drmGetDevices failed" and exits immediately.
    LTE: added phase 10 for Huawei E3372 (CDC-Ether mode). Auto-detects
    ww* interface, creates systemd-networkd config with DHCP (metric 700
    so WiFi AP routes aren't overridden), brings up interface immediately.
    The E3372 in HiLink mode (12d1:1506) doesn't need usb_modeswitch.
    Also fixed channel fallback label (said "ch36" but actually fell
    back to channel 1).
    https://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
2026-05-08 Fix 5 issues from diagnostic data
    1. Splash: xrandr HDMI-1 != DRM HDMI-A-1. Added drm_name() translator
    in setup script: HDMI-N → HDMI-A-N for DRM connector drop-ins.
    mpv was finding DRM device but "No connector with name HDMI-1".
    2. Slow boot: systemd-networkd-wait-online blocked 2min waiting for
    LTE DHCP. Masked the service + set RequiredForOnline=no on LTE
    network config.
    3. Bluetooth: "No default controller available" — BCM started before
    bluetooth.service initialized the adapter. Added
    After=bluetooth.target bcm-bluetooth.service to ignition-watcher
    so BCM only starts after BT adapter is powered and discoverable.
    4. Suspend wake: usb 1-3 (LTE modem) "Failed t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
2026-05-08 Fix splash race, global BT pairing poll, aggressive suspend wake
    Splash: .bash_profile ran before splash service started, so
    systemctl is-active returned false → X started immediately.
    Added 5s wait-for-start loop before the wait-for-finish loop.
    BT pairing: popup only appeared if user clicked Scan first (poll
    started inside btScan()). Phone-initiated pairing requests were
    silently ignored. Added global 2s pairing poll in app.js init —
    now catches pairing requests on any screen without user action.
    Suspend: USB wake disable wasn't enough. Added ACPI wakeup disable
    for XHC/EHC/USB controllers in /proc/acpi/wakeup. These are the
    main source of spurious wake events from USB devices.
    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
2026-05-08 Fix BT retry + discoverable, small splash DRM, suspend LTE unbind
    BT not connecting: bluetoothctl show returned "No default controller"
    from service context because adapter wasn't ready. Added 5-attempt
    retry loop (2s between) in BluetoothManager._check_availability().
    Also fixed bcm-bluetooth.service: set discoverable-timeout 0 BEFORE
    discoverable on (was timing out after 120s), added agent registration.
    Small splash: was missing DRM wait loop and used --vo=drm,gpu,sdl
    (gpu/sdl render nowhere at boot). Now matches main splash: waits
    for /dev/dri/card0, uses --vo=drm only.
    Suspend: USB 1-3 (Huawei LTE 12d1:*) "Failed to suspend device"
    caused immediate wake. Now unbinds entire USB device b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
2026-05-10 Fix splash, WLAN AP, BT carkit class + A2DP profile
    Splash: drop --drm-atomic=auto from bcm-splash-play.sh (mpv 0.40
    removed the option, mpv refused to start the player; atomic is now
    the default).
    WLAN AP: switch from 5 GHz to 2.4 GHz ch6 country=US. Intel 8265
    firmware self-manages regulatory data and locks every 5 GHz channel
    as NO-IR for AP mode regardless of regdom (verified with iw phy
    under iw reg set US/PL). 5 GHz AP would need different hardware.
    Aligned defaults across bcm_config.yaml, wifi_ap.py, setup-x86.sh,
    and apply-fixes.sh.
    BT: install libspa-0.2-bluetooth + pipewire-audio so bluetoothd can
    register A2DP Sink / AVRCP / HFP-AG endpoints — without it, every
    phone connect f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
    [bcm_config.yaml, bcm_config_opi_pc.yaml, web_viewer.py]
2026-05-10 Fix BT pairing popup, WLAN NAT, splash clip switch
    The BCM venv was created without --system-site-packages, so dbus-python
    was not importable from the headunit service. The BlueZ pairing agent
    silently disabled itself ("dbus-python not available"), bluez fell back
    to no agent, and phone-initiated pairing completed via JustWorks with
    no PIN-confirmation popup ever shown. Add python3-dbus + python3-gi to
    apt and create the venv with --system-site-packages.
    bcm-nat.sh shells out to iptables, but iptables wasn't installed by
    default on Debian 13 — every NAT call failed silently while the unit
    reported success. Add iptables to the apt list. Also rework the uplink
    detection: previously we requi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
2026-05-11 AA Wireless on internal cards + PBAP + 7" GUI scale
    Part 1 — Force internal Intel BT (opt-in)
    - bluetooth.prefer_internal YAML flag flips _find_preferred_adapter
    bias so the integrated Intel 8087 is picked over a USB dongle when
    both are present.
    - BCM_BT_PREFER_INTERNAL=1 env in /etc/default/bcm-bluetooth mirrors
    the flag for the bluetoothd setup oneshot.
    - _hci_watchdog bounces the adapter on the documented 8087 tx-timeout
    via `hciconfig down/up`, recovering from BlueZ losing the controller.
    Part 2 — WiFi P2P-GO + multi-BSS fallback
    - New wifi.mode: hostapd | p2p_go | nmcli, dispatched explicitly.
    - wpa_supplicant P2P-GO path with correct 2.4 / 5 GHz channel→freq
    conversio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
    [bcm_config.yaml, bcm_config_opi_pc.yaml, web_viewer.py]
2026-05-12 Drop internal Intel BT + modern theme polish + scroll/touch fixes
    Hard-disable the integrated Intel 8087 BT (M910q) via udev
    authorized=0 + script-level USB unbind so BlueZ only sees the
    USB dongle — running both adapters simultaneously was making
    phones latch onto the wrong BD_ADDR. Soften modern theme
    (off-white cards #f6f8fb, visible slate-400 frames, 1.5px
    borders) so panels read as panels under cabin lighting. Enable
    vertical scroll on .content-area for over-tall pages (Settings)
    with a slim visible scrollbar. Make .bcm-navbar-hotzone
    pointer-events:none and swipe-only so the bottom 36px stops
    stealing taps from fixed-bottom buttons after the +15% bump.
    Drop the black rectangle behind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
2026-05-12 Fix UI hang storm, P2P-GO WiFi mode, splash exit status
    - settings.js: gate wifiLoad to 3s like radioRefresh — render() was
    re-firing it on every navigateTo, and wifiLoad itself navigateTo's
    on completion, producing >100 GET /api/wifi/config per second and
    starving Flask of touch POSTs.
    - web_viewer.py: enable Flask threaded=True so slow handlers don't
    serialise concurrent dashboard fetches.
    - wifi_ap.py: switch to WiFi Direct (P2P-GO) on ch6 as the AA Wireless
    primary mode. Stop the system wpa_supplicant.service before claiming
    the iface (D-Bus daemon survives the pkill-by-iface), and restart it
    in _stop_p2p_go.
    - bcm_config.yaml: wifi.mode = p2p_go (was hostapd).
    - bluetoot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
    [bcm_config.yaml, web_viewer.py]
2026-05-12 Trip A2 button placement, P2P-GO 2.4 GHz, PBAP/MAP SDP, phonebook wiring
    - Travel Plan / Trip Stats toggle now sits inline to the left of the
    fuel-consumption header on all three themes (Heritage, Modern,
    Autodelta) instead of an absolute top-right overlay.
    - OPi-PC profile switched to WiFi P2P-GO on 2.4 GHz ch6 / country BO
    so the Intel 8265 firmware doesn't reject the group with NO-IR like
    it does on UNII-3 ch149.
    - PBAP-PCE and MAP-MCE RegisterProfile calls now pass explicit
    ServiceRecord XML with BluetoothProfileDescriptorList — BlueZ's
    auto-generated record was missing attribute 0x0009, which is what
    Android keys on to flip the "share contacts/call history" pairing
    tog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
    [bcm_config_opi_pc.yaml]
2026-05-12 Add x86 production docs: CSS + index page (Phase 1a)
    New multi-page HTML documentation for deploying M910q in Alfa Romeo
    156 as production headunit. Dark theme CSS with amber accent (Alfa
    heritage), responsive sidebar navigation, and index page with:
    - Hardware summary (M910q + Fenvi FU-AX1800 + displays + Arduinos)
    - 5-stage build phases with cost estimates (~1600-2700 PLN total)
    - Platform comparison table (M910q vs OPi 5 Pro vs OPi PC)
    - Navigation to all 12 sub-pages
    BOM + assembly pages coming in next commit.
    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
2026-05-12 Add x86 production docs: BOM + assembly (Phase 1b)
    01-bom.html: 5-stage bill of materials adapted for M910q (~1600-2700
    PLN total). Key differences from OPi BOM: M910q used (~200-400 PLN),
    Fenvi FU-AX1800 for WiFi 6 + BT 5.2, XL6019 12V→20V boost converter,
    AGM battery buffer, DP-to-HDMI adapters, USB powered hub.
    02-assembly.html: Physical installation guide with ASCII wiring
    diagrams for power supply chain, USB hub layout, display cabling
    (DP→HDMI with xrandr/DRM naming), audio chain (DAC→TDA7388→speakers
    with Alfa 156 ISO colors), and Fenvi FU-AX1800 M.2 swap procedure.
    Phase 1 complete (4 files). Phase 2 next: OS install + software.
    https://claude.ai/code/session_01YWGHpcvFSF9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
2026-05-12 Add x86 production docs: OS install (Phase 2a)
    03-os-install.html: Debian 13 Trixie installation guide covering
    BIOS settings, partitioning, post-install sudo/firmware setup,
    system packages, Fenvi FU-AX1800 MT7921 driver setup (blacklist
    Intel iwlwifi), zram config, and VAAPI verification.
    04-software.html coming in next commit (agent still working).
    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
2026-05-12 Add x86 production docs: software setup (Phase 2b)
    04-software.html: BCM software installation guide covering
    setup-x86.sh (14 phases documented), user configuration variables,
    production bcm_config.yaml (simulation: false, real K-Line port),
    udev rules for stable USB device naming (K-Line, GPS, Arduinos),
    manual test procedure, and vendor assets for offline operation.
    Phase 2 complete (OS + software). Phase 3 next: vehicle data
    (K-Line/OBD, Arduino, sensors).
    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
2026-05-12 Add x86 production docs: K-Line OBD (Phase 3a)
    05-kline-obd.html: Complete K-Line adapter build guide and ECU
    communication docs. Covers CP2102 + L9637D wiring diagram, OBD-II
    connector pinout, 5-baud init sequence with timing constants from
    kline.py, KWP2000 session management, all 9 EDC15C7 PIDs (RPM,
    speed, coolant, fuel rate, boost, battery, intake temp, throttle,
    injector quantity) with decoding formulas from edc15c7.py.
    Arduino + sensors pages coming next (agent still working).
    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
2026-05-12 Add x86 production docs: Arduino firmware (Phase 3b partial)
    06-arduino.html: Arduino Pro Micro input controller (SWC, buttons,
    rotary encoder, light sensor) and Nano output controller (10-ch
    relay, 433MHz RF). Full pin tables, serial protocol reference,
    JSON command format. 07-sensors.html coming next.
    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
2026-05-12 Add x86 production docs: sensors (Phase 3c)
    07-sensors.html: Environmental sensor wiring and configuration.
    DS18B20 temperature (Arduino D14, 4.7k pull-up), HC-SR04 parking
    (4x ultrasonic, shared TRIG D15, ECHO D16/A2/A3/A7), rain sensor
    (PC817 optoisolator from 12V car signal), LDR light sensor (A1,
    6-level auto-brightness), and optoisolator circuits for all 12V
    car signals (ignition, doors, bonnet, trunk, blinkers).
    Phase 3 complete (K-Line + Arduino + sensors). Phase 4 next:
    WiFi/BT + display/touch.
    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
2026-05-12 Add x86 production docs: WiFi + Bluetooth (Phase 4a)
    08-wifi-bt.html: Fenvi FU-AX1800 (MT7921) setup covering M.2 swap,
    driver install, dual-SSID hostapd config (ALFA_AA 5GHz for Android
    Auto + ALFA_NET 2.4GHz for connectivity), dnsmasq dual-subnet DHCP,
    Bluetooth pairing flow (bcm-bluetooth.service + D-Bus agent + global
    poll), supported profiles (A2DP, HFP, AVRCP), troubleshooting.
    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
2026-05-12 Add x86 production docs: display + touch + splash (Phase 4b)
    09-display-touch.html: Dual display setup (DP→HDMI adapters, xrandr
    vs DRM naming), kiosk configuration (autologin, xinitrc, Chromium
    policy), touch calibration (xinput map-to-output, diagnostics log),
    boot splash (DRM wait loop, connector drop-ins, .bash_profile wait),
    and Chromium dual-instance kiosk mode.
    Phase 4 complete. Phase 5 (final): power/suspend, Android Auto,
    verification checklist.
    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
2026-05-12 Add x86 production docs: power + suspend (Phase 5a)
    10-power-suspend.html: Complete power system docs covering 12V→20V
    boost converter chain with AGM battery buffer (36h standby), BIOS
    power settings, S3 suspend config, power button flow (USB wake
    disable, LTE unbind, ACPI wake disable), resume flow (rebind USB,
    restart BCM), ignition watcher (Arduino IGN via PC817), and boot
    timeline (cold ~12s, S3 resume ~3-5s).
    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
2026-05-12 Add x86 production docs: Android Auto (Phase 5b partial)
    11-android-auto.html: OpenAuto compile guide (aasdk, h264bitstream,
    openauto with Debian 13 fixes), wired + wireless AA setup, Xvfb
    display architecture (virtual framebuffer → MJPEG stream → browser),
    touch forwarding via xdotool. 12-verification.html coming next.
    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
2026-05-12 Add x86 production docs: verification checklist (Phase 5c — FINAL)
    12-verification.html: Complete pre-flight checklist (30+ items across
    9 categories: core, ECU/OBD, sensors, input, connectivity, audio,
    Android Auto, power, boot), all-in-one diagnostic script, 18-item
    common issues table, log locations reference, and OTA update guide.
    All 12 HTML pages + CSS complete:
    index.html — Overview + cost summary
    01-bom.html — Bill of Materials (5 stages, ~1600-2700 PLN)
    02-assembly.html — Physical assembly + wiring diagrams
    03-os-install.html — Debian 13 + Fenvi drivers
    04-software.html — setup-x86.sh + production config
    05-kline-obd.html — K-Line adapter +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
2026-05-12 Implement fuel level reading from resistive tank sender
    The Alfa 156 1.9 JTD fuel sender is a resistive float (7-180Ω)
    wired to the original instrument cluster — NOT available via K-Line
    OBD. This adds end-to-end fuel level reading via Arduino ADC.
    Hardware circuit:
    5V ─[330Ω]─┬─ Fuel Sender ─ GND (car chassis)
    └─ Arduino A4
    Arduino firmware (rotary_encoder.ino):
    - Added FUEL_PIN A4, reads 8-sample average every 5 seconds
    - Reports as serial message: FUEL:XXX (0-1023 ADC range)
    Python parser (arduino_serial.py):
    - Added FUEL: message handler → publishes vehicle.fuel_raw
    Calibration module (src/vehicle/fuel_sender.py):
    - Converts raw ADC to fuel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
2026-05-24 Add Nano output-controller firmware and beginner setup guide
    The Nano output-controller sketch was previously documented as the
    expected serial protocol but never written. This adds the complete
    firmware plus a step-by-step Arduino setup guide for newcomers
    flashing both boards from scratch.
    - arduino/output_controller/output_controller.ino — full sketch:
    JSON command parsing (ArduinoJson v7), non-blocking pulse timers
    for lock/unlock/trunk/wipers/headlights, software-blinked turn
    signals, optional 433 MHz RF receiver (gated by ENABLE_RF), and
    hardware PWM on D9/D10 driving the 7" and 4.3" display M_PWM gates
    for backlight brightness on x86 where the M910q has no GPIO.
    - docs/A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
2026-05-28 Drop OEM-lock replacement, add window remote + BLE trunk, document SLA buffer
    Architectural refactor of the always-on subsystem:
    - Drop the central-lock replacement concept. The Alfa 156 OEM central
    lock + alarm stay in place. Remove lock/unlock/RF-keyfob-learn
    commands from the Nano sketch and from src/vehicle/central_lock.py.
    Keep the file name (CentralLockModule) for now to avoid cascading
    import changes; it has been retitled internally as the "Nano bridge"
    with a docstring explaining the scope reduction.
    - Add 4-window remote-control via a SECONDARY 433 MHz keyfob with
    hold-to-move semantics: the relay engages while the remote keeps
    emitting its code and releases ~250 ms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
    [central_lock.py, output_controller.ino]
2026-05-28 Add CC-CV charge controller between Schottky and SLA bank
    The Alfa 156 alternator pushes up to 120 A. With the SLA buffer
    depleted, the bare Schottky path would let the alternator dump tens of
    amps per pack into the bus the moment the engine starts. That's well
    past the 1 C charge ceiling for 5 Ah SLA cells (~5 A per pack) and
    would burn out the diode in a few cycles. Cycle life of the bank
    collapses to months instead of years.
    Inserting a CC-CV DC-DC buck (XL4016-class, 15-20 A bulk limit,
    14.4 V absorb / 13.8 V float) between the Schottky and the bank
    clamps bulk-charge current and runs a proper 3-stage SLA profile.
    ~30-50 PLN for the DIY module; a B2B charger (Redarc, Sterling,
    Victron O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
2026-05-28 MT7921 combo card: swap WiFi/BT defaults to MediaTek + drop Intel quirks
    Hardware swap from Intel 8265 (WiFi) + 8087 (BT) to MediaTek MT7921
    M.2 combo card (PCIe [14c3:7961] WiFi 6 + USB [0489:e0cd] BT 5.2).
    MT7921 supports 5GHz P2P-GO on ch149 at 80MHz VHT first try (verified
    live: wpa_cli p2p_group_add freq=5745 persistent), so the
    self-managed-regdom NO-IR workaround and the Intel 8087 tx-timeout
    unbind/watchdog plumbing are no longer needed.
    Code changes:
    - setup-x86.sh / apply-fixes.sh: firmware-iwlwifi -> firmware-mediatek;
    hostapd default switched to ch149 5GHz with ieee80211ac + VHT80;
    drop /etc/udev/rules.d/81-bcm-disable-intel-bt.rules and the
    BCM_BT_KEEP_INTERNAL / PREFER_I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
    [bcm_config.yaml, bcm_config_opi_pc.yaml]
2026-05-29 AA Wireless: fix openauto.ini WiFi MAC key name
    The phone-side AA bootstrap (BluetoothNetworkInfoMessage MAC field)
    was empty even though BCM resolved the WLAN MAC and wrote it into
    openauto.ini at startup — autoapp uses the ini key `AdapterMAC=`,
    not `MAC=`. autoapp silently dropped BCM's unknown `MAC=` line,
    kept its internal empty default, and re-persisted the file with
    `AdapterMAC=` empty.
    Symptom on the phone: SocketInfoRequest succeeds, NetworkInfoMessage
    arrives with SSID/PSKEY populated but `MAC:` blank, phone replies
    with `08 fd ff ff ff ff ff ff ff ff 01` (rejection / mac=ff*6) and
    tears down the BT RFCOMM socket. No Wi-Fi association attempt.
    Fix: write `AdapterMAC={wifi_mac}`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
2026-05-29 BT/phone fixes: auto-connect on boot+wake, working dialer, live media controls
    Verified end-to-end on the M910q bare-metal unit (MT7921 + S24).
    Bluetooth auto-connect (boot & wake):
    - BluetoothManager retries the paired+trusted set in rounds (~25s) instead
    of one pass, and re-runs on the power.modules_start wake event — the unit
    re-links the phone without the user tapping Connect.
    - main.conf gains [Policy] ReconnectAttempts/ReconnectIntervals so bluetoothd
    re-establishes profiles to a trusted device on its own (setup-x86 + apply-fixes).
    Dialer (contacts + call history) — was fully broken; four root causes:
    - Schema mismatch: vCard parser emitted numbers[]/direction/timestamp but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
    [bcm_config.yaml, web_viewer.py]
2026-07-04 Add repository audit report and remediation plan (PL)
    Full audit of code vs documentation: repo hygiene (.venv committed),
    broken modules_v85 feature-toggle block, stability gaps (no crash
    recovery, sync EventBus, WS broadcast lock), startup/frontend
    performance, Arduino firmware/software contract mismatches, red test
    suite, and a 8-stage remediation plan awaiting approval.
    Claude-Session: https://claude.ai/code/session_01RvLiJHDdN18iwsLfgXjDdY
2026-07-04 gitignore: exclude .venv, zip archives and runtime data dir
    .venv (289 MB, 3241 files) and a 22 MB design zip were removed from
    the entire git history with git-filter-repo; pack size dropped
    173 MB -> 57 MB.
    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
2026-07-04 Move dead code to legacy/ with explicit LEGACY markers
    traffic.py (HERE placeholder), remote_status.py (port 5004, never
    started), map_renderer.py (replaced by Leaflet), aa_display.py
    (abandoned port 5001) and the three dead Pygame theme screens are
    moved to legacy/ mirroring their original paths. Each file carries a
    LEGACY banner; legacy/README.md explains why each one landed there.
    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
    [map_renderer.py, remote_status.py, test_multimedia.py, traffic.py]
2026-07-04 Wire GPS route logger as 'tracking' module; lazy-load all modules
    tracker.py: fix NameError (bus.subscribe on unbound name), add trip
    end detection (parked below trip_end_kmh for trip_end_idle_sec),
    per-trip stats (haversine distance, avg/max speed), crash-recovery
    for trips left open, trip list API, config-driven paths/thresholds,
    thread-safe DB access. Registered in MODULE_REGISTRY as 'tracking'
    (modules.tracking in both YAML configs).
    main.py: every module entry point now imports lazily via _lazy() —
    importing main.py dropped from 2.29 s to 0.05 s and disabled modules
    cost nothing at boot. New bluetooth.enabled toggle skips the BT probe
    (and PBAP phonebook sync) on hardware without an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
    [bcm_config.yaml, bcm_config_opi_pc.yaml, tracker.py]
2026-07-04 Arduino: sensor-hub firmware, watchdogs, non-blocking BLE, build tooling
    New arduino/sensor_hub/sensor_hub.ino (Nano #2): transmits the
    DOOR/HBRAKE/IGN/RAIN/TEMP/PARK (+optional CRUISE/IMMO/AIRBAG)
    telemetry that arduino_serial.py has always parsed but no firmware
    ever sent. Every input group is a #define FEATURE_* compile switch;
    debounced inputs, async DS18B20, rotating single-sensor HC-SR04 scan.
    Protocol verified line-by-line against ArduinoSerialListener.
    rotary_encoder.ino: 2 s watchdog (armed after calibration); encoder
    push moved D4 -> D1 (D4 and A6 are the same physical pin on the Pro
    Micro, so the old wiring conflicted with SWC Pod 2); drop stock
    Keyboard.h include (macro vs enum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
2026-07-04 Frontend: precompiled Tailwind CSS, deferred scripts, idle-skip broadcast
    - Replace the 419 KB Tailwind runtime JIT engine (recompiled CSS in
    the browser on every kiosk page load) with a 37 KB static minified
    stylesheet generated by config/scripts/build-frontend.sh and
    committed to the repo. Verified pixel-identical rendering on the
    init, A1 main, trip and settings screens (Playwright/Chromium).
    - All 20 <script> tags now use defer — parsed in parallel, executed
    in document order, no render blocking before first paint.
    - web_viewer broadcast loop skips the ~60 event-bus reads + JSON
    serialization when no WebSocket client is connected.
    - MJPEG ffmpeg teardown gets a kill() fallb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
    [web_viewer.py]
2026-07-04 Unified module toggle system + Settings->Modules screen (Etap 1)
    - New src/core/modules_catalog.py: single source of truth for all 27
    switchable modules/subsystems; main.py registry and the new
    /api/modules endpoint both derive from it.
    - is_module_enabled falls back to the legacy modules_v85 block (which
    no code ever read — alarm/crash_detect/battery/lighting/performance/
    rain_sensor/central_lock were silently dead) with the
    battery_backup->battery alias; both YAMLs now list every module
    under modules: and modules_v85 is gone.
    - Every subsystem started explicitly in main.py (bluetooth, phonebook,
    fuel_sender, wifi_ap, route_planner, small_display, dashboard) is
    now toggled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
    [alarm.py, battery.py, bcm_config.yaml, bcm_config_opi_pc.yaml, config.py, lighting.py]
2026-07-04 Stability: crash self-recovery, async event dispatch, WS/dashcam hardening (Etap 2)
    - ignition_watcher: liveness watchdog — every 5 s while BCM should be
    running, restart the unit if it died (max 3 restarts / 10 min). The
    loop was purely edge-triggered before: a mid-drive crash left a dead
    screen until the driver cycled the key.
    - bcm-headunit(.x86).service: Restart=on-failure + RestartSec/limits
    as a second recovery layer; clean watcher stops don't trigger it.
    - EventBus: optional async_dispatch (used by main.py) — subscriber
    callbacks run on a dedicated dispatcher thread with a bounded
    drop-oldest queue, so a blocking subscriber can no longer stall the
    publishing sensor l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
    [event_bus.py, ignition_watcher.py, web_viewer.py]
2026-07-04 Implement real DTC read/clear over KWP2000 (Etap 4a)
    The Service screen's DTC buttons were a facade: /api/dtc/read
    published an event no one subscribed to and always returned an empty
    list; /api/dtc/clear was a no-op.
    - kwp2000.py: readDiagnosticTroubleCodesByStatus (0x18) and
    clearDiagnosticInformation (0x14) with response parsing.
    - edc15c7.py: dtc_to_code() P/C/B/U decoder, description map of ~20
    common EDC15C7 faults, DTC request servicing inside the reader's
    polling thread (single-threaded serial access); clear confirmed by
    automatic re-read.
    - simulator.py: SID 0x18/0x14 with two realistic stored faults
    (P0380, P0235) + inject_dtc() so the x86 demo exercises the path.
    - web_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
2026-07-04 Real 10-band EQ via PipeWire filter-chain (Etap 4b)
    apply_eq_preset/set_custom_gains/set_bass_treble only published
    events — no DSP node was ever created, so the EQ sliders did not
    change the sound.
    - Generate a filter-chain config (lowshelf + 8x peaking + highshelf
    biquads at the standard 31 Hz-16 kHz centers) and host it in a
    'pipewire -c' child process exposing an Audio/Sink 'bcm_eq_sink';
    preset/bass/treble changes regenerate + restart it (rare, ~0.5 s).
    - Once the sink appears it is made the default sink (wpctl), so all
    audio flows source -> bcm_eq_sink(EQ) -> hardware sink.
    - Bass/treble fold into bands 0-2/7-9 of the active preset.
    - audio.eq_dsp_enabled toggle (default tru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
2026-07-04 Green test suite, ruff-clean lint, CI pipeline, PL setup guide (Etapy 6-7)
    Tests (419 passed, 0 failed, ~14 s):
    - test_input.py rewritten to the current swc_remote API (the old
    imports crashed collection); stale expectations updated across
    test_camera/test_core/test_dashboard/test_integration (current
    themes, v8.5, CameraController API, legacy service path).
    - conftest.py neutralizes the BluetoothManager hardware probe that
    hung the suite indefinitely; pytest-timeout (60 s) guards the rest.
    - New tests: arduino_serial line parser (20), GPS tracker trip
    lifecycle (14), central_lock Nano JSON protocol (21).
    Lint: ruff configured (pyproject.toml, correctness-focused) and the
    tree is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
    [arduino_hid.py, arduino_serial.py, battery.py, bt_remote.py, config.py]
2026-07-05 Add K-Line sniffing / ECU PID reverse-engineering guide + sniffer tool
    docs/KLINE_SNIFFING.md: step-by-step guide to sniff the K-Line bus
    while MES/Multiecuscan polls the ECU, identify which
    readDataByLocalIdentifier code maps to each signal (RPM, coolant temp,
    boost, ...), derive scale/offset by the two-point method, and wire the
    PIDs into src/obd/edc15c7.py. Clarifies the production hardware path
    (CP2102 USB-UART + L9637D transceiver — not Arduino, not FTDI) vs the
    VIAKEN KKL cable used for reverse-engineering.
    tools/kline_sniffer.py: standalone --passive decoder (read-only bus
    tap), --scan active readLocalId sweep (reuses src.obd), and --replay
    single-frame test. KWP2000 frame parser v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
2026-07-05 K-Line real hardware on x86 (production) + split WiFi AA-wireless / hotspot
    K-Line: x86 is now a production target, so start_obd honours
    obd.use_real_hardware (default false = simulator for dev). When true
    it opens serial.kline.port_x86 (CP2102/VIAKEN KKL), does 5-baud init
    (or fast_init if configured), and degrades cleanly if the port is
    absent instead of crashing BCM. New keys: obd.use_real_hardware,
    obd.fast_init, serial.kline.port_x86 (+ udev symlink documented).
    WiFi split into two independent modules:
    - modules.wifi_ap = Android Auto wireless only (Wi-Fi Direct/P2P-GO
    on the internal card) — stays on.
    - modules.wifi_hotspot = the extra ALFA-NET internet-sharing AP, which
    needs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
    [bcm_config.yaml, bcm_config_opi_pc.yaml, modules_catalog.py, simulator.py]
2026-07-11 Sync bare-metal deployment state: displays 1280px, splash autodetect+wake overlay, BT/dialer hardening
    Transplants the verified working state of the M910q bare-metal head unit
    onto the history-rewritten main (zip + .venv blobs stay purged).
    Displays:
    - 10.1" main panel 1280x800 + 6.86" second panel 1280x480 (config,
    kiosk window size, small-display CSS/HTML sizing)
    - small-display-watch.sh: hotplug-aware watcher brings the second-panel
    Chromium window up/down on HDMI plug/unplug (replaces boot-time-only
    launch in the .xinitrc)
    Splash:
    - bcm-splash-play.sh: auto-detect connected DRM connector (panel is
    HDMI-A-2; was pinned to dead HDMI-A-1) and play on all connectors via
    one gst t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
    [bcm_config.yaml, ignition_watcher.py, small_viewer.py, test_multimedia.py, web_viewer.py]
2026-07-25 Archive non-M910q platform material, consolidate docs on M910q
    The production platform is the Lenovo ThinkCentre M910q Tiny, but the
    repo still carried three other hardware targets side by side with it,
    and the README still called the project an Orange Pi 5 Pro build.
    Move retired-platform material to Archive/ (git mv, history preserved):
    - Archive/orange-pi-5/ — OPi 5 Pro / 5 Plus setup guides, BOM,
    requirements-opi.txt, and the whole v7 schematic set (every diagram in
    it wires vehicle I/O to the OPi 40-pin GPIO header, which the M910q
    does not have — that I/O now goes through Arduino over USB).
    - Archive/orange-pi-pc/ — bench-rig guides, requirements, launcher,
    bcm_config_o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
2026-07-25 Add M910q deployment guide and buffered-power documentation
    Two consolidated Polish documents plus three new schematics, all grounded
    in what the repo actually contains.
    docs/WDROZENIE_M910Q.md — end-to-end deployment: hardware and BOM, BIOS,
    Debian 13 install, BCM install, systemd lifecycle, boot/splash/kiosk,
    S3 suspend, displays and touch, the three Arduino boards, K-Line, WiFi,
    audio, module switches, an acceptance checklist and a troubleshooting
    table.
    docs/ZASILANIE_BUFOROWANE.md — the power system in detail, plus a
    shopping list split into "already owned" and "still needed".
    Three findings that change what someone should build, each documented
    with the reasoning rather than jus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
2026-07-25 Add consolidation report
    docs/PODSUMOWANIE_KONSOLIDACJI.md records what moved to Archive/ and
    why, the three findings that change the power design (AGM setpoints on
    a gel bank, buck topology that cannot reach absorb voltage, standby
    figure quoting full discharge), the step-up verification result, the
    dead battery-monitor path, and what was deliberately left undone.
    Linked from the deployment guide's related-documents table.
    Claude-Session: https://claude.ai/code/session_017cXmt2HyZ8iv3aQHpkNA4c
2026-07-25 Spec the buffer bank to CSB HR1221W and correct the AGM/gel call
    The bank is CSB HR1221W F2, which is VRLA AGM (high-rate UPS series), not
    gel. The previous commit assumed gel and lowered the charge setpoints on
    that basis; that reasoning does not apply here, so the setpoints go back
    up to the CSB datasheet values.
    Corrected:
    - Absorb 14.20 -> 14.40 V, float 13.70 -> 13.65 V. The repo's original
    14.4 / 13.8 V sat inside the CSB ranges (14.4-15.0 V cycle,
    13.5-13.8 V float) and was right all along.
    - Temperature compensation is not one coefficient: CSB specifies
    -18 mV/degC float and -30 mV/degC cycle. The table now carries both,
    with the cold end clamped to the 15.0 V datasheet ceil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
2026-07-25 Add terminal-level wiring diagrams and connection tables
    The existing schematics are block diagrams — they show what connects to
    what, not which screw a given wire lands on. Three wiring drawings plus
    a connection-table document close that gap.
    schematics/wiring_power_modules.svg — every power module drawn with its
    terminals on the box edge and numbered: VSR (BAT1/BAT2/GND), charger
    (IN±/OUT±), overvoltage relay (VCC/GND/COM/NC), the five HR1221W packs,
    LVD (BAT±/LOAD±), fuse block, ignition relay by ISO 280 numbering
    (30/87/86/85), step-up and both bucks. Wire gauges on every run, ground
    symbols at each module, and the connect-in-this-order box.
    schematics/wiring_vehicle_arduino.s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
2026-07-25 Add in-car layout drawing
    The wiring drawings say what connects to what; none of them says where any
    of it physically goes. schematics/vehicle_layout_m910q.svg is a top-down
    plan of the 156 with 22 numbered positions, the three cable runs that
    matter, and the reasoning behind each placement.
    The placements are not arbitrary:
    - The battery bank goes under the passenger seat rather than in the boot.
    HR1221W is rated 3-5 years float at 25 degC and roughly halves per +10
    degC; a boot at 45-55 degC in summer turns that into 1.5-3 years against
    2-4 in the cabin. Since temperature and not cycling is what limits this
    bank, mounting location matters more than discharge discipline.
    - Amplifi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
2026-07-26 Design the power section around the XL6019 and XH-M609 already on hand
    Both modules are bought, so the design is now fitted to them rather than
    to generic parts. Each imposes a real constraint that changes what has to
    be built.
    XL6019 as the 12 -> 19.5 V step-up. The IC limits switch current to 5 A,
    and in a boost the switch current is essentially the input current, so
    after ripple headroom the module delivers roughly 4.5 A in — about 45 W
    out at 12 V, not the 65 W of the M910q's rated supply. Normal operation
    (20-30 W dashboard, 30-40 W with VAAPI decode) fits comfortably; only a
    full four-thread CPU load at 50-55 W does not. The fix is a RAPL package
    cap at 28 W installed as bcm-power-c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
2026-07-26 Replace the DIY TDA amplifier chain with an off-the-shelf car amplifier
    The audio output stage is no longer built from TDA7388 + TDA2050 boards.
    It is a bought 4-channel car amplifier with RCA inputs, wired like a head
    unit: straight off the starter battery, its own fuse at the terminal, its
    own local ground, switched by a REM signal.
    The separation this buys is the point, so the docs now state it plainly:
    the only things linking the amplifier to the buffered system are the REM
    wire and the RCA shield. No power current and no power ground touches the
    bank, the LVD or the distribution block.
    Three wiring values change as a result:
    - Branch fuse goes from a fixed 20 A to whatever the amplif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
    [bcm_config.yaml]
2026-07-26 Make the docs match the code, and add a bench/dev build
    Audited the repo against what the code actually does rather than against
    the original design, and fixed the docs where they disagreed. Five things
    had drifted.
    Displays. config/bcm_config.yaml and the tests have been on a 10.1"
    1280x800 main panel and a 6.86" 1280x480 widescreen second panel for a
    while; the docs and schematics still described 7" 1024x600 + 4.3" 800x480.
    Updated everywhere, with the note that bcm_config.yaml is the source of
    truth. Also documented that the second panel is optional and hot-pluggable
    — small-display-watch.sh raises and drops its window on connector change,
    which was in the code but in no document.
    Aud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
    [bcm_config_bench.yaml]
2026-07-26 Turn the test build into a rolling in-car install with wireless AA
    Two premises of the test/dev variant were wrong.
    The unit goes into the car and gets driven, so the charging chain is
    back. The old §3.1 argued the whole thing was unnecessary because a
    bench has no alternator — true then, irrelevant now. Restored: VSR,
    CC-CV boost, overvoltage cutoff, ignition relay, input TVS + cap.
    Charging is variant B (VSR + boost, ~180 PLN) rather than a B2B
    charger, with CV at 13.8 V and no absorb phase — that drops the
    temperature sensor and lets the layer-2 threshold sit at 14.80 V
    instead of 15.30 V, at the cost of charging to ~90% instead of 100%.
    Two numbers that were missing and matter: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
    [backlight.py, bcm_config_test.yaml, test_power.py]
2026-07-26 Name concrete CC-CV and VSR models, and fix the CV setpoint
    The test build called for a plain boost module with CV at 13.8 V. That
    does not work, and picking real modules is what surfaced it.
    A boost only has control authority while it is switching, i.e. while
    Vout > Vin. With the engine running the module input sits at 13.4-14.2 V
    depending on the wiring drop, so a 13.8 V setpoint parks it in
    pass-through: current flows through the inductor and diode, and the CC
    loop has nothing to act on. A bank at 12.0 V behind ~50 mOhm then pulls
    over 30 A. This is the same behaviour §3.2a already documents for the
    XL6019 on the output side — it applies just as well to the charger.
    So CV goes to 14.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
2026-07-26 Power the test-build panel from USB, drop the 12 V display branch
    The displays run off USB; only PWM dimming needs its own supply, and the
    first test build does not have dimming. So the panel hangs on the M910q
    and domain B collapses to a single branch.
    Three things follow, and two of them are not cosmetic:
    The fuse gets bigger, not smaller. Everything now goes through the
    XL6019, so its input current is the whole load: 45 W out at 85% is 4.2 A
    at 12.6 V, and 4.6 A once the bank sags toward the LVD threshold. A 5 A
    fuse would sit on the edge and blow for reasons unrelated to any fault.
    7.5 A on the 12 V side of the branch.
    The XL6019 margin shrinks. M910q 25-35 W plus panel and touch 3-5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
    [output_controller.ino]
2026-07-26 Drop the VSR, power the BCM permanently, sleep it from the Arduino
    Three changes, one of which costs real parking time and is worth reading
    before building.
    VSR is gone from every document and schematic. Charging is now split by a
    30 A relay off the ignition plus an MBR2545CT Schottky. The relay breaks
    the path so the boost cannot drain the starter battery with the engine
    off; the diode is the second barrier if the contacts weld. It also drops
    the boost input by ~0.5 V, which widens the margin over the 14.40 V CV
    setpoint rather than narrowing it.
    One consequence of triggering the coil from the ignition rather than the
    alternator D+: with the key on and the engine not running, the charger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
2026-07-26 Add proper electrical and wiring schematics for the test build
    The test build had one block diagram. That is enough to understand the
    topology and not enough to build from, so it now has three drawings that
    each answer a different question.
    schematic_test_build.svg — the circuit, drawn with symbols rather than
    boxes: battery, fuses, TVS and cap, relay with its coil, the MBR2545CT as
    two parallel diodes, boost, cutoff, the bank as five fused cells, LVD,
    main switch, XL6019 and LM2596. Off-page connector A joins the charging
    row to the load row so no wire has to cross the sheet.
    ignition_sense.svg — the input circuit with actual component values,
    because "Arduino detects ignition" is not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
2026-07-26 Make permanent power + S3 the target architecture, driven by the power button
    Two changes that go together.
    The power button turns out to be the right actuator, and it is simpler
    than what was documented. On a PC it is a momentary NO switch, and Linux
    already gives it the exact semantics needed: short press while running
    suspends, short press in S3 wakes, short press when off boots, hold over
    4 s forces off. One primitive covers every direction.
    That collapses the software gap. The host side already exists — acpid
    binds button/power to bcm-power-toggle.sh and logind.conf has
    HandlePowerKey=ignore. Nothing needs writing there. Wake no longer
    depends on Wake on USB either, so that BIOS row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
2026-07-26 Implement the ignition-driven power control on the Nano
    The ignition input already existed. sensor_hub reads 12V ACC through a
    PC817 on D9, debounces it and reports IGN:. What was missing was the
    other half — actually doing something with it — so that is what this
    adds, on the board that already has the signal.
    FEATURE_PWRBTN drives a 1-channel relay on A0 whose contacts sit in
    parallel with the M910q's power button. 250 ms is a short press and 5 s
    is a hold, which is all the vocabulary needed: short toggles
    running/S3/off-to-on, hold forces off. Nothing new on the host — acpid
    already binds button/power to bcm-power-toggle.sh.
    FEATURE_PWRLED closes the loop on A1 by watching the fro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
    [arduino_serial.py, sensor_hub.ino, test_arduino_serial.py]
2026-07-27 Name a real overvoltage cutoff module and fix where it draws power from
    The question was what to actually buy, and the honest first answer is that
    the current there is smaller than it looks. The cutoff sits between the
    boost and the bank, so it carries only the charging current, capped by the
    boost's CC setting at 8 A. It is not in the load path — that is the
    XH-M609, which passes the computer's ~4.6 A through a 20 A relay and has
    plenty of margin. Two different devices, two different jobs.
    XH-M603 (or XH-M604) is the right part: same family as the XH-M609 already
    on the bench, same buttons and display, 0.1 V steps, separate upper and
    lower thresholds. Its logic is already the one needed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
2026-07-27 Resize the bank to four packs and add a from-scratch Arduino guide
    Three changes, all driven by what the install actually looks like now.
    **Bank is four packs, not five.** The limit is physical — there is
    nowhere else to hide them — so the sizing section says that instead of
    presenting five as the optimum. Everything downstream follows: 20,4 Ah
    (10,2 Ah to 50 % DoD), catalogue charge ceiling 8,4 A, CC set to 7,5 A,
    ~2,9 h engine-off, ~2,6 h to recharge, 7,2 kg, pack fuses F2…F5. The
    comparison tables keep their 5/6/8 rows as reference, now labelled as
    what the space constraint costs rather than as open options.
    **S3 draw corrected from measurement.** The panel draws nothing in
    sleep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
2026-07-28 Draw the test build component by component, on two sheets
    The existing test-build drawings group parts into blocks — "TVS + C1" as
    one box, a relay as one box. That is fine for orientation and useless at
    the bench, where you need to know which leg goes where.
    **New: `schematics/schematic_test_power.svg` (sheet 1/2).** Every part
    drawn on its own. D5 (TVS) and C1 are two separate symbols with their own
    connections to the star ground rather than one block. K1 and K2 are each
    drawn twice — coil in the control row, contact in the power path — which
    is how relays are actually drawn and which removes the wire that used to
    have to loop around the box. D1 is two Schottky diodes with their ano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
2026-07-28 Move crowded labels off the drawing and point at them with leaders
    Four places where a label sat close enough to a wire or symbol to read as
    part of it:
    - **"zwiera po zapłonie"** sat directly under C1's value, so it read as
    C1's caption when it describes the K1 contact. Moved above the contact,
    where there is nothing else.
    - **D1's pin labels.** The dashed outline is 24 px taller now so "pin 1"
    and "pin 3" have clearance from the diode bodies, and "pin 2 — katoda"
    — which had nothing near it to attach to — gets a leader with an
    arrowhead landing on the cathode node.
    - **C6.** Its value ran through the OUT− return wire. Label moved clear
    below and to the left, leader up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
    [gen_test_schematics.py]
2026-07-28 Say which way every diode goes, including the one that has no way
    The TVS was specified as "1.5KE33CA" everywhere and nowhere said what
    the CA means. It is a **bidirectional** part — no anode, no cathode,
    solder it either way, and whatever stripe the manufacturer prints on it
    is meaningless. That is not obvious from a part number, and the drawing
    showed it as two back-to-back zeners without saying why.
    The reason it matters: **1.5KE33A**, one letter away, is a different
    diode — unidirectional — and there the stripe must face the positive
    rail. Fitted backwards it is forward-biased, i.e. a ~1 V short across
    the supply, and F1 goes the moment power is applied.
    Added, in three places: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
    [gen_test_schematics.py]
2026-07-28 Say which pad "A6" actually is on a Pro Micro
    Every pin table said SWC Pod 2 goes to "Pro Micro A6" — but no Pro Micro
    has a pad with that name on it. On the ATmega32U4 the ADC channels A6–A11
    are multiplexed onto digital pins and only A0–A3 get an analog label
    silkscreened, so someone looking at the board finds A0…A3 and stops.
    A6 is the pad marked `4` (PD4 / ADC8). Added a mapping table where the
    pin assignments live:
    | in code | pad | AVR |
    |---------|-----|-----|
    | A6 | `4` | PD4 / ADC8 |
    | A7 | `6` | PD7 / ADC10 |
    | A8 | `8` | PB4 / ADC11 |
    | A9 | `9` | PB5 / ADC12 |
    | A10 | `10` | PB6 / ADC13 |
    The sketch keeps `#define SWC_PIN2 A6` — the name only tells
    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
2026-07-28 Make the SWC pods, the headphone jack and Android Auto actually work
    Four reports from the test drive, three of them real defects in this repo and
    one that was never installed in the first place.
    ## The Pro Micro was reading its own crosstalk
    The tell was in the log the user sent: both pods reported the **same button**
    at the **same ADC value**, alternating. Three independent causes:
    - `pinMode(SWC_PIN1, INPUT)` — the comment said "no pull-up needed", but idle
    here is defined as `adc > SWC_IDLE_THRESHOLD` (~VCC), so something has to
    hold the line up. Now `INPUT_PULLUP`.
    - **`readSWCButton()` never discarded the first conversion after switching ADC
    channel.** The ATmega32U4 has one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
2026-07-29 Quick-start test build: AA "Unknown sources" fix, single-pod SWC, dual audio, bigger 7" UI, PL keyboard
    Minimal in-car build for a 7" 1024x600 panel: only wireless Android Auto,
    steering-wheel pods, weather, route planning and audio. New
    config/bcm_config_temp.yaml drives it (systemd unit switched to it).
    Android Auto: the "connects+auths but won't project, drops every ~2-3s"
    symptom (aasdk error 33 = TCP_TRANSFER / asio EOF) was PHONE-SIDE — Android
    Auto Developer settings -> "Unknown sources" was off; openDsh is uncertified
    so modern AA refuses to project without it. Exhaustively ruled out the head
    unit (identical to a solid 94-min session on 07-11). Kept the head-unit
    fixes that genuin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
    [bcm_config_temp.yaml, bt_remote.py, input_bridge.py, rotary_encoder.ino, web_viewer.py]
2026-07-29 Send all audio to the USB card, and make the wheel's track buttons work
    Audio out was dead on both outputs at once, for two unrelated reasons.
    The combine-sink drop-in matched output devices by hardcoded node.name
    ("...Lenovo_USB_Soundbar..."), so plugging in a different USB card left
    bcm_combine with a single member — the board's minijack. Android Auto's
    streams were flowing the whole time, into an output nobody was listening
    to. And that minijack was itself muted: the ALSA-level unmute pass ran
    amixer without -c, so it always aimed at card 0, which is the USB adapter
    once one is plugged in. The ALC294's Headphone control (shipped muted at
    0%) was never touched. Both outputs silent, log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
2026-08-17 Projekt PCB zasilania buforowanego: dwie płytki do wytrawienia + dobór przetwornicy 19,5 V
    Dwie jednostronne płytki THT zamiast pająka, do trawienia w domu:
    - płytka A (100x75): tor ładowania — TVS, C1, przekaźnik T90 (K1),
    MBR2545CT, zaciski dla ładowarki CC-CV i XH-M603 w torze
    - płytka B (100x60): dystrybucja szyny za S1 — bezpieczniki ATO
    F8-F11 i dzielnik pomiaru napięcia banku (§13.4)
    Generator schematics/gen_pcb_power.py rysuje schemat ideowy,
    montażówkę 1:1 i mozaikę miedzi 1:1; sam sprawdza spójność sieci
    i prześwity. Footprinty wg datasheetu Songle SLA i bibliotek KiCad
    (T90: okrągłe otwory Φ2/Φ1,2 — bez slotów; ATO: Φ2,0 co 9,2 mm).
    Zmiany proj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
2026-08-31 Zaprojektuj oba ekrany małego wyświetlacza ESP32
    Panel ST7735 160×128 dostaje dwa ekrany. Pierwszy trzyma tytuł i wykonawcę
    pośrodku, a kontrolki rozkłada nad i pod nimi: usterki (ABS, poduszka,
    immobilizer) u góry, stany kierowcy (hamulec ręczny, tempomat) na dole —
    slot tempomatu rozwija się o zadaną prędkość, kiedy ta przyjdzie z ECU
    przez BCM. Drugi rysuje Alfę 156 Berlina od góry i zasłania pierwszy na
    stałe, dopóki cokolwiek jest otwarte.
    Ekran drzwi ma dwa warianty do wyboru: bryła z listą nazw paneli obok,
    albo baner alarmowy nad bryłą obróconą przez całą szerokość ekranu.
    Rysunki są w prawdziwych pikselach wyświetlacza i w palecie motywu
    Heritage,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
2026-08-31 Obróć wyświetlacz do pionu i podrasuj kontrolki
    Panel stoi pionowo, więc ekran 1 przebudowany na węższy format 128x160:
    tytuł łamie się teraz do dwóch linii, bo w 112 px jedna to za mało,
    a slot tempomatu zwężony tak, żeby "km/h" nie dotykało krawędzi.
    Ekran drzwi traci nagłówek i listę nazw — zostaje sama bryła wpisana
    w cały ekran. Wariant z listą po prawej zniknął razem z nimi. Skrzydła
    drzwi i uniesione pokrywy rysują się teraz na wierzchu obrysu nadwozia,
    inaczej przy sześciu otwartych panelach sylwetka ginęła w czerwieni.
    Kontrolki przerysowane: ABS i hamulec dostały wspólne klamry z dwóch
    łuków, więc czytają się jako jedna rodzina hamulcowa, t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
2026-08-31 Wypal sprite'y na panel wprost z renderów
    Rendery mają poświatę i miękką kreskę, których TFT_eSPI nie narysuje
    prymitywami — więc nie rysujemy ich, tylko wypalamy w bitmapy.
    Sztuczka jest w tym, że screen (9).png zawiera obie warstwy naraz:
    bursztynowe nadwozie i czerwone otwarte panele. Rozdzielone po barwie,
    a czerwień rozbita na sześć brył po położeniu, dają bryłę bazową plus
    sześć niezależnych paneli — spasowanych z definicji, bo pochodzą
    z jednego rysunku i idą przez tę samą transformację. Stąd wszystkie
    64 kombinacje otwarć bez ani jednego dodatkowego obrazka.
    Mieszać różnych renderów nie wolno i jest to sprawdzone: screen (9)
    ma nadwozie 425x106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
2026-08-31 Zapisz USB jako drogę dla muzyki i tempomatu
    S3 ma natywny USB-OTG, więc wpina się wprost w M910q jako CDC-ACM, bez
    mostka. Protokół to ten sam kształt linii KLUCZ:wartość, którym mówi już
    sensor_hub — tylko w drugą stronę, bo tu pisze BCM.
    Trzeci port szeregowy w aucie znaczy jednak, że reguła udev przestaje być
    opcją: numeracja ttyACM przeskakuje między restartami, a dwa Arduino już
    tam siedzą.
    Do tego rozstrzygnięcie, skąd brać zasilanie. Kabel USB kusi, ale ekran
    wstawałby wtedy razem z komputerem, a kontrolki mają sygnały na GPIO od
    przekręcenia kluczyka — lampka ABS zapalona pół minuty po starcie jest
    gorsza niż jej brak.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
2026-09-05 Rozbuduj bank do siedmiu pakietów i napraw to, co audyt po drodze wyciągnął
    Bank rośnie z 4 do 7 pakietów CSB HR1221W: 35,7 Ah, 12,6 kg, sufit ładowania
    14,7 A. Przeliczone są wszystkie tabele, które z tego wynikają — autonomia,
    czasy ładowania, rezystancje, prądy zwarciowe, bezpieczniki i przekroje.
    Audyt sekcji zasilania znalazł jednak dwie rzeczy starsze niż ta zmiana.
    Tabela §9.2 podpisana "bank 4 pakiety — 20,4 Ah" była policzona dla 25,5 Ah,
    czyli dla piątki: każda z dwunastu komórek zawyżona równo o 25 %. A prąd
    ładowania miał w repo PIĘĆ różnych wartości — 7,5 / 6,0 / 8 / 9 A i "do 6 A"
    — rozsianych po dokumentach i schematach. Jedno i drugie nap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
2026-09-05 Postaw ładowanie na izolowanej ładowarce i opisz montaż w bagażniku
    Bank ma być jedynym źródłem dla szyny buforowanej, a przy ładowarce
    nieizolowanej tak nie jest — masa wejścia i wyjścia to ten sam potencjał,
    więc prąd ładowania i tętnienia alternatora wracają tym samym przewodem,
    którym płynie prąd odbiorników. Transformator w ładowarce przerywa tę
    drogę: po stronie wyjścia zostaje obwód, w którym jedynym źródłem jest
    bank, a zakłócenia muszą przejść przez jego chemię.
    Wybór padł na klasę tanich modułów izolowanych (VEVOR 12/12-20 i klony
    w obudowie IP55), nie na markowy sprzęt — z zastrzeżeniem, że specyfikacje
    pochodzą z opisów sklepowyc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
2026-10-26 dodanie restarterów
    Co zostało wdrożone:
    Przycisk w Ustawieniach (settings.js):
    W sekcji SYSTEM I KIOSK obok przycisku Restart kiosku dodano przycisk Restart komputera (czerwony z ikoną power_settings_new).
    Dedykowany przycisk w ekranie Audio (audio.js):
    Na dole ekranu Audio / Korektora (EQ) obok przycisku powrotu umieszczono przycisk Restart komputera. Dzięki temu, gdy karta dźwiękowa nie zostanie zainicjalizowana przez system, możesz natychmiast wykonać pełny restart bez szukania opcji w innych zakładkach.
    Okno potwierdzenia i ekran ładowania (app.js):
    App.rebootSystemModal() wyświetla modal ostrzegawczy zapobiegający przypadkowemu kliknięciu podczas jazdy.
    Po potwierd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
2026-10-26 Project AA at the resolution it claims, and let autoapp restart after a crash
    Three faults, found while chasing "AA connects but the screen does nothing".
    The dropout itself was not ours — it was the phone's Android Auto "Unknown
    sources" gate, which an app update or a "reset Android Auto" silently clears.
    Bracketing that took proving the head unit had not changed: no checkout or pull
    between the last good session and the first dead one (git reflog), and no file
    touched under /opt/bcm or /etc in the window (find -newermt). Both breaks came
    back empty on both checks. Worth doing that before editing anything next time.
    ## The resolution codes were off by one
    The authoritative enum is in aa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
2026-11-08 Trzymaj config bazowy w gicie, a zmiany z auta w local.yaml
    Usługa startuje z bcm_config_test.yaml (BCM_CONFIG w /etc/bcm/bcm.env), którego
    BCM nigdy nie zapisuje. Zmiany z UI i BT trafiają do config/local.yaml jako
    różnica względem bazy (atomowo, 0600, z .bak i kwarantanną uszkodzonych), a
    sekrety z env/bcm.env nigdy nie lądują w pliku. Śledzone YAML-e bez klucza OWM
    i adresu telefonu; src/core/fsutil.py do atomowych zapisów (cache, książka,
    openauto.ini 0600), rotacja logu (przy błędzie zapisu jedno ostrzeżenie zamiast
    potoku tracebacków), /api/config waliduje i zapisuje, Wi-Fi zgłasza brak zapisu.
    Odstępstwa od planu: local.yaml pamięta bazę (# base:) i przy innej baz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
2026-11-08 Bierz internet z telefonu przez Bluetooth PAN
    Nowy moduł phone_tether (domyślnie wyłączony, włączony w configu testowym)
    zakłada w NetworkManagerze profil panu dla telefonu i podnosi go po
    bt.connected z odczekaniem settle_sec i backoffem; po zestawieniu łącza
    uruchamia bcm-timesync. Nieudane `connection up` ponawiamy najwyżej co
    max_retry_connected_sec (120 s) z podpowiedzią „sprawdź Tethering przez
    Bluetooth”; Ustawienia odświeżają wiersz na żywo i mają przycisk „Ponów”.
    Pogoda: backoff zamiast prób co 5 s i wymuszone pobranie po podniesieniu PAN.
    AA AP nigdy nie wychodzi przez bnep*, ALFA-NET może (share_phone_internet).
    PBAP czeka phonebook_settle_sec; terminy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
2026-11-08 Bierz pozycję GPS z telefonu i udostępnij trasy jako GPX
    GPS przyjmuje NMEA z telefonu po UDP (port 10110, tylko dozwolone źródła) i TCP przez PAN,
    obok portu szeregowego; publikuje wyłącznie ważne fixy, a zegara z NMEA nie ustawia.
    Do parsera trafiają tylko GGA/RMC/VTG, więc dziesiątki zdań GSV nie zjadają limitu
    (token bucket 50/s, osobno 500 linii/s jako ochrona CPU); kurs znika po utracie fixa.
    Tracker: WAL, trasy urwane odcięciem prądu domykane ze statystykami, koniec trasy po 300 s
    bez fixa, GPX 1.1; w dashboardzie /trips, /api/tracking/trips i pobieranie GPX.
    Polityka dashboard.remote_access (w kodzie full = produkcja bez zmian, test: tracking):
    readonly jako lista dozw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
2026-11-08 Pokaż baterię, zasięg i operatora telefonu w pasku
    Nowy src/multimedia/phone_status.py czyta co 20 s (i od razu po
    bt.connected) stan telefonu z oFono (Handsfree.BatteryChargeLevel,
    NetworkRegistration.Strength/Name/Status; modem wybierany po MAC) przez
    prywatne połączenie D-Bus, z BlueZ Battery1 jako zapasem dla baterii, i
    publikuje bt.phone_status tylko przy zmianie. Dane z telefonu są
    sprawdzane i przycinane, a web_viewer czyści je ponownie.
    appbar.js rysuje za datą zasięg, operatora (tylko textContent) i baterię;
    zapis do DOM wyłącznie przy zmianie (kolor słabej baterii przez data-low).
    Przy okazji tekst z telefonu (kontakty, AVRCP, nazwy BT, powiadomienia)
    nie trafia już d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
2026-11-12 WIP: przygotuj pomiar banku BATT: w sensor_hub i module battery
    Etap 6 planu, wersja robocza (zapisana, żeby nie zginęła przy restarcie
    kontenera). Patch BATT: do sensor_hub (FEATURE_BATT_ADC / FEATURE_BATT_INA226,
    domyślnie wyłączone), cel make sensor_hub-variants + CI, parser
    BATT:<mV>[,<mA>] w arduino_serial.py z konfigurowalnym portem i ponownym
    łączeniem, BatteryMonitor dla 12 V AGM z histerezą, szablon reguły udev.
    modules.battery zostaje wyłączone we wszystkich configach.
    Jeszcze do zrobienia (kolejny commit): poprawki z review — reset backoffu
    dopiero po dłuższej sesji, ponowne sprawdzanie wykluczonych portów, BATT
    w woltach tylko z kropką, logowanie %r, port GPS z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
2026-11-12 Pobieraj pogodę od pierwszej pozycji GPS i nie dzwoń na 112 z sieci
    A: pierwszy fix GPS po pobraniu dla domyślnego miasta wymusza od razu nowe
    pobranie (także gdy fix wpadnie w trakcie późniejszego pobrania, np. po
    starcie PAN), plus ponowne po 15 km; jedna spójna migawka lokalizacji.
    Planer pokazuje start „domyślny (brak GPS)” i liczy plan ponownie po fixie;
    /api/data ma gps_state, a Ustawienia wiersz „GPS” z podpowiedzią dla NMEA.
    0f: z sieci /api/phone/dial przyjmuje tylko zwykły numer (kody */# typu
    *31*#112 dzwoniły na 112), bez numerów alarmowych, z limitem 1 na 5 s.
    Wybieranie, odbieranie i rozłączanie idą po kolei w wątku bt-call, więc
    „Rozłącz” w trakc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
2026-11-12 Dopasuj klawiaturę ekranową do wysokości ekranu
    Po 2e3baaf (6. rząd, root font 17 px) panel 50vh miał 300 px przy ~386 px
    treści i ostatni rząd (shift, z…m, backspace, SPACJA, OK) wypadał pod ekran.
    Teraz oskLayout() liczy w px wysokość (58%, ≥150 px nad klawiaturą), padding,
    odstępy i font z innerHeight; themes.css czyta je jako --osk-*, rzędy to
    flex 1 1 0, przeliczane przy resize. _ensureVisible przewija pole nad
    klawiaturę, a padding treści wynika z --osk-h.
    Odstępstwo od planu: „tap poza klawiaturą” decyduje na pointerdown, ale
    zamyka na click tego samego tapnięcia (inaczej treść skacze pod palcem);
    gdy click nie przychodzi (touchend.preventDefault w planerze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
2026-11-12 Popraw BATT po review i napraw sterowanie zasilaniem w sensor_hub
    - arduino_serial: backoff zerowany dopiero po sesji >=60 s, wykluczenia
    portów przy każdym otwarciu, BATT: w woltach tylko z kropką, logi jako
    ucięty repr; "lost" i "connected" ograniczone do 1 na 5 min.
    - battery.py: obliczenie i publikacja w jednej sekcji krytycznej.
    - sensor_hub: logika przycisku w power_logic.h z testami g++ (przepełnienie
    millis(), LONG tylko na stabilne S3, ponowne uzbrojenie po wybudzeniu z OFF).
    - Naciskamy tylko na stan, który się utrzymał; dekoder diody z histerezą.
    Przez 90 s po SHORT nie ma drugiego naciśnięcia, a gdy zapłon wróci w tym
    czasie i host jednak zaśnie, dostaje S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
2026-11-12 Daj każdemu dodatkowi własny przełącznik z zależnościami w Ustawieniach
    Każda funkcja z planu C–I ma w modules_catalog własny przełącznik
    modules.<nazwa> (wyłączony w kodzie i w obu YAML-ach) z zależnościami,
    notatką o sprzęcie i grupą. main.py nie startuje modułu bez działających
    zależności i loguje jedno ostrzeżenie (przy łańcuchu z przyczyną źródłową).
    Ustawienia → Moduły pytają przed włączeniem bez zależności i przed
    wyłączeniem modułu potrzebnego innym; karta odświeża się w miejscu, więc
    pytanie i status są pod klikniętym wierszem (Chromium 1024x600).
    „Wymaga restartu” liczone względem tego, co main.py faktycznie uruchomił.
    Też: ws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
2026-11-12 Podłącz telefon w aucie przez USB: internet, GPS, bateria i czas przez adb
    Nowy moduł car_phone (modules.car_phone, domyślnie wyłączony): tethering
    USB przez nmcli (metryka 650, PAN 750 jako zapas), forward GPS przez adb,
    bateria z alarmem temperatury, czas z telefonu i stan hotspotu (tylko odczyt).
    Serwer adb na gnieździe w /run/bcm-adb (0700) zamiast :5037; zegar telefonu
    odrzucany blisko daty ROM-u, cofnięcie o ponad 1 h dopiero po potwierdzeniu.
    autoapp domyślnie bez USB (BCM_AA_USB=0). GPS: priorytet źródeł, tcp.host
    auto przełącza się na forward w trakcie sesji i wraca na PAN, gdy forward
    milczy. Niesprawdzone na stole: svc usb na ROM-ie Redmi, ADB_SERVER_SOCKET
    z adb De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
2026-11-13 Czytaj czujniki telefonu w aucie i wykrywaj stłuczkę z akcelerometru
    Nowy moduł phone_sensors czyta akcelerometr, żyroskop i światło z SensorServer
    przez uprzywilejowany forward adb z car_phone (951) i publikuje phone.g_force
    oraz phone.light_lux; wszystkie ramki są walidowane, okna ograniczone liczbą
    próbek, a opóźnione próbki (lag_ms) i obcięte sekundy (overrun) oznaczane.
    Kalibracja grawitacji: referencja ze zgodnych bloków postoju, po restarcie
    liczy się kierunek długoterminowy, przełożenie o ponad 20 st. wykryte od razu.
    Nowe src/safety/crash_detect.py: zdarzenie z akcelerometru (25 km/h, 15 km/h
    w 150 ms, 4 g x3), odrzuca dziury tylko bez nasycenia, upadek telefonu ta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
2026-11-13 Dodaj agenta w telefonie w aucie z podpisanymi żądaniami i parowaniem
    Agent Termux (tools/car_phone/termux/bcm_agent.py) pilnuje terminu SMS-a po
    stłuczce, treści GSM-7 i limitów nawet wtedy, gdy BCM padnie. Żądania i
    odpowiedzi są podpisane HMAC, nonce rośnie także po restarcie. Klient w BCM
    (modules.car_phone_agent, domyślnie wyłączony) sprawdza stan co 30 s,
    wysyła konfigurację i daje API kolejnym modułom przez get_agent().
    Parowanie wymaga jednorazowego kodu z telefonu (--pair), bo z agentem może
    połączyć się każdy lokalny proces. Po potwierdzonym parowaniu „agent nie zna
    sekretu” daje ostrzeżenie i „Sparuj mimo to”. Odwołanie jest ostateczne,
    także w tra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
2026-11-13 Wysyłaj SMS po stłuczce przez telefon w aucie, z odliczaniem i anulowaniem
    Nowy moduł crash_sms (wyłączony w kodzie i w obu konfiguracjach): po stłuczce
    z akcelerometru uzbraja agenta w telefonie, który sam pilnuje terminu; okno
    wypadku na każdym ekranie (ANULUJ, Wyślij teraz, pisk, tryb testowy z powodem).
    Prawdziwe SMS-y tylko przy zdrowym agencie i teście potwierdzonym dla obecnych
    odbiorców (agent kasuje potwierdzenie przy zmianie listy lub slotu SIM).
    Po review: klient odróżnia "dropped" (żądanie doszło, brak odpowiedzi) od
    "connect", więc anulowanie trafia do telefonu; przycisk SWC działa tylko w
    trakcie odliczania, a "Jestem OK" ma osobną trasę /api/crash/follow_up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
